Aiano/DigitalPowerSupply/README.md

# 便携数控开关电源 Digital Power Supply

## 特点

- 支持PD诱骗
- 支持输出升降压
- 触屏GUI界面

## 文件结构

### 显示部分测试

- `/Hardware/Display`：PCB工程
- `/Firmware/Display`：STM32代码
