Aiano/DigitalPowerSupply/Firmware/DigitalBuckBoost/README.md

# DigitalBuckBoost代码文档

## 文件结构

- MDK-ARM：Keil项目文件
- Drivers：HAL库和CMSIS驱动
- Core：STM32CubeMX生成的底层代码
- Application：业务逻辑代码
- BSP：板级支持包
