Aiano/DigitalPowerSupply/Document/便携数控可调开关电源-开发记录.md

# 便携数控可调开关电源-开发记录

## 电源

> [低压非隔离DCDC开关稳压器设计 - Part 1 原理图设计 - Emoe-Studio](https://www.emoe.xyz/non-isolated-dc-dc-power-regulator-schematic-design/)

### 参数指标

| 项目 | 指标 |
| --- | --- |
| 输入参数 | 12~24V(DC), 5A, 100W(Max) |
| 输出参数 | 12~24V(DC), 5A, 100W(Max) |
| 负载调整率 | ≤0.05% |
| 电源调整率 | ≤0.05% |
| 纹波和噪声 | ≤2mVrms, 10mVpp |
| 满载效率 | ≥97% |
| 开关频率 | 200kHz~1MHz |
| 工作温度 | 0~100℃ |
| 输入接口 | USB Type-C |
| 支持协议 | PD3.0 |
| 输入保护 | 反接保护、欠压保护 |
| 输出保护 | 过压保护、过流保护、过功率保护、过温保护、倒灌保护 |

### 开关电源拓扑选择

> [电源拓扑选择 | TI.com.cn](https://www.ti.com.cn/zh-cn/video/series/power-topology-selection.html)

基本分类：

- 非隔离/隔离 (Non Isolated/Isolated)：输入和输出是否共地
- 正激/反激 (Forward/Flyback)：能量传输到输出时开关状态

其中，非隔离SMPS有：

- 降压：Buck
- 升压：Boost
- 升降压：
    - BuckBoost
    - 4SW BuckBoost
    - SEPIC (Single-Ended Primary-Inductor Converter)
    - Zeta
- 负压：
    - Inverting BuckBoost
    - Cuk

考虑到DC/DC无需使用隔离拓扑，需要升降压，输出功率较大，故选择四开关BuckBoost拓扑，考虑到四开关BuckBoost可以做双向，故选之。

### 系统框图

系统框图

### 器件选型

#### MCU

STM32G474RET6

- 大量模拟外设
- 高主频
- HRTIM

#### N-MOSFET

对于Buck Boost拓扑，分别计算其工作于**Buck模式**和**Boost模式**所需的参数，然后取最大值。

> 对于所有拓扑，当输出电压和负载电流（即输出功率）不变时，如果输入电压减小，平均输入电流必然增加，所以，**所有拓扑的开关管有效值电流，在$V_{INMIN}$（即$D_{MAX}$）处最大**
>
> 下式对于**所有拓扑**成立
> $$
> I_{RMS\_SW}=I_{L\_DMAX}\times\sqrt{D_{MAX}\times(1+\frac{{r_{DMAX}}^2}{12})}
> $$

##### Buck模式

这里限制占空比最大为0.95（为了给上管栅驱的自举电容充电）
$$
D_{MAX}=\frac{V_O}{V_{IN}}=0.95\\
t_{ON\_DMAX}=\frac{D_{MAX}}{f}=\frac{0.95}{200\times 10^3}=4.75\mu s
$$
取输入电压达到最大值24V，即最恶劣输入电压
$$
\begin{align}
V_{ON\_DMAX}&=V_{IN}-V_{O}\\
&=(1-D_{MAX})\times V_{IN\_MAX}\\
&=0.05\times 24=1.2V
\end{align}
$$
电流纹波率需要重新计算
$$
r_{DMAX}=\frac{Et_{DMAX}}{L\times I_O}=\frac{4.75\times 1.2}{22\times 5}=0.052\\
I_{RMS\_SW}=I_{L\_DMAX}\times\sqrt{D_{MAX}\times(1+\frac{{r_{DMAX}}^2}{12})}=5\times\sqrt{0.95\times(1+\frac{{0.052}^2}{12})}=4.87A
$$
最高开关电压
$$
V_{SWMAX}=V_{INMAX}=24V
$$

##### Boost模式

$$
\frac{V_O}{V_{IN}}=\frac{1}{1-D}
$$

当$V_O=24V$、$V_{IN}=12V$时，占空比最大
$$
DMAX=\frac{V_O-V_{IN}}{V_O}=\frac{24-12}{24}=0.5\\
I_{L\_DMAX}=\frac{I_O}{1-D_{MAX}}=\frac{5}{1-0.5}=10A
$$
电流纹波率为设定值
$$
r_{DMAX}=0.4\\
I_{RMS\_SW}=I_{L\_DMAX}\times\sqrt{D_{MAX}\times(1+\frac{{r_{DMAX}}^2}{12})}=10\times\sqrt{0.5\times(1+\frac{{0.4}^2}{12})}=7.12A
$$
最高开关电压
$$
V_{SWMAX}=V_O=24V
$$

##### 最终参数

故开关管最大有效值电流$I_{RMS\_SW}=7.12A$，额定电流应大于两倍有效值电流，$I>14.24A$

最高开关电压$V_{SWMAX}=24V$，需要降额20%，则额定电压$V>24\times(1+0.2)=28.8V$

##### 备选型号

- ==CJAC110SN10A==
- ==CJAC130SN04L==
- NCEP3065QU

#### 功率电感

对于Buck Boost拓扑，分别计算其工作于**Buck模式**和**Boost模式**所需的参数，然后取最大值。

> **最恶劣工况**定义为峰值电流达到最大值时所对应的工况

##### Buck模式

Buck模式的最恶劣工况是输入电压最大，输出电压最小，此时占空比最小。

$$
\frac{V_{O}}{V_{IN}}=D=\frac{12}{24}=0.5\\
I_{DC}=I_O=5\text{A}
$$

设置电流纹波率 $r=0.4$
$$
I_{PK}=I_{DC}(1+\frac{r}{2})=5\times(1+\frac{0.4}{2})=6\text{A}\\
L=\frac{V_{ON}\times D}{r\times I_L\times f}=\frac{(24-12)\times 0.5}{0.4\times 5\times 200\times 10^3}=15\mu\text{H}
$$

##### Boost模式

Boost模式的最恶劣工况是输入电压最小，输出电压最大，此时占空比最大。
$$
\frac{V_{O}}{V_{IN}}=\frac{1}{1-D}\\
D=\frac{V_{O}-V_{IN}}{V_{O}}=\frac{24-12}{24}=0.5\\
I_{DC}=\frac{I_O}{1-D}=\frac{5}{1-0.5}=10\text{A}
$$
设置电流纹波率 $r=0.4$

$$
I_{PK}=I_{DC}(1+\frac{r}{2})=10\times(1+\frac{0.4}{2})=12\text{A}\\
L=\frac{V_{ON}\times D}{r\times I_L\times f}=\frac{12\times 0.5}{0.4\times 10\times 200\times 10^3}=7.5\mu\text{H}
$$

##### 最终参数

峰值电流最大值$I_{PK}=12\text{A}$，饱和电流$I_{SAT}\ge12\text{A}$

电感值最大值$L=15\mu\text{H}$，需要考虑$\pm10\%$容限，最终电感值$L\ge15\times(1+0.1)=16.5\mu\text{H}$

> [SER2918H-223 | High current flat wire | Coilcraft](https://www.coilcraft.com/zh-cn/products/power/shielded-inductors/high-current-flat-wire/ser/ser29xx/ser2918h-223/)

SER2918H-223

- Inductance: 22uH
- DCR: 2.60 mOhm
- SRF: 15MHz
- Isat(10% drop): 12A
- Irms(20℃ rise): 20A

#### 输入输出电容

##### Buck模式

取占空比最小的情况，$V_{IN}=24V$，$V_{O}=12V$
$$
C_{MIN}=\frac{V_O\times(1-D)}{8\times L\times\Delta V_O\times f^2}=\frac{12\times(1-0.5)}{8\times 22\mu\times 10m\times (200k)^2}=85\mu F
$$

##### Boost模式

取占空比最大的情况，$V_{IN}=12V$，$V_{O}=24V$
$$
C_{MIN}=\frac{I_O\times(1-\frac{V_{IN}}{V_O})}{\Delta V_O\times f}=\frac{5\times(1-\frac{12}{24})}{10m\times 200k}=1250\mu F
$$

##### 最终参数

电容大于1250uF

额定电压$V>V_O\times(1+50\%)=36V$

选取一颗50V，2200uF高频电解电容电容，搭配10uF和100nF MLCC电容

#### 精密电流采样电阻

1mΩ 3W 2512

#### 电压电流放大器

##### 电流检测放大器

INA190A4	200V/V

##### 电压差分放大器

> [运放的差分放大电路_运放差分放大电路-CSDN博客](https://blog.csdn.net/IT18150131975/article/details/86534431)



若满足$R_1=R_3$、$R_2=R_4$，则
$$
V_O=\frac{R_2}{R_1}(V_+-V_-)
$$
采用通用运放和高精度电阻搭建电压差分放大器

- ==TLV9001==
- LM321
- TLV9301
- OPA171

##### 直流偏置

高精度电阻分压加电压跟随器

- TLV9001

#### 栅极驱动器

低压半桥栅极驱动器主要关注

- 工作电压：限制了最大输入输出电压
- 拉&灌电流：这个值越大，栅极电阻$R_g$就可以减小，MOSFET开关速度提高，$\frac{1}{2}V_{DS}I_D$损耗下降，故越大越好

##### 备选型号

- ==UCC27211A==
- SLM27211
- IRS21867
- SLM21867

### 外围阻容&连线

### 热管理

### 环路稳定性

### 额外滤波器

### 问题

#### V1.0

1. 电流采样电阻的GND端没有隔开网络，导致差分线回到INA190A4时，过孔取了就近的GND电压，差分变单端，电流采样不准。

2. 电解电容容值可能太大，需要后续做仿真测试，验证环路稳定性问题。

3. 每一个测试环都需要在近处放一个配对的GND测试环，减小耦合噪声的影响。

4. 负载电流增大到8~10A时，输入输出电压差分采样运放输出引脚，会在采样时刻产生较大纹波，需要在单端后加RC滤波，奇怪的是，啥时候采样啥时候产生这个纹波，负载电流越大，这个纹波越大

   Vin_sense0

   后续关闭ADC电流采样通道，这个波形消失，只剩下一个小尖峰，并且不会随着负载电流变化，可以通过串联RC滤波消除。推测之前的问题是由于ADC不同通道间的串扰导致的，可以在通道间插入直通到GND的通道解决。

   Vin_sense1

5. 10uF MLCC要尽量靠近半桥，防止电压尖峰烧毁MOS

## 显示

### 屏幕

> 淘宝：
>
> [FFC/FPC连接器1.0/0.5MM抽屉翻盖式上下接插座4/6/8/10/12/30~40P-tmall.com天猫](https://detail.tmall.com/item.htm?id=626563665786&spm=a1z0d.6639537/tb2.1997196601.4.b3a574846tapTS)
>
> [2.8寸TFT LCD 240X320高清液晶显示屏彩色lcd ili934触摸ST7789-淘宝网 (taobao.com)](https://item.taobao.com/item.htm?id=610189235154&spm=a1z0d.6639537/tb2.1997196601.239.b3a574846tapTS)

#### FPC排线

FPC（Flexible Printed Circuit Board）柔性印刷电路板，用于连接LCD显示屏与PCB。

FPC通常有两种：

- 焊接式：直接焊接到PCB母板
- 插接式：PCB母板上有对应的座子

为了组装方便和节约成本（重复使用一块屏幕），我选择插接式FPC。

#### FPC插座

FPC插座的选择包括几个部分：

1. 间距选择：FPC座子有多种间距，常见的有0.5mm、1.0mm的座子，间距指引脚中间与相邻引脚中间的距离。

    间距确定后就可以计算FPC线宽，线宽计算公式为：
    $$
    线宽=(\text{P}数+1)\times间距
    $$
    比如10Pin，0.5mm间距的线宽是(10+1)*0.5=5.5mm

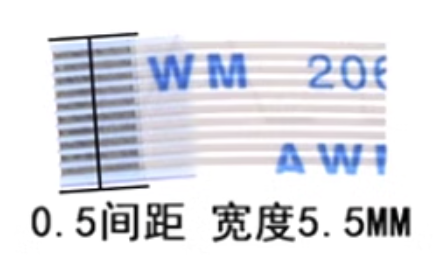
[picture p1: Document/便携数控可调开关电源-开发记录/image-20240505154628156.png]
    

2. 样式选择：常见的样式有：

    - 翻盖下接：引脚触点向下
    - 抽拉上接：引脚触点向上
    - 抽拉下接：引脚触点向下
    - 前插后翻盖：引脚触点上下都可以接触

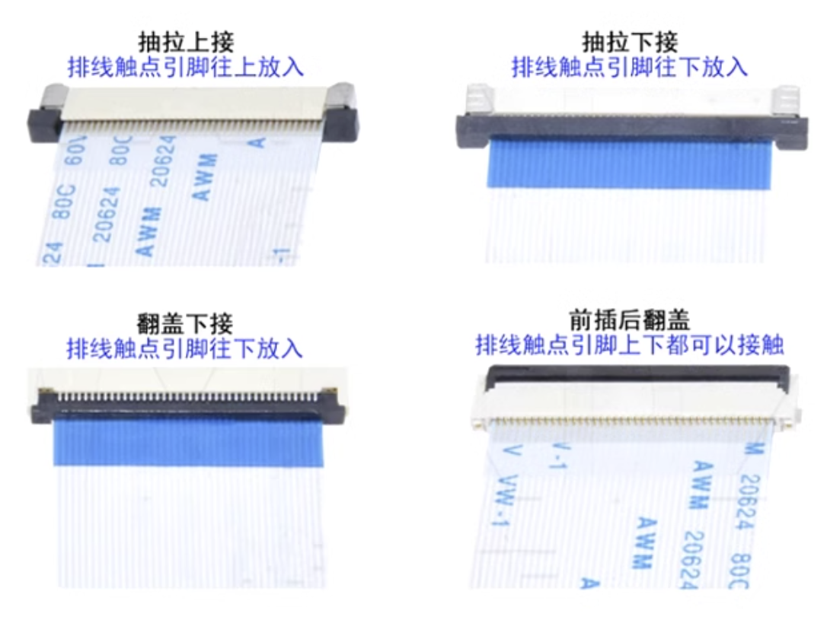
[picture p2: Document/便携数控可调开关电源-开发记录/image-20240505154914849.png]
    

0.5mm间距的FPC插座封装图如下：

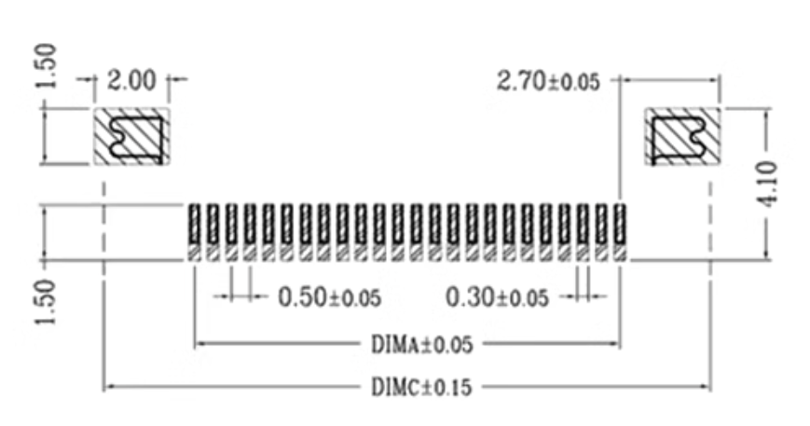
[picture p3: Document/便携数控可调开关电源-开发记录/image-20240505155202674.png]


#### 串口or并口

串口LCD采用4线SPI接口

并口LCD采用MCU-LCD接口（Intel-8080接口），可以用STM32的FSMC外设驱动

因为STM32G474RET6引脚不够多，没有FSMC，故只能用串口屏

### 晶振

外部高速晶振：在能配出最高主频的情况下，外部晶振频率越高越好，原因是频率越高相位噪声越小。

故使用24MHz 3225无源晶振。

#### 负载电容

> [晶体（crystal、无源晶振）两端电容取值计算_晶体电容计算-CSDN博客](https://blog.csdn.net/Naisu_kun/article/details/86644845)

负载电容是指电路中跨接晶振两端的总的外界有效电容，晶振的数据手册一般给出负载电容

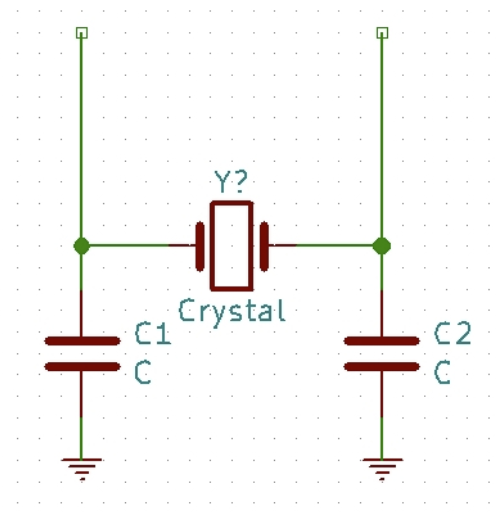
[picture p4: Document/便携数控可调开关电源-开发记录/image-20240513203107083.png]


负载电容的计算公式：
$$
C_L=\frac{C_1C_2}{C_1+C_2}+C_S
$$
其中，$C_1$、$C_2$是晶振的匹配电容（如图），一般$C_1=C_2$；$C_S$是PCB的寄生电容，一般取3~5pF。

公式可以简化为：
$$
C_L=\frac{C_1}{2}+C_S
$$
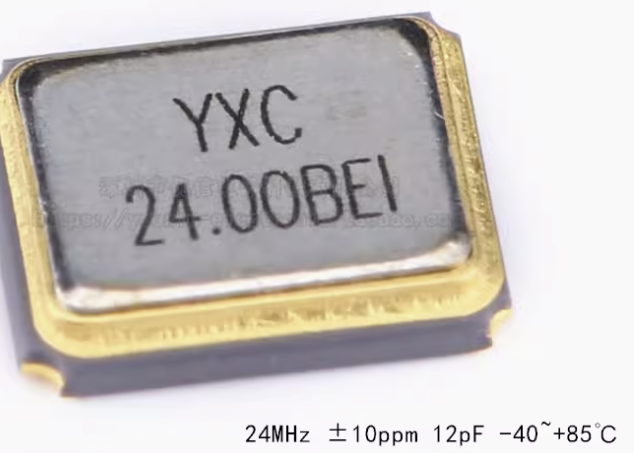
[picture p5: Document/便携数控可调开关电源-开发记录/image-20240513204848822.png]


商品标的是12pF的负载电容，代入公式，取$C_S=3\sim5\text{pF}$，可得$C_1=14\sim18\text{pF}$，考虑贴片电容的误差，这里取15pF。

### BOOT

> [【经验分享】STM32G0系列的启动配置与程序下载 - STM32团队 ST意法半导体中文论坛 (stmicroelectronics.cn)](https://shequ.stmicroelectronics.cn/thread-631484-1-1.html)
>
> [【经验分享】STM32G0和STM32G4 如何把BOOT0当作通用GPIO使用 - STM32团队 ST意法半导体中文论坛 (stmicroelectronics.cn)](https://shequ.stmicroelectronics.cn/thread-631814-1-1.html)

STM32G4系列单片机为了节约引脚，取消了BOOT1引脚，只保留了BOOT0引脚，同时可以通过操作nBOOT0、nBOOT1、nSWBOOT0寄存器软件设置启动模式，节约BOOT0引脚。

**有三种启动模式：**

- Main Flash memory：主闪存，运行用户程序从这里启动；
- System memory：系统存储区，DFU（Device Firmware Upgrade）模式从这里启动；
- Embedded SRAM1：嵌入式内存，一般不用这个模式，用于调试。

**模式配置：**

- 当BOOT_LOCK=1时，从Main Flash memory启动
- 根据nSWBOOT0选择BOOT0从引脚还是寄存器取值，如果为1，从BOOT0引脚，如果为0从nBOOT0寄存器；BOOT1只从nBOOT1寄存器取值

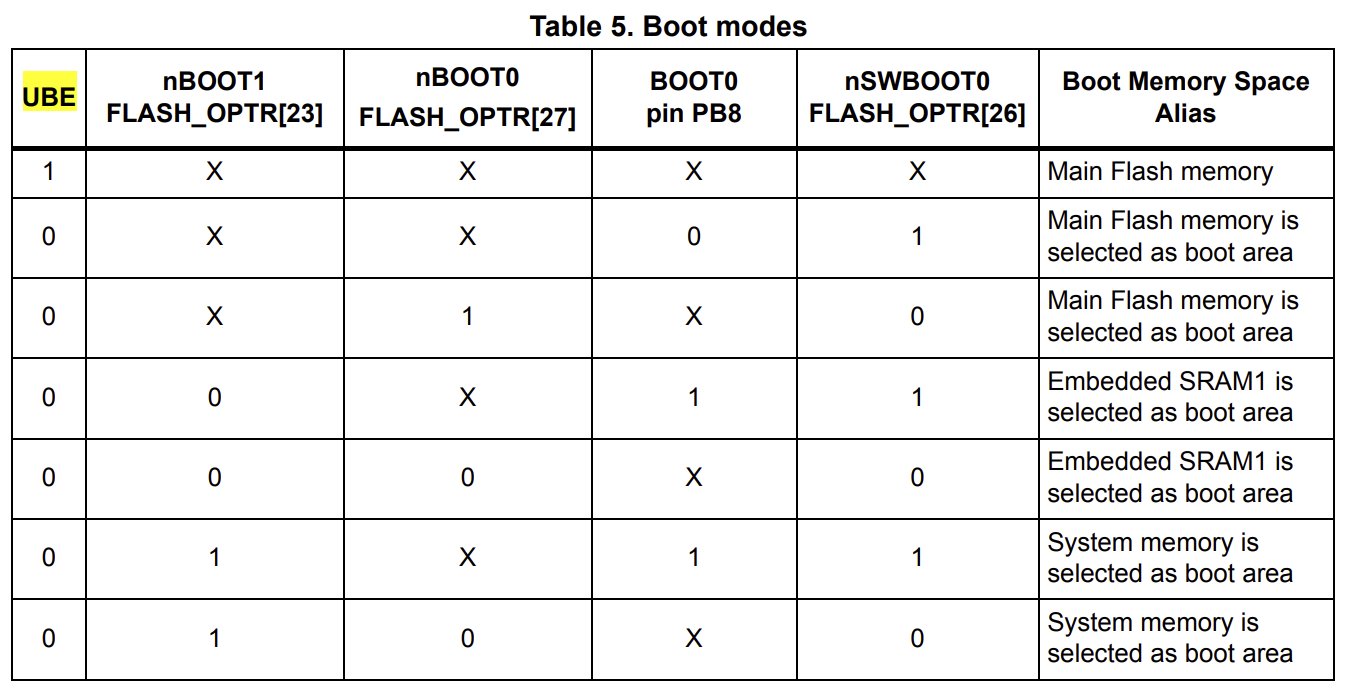
[picture p6: Document/便携数控可调开关电源-开发记录/image-20240513234230536.png]


**默认的寄存器值：**

| 寄存器名  | 默认值 |
| --- | --- |
| BOOT_LOCK | 0 |
| nSWBOOT0  | 0 |
| nBOOT0 | 1 |
| nBOOT1 | 1 |

也就是说，默认会从Main Flash memory启动。

芯片出厂时会从System memory启动，烧录程序后从Main Flash memory启动，直到修改寄存器值。

**Option Bit的修改方式：**

- 通过HAL库软件修改

- 通过STM32CubeProgrammer修改，只能使用ST-Link

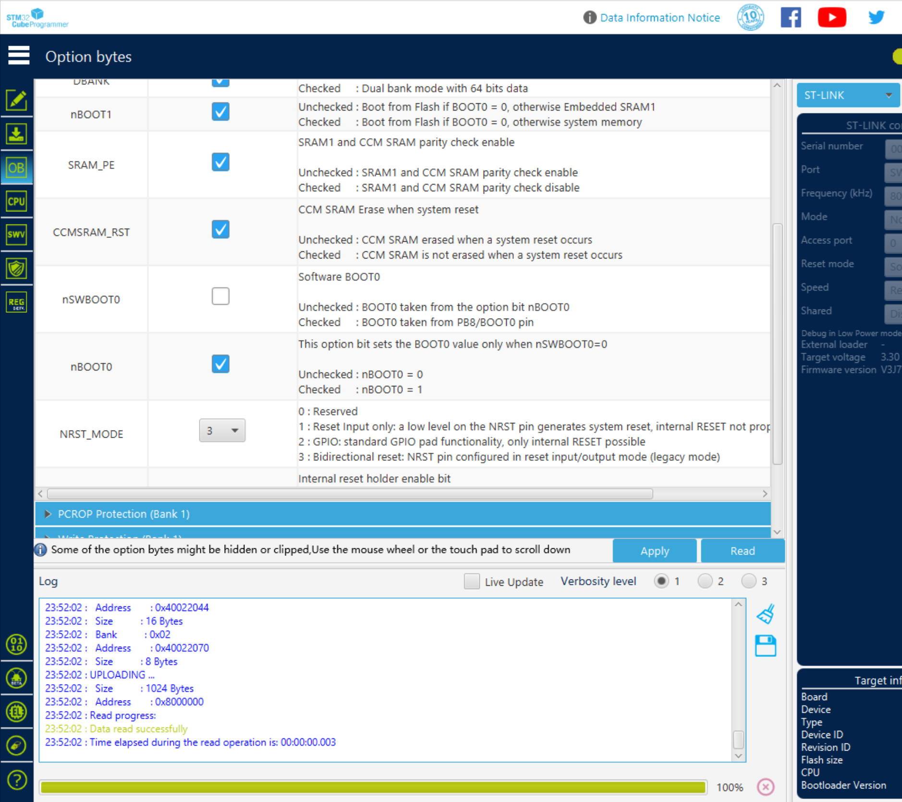
[picture p7: Document/便携数控可调开关电源-开发记录/image-20240513235526597.png]
    

- 通过STLink Utility修改

#### 如果SWD接口被关闭了怎么办？

> **根据AN5093：**
>
> After reset (SYSRESETn or PORESETn), the pins used for the SWD are assigned as  dedicated pins which are immediately usable by the debugger host.
>
> RESET后，SWD接口会立即可用，直到SWD被软件关掉。
>
> [【经验分享】STM32G0系列的启动配置与程序下载 - STM32团队 ST意法半导体中文论坛 (stmicroelectronics.cn)](https://shequ.stmicroelectronics.cn/thread-631484-1-1.html)
>
> 如果更严重点，程序中把ST-LINK连接需要的 SWDIO 和 SWCLK 引脚用作它用了，ST-LINK也连接不上怎么办？解决方法也有，断开这两个引脚上别的电路连接，然后将芯片的 NRST 引脚保持下拉，这时候 STM32CubeProgrammer 上选择ST-LINK点击Connect，然后断开 NRST 的下拉，芯片会在启动的一瞬间被ST-LINK连接上。

### 板载ST-Link V2-1

> [自制ST-LINK V2-1（开源版本） - 嘉立创EDA开源硬件平台 (oshwhub.com)](https://oshwhub.com/CYIIOT/ST_LINK-V2_1)
>
> [Rebuild My own STLink V3.0 – 了起的博 (dalaotech.com)](https://dalaotech.com/2021/08/26/1107/)
>
> [[开源\]自制STLink V2.1 – 了起的博 (dalaotech.com)](https://dalaotech.com/2020/03/31/784/)

### UCPD

> [STM32StepByStep:Getting started with USB-Power Delivery Sink - stm32mcu (stmicroelectronics.cn)](https://wiki.stmicroelectronics.cn/stm32mcu/wiki/STM32StepByStep:Getting_started_with_USB-Power_Delivery_Sink)

两种方案：

1. VBUS供电Sink

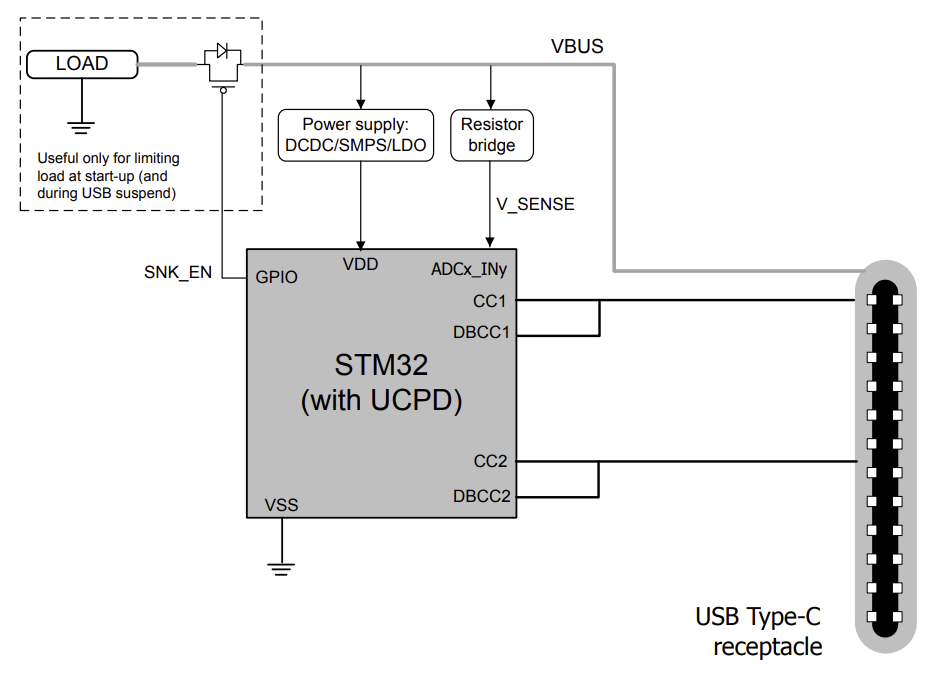
[picture p8: Document/便携数控可调开关电源-开发记录/image-20240514154835638.png]
VBUS供电Sink
    

2. 分别供电Sink

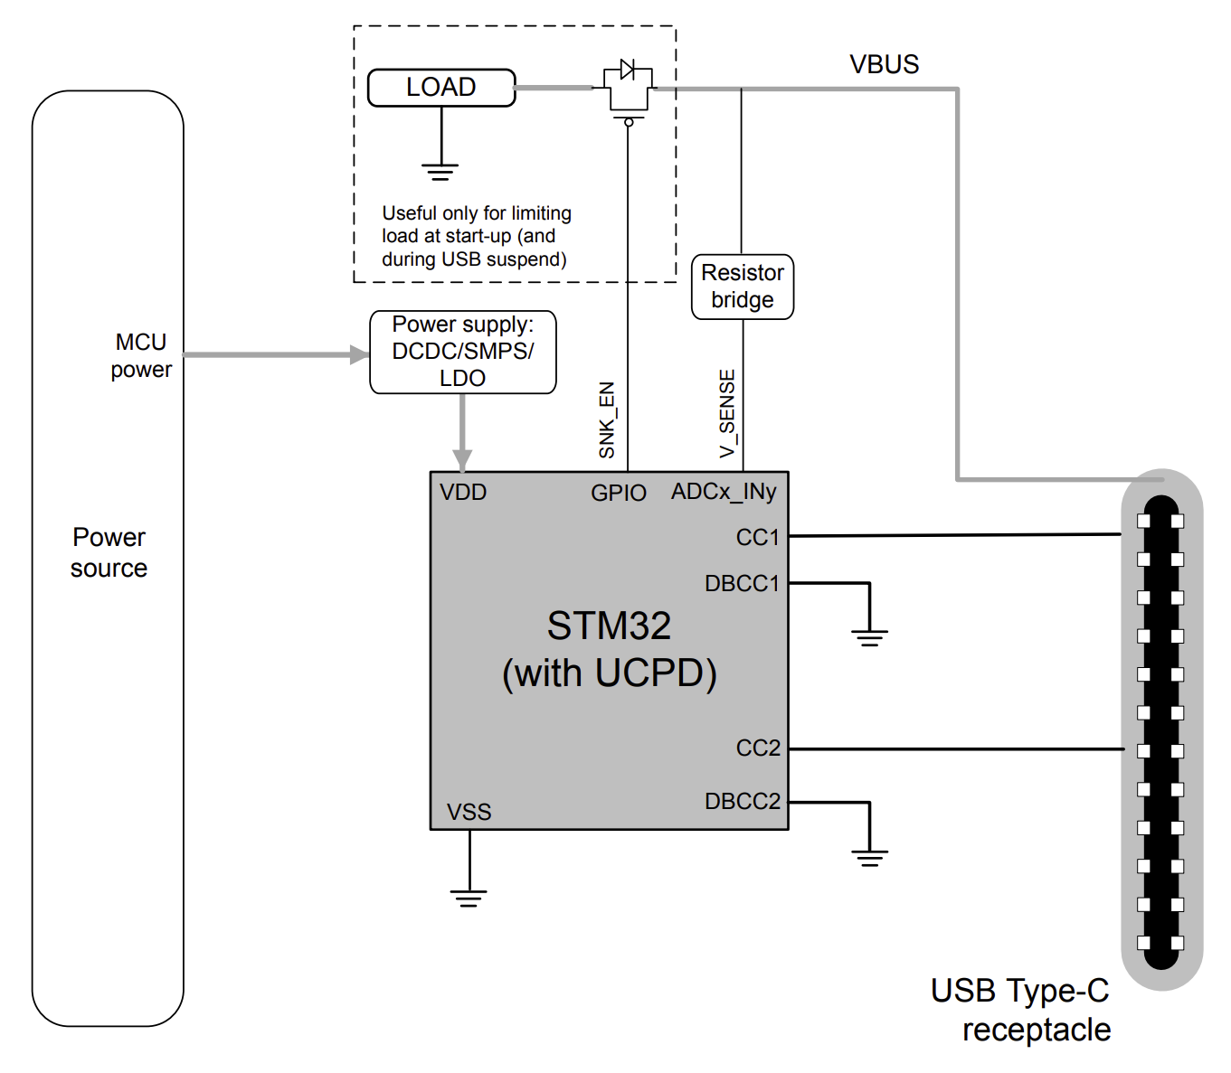
[picture p9: Document/便携数控可调开关电源-开发记录/image-20240514155012469.png]
    

#### Dead Battery Support

### USB差分线

> [如何进行差分对走线（以KiCad中对USB布线为例）-电子工程专辑 (eet-china.com)](https://www.eet-china.com/mp/a69268.html)
>
> [PCB layout之USB差分走线布线经验教训 - 百度文库 (baidu.com)](https://wenku.baidu.com/view/c25a656a182e453610661ed9ad51f01dc2815794.html?_wkts_=1715932724428)

USB差分线参数：

- 差分阻抗90Ω±15%
- 每条线单端阻抗45Ω±15%
- 数据线总长度差不大于0.150英寸（3.81mm）
- 差分线尽可能在完整地平面上布线
- 避免90°直角
- 避免出现天线

USB差分线阻抗是90Ω，使用嘉立创阻抗计算：

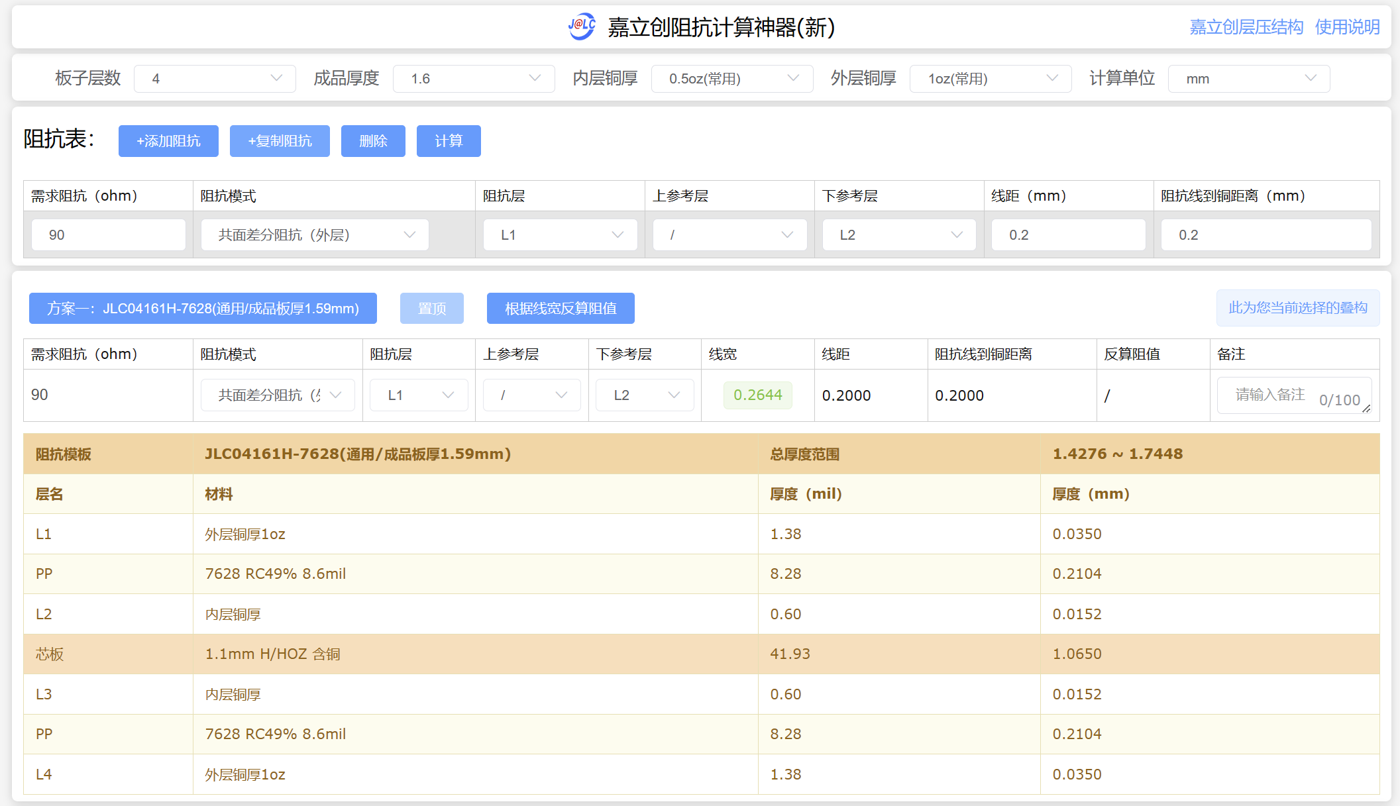
[picture p10: Document/便携数控可调开关电源-开发记录/image-20240517155613842.png]


计算结果：

- 线距0.2mm
- 线到铜距0.2mm
- 线宽0.2644mm

差分线布线要点：

- 差分线优先布线，尽量缩短差分线走线距离

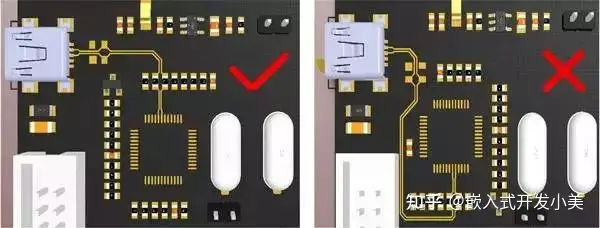
[picture p11: Document/便携数控可调开关电源-开发记录/v2-0b62eb7ec0fa411283dcbfdb77022814_1440w.webp]
    

- 优先绘制差分线，尽量不要超过两对过孔，且需要对称放置

    

- 对称平行走线，避免90°走线，采用45°或弧形走线

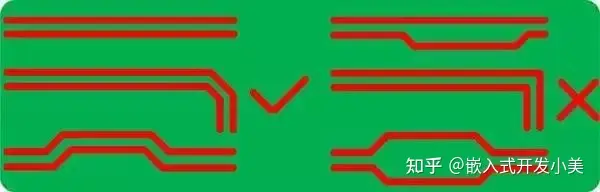
[picture p12: Document/便携数控可调开关电源-开发记录/v2-5d4cd0325ce7df02c9a77bc39ebb7023_1440w.webp]
    

- 差分串接电容、测试点、上下拉电阻的摆放方式

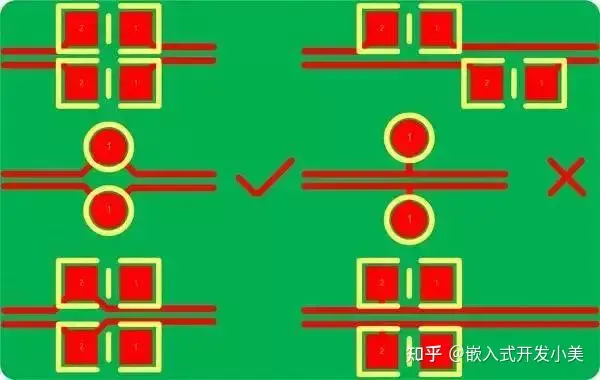
[picture p13: Document/便携数控可调开关电源-开发记录/v2-a1253f28d47503fef0e9312af78caeec_1440w.webp]
    

- 差分线等长

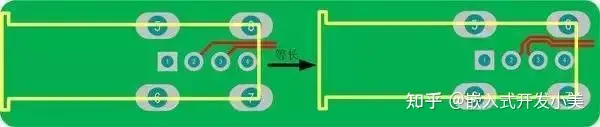
[picture p14: Document/便携数控可调开关电源-开发记录/v2-d60fac06500e576c45bcea9e4e67f9fd_1440w.webp]
    

- 其他信号线距离至少20mil或遵循3W原则

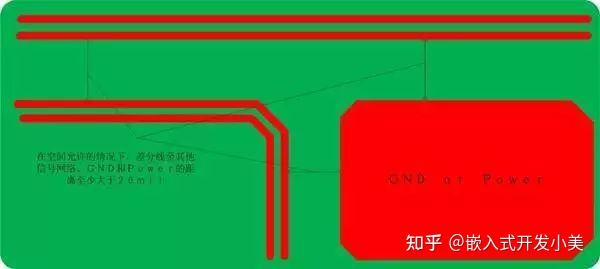
[picture p15: Document/便携数控可调开关电源-开发记录/v2-d6cab8a07928652ee08655c7945b9c99_r.jpg]
    

### GUI

> LVGL移植：
>
> [【快速入门 LVGL】-- 1、STM32 工程移植 LVGL_stm32 移值lvgl-CSDN博客](https://blog.csdn.net/qq_49053936/article/details/136696700)
>
> LVGL中文手册：
>
> [欢迎阅读LVGL(v9.0)中文开发手册！ — LVGL 文档 (100ask.net)](https://lvgl.100ask.net/master/index.html)
>
> LVGL手册：
>
> [Introduction — LVGL documentation](https://docs.lvgl.io/master/intro/index.html)
>
> LVGL V8.3 Examples:
>
> [Examples — LVGL documentation](https://docs.lvgl.io/8.3/examples.html)

#### 堆&栈

> [STM32 堆栈详解-CSDN博客](https://blog.csdn.net/eillwill/article/details/109185845)
>
> [STM32 内存分配解析及变量的存储位置 - wenzid - 博客园 (cnblogs.com)](https://www.cnblogs.com/wenziw5/p/12801667.html)

MDK-ARM编译后提示信息中，Size部分提示的含义：

- Code：代码，存在Flash
- RO-data(Read Only)：只读数据，例如常量，存在Flash
- RW-data(Read Write)：可读可写数据，例如已初始化的变量，存在Flash，运行时在RAM
- ZI-data(Zero Initialize)：没有初始化的变量，编译器初始化为0，运行时存在RAM

Total ROM Size = Code + RO-data + RW-data

Total RAM Size = RW-data + ZI-data

MCU上电时会先将RW-data从ROM中搬到RAM中，然后将ZI-data的RAM区域全部清零

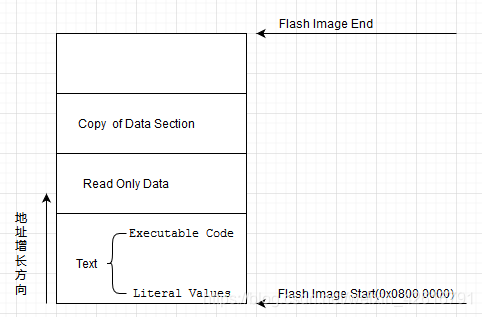
[picture p16: Document/便携数控可调开关电源-开发记录/watermark,type_ZmFuZ3poZW5naGVpdGk,shadow_10,text_aHR0cHM6Ly9ibG9nLmNzZG4ubmV0L3dlaXhpbl80MjYxNjc5MQ==,size_16,color_FFFFFF,t_70.png]


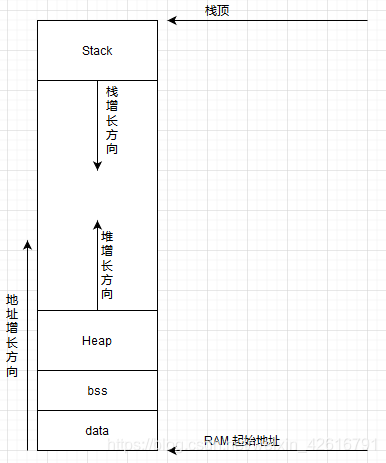
[picture p17: Document/便携数控可调开关电源-开发记录/watermark,type_ZmFuZ3poZW5naGVpdGk,shadow_10,text_aHR0cHM6Ly9ibG9nLmNzZG4ubmV0L3dlaXhpbl80MjYxNjc5MQ==,size_16,color_FFFFFF,t_70-1717657253065-3.png]


堆和栈都是存在RAM里的

- 栈（Stack）：由系统自动分配释放，存放局部变量和函数参数、返回地址
- 堆（Heap）：由程序员手动管理（malloc和free）
- bss段（Block Started by Symbol）：用来存放未初始化的全局变量和静态变量
- data段：存放已初始化全局变量和静态变量
- text段：存放可执行代码和只读常量（如字符串常量）

#### Debug单步调试前后乱跳

> [CubeIDE及Keil单步执行时来回乱跳的解决办法_keil的debug往回跳-CSDN博客](https://blog.csdn.net/wangpeng421/article/details/105970946)

原因：编译器优化，导致与C语句对应不上

解决方案：将优化调为Level 0 (-O 0)

#### LVGL不刷新，只显示颜色块

原因：`disp_flush()`编写错误，驱动提供的`ST7789_Fill()`只能填单色

解决方案：改用可以填多色的`ST7789_DrawImage`，但是会导致颜色不对，需要开启`LV_COLOR_16_SWAP`

### ST7789

#### 时钟极性和时钟相位

> [SPI中的CPHA,CPOL详解_spi cpha-CSDN博客](https://blog.csdn.net/win2000_li/article/details/100053217)

- CPOL(Clock Polarity, 时钟极性)
- CPHA(Clock Phase, 时钟相位)

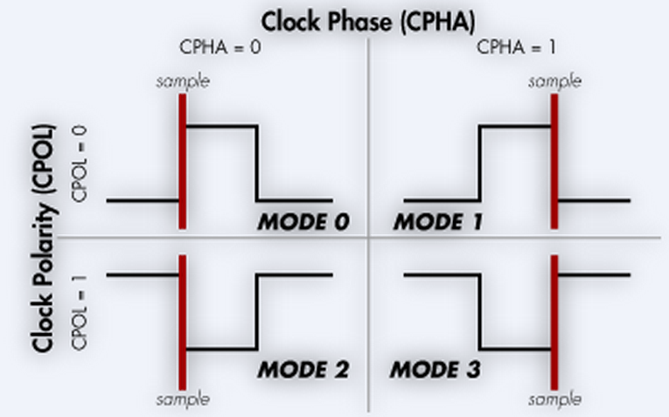
[picture p18: Document/便携数控可调开关电源-开发记录/aHR0cHM6Ly9pbWFnZXMwLmNuYmxvZ3MuY29tL2Jsb2cyMDE1LzI2ODE4Mi8yMDE1MDgvMjMxNDE2MDk5ODg2MTIzLmdpZg.gif]


### GT911

> [STM32系列-CubeIDE、CubeMX配置GT系列GT911触摸芯片教程（图文快速上手）_stm32cube+gt911-CSDN博客](https://blog.csdn.net/m0_62287330/article/details/136950346)

中景园的显示屏已经配置好，无需写入配置表，只需要在启动前做好复位即可。
