Aiano/DigitalPowerSupply/Hardware/Display/PowerAnalyzerByKeysight_Output/HTMLReport/Display [PDNA]_2024-07-20_12.52/Report.html

Power Analyzer Results Report for
Display

Power Analyzer Version: 1.0.14.200
Report Time / Date: 2024/7/20 12:51:30
Project Name: Display
Used Simulation Engine: Keysight

Power Analizer Global Settings

Parameter | Value
Metal conductivity | 1493.52 S/mil
Metal base conductivity | 1493.52 S/mil
Metal base temperature | 77°F
Metal work temperature | 77°F
Metal temperature coefficient | 0.4 %/F
Conductor Max Current Density for Surfase Layers | 0.064516 A/mil^2
Conductor Max Current Density for Internal Layers | 0.064516 A/mil^2
Via wall thickness | 0.7mil
Max Via Current Density | 0 A/mil^2
Skip ground | True

Design Stackup

# | Name | Material | Type | Thickness

| Top Overlay | | Overlay
| Top Solder | Solder Resist | Solder Mask | 0.4mil
1 | Top Layer | | Signal | 1.378mil
| Dielectric 2 | PP-023 | Prepreg | 8.284mil
2 | GND | CF-004 | Plane | 0.598mil
| Dielectric 1 | FR-4 | Isolation | 41.929mil
3 | POWER | CF-004 | Plane | 0.598mil
| Dielectric 3 | PP-023 | Prepreg | 8.284mil
4 | Bottom Layer | | Signal | 1.378mil
| Bottom Solder | Solder Resist | Solder Mask | 0.4mil
| Bottom Overlay | | Overlay

Heatmap For Current Density

Layer: Bottom Layer
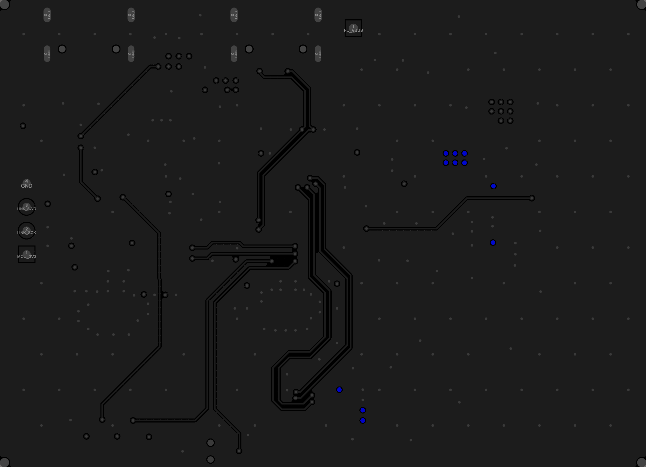
[picture p19: Hardware/Display/PowerAnalyzerByKeysight_Output/HTMLReport/Display [PDNA]_2024-07-20_12.52/Images/28baa386-0bed-4964-b619-e2a5e8a3118e.png]


Layer: POWER
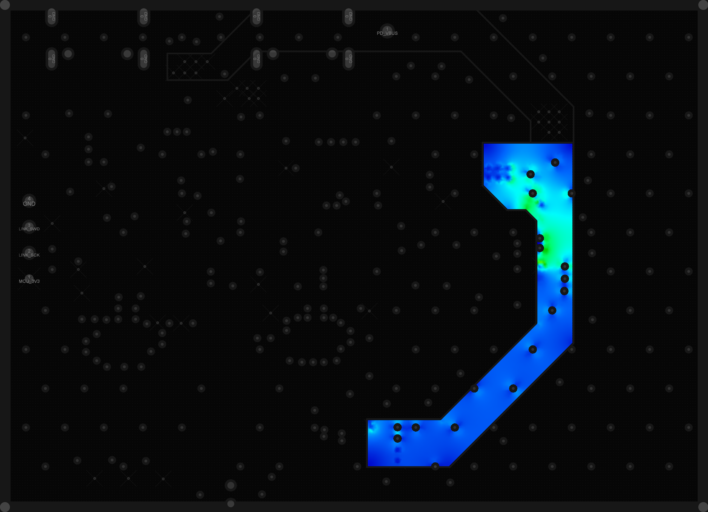
[picture p20: Hardware/Display/PowerAnalyzerByKeysight_Output/HTMLReport/Display [PDNA]_2024-07-20_12.52/Images/69576c85-04f0-4e50-8076-4920a4d79f14.png]


Layer: Top Layer
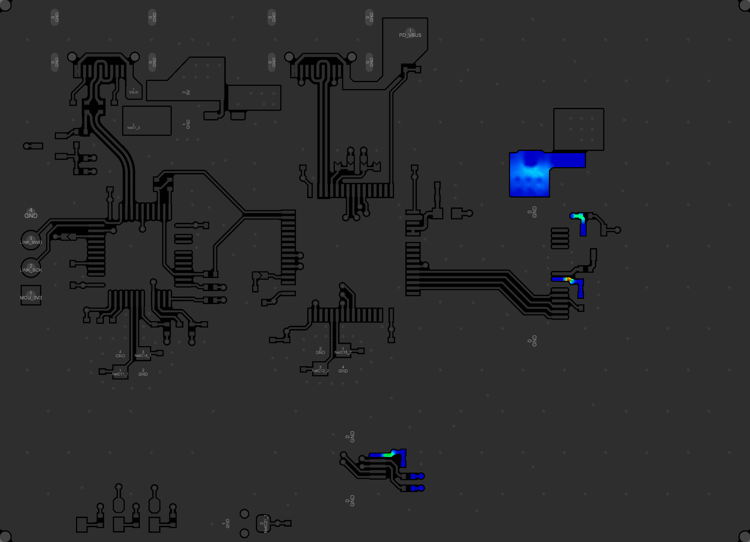
[picture p21: Hardware/Display/PowerAnalyzerByKeysight_Output/HTMLReport/Display [PDNA]_2024-07-20_12.52/Images/9c762727-8204-4b62-9185-a2396344016b.png]


Heatmap For Voltage Drop

Layer: Bottom Layer
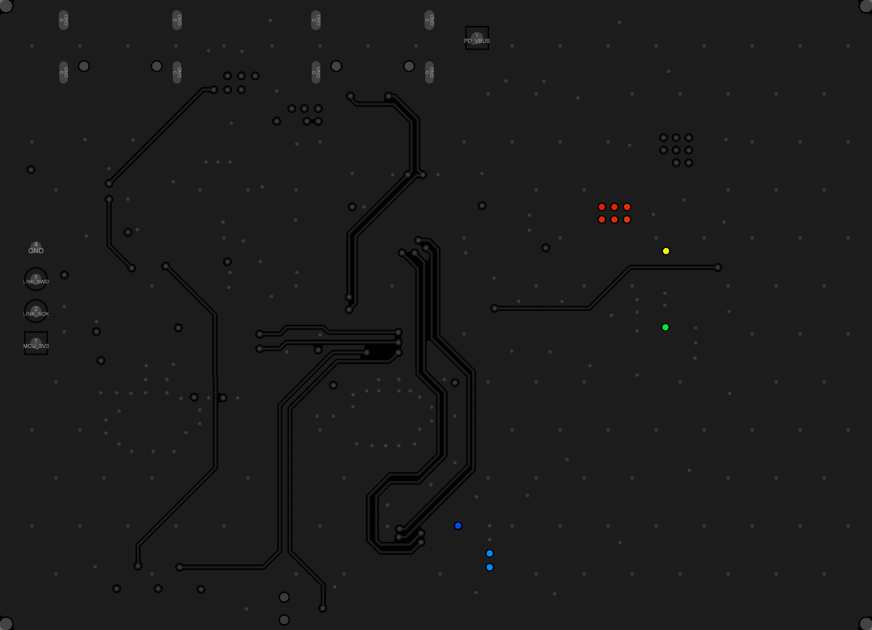
[picture p22: Hardware/Display/PowerAnalyzerByKeysight_Output/HTMLReport/Display [PDNA]_2024-07-20_12.52/Images/8413cedf-760a-408b-9524-4e1e8f3a611a.png]


Layer: POWER
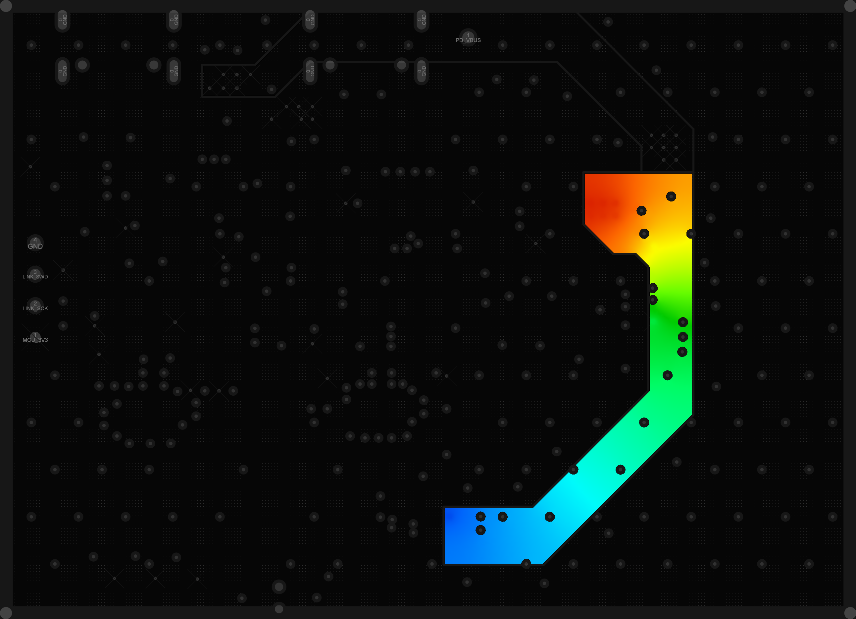
[picture p23: Hardware/Display/PowerAnalyzerByKeysight_Output/HTMLReport/Display [PDNA]_2024-07-20_12.52/Images/ba6369ec-481f-4b94-b167-3d788dbf233c.png]


Layer: Top Layer
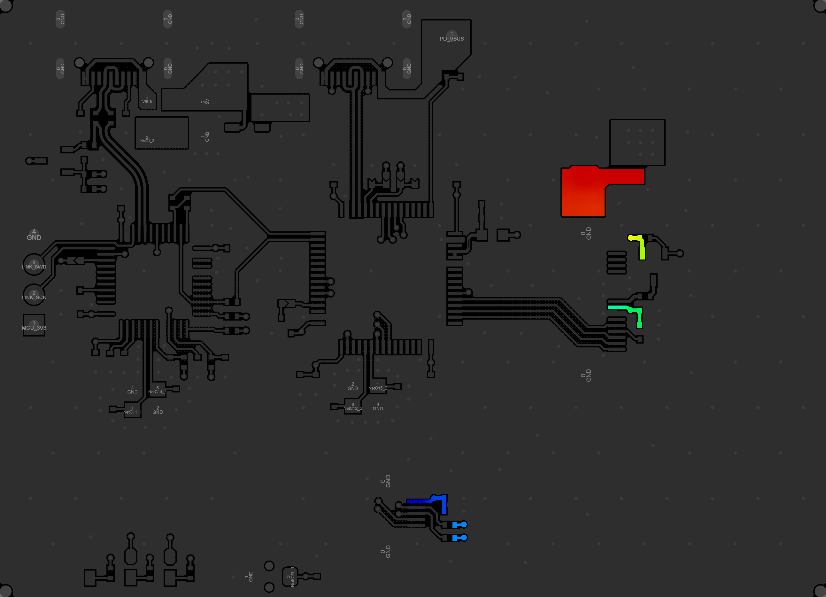
[picture p24: Hardware/Display/PowerAnalyzerByKeysight_Output/HTMLReport/Display [PDNA]_2024-07-20_12.52/Images/fd5f286f-8564-4b60-9dd0-9752aa1360ea.png]


System-Level Power Network Results

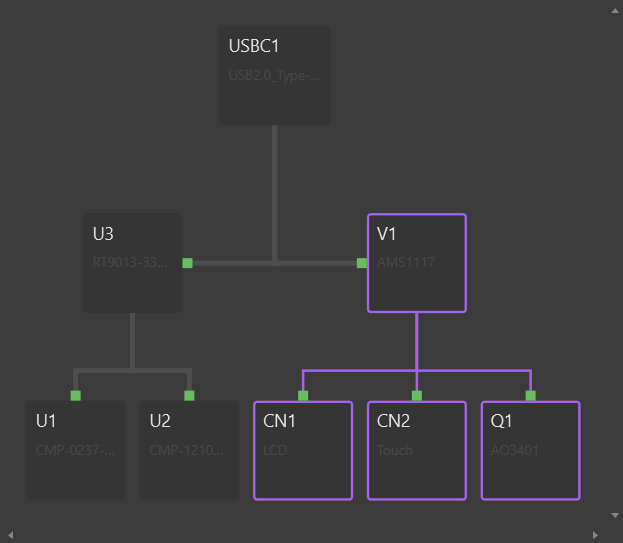
[picture p25: Hardware/Display/PowerAnalyzerByKeysight_Output/HTMLReport/Display [PDNA]_2024-07-20_12.52/Images/a410f97b-5472-4ed1-84a4-69b752aeeafc.png]


Network LCD_3V3 Details

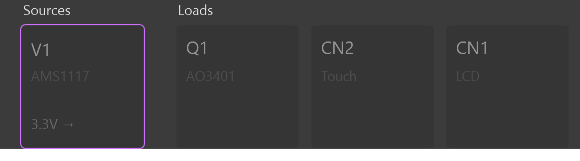
[picture p26: Hardware/Display/PowerAnalyzerByKeysight_Output/HTMLReport/Display [PDNA]_2024-07-20_12.52/Images/f0ac39f2-e378-4d45-a0ac-0f587c821c08.png]


Power Analysis Pass/Fail: Pass

Power Consumption for This Network: 0 Watts

Least Margins:

Margin Type | Absolute | Pass/Fail
Non-Via Current Density (A/mil^2) | 57.921m | Pass
Via Current (A) | 900m | Pass

Margin Type (%) | Percent | Pass/Fail
Non-Via Current Density | 89.78% | Pass
Via Current | 90.00% | Pass

Failed Via Summary:

Net | Location | Drill Diameter | Max Current (A) | Actual Current (A) | Margin (%) | Max Current Density | Actual Current Density | Margin (%)
LCD_3V3 | 1669.291mil : 311.024mil | 11.811mil | 1 | 4.4471m | 99.56% | 0 (A/mil^2) | 497.88u (A/mil^2) | ∞
LCD_3V3 | 1669.291mil : 354.331mil | 11.811mil | 1 | 5.7535m | 99.42% | 0 (A/mil^2) | 647.56u (A/mil^2) | ∞
LCD_3V3 | 1570.866mil : 440.945mil | 11.811mil | 1 | 50.003m | 95.00% | 0 (A/mil^2) | 17.341m (A/mil^2) | ∞
LCD_3V3 | 2218.504mil : 1061.024mil | 11.811mil | 1 | 100m | 90.00% | 0 (A/mil^2) | 34.956m (A/mil^2) | ∞
LCD_3V3 | 2220.472mil : 1299.213mil | 11.811mil | 1 | 50.003m | 95.00% | 0 (A/mil^2) | 18.33m (A/mil^2) | ∞
LCD_3V3 | 2098.425mil : 1437.008mil | 11.811mil | 1 | 53.418m | 94.66% | 0 (A/mil^2) | 18.846m (A/mil^2) | ∞
LCD_3V3 | 2098.425mil : 1397.638mil | 11.811mil | 1 | 48.947m | 95.11% | 0 (A/mil^2) | 17.715m (A/mil^2) | ∞
LCD_3V3 | 2059.055mil : 1437.008mil | 11.811mil | 1 | 31.376m | 96.86% | 0 (A/mil^2) | 10.861m (A/mil^2) | ∞
LCD_3V3 | 2059.055mil : 1397.638mil | 11.811mil | 1 | 24.951m | 97.50% | 0 (A/mil^2) | 9.2208m (A/mil^2) | ∞
LCD_3V3 | 2019.685mil : 1397.638mil | 11.811mil | 1 | 17.393m | 98.26% | 0 (A/mil^2) | 6.3533m (A/mil^2) | ∞
LCD_3V3 | 2019.685mil : 1437.008mil | 11.811mil | 1 | 23.925m | 97.61% | 0 (A/mil^2) | 8.1163m (A/mil^2) | ∞
