Aiano/DigitalPowerSupply/Document/便携数控可调开关电源-开发记录/Vin_sense1.jpg

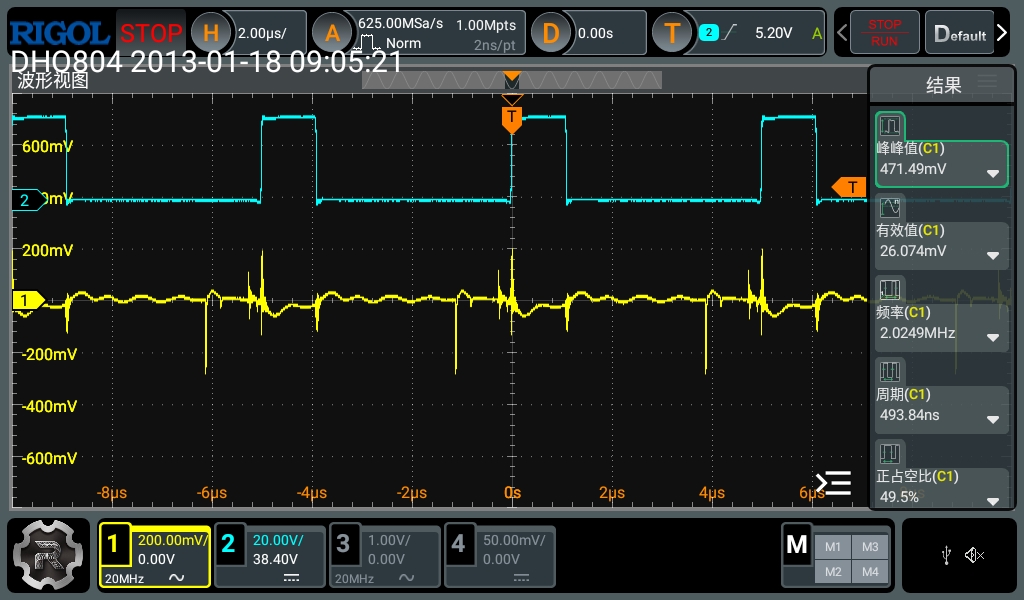
Document/便携数控可调开关电源-开发记录/Vin_sense1.jpg
