Aiano/DigitalPowerSupply/Document/系统框图.jpg

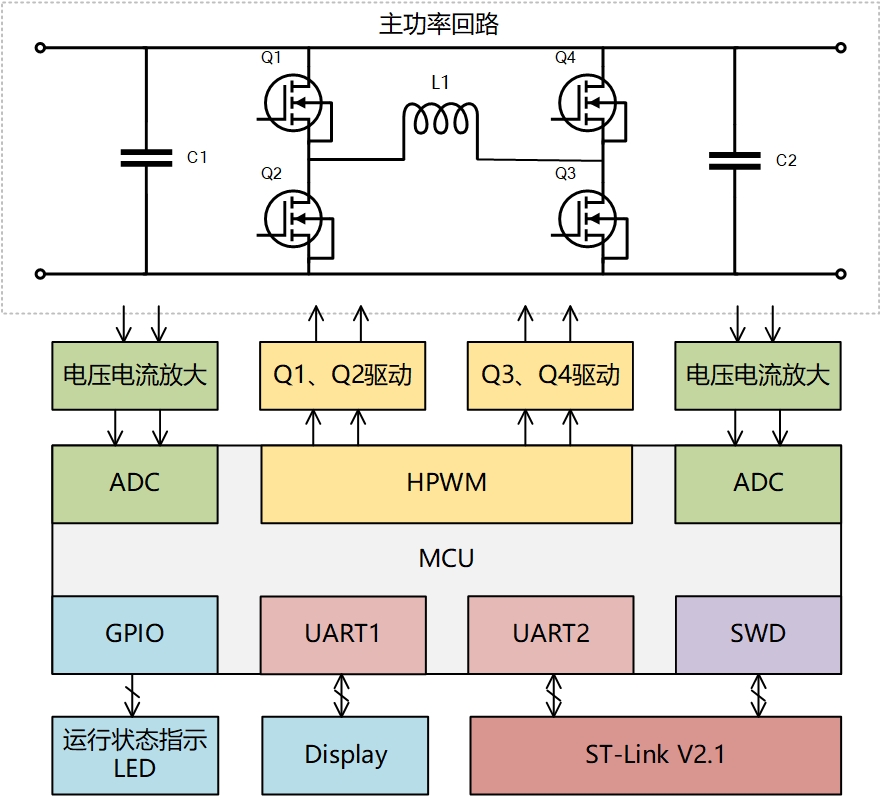
Document/系统框图.jpg
