Aiano/DigitalPowerSupply/Hardware/DigitalBuckBoost/BOM_V1.0.xlsx

Comment | Description | Designator | Footprint | LibRef | Quantity | Sourced | Placed
100nF/100V | 贴片电容 | C1, C4, C5, C6, C13, C34, C35, C36, C37, C38, C39 | C0402_L | C | 11 | y | y
10uF/100V | 贴片电容 | C2, C3, C14, C15 | C1206_L | C | 4 | y
10uF/25V | 贴片电容 | C7, C8 | C0603_L | C | 2 | y | y
1nF/100V | 贴片电容 | C9, C10, C11, C12 | C0402_L | C | 4 | y
TAJA105K016RNJ | CAP TANT 1UF 10% 16V 1206 | C16 | FP-TAJA-MFG | CMP-04424-000051-2 | 1 | y | y
22uF/25V | 贴片电容 | C17, C18 | C0805_L | C | 2 | y | y
2.7nF | 贴片电容 | C19 | C0402_L | C | 1 | y | y
10nF | 贴片电容 | C20 | C0402_L | C | 1 | y | y
1uF/10V/X7R | 贴片电容 | C21, C22 | C0402_L | C | 2 | y
10uF | 无极性贴片电容 | C23, C43 | C 0402_L | C | 2 | y | y
100nF | 无极性贴片电容 | C24, C25, C26, C27, C29, C33, C41, C44, C45, C46, C47 | C 0402_L | C | 11 | y
1uF | 无极性贴片电容 | C28, C30 | C 0402_L | C | 2 | y
15pF | 无极性贴片电容 | C31, C32 | C 0402_L | C | 2 | y | y
10pF | 无极性贴片电容 | C40, C42 | C 0402_L | C | 2 | y | y
2200uF/50V | 直插电解电容 | CE1, CE2 | CE-7.5*16*31.5 - GD | CE | 2 | y
4mm香蕉头母座 |  | CN1, CN2, CN3, CN4 | 4MM香蕉头母座 | 4mm香蕉头母座 | 4 | y
SS54 | 肖特基二极管 | D1, D2, D3, D4 | SMA | SS14 | 4 | y
B5819W | Schottky Barrier Rectifier, 1 A, 40 Vrm, -65 to 125 degC, 2-Pin SOD123, RoHS, Tape and Reel | D5 | MCC-SOD123_V | CMP-2100-03587-1 | 1 | y | y
SMFJ6.0CA | 贴片TVS瞬变抑制二极管 | D6 | SMFJ6.0CA | SMFJ6.0CA | 1 | y
HDR-1X4 | 4P接插件 | JP1 | HDR2.54-LI-4P | Header 4 | 1 | y | y
HDR-1X4 | 4P接插件 | JP2 | XH2.54-WI-4P | Header 4 | 1 | y
SER2918H-223 | 大电流扁平线电感 | L1 | SER2918H-223 | L | 1 | y
XAL5050-103MEC | Shielded Power Inductors 10uH 20% 4.9A 45mOhm | L2 | FP-XAL5050-MFG | CMP-11268-000215-1 | 1 | y | y
600R@100MHz | 小功率贴片电感 | L3 | L 0603 | L | 1 | y
绿色 | 贴片LED | LED1 | LED 0603G | LED-SMD | 1 | y | y
黄色 | 贴片LED | LED2 | LED 0603Y | LED-SMD | 1 | y | y
红色 | 贴片LED | LED3 | LED 0603R | LED-SMD | 1 | y | y
蓝色 | 贴片LED | LED4 | LED 0603B | LED-SMD | 1 | y | y
CJAC130SN04L | 130A 40V 2.0mΩ@10V N-Channel Power MOSFET | Q1, Q2, Q3, Q4 | PDFNWB5×6-8L | CJAC130SN04L | 4 | y | y
S9013 | 低频放大-NPN型 | Q5 | SOT23-3L | 9013-SMD | 1 | y | y
10k | 贴片电阻 | R1, R2, R3, R4, R5, R6, R13, R14, R15, R16, R24, R27, R32, R41, R46, R48 | R 0402_L | R | 16 | y | y
1m | 贴片电阻 | R7, R8 | R2512_L | R | 2 | y | y
DNI | 贴片电阻 | R9, R10, R11, R12 | R 0402_L | R | 4
137k | 贴片电阻 | R17 | R0402_L | R | 1 | y | y
47k | 贴片电阻 | R18 | R0402_L | R | 1 | y | y
43k | 贴片电阻 | R19 | R0402_L | R | 1 | y
4k | 贴片电阻 | R20 | R0402_L | R | 1 | y
470R | 贴片电阻 | R21, R22, R23, R40 | R 0402_L | R | 4 | y | y
3k | 贴片电阻 | R25, R26, R33, R34 | R 0402_L | R | 4 | y | y
30k | 贴片电阻 | R28, R29, R30, R31 | R 0402_L | R | 4 | y | y
4.7K | 贴片电阻 | R35, R37 | R 0402_L | R | 2 | y
22R | 贴片电阻 | R36, R38, R50, R51, R52, R53 | R 0402_L | R | 6 | y | y
1.5K | 贴片电阻 | R39 | R 0402_L | R | 1 | y | y
100R | 贴片电阻 | R42, R45 | R 0402_L | R | 2 | y | y
36K | 贴片电阻 | R44 | R 0402_L | R | 1 | y | y
100K | 贴片电阻 | R47, R49 | R 0402_L | R | 2 | y | y
5.1K | 贴片电阻 | R54, R55 | R 0402_L | R | 2 | y | y
1.1A/6V | PPTC自恢复保险丝 | RF1 | MF-NSMF110-2 | PPTC | 1 | y | y
SelectBit | 跨接桥，用于选择不同的模式，可以用锡连上，或者焊上0R电阻 | SB1, SB2 | SelectBit 0402 | SelectBit | 2
SW4_3x4x2.5 | SW4_3x4x2.5 | SW1 | SW4_3x4x2.5 | SW4_3x4x2.5 | 1 | y
TEST VIN | 测试环 | TP1 | TEST TP1.4_W | TEST TP | 1
TEST VOUT | 测试环 | TP2 | TEST TP1.4_W | TEST TP | 1
TEST GH1 | 测试环 | TP3 | TEST TP1.4_W | TEST TP | 1
TEST GH2 | 测试环 | TP4 | TEST TP1.4_W | TEST TP | 1
TEST SW1 | 测试环 | TP5 | TEST TP1.4_W | TEST TP | 1
TEST SW2 | 测试环 | TP6 | TEST TP1.4_W | TEST TP | 1
TEST GL1 | 测试环 | TP7 | TEST TP1.4_W | TEST TP | 1
TEST GL2 | 测试环 | TP8 | TEST TP1.4_W | TEST TP | 1
TEST GND | 测试环 | TP9 | TEST TP1.4_W | TEST TP | 1
TEST 5V | 测试环 | TP10 | TEST TP1.4_W | TEST TP | 1
TEST 10V | 测试环 | TP11 | TEST TP1.4_W | TEST TP | 1
TEST 3V3 | 测试环 | TP12 | TEST TP1.4_W | TEST TP | 1
TEST 1V65 | 测试环 | TP13 | TEST TP1.4_W | TEST TP | 1
UCC27211ADRMT | IC GATE DRVR HALF-BRIDGE 8VSON | U1, U2 | FP-DRM0008A-MFG | CMP-2000-07521-2 | 2 | y | y
RT7272B |  | U3 | RT7272B | RT7272B | 1 | y | y
SPX3819M5-L-5-0 |  | U4 | SPX3819M5-L-5-0 | SPX3819M5-L-5-0 | 1 | y | y
RT9013-33GB |  | U5 | RT9013-33GB | RT9013-33GB | 1 | y | y
STM32G474RET6 | MAINSTREAM ARM CORTEX-M4 CORE WI | U6 | FP-LQFP64-5W-MFG | CMP-12105-000051-1 | 1 | y
INA190A4IDCKR | IC CURR SENSE 1 CIRCUIT SC70-6 | U7, U8 | FP-DCK0006A-IPC_C | CMP-04895-000472-1 | 2 | y | y
TLV9001IDBVR | IC CMOS 1 CIRCUIT SOT23-5 | U9, U10, U11 | FP-DBV0005A-IPC_B | CMP-04895-000230-1 | 3 | y | y
STM32F103CBT6 | ARM Cortex-M3 32-bit MCU, 64 KB Flash, 20 KB Internal RAM, 37 I/Os, 48-pin LQFP, -40 to 85 degC, Tray | U12 | STM-LQFP48_L | CMP-0237-00215-3 | 1 | y | y
TYPE-C 2.0 -16P | USB2.0_Type-C_16Pin母座 | USBC1 | USB-C-SMD_16P | USB2.0_Type-C_16Pin | 1 | y
24MHz | 4脚无源晶振(谐振器） | X1 | XTAL-3225-4P | XTAL-4P | 1 | y | y
8MHz | 4脚无源晶振(谐振器） | X2 | XTAL-3225-4P | XTAL-4P | 1 | y | y
