Aiano/DigitalPowerSupply/Hardware/Display/BOM.xlsx

Comment | Description | Designator | Footprint | LibRef | Quantity | Sourced
10uF | 无极性贴片电容 | C1, C6, C16, C22, C26, C27 | C 0402_L | C | 6 | y
100nF | 无极性贴片电容 | C2, C3, C4, C5, C7, C9, C13, C17, C18, C19, C20, C21, C23 | C 0402_L | C | 13 | y
1uF | 无极性贴片电容 | C8, C10, C24, C25 | C 0402_L | C | 4 | y
10pF | 无极性贴片电容 | C11, C14 | C 0402_L | C | 2 | y
15pF | 无极性贴片电容 | C12, C15 | C 0402_L | C | 2 | y
LCD FPC Connector | 2.8英寸TFT-LCD电容触摸屏接插式FPC座子 | CN1 | FPC_CONNECTOR_0.5MM_18P | LCD | 1 | y
LCD Touch Connector | 2.8英寸TFT-LCD电容触摸屏触摸检测芯片接插式FPC座子 | CN2 | FPC_CONNECTOR_0.5MM_6P | Touch | 1 | y
B5819W | Schottky Barrier Rectifier, 1 A, 40 Vrm, -65 to 125 degC, 2-Pin SOD123, RoHS, Tape and Reel | D1 | MCC-SOD123_V | CMP-2100-03587-1 | 1 | y
SMFJ6.0CA | 贴片TVS瞬变抑制二极管 | D2 | SMFJ6.0CA | SMFJ6.0CA | 1 | y
HDR-1X4 | 4P接插件 | JP1 | HDR2.54-LI-4P | Header 4 | 1 | y
600R@100MHz | 小功率贴片电感 | L1 | L 0603 | L | 1 | y
绿色 | 贴片LED | LED1 | LED 0603G | LED-SMD | 1 | y
蓝色 | 贴片LED | LED2 | LED 0603B | LED-SMD | 1 | y
红色 | 贴片LED | LED3 | LED 0603R | LED-SMD | 1 | y
AO3401 | P沟道 30V/4.2A | Q1 | SOT23-3L | AO3401 | 1 | y
S9013 | 低频放大-NPN型 | Q2 | SOT23-3L | 9013-SMD | 1 | y
470R | 贴片电阻 | R1, R23, R26 | R 0402_L | R | 3 | y
4.7K | 贴片电阻 | R2, R3 | R 0402_L | R | 2 | y
10K | 贴片电阻 | R4, R7, R8, R10, R12, R13, R16, R22 | R 0402_L | R | 8 | y
100R | 贴片电阻 | R5, R24 | R 0402_L | R | 2 | y
10R | 贴片电阻 | R6 | R 0402_L | R | 1 | y
100K | 贴片电阻 | R9, R11 | R 0402_L | R | 2 | y
22R | 贴片电阻 | R14, R15, R17, R18, R19, R20 | R 0402_L | R | 6 | y
1.5K | 贴片电阻 | R21 | R 0402_L | R | 1 | y
36K | 贴片电阻 | R25 | R 0402_L | R | 1 | y
5.1K | 贴片电阻 | R27, R29 | R 0402_L | R | 2 | y
17K4 | 贴片电阻 | R28 | R 0402_L | R | 1 | y
3K | 贴片电阻 | R30 | R 0402_L | R | 1 | y
1.1A/6V | PPTC自恢复保险丝 | RF1 | MF-NSMF110-2 | PPTC | 1 | y
SelectBit | 跨接桥，用于选择不同的模式，可以用锡连上，或者焊上0R电阻 | SB1, SB2, SB3, SB4, SB5, SB6 | SELECTBIT 0402 | SelectBit | 6 | n
KEY | 轻触开关 | SW1 | 小乌龟2脚轻触开关3.9*2.9 | KEY | 1 | y
TEST TP | 测试环 | TP1 | TEST TP1.4_R | TEST TP | 1 | y
STM32F103C8T6 | ARM Cortex-M3 32-bit MCU, 64 KB Flash, 20 KB Internal RAM, 37 I/Os, 48-pin LQFP, -40 to 85 degC, Tray | U1 | STM-LQFP48_L | CMP-0237-00215-3 | 1 | y
STM32G474RET6 | MAINSTREAM ARM CORTEX-M4 CORE WI | U2 | FP-LQFP64-5W-MFG | CMP-12105-000051-1 | 1 | y
RT9013-33GB | Linear Voltage Regulator IC 1 Output 500mA SOT-23-5 | U3 | SOT94P279X129-5N | RT9013-33GB | 1 | y
TYPE-C 2.0 -16P | USB2.0_Type-C_16Pin母座 | USBC1, USBC2 | USB-C-SMD_16P | USB2.0_Type-C_16Pin | 2 | y
AMS1117-3V3 | 三端稳压芯片 | V1 | SOT89_L | AMS1117 | 1 | y
8MHz | 4脚无源晶振(谐振器） | X1 | XTAL-3225-4P | XTAL-4P | 1 | y
24MHz | 4脚无源晶振(谐振器） | X2 | XTAL-3225-4P | XTAL-4P | 1 | y
