Aiano/DigitalPowerSupply/Hardware/DigitalBuckBoost/Models/Coilcraft-SER2918H.step

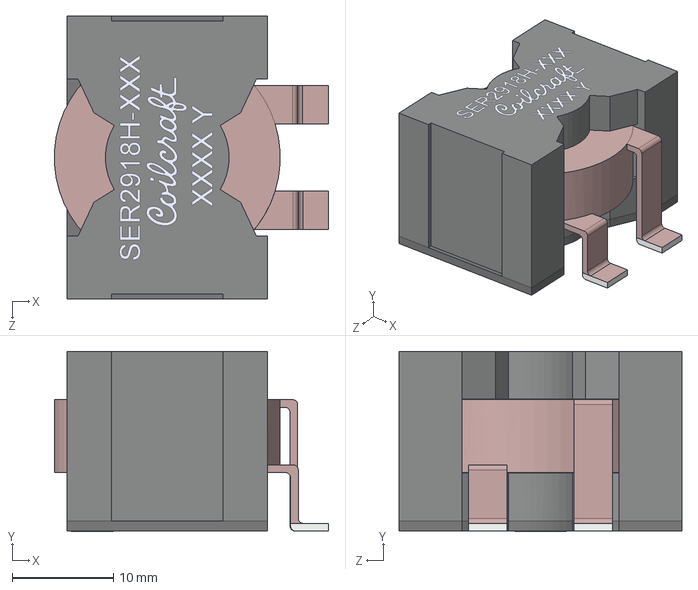
[picture p44: CAD file, 2024-09-10]
Hardware/DigitalBuckBoost/Models/Coilcraft-SER2918H.step
27.0 x 17.8 x 27.9 mm
