Aiano/DigitalPowerSupply/Hardware/Display/Model/FPC_Connector_0.5mm_6P_Bottom.stp

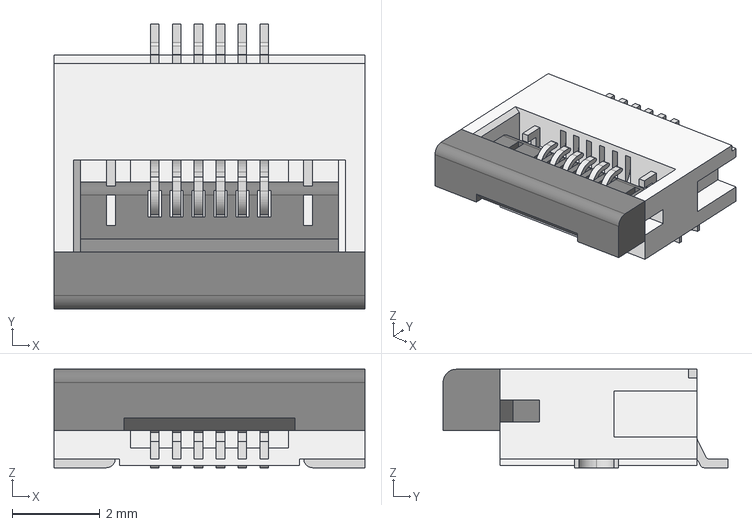
[picture p45: CAD file, 2024-06-15]
Hardware/Display/Model/FPC_Connector_0.5mm_6P_Bottom.stp
7.10 x 6.50 x 2.25 mm
