Aiano/DigitalPowerSupply/Hardware/Display/Model/RT9013-33GB.STEP

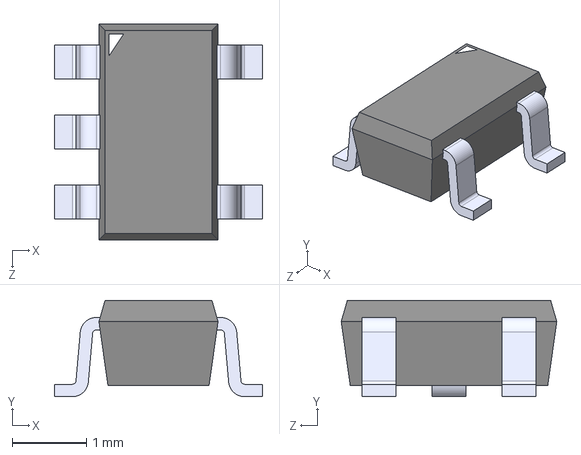
[picture p46: CAD file, 2024-06-15]
Hardware/Display/Model/RT9013-33GB.STEP
2.79 x 1.30 x 2.90 mm
