Aiano/DigitalPowerSupply/Hardware/Display/Model/switches_thb01sl-_251_-f1_2_b.stp

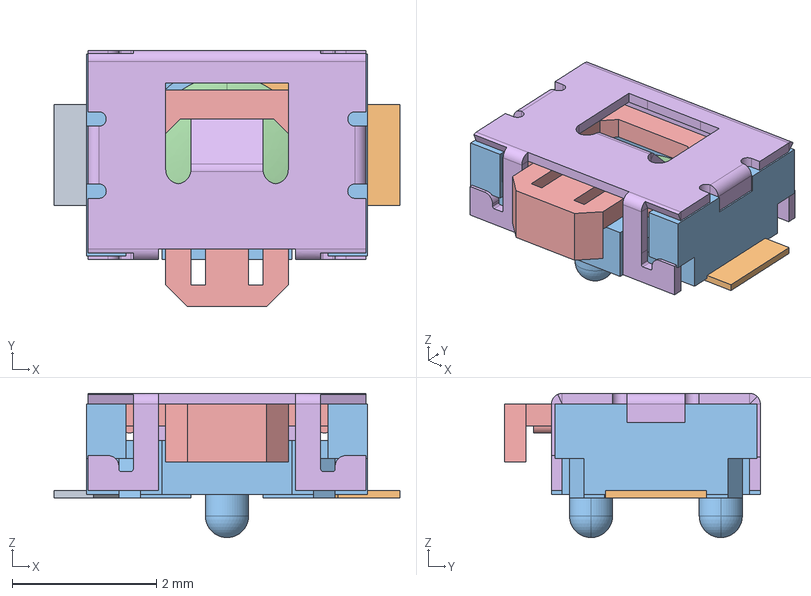
[picture p47: CAD file, 2024-06-15]
Hardware/Display/Model/switches_thb01sl-_251_-f1_2_b.stp
4.80 x 3.55 x 2.00 mm
