Aiano/DigitalPowerSupply/Hardware/Display/Model/FPC_Connector_0.5mm_18P_Bottom.stp

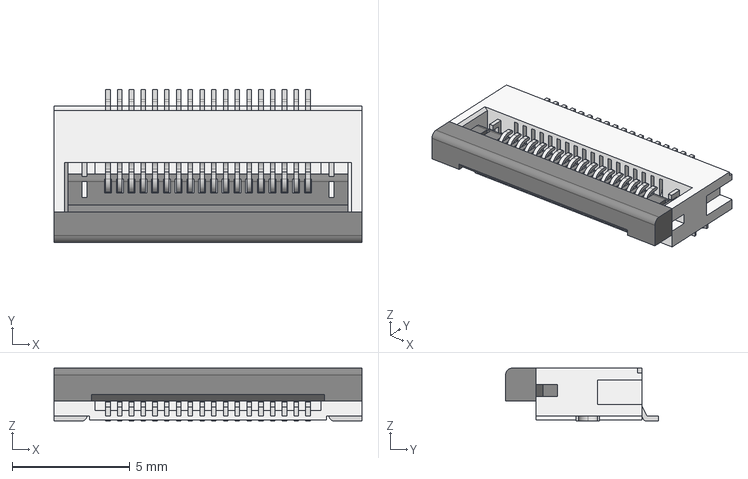
[picture p48: CAD file, 2024-06-15]
Hardware/Display/Model/FPC_Connector_0.5mm_18P_Bottom.stp
13.1 x 6.50 x 2.25 mm
