Aiano/DigitalPowerSupply/Hardware/Display/Model/PPTC1206.stp

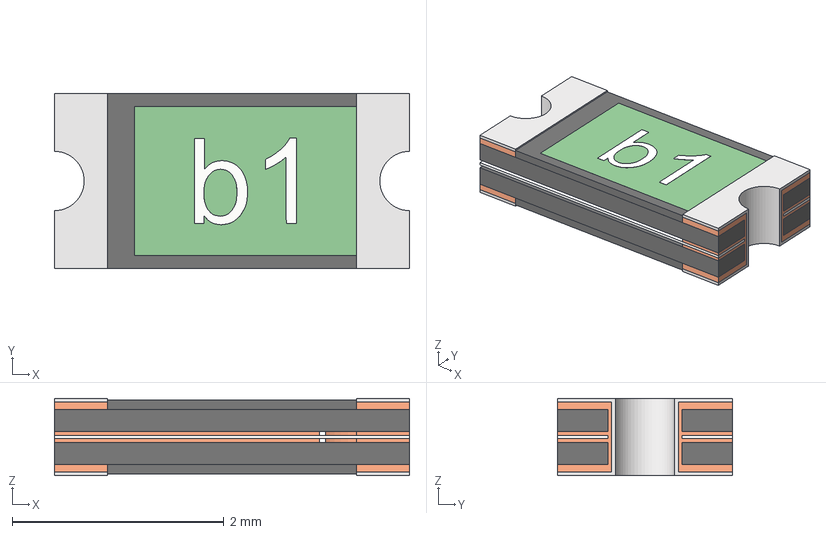
[picture p49: CAD file, 2024-06-15]
Hardware/Display/Model/PPTC1206.stp
3.35 x 1.65 x 0.73 mm
0ZCJ0100FF2E_PART1
0ZCJ0100FF2E_PART2
0ZCJ0100FF2E_PART3
0ZCJ0100FF2E_PART4
0ZCJ0100FF2E_PART5
0ZCJ0100FF2E_PART6
0ZCJ0100FF2E_PART7
0ZCJ0100FF2E_PART8
0ZCJ0100FF2E_PART9
0ZCJ0100FF2E_PART10
0ZCJ0100FF2E_PART11
0ZCJ0100FF2E_PART12
0ZCJ0100FF2E_PART13
0ZCJ0100FF2E_PART14
0ZCJ0100FF2E_PART15
