Aiano/DigitalPowerSupply/(list of files, cad)

Other CAD files:
Hardware/Display/Model/switches_thb01sl-_251_-f1_2_b_colored.STEP
Hardware/Display/Model/switches_thb01sl-_251_-f1_2_b_colored.SLDPRT
