Aiano/DigitalPowerSupply/Firmware/Display_Test/MDK-ARM/Display/Display.htm

# Static Call Graph for image Display\Display.axf

#<CALLGRAPH># ARM Linker, 6140002: Last Updated: Wed May 29 13:25:24 2024

### Maximum Stack Usage = 256 bytes + Unknown(Functions without stacksize, Cycles, Untraceable Function Pointers)

### Call chain for Maximum Stack Depth:

ST7789_WriteString ⇒ ST7789_WriteChar ⇒ ST7789_SetAddressWindow ⇒ ST7789_WriteData ⇒ HAL_SPI_Transmit ⇒ SPI_EndRxTxTransaction ⇒ SPI_WaitFifoStateUntilTimeout

### Functions with no stack information

- __user_initial_stackheap

### Mutually Recursive functions

- ADC1_2_IRQHandler ⇒ ADC1_2_IRQHandler
- BusFault_Handler ⇒ BusFault_Handler
- HardFault_Handler ⇒ HardFault_Handler
- MemManage_Handler ⇒ MemManage_Handler
- NMI_Handler ⇒ NMI_Handler
- UsageFault_Handler ⇒ UsageFault_Handler

### Function Pointers

- ADC1_2_IRQHandler from startup_stm32g474xx.o(.text) referenced from startup_stm32g474xx.o(RESET)
- ADC3_IRQHandler from startup_stm32g474xx.o(.text) referenced from startup_stm32g474xx.o(RESET)
- ADC4_IRQHandler from startup_stm32g474xx.o(.text) referenced from startup_stm32g474xx.o(RESET)
- ADC5_IRQHandler from startup_stm32g474xx.o(.text) referenced from startup_stm32g474xx.o(RESET)
- BusFault_Handler from stm32g4xx_it.o(.text.BusFault_Handler) referenced from startup_stm32g474xx.o(RESET)
- CDC_Control_FS from usbd_cdc_if.o(.text.CDC_Control_FS) referenced 2 times from usbd_cdc_if.o(.data.USBD_Interface_fops_FS)
- CDC_DeInit_FS from usbd_cdc_if.o(.text.CDC_DeInit_FS) referenced 2 times from usbd_cdc_if.o(.data.USBD_Interface_fops_FS)
- CDC_Init_FS from usbd_cdc_if.o(.text.CDC_Init_FS) referenced 2 times from usbd_cdc_if.o(.data.USBD_Interface_fops_FS)
- CDC_Receive_FS from usbd_cdc_if.o(.text.CDC_Receive_FS) referenced 2 times from usbd_cdc_if.o(.data.USBD_Interface_fops_FS)
- CDC_TransmitCplt_FS from usbd_cdc_if.o(.text.CDC_TransmitCplt_FS) referenced 2 times from usbd_cdc_if.o(.data.USBD_Interface_fops_FS)
- COMP1_2_3_IRQHandler from startup_stm32g474xx.o(.text) referenced from startup_stm32g474xx.o(RESET)
- COMP4_5_6_IRQHandler from startup_stm32g474xx.o(.text) referenced from startup_stm32g474xx.o(RESET)
- COMP7_IRQHandler from startup_stm32g474xx.o(.text) referenced from startup_stm32g474xx.o(RESET)
- CORDIC_IRQHandler from startup_stm32g474xx.o(.text) referenced from startup_stm32g474xx.o(RESET)
- CRS_IRQHandler from startup_stm32g474xx.o(.text) referenced from startup_stm32g474xx.o(RESET)
- DMA1_Channel1_IRQHandler from stm32g4xx_it.o(.text.DMA1_Channel1_IRQHandler) referenced from startup_stm32g474xx.o(RESET)
- DMA1_Channel2_IRQHandler from stm32g4xx_it.o(.text.DMA1_Channel2_IRQHandler) referenced from startup_stm32g474xx.o(RESET)
- DMA1_Channel3_IRQHandler from startup_stm32g474xx.o(.text) referenced from startup_stm32g474xx.o(RESET)
- DMA1_Channel4_IRQHandler from startup_stm32g474xx.o(.text) referenced from startup_stm32g474xx.o(RESET)
- DMA1_Channel5_IRQHandler from startup_stm32g474xx.o(.text) referenced from startup_stm32g474xx.o(RESET)
- DMA1_Channel6_IRQHandler from startup_stm32g474xx.o(.text) referenced from startup_stm32g474xx.o(RESET)
- DMA1_Channel7_IRQHandler from startup_stm32g474xx.o(.text) referenced from startup_stm32g474xx.o(RESET)
- DMA1_Channel8_IRQHandler from startup_stm32g474xx.o(.text) referenced from startup_stm32g474xx.o(RESET)
- DMA2_Channel1_IRQHandler from startup_stm32g474xx.o(.text) referenced from startup_stm32g474xx.o(RESET)
- DMA2_Channel2_IRQHandler from startup_stm32g474xx.o(.text) referenced from startup_stm32g474xx.o(RESET)
- DMA2_Channel3_IRQHandler from startup_stm32g474xx.o(.text) referenced from startup_stm32g474xx.o(RESET)
- DMA2_Channel4_IRQHandler from startup_stm32g474xx.o(.text) referenced from startup_stm32g474xx.o(RESET)
- DMA2_Channel5_IRQHandler from startup_stm32g474xx.o(.text) referenced from startup_stm32g474xx.o(RESET)
- DMA2_Channel6_IRQHandler from startup_stm32g474xx.o(.text) referenced from startup_stm32g474xx.o(RESET)
- DMA2_Channel7_IRQHandler from startup_stm32g474xx.o(.text) referenced from startup_stm32g474xx.o(RESET)
- DMA2_Channel8_IRQHandler from startup_stm32g474xx.o(.text) referenced from startup_stm32g474xx.o(RESET)
- DMAMUX_OVR_IRQHandler from startup_stm32g474xx.o(.text) referenced from startup_stm32g474xx.o(RESET)
- DebugMon_Handler from stm32g4xx_it.o(.text.DebugMon_Handler) referenced from startup_stm32g474xx.o(RESET)
- EXTI0_IRQHandler from startup_stm32g474xx.o(.text) referenced from startup_stm32g474xx.o(RESET)
- EXTI15_10_IRQHandler from startup_stm32g474xx.o(.text) referenced from startup_stm32g474xx.o(RESET)
- EXTI1_IRQHandler from startup_stm32g474xx.o(.text) referenced from startup_stm32g474xx.o(RESET)
- EXTI2_IRQHandler from startup_stm32g474xx.o(.text) referenced from startup_stm32g474xx.o(RESET)
- EXTI3_IRQHandler from startup_stm32g474xx.o(.text) referenced from startup_stm32g474xx.o(RESET)
- EXTI4_IRQHandler from startup_stm32g474xx.o(.text) referenced from startup_stm32g474xx.o(RESET)
- EXTI9_5_IRQHandler from startup_stm32g474xx.o(.text) referenced from startup_stm32g474xx.o(RESET)
- FDCAN1_IT0_IRQHandler from startup_stm32g474xx.o(.text) referenced from startup_stm32g474xx.o(RESET)
- FDCAN1_IT1_IRQHandler from startup_stm32g474xx.o(.text) referenced from startup_stm32g474xx.o(RESET)
- FDCAN2_IT0_IRQHandler from startup_stm32g474xx.o(.text) referenced from startup_stm32g474xx.o(RESET)
- FDCAN2_IT1_IRQHandler from startup_stm32g474xx.o(.text) referenced from startup_stm32g474xx.o(RESET)
- FDCAN3_IT0_IRQHandler from startup_stm32g474xx.o(.text) referenced from startup_stm32g474xx.o(RESET)
- FDCAN3_IT1_IRQHandler from startup_stm32g474xx.o(.text) referenced from startup_stm32g474xx.o(RESET)
- FLASH_IRQHandler from startup_stm32g474xx.o(.text) referenced from startup_stm32g474xx.o(RESET)
- FMAC_IRQHandler from startup_stm32g474xx.o(.text) referenced from startup_stm32g474xx.o(RESET)
- FMC_IRQHandler from startup_stm32g474xx.o(.text) referenced from startup_stm32g474xx.o(RESET)
- FPU_IRQHandler from startup_stm32g474xx.o(.text) referenced from startup_stm32g474xx.o(RESET)
- GTXXXX_ReadReg from gt911.o(.text.GTXXXX_ReadReg) referenced from gt911.o(.text.GTXXXX_Scanf)
- HAL_Delay from stm32g4xx_hal.o(.text.HAL_Delay) referenced from gt911.o(.text.GTP_Init)
- HAL_Delay from stm32g4xx_hal.o(.text.HAL_Delay) referenced from st7789.o(.text.ST7789_Init)
- HAL_GPIO_Init from stm32g4xx_hal_gpio.o(.text.HAL_GPIO_Init) referenced from gpio.o(.text.MX_GPIO_Init)
- HAL_GPIO_WritePin from stm32g4xx_hal_gpio.o(.text.HAL_GPIO_WritePin) referenced from gt911.o(.text.GTP_Init)
- HAL_GPIO_WritePin from stm32g4xx_hal_gpio.o(.text.HAL_GPIO_WritePin) referenced from gpio.o(.text.MX_GPIO_Init)
- HAL_PCDEx_PMAConfig from stm32g4xx_hal_pcd_ex.o(.text.HAL_PCDEx_PMAConfig) referenced from usbd_conf.o(.text.USBD_LL_Init)
- HRTIM1_FLT_IRQHandler from startup_stm32g474xx.o(.text) referenced from startup_stm32g474xx.o(RESET)
- HRTIM1_Master_IRQHandler from startup_stm32g474xx.o(.text) referenced from startup_stm32g474xx.o(RESET)
- HRTIM1_TIMA_IRQHandler from startup_stm32g474xx.o(.text) referenced from startup_stm32g474xx.o(RESET)
- HRTIM1_TIMB_IRQHandler from startup_stm32g474xx.o(.text) referenced from startup_stm32g474xx.o(RESET)
- HRTIM1_TIMC_IRQHandler from startup_stm32g474xx.o(.text) referenced from startup_stm32g474xx.o(RESET)
- HRTIM1_TIMD_IRQHandler from startup_stm32g474xx.o(.text) referenced from startup_stm32g474xx.o(RESET)
- HRTIM1_TIME_IRQHandler from startup_stm32g474xx.o(.text) referenced from startup_stm32g474xx.o(RESET)
- HRTIM1_TIMF_IRQHandler from startup_stm32g474xx.o(.text) referenced from startup_stm32g474xx.o(RESET)
- HardFault_Handler from stm32g4xx_it.o(.text.HardFault_Handler) referenced from startup_stm32g474xx.o(RESET)
- I2C1_ER_IRQHandler from startup_stm32g474xx.o(.text) referenced from startup_stm32g474xx.o(RESET)
- I2C1_EV_IRQHandler from startup_stm32g474xx.o(.text) referenced from startup_stm32g474xx.o(RESET)
- I2C2_ER_IRQHandler from startup_stm32g474xx.o(.text) referenced from startup_stm32g474xx.o(RESET)
- I2C2_EV_IRQHandler from startup_stm32g474xx.o(.text) referenced from startup_stm32g474xx.o(RESET)
- I2C3_ER_IRQHandler from startup_stm32g474xx.o(.text) referenced from startup_stm32g474xx.o(RESET)
- I2C3_EV_IRQHandler from startup_stm32g474xx.o(.text) referenced from startup_stm32g474xx.o(RESET)
- I2C4_ER_IRQHandler from startup_stm32g474xx.o(.text) referenced from startup_stm32g474xx.o(RESET)
- I2C4_EV_IRQHandler from startup_stm32g474xx.o(.text) referenced from startup_stm32g474xx.o(RESET)
- LPTIM1_IRQHandler from startup_stm32g474xx.o(.text) referenced from startup_stm32g474xx.o(RESET)
- LPUART1_IRQHandler from startup_stm32g474xx.o(.text) referenced from startup_stm32g474xx.o(RESET)
- MemManage_Handler from stm32g4xx_it.o(.text.MemManage_Handler) referenced from startup_stm32g474xx.o(RESET)
- NMI_Handler from stm32g4xx_it.o(.text.NMI_Handler) referenced from startup_stm32g474xx.o(RESET)
- PVD_PVM_IRQHandler from startup_stm32g474xx.o(.text) referenced from startup_stm32g474xx.o(RESET)
- PendSV_Handler from stm32g4xx_it.o(.text.PendSV_Handler) referenced from startup_stm32g474xx.o(RESET)
- QUADSPI_IRQHandler from startup_stm32g474xx.o(.text) referenced from startup_stm32g474xx.o(RESET)
- RCC_IRQHandler from startup_stm32g474xx.o(.text) referenced from startup_stm32g474xx.o(RESET)
- RNG_IRQHandler from startup_stm32g474xx.o(.text) referenced from startup_stm32g474xx.o(RESET)
- RTC_Alarm_IRQHandler from startup_stm32g474xx.o(.text) referenced from startup_stm32g474xx.o(RESET)
- RTC_TAMP_LSECSS_IRQHandler from startup_stm32g474xx.o(.text) referenced from startup_stm32g474xx.o(RESET)
- RTC_WKUP_IRQHandler from startup_stm32g474xx.o(.text) referenced from startup_stm32g474xx.o(RESET)
- Reset_Handler from startup_stm32g474xx.o(.text) referenced from startup_stm32g474xx.o(RESET)
- SAI1_IRQHandler from startup_stm32g474xx.o(.text) referenced from startup_stm32g474xx.o(RESET)
- SPI1_IRQHandler from stm32g4xx_it.o(.text.SPI1_IRQHandler) referenced from startup_stm32g474xx.o(RESET)
- SPI2_IRQHandler from startup_stm32g474xx.o(.text) referenced from startup_stm32g474xx.o(RESET)
- SPI3_IRQHandler from startup_stm32g474xx.o(.text) referenced from startup_stm32g474xx.o(RESET)
- SPI4_IRQHandler from startup_stm32g474xx.o(.text) referenced from startup_stm32g474xx.o(RESET)
- SPI_DMAAbortOnError from stm32g4xx_hal_spi.o(.text.SPI_DMAAbortOnError) referenced from stm32g4xx_hal_spi.o(.text.HAL_SPI_IRQHandler)
- SPI_DMAError from stm32g4xx_hal_spi.o(.text.SPI_DMAError) referenced from stm32g4xx_hal_spi.o(.text.HAL_SPI_Transmit_DMA)
- SPI_DMAHalfTransmitCplt from stm32g4xx_hal_spi.o(.text.SPI_DMAHalfTransmitCplt) referenced from stm32g4xx_hal_spi.o(.text.HAL_SPI_Transmit_DMA)
- SPI_DMATransmitCplt from stm32g4xx_hal_spi.o(.text.SPI_DMATransmitCplt) referenced from stm32g4xx_hal_spi.o(.text.HAL_SPI_Transmit_DMA)
- ST7789_WriteCommand from st7789.o(.text.ST7789_WriteCommand) referenced from st7789.o(.text.ST7789_Init)
- ST7789_WriteCommand from st7789.o(.text.ST7789_WriteCommand) referenced from st7789.o(.text.ST7789_SetAddressWindow)
- ST7789_WriteData from st7789.o(.text.ST7789_WriteData) referenced from st7789.o(.text.ST7789_Init)
- ST7789_WriteSmallData from st7789.o(.text.ST7789_WriteSmallData) referenced from st7789.o(.text.ST7789_Init)
- ST7789_WriteString from st7789.o(.text.ST7789_WriteString) referenced from main.o(.text.disp_clear)
- SVC_Handler from stm32g4xx_it.o(.text.SVC_Handler) referenced from startup_stm32g474xx.o(RESET)
- SysTick_Handler from stm32g4xx_it.o(.text.SysTick_Handler) referenced from startup_stm32g474xx.o(RESET)
- SystemInit from system_stm32g4xx.o(.text.SystemInit) referenced from startup_stm32g474xx.o(.text)
- TIM1_BRK_TIM15_IRQHandler from startup_stm32g474xx.o(.text) referenced from startup_stm32g474xx.o(RESET)
- TIM1_CC_IRQHandler from startup_stm32g474xx.o(.text) referenced from startup_stm32g474xx.o(RESET)
- TIM1_TRG_COM_TIM17_IRQHandler from startup_stm32g474xx.o(.text) referenced from startup_stm32g474xx.o(RESET)
- TIM1_UP_TIM16_IRQHandler from startup_stm32g474xx.o(.text) referenced from startup_stm32g474xx.o(RESET)
- TIM20_BRK_IRQHandler from startup_stm32g474xx.o(.text) referenced from startup_stm32g474xx.o(RESET)
- TIM20_CC_IRQHandler from startup_stm32g474xx.o(.text) referenced from startup_stm32g474xx.o(RESET)
- TIM20_TRG_COM_IRQHandler from startup_stm32g474xx.o(.text) referenced from startup_stm32g474xx.o(RESET)
- TIM20_UP_IRQHandler from startup_stm32g474xx.o(.text) referenced from startup_stm32g474xx.o(RESET)
- TIM2_IRQHandler from startup_stm32g474xx.o(.text) referenced from startup_stm32g474xx.o(RESET)
- TIM3_IRQHandler from startup_stm32g474xx.o(.text) referenced from startup_stm32g474xx.o(RESET)
- TIM4_IRQHandler from startup_stm32g474xx.o(.text) referenced from startup_stm32g474xx.o(RESET)
- TIM5_IRQHandler from startup_stm32g474xx.o(.text) referenced from startup_stm32g474xx.o(RESET)
- TIM6_DAC_IRQHandler from startup_stm32g474xx.o(.text) referenced from startup_stm32g474xx.o(RESET)
- TIM7_DAC_IRQHandler from startup_stm32g474xx.o(.text) referenced from startup_stm32g474xx.o(RESET)
- TIM8_BRK_IRQHandler from startup_stm32g474xx.o(.text) referenced from startup_stm32g474xx.o(RESET)
- TIM8_CC_IRQHandler from startup_stm32g474xx.o(.text) referenced from startup_stm32g474xx.o(RESET)
- TIM8_TRG_COM_IRQHandler from startup_stm32g474xx.o(.text) referenced from startup_stm32g474xx.o(RESET)
- TIM8_UP_IRQHandler from startup_stm32g474xx.o(.text) referenced from startup_stm32g474xx.o(RESET)
- UART4_IRQHandler from startup_stm32g474xx.o(.text) referenced from startup_stm32g474xx.o(RESET)
- UART5_IRQHandler from startup_stm32g474xx.o(.text) referenced from startup_stm32g474xx.o(RESET)
- UCPD1_IRQHandler from startup_stm32g474xx.o(.text) referenced from startup_stm32g474xx.o(RESET)
- USART1_IRQHandler from startup_stm32g474xx.o(.text) referenced from startup_stm32g474xx.o(RESET)
- USART2_IRQHandler from startup_stm32g474xx.o(.text) referenced from startup_stm32g474xx.o(RESET)
- USART3_IRQHandler from startup_stm32g474xx.o(.text) referenced from startup_stm32g474xx.o(RESET)
- USBD_CDC_ConfigStrDescriptor from usbd_desc.o(.text.USBD_CDC_ConfigStrDescriptor) referenced 2 times from usbd_desc.o(.data.CDC_Desc)
- USBD_CDC_DataIn from usbd_cdc.o(.text.USBD_CDC_DataIn) referenced 2 times from usbd_cdc.o(.data.USBD_CDC)
- USBD_CDC_DataOut from usbd_cdc.o(.text.USBD_CDC_DataOut) referenced 2 times from usbd_cdc.o(.data.USBD_CDC)
- USBD_CDC_DeInit from usbd_cdc.o(.text.USBD_CDC_DeInit) referenced 2 times from usbd_cdc.o(.data.USBD_CDC)
- USBD_CDC_DeviceDescriptor from usbd_desc.o(.text.USBD_CDC_DeviceDescriptor) referenced 2 times from usbd_desc.o(.data.CDC_Desc)
- USBD_CDC_EP0_RxReady from usbd_cdc.o(.text.USBD_CDC_EP0_RxReady) referenced 2 times from usbd_cdc.o(.data.USBD_CDC)
- USBD_CDC_GetDeviceQualifierDescriptor from usbd_cdc.o(.text.USBD_CDC_GetDeviceQualifierDescriptor) referenced 2 times from usbd_cdc.o(.data.USBD_CDC)
- USBD_CDC_GetFSCfgDesc from usbd_cdc.o(.text.USBD_CDC_GetFSCfgDesc) referenced 2 times from usbd_cdc.o(.data.USBD_CDC)
- USBD_CDC_GetHSCfgDesc from usbd_cdc.o(.text.USBD_CDC_GetHSCfgDesc) referenced 2 times from usbd_cdc.o(.data.USBD_CDC)
- USBD_CDC_GetOtherSpeedCfgDesc from usbd_cdc.o(.text.USBD_CDC_GetOtherSpeedCfgDesc) referenced 2 times from usbd_cdc.o(.data.USBD_CDC)
- USBD_CDC_Init from usbd_cdc.o(.text.USBD_CDC_Init) referenced 2 times from usbd_cdc.o(.data.USBD_CDC)
- USBD_CDC_InterfaceStrDescriptor from usbd_desc.o(.text.USBD_CDC_InterfaceStrDescriptor) referenced 2 times from usbd_desc.o(.data.CDC_Desc)
- USBD_CDC_LangIDStrDescriptor from usbd_desc.o(.text.USBD_CDC_LangIDStrDescriptor) referenced 2 times from usbd_desc.o(.data.CDC_Desc)
- USBD_CDC_ManufacturerStrDescriptor from usbd_desc.o(.text.USBD_CDC_ManufacturerStrDescriptor) referenced 2 times from usbd_desc.o(.data.CDC_Desc)
- USBD_CDC_ProductStrDescriptor from usbd_desc.o(.text.USBD_CDC_ProductStrDescriptor) referenced 2 times from usbd_desc.o(.data.CDC_Desc)
- USBD_CDC_SerialStrDescriptor from usbd_desc.o(.text.USBD_CDC_SerialStrDescriptor) referenced 2 times from usbd_desc.o(.data.CDC_Desc)
- USBD_CDC_Setup from usbd_cdc.o(.text.USBD_CDC_Setup) referenced 2 times from usbd_cdc.o(.data.USBD_CDC)
- USBD_LL_CloseEP from usbd_conf.o(.text.USBD_LL_CloseEP) referenced from usbd_cdc.o(.text.USBD_CDC_DeInit)
- USBD_LL_OpenEP from usbd_conf.o(.text.USBD_LL_OpenEP) referenced from usbd_cdc.o(.text.USBD_CDC_Init)
- USBWakeUp_IRQHandler from startup_stm32g474xx.o(.text) referenced from startup_stm32g474xx.o(RESET)
- USB_HP_IRQHandler from startup_stm32g474xx.o(.text) referenced from startup_stm32g474xx.o(RESET)
- USB_LP_IRQHandler from stm32g4xx_it.o(.text.USB_LP_IRQHandler) referenced from startup_stm32g474xx.o(RESET)
- UsageFault_Handler from stm32g4xx_it.o(.text.UsageFault_Handler) referenced from startup_stm32g474xx.o(RESET)
- WWDG_IRQHandler from startup_stm32g474xx.o(.text) referenced from startup_stm32g474xx.o(RESET)
- __main from __main.o(!!!main) referenced from startup_stm32g474xx.o(.text)
- _printf_input_char from _printf_char_common.o(.text) referenced from _printf_char_common.o(.text)
- _sputc from _sputc.o(.text) referenced from noretval__2sprintf.o(.text)

### Global Symbols

__main (Thumb, 8 bytes, Stack size 0 bytes, __main.o(!!!main))

[Calls]

- >> __scatterload
- >> __rt_entry

[Address Reference Count : 1]

- startup_stm32g474xx.o(.text)

__scatterload (Thumb, 0 bytes, Stack size unknown bytes, __scatter.o(!!!scatter))

[Called By]

- >> __main

__scatterload_rt2 (Thumb, 44 bytes, Stack size unknown bytes, __scatter.o(!!!scatter), UNUSED)

[Calls]

- >> __rt_entry

__scatterload_rt2_thumb_only (Thumb, 0 bytes, Stack size unknown bytes, __scatter.o(!!!scatter), UNUSED)

__scatterload_null (Thumb, 0 bytes, Stack size unknown bytes, __scatter.o(!!!scatter), UNUSED)

__decompress (Thumb, 90 bytes, Stack size unknown bytes, __dczerorl2.o(!!dczerorl2), UNUSED)

__decompress1 (Thumb, 0 bytes, Stack size unknown bytes, __dczerorl2.o(!!dczerorl2), UNUSED)

__scatterload_zeroinit (Thumb, 28 bytes, Stack size unknown bytes, __scatter_zi.o(!!handler_zi), UNUSED)

_printf_d (Thumb, 0 bytes, Stack size unknown bytes, _printf_d.o(.ARM.Collect$$_printf_percent$$00000009))

[Stack]

- Max Depth = 56 + Unknown Stack Size
- Call Chain = _printf_d ⇒ _printf_int_dec ⇒ _printf_int_common

[Calls]

- >> _printf_int_dec

_printf_percent (Thumb, 0 bytes, Stack size unknown bytes, _printf_percent.o(.ARM.Collect$$_printf_percent$$00000000))

[Called By]

- >> __printf

_printf_x (Thumb, 0 bytes, Stack size unknown bytes, _printf_x.o(.ARM.Collect$$_printf_percent$$0000000C))

[Stack]

- Max Depth = 48 + Unknown Stack Size
- Call Chain = _printf_x ⇒ _printf_int_hex ⇒ _printf_int_common

[Calls]

- >> _printf_int_hex

_printf_s (Thumb, 0 bytes, Stack size unknown bytes, _printf_s.o(.ARM.Collect$$_printf_percent$$00000014))

[Stack]

- Max Depth = 24 + Unknown Stack Size
- Call Chain = _printf_s ⇒ _printf_string ⇒ _printf_cs_common ⇒ _printf_str

[Calls]

- >> _printf_string

_printf_percent_end (Thumb, 0 bytes, Stack size unknown bytes, _printf_percent_end.o(.ARM.Collect$$_printf_percent$$00000017))

__rt_lib_init (Thumb, 0 bytes, Stack size unknown bytes, libinit.o(.ARM.Collect$$libinit$$00000000))

[Called By]

- >> __rt_entry_li

__rt_lib_init_fp_1 (Thumb, 0 bytes, Stack size unknown bytes, libinit2.o(.ARM.Collect$$libinit$$00000001))

[Calls]

- >> _fp_init

__rt_lib_init_alloca_1 (Thumb, 0 bytes, Stack size unknown bytes, libinit2.o(.ARM.Collect$$libinit$$0000002E))

__rt_lib_init_argv_1 (Thumb, 0 bytes, Stack size unknown bytes, libinit2.o(.ARM.Collect$$libinit$$0000002C))

__rt_lib_init_atexit_1 (Thumb, 0 bytes, Stack size unknown bytes, libinit2.o(.ARM.Collect$$libinit$$0000001B))

__rt_lib_init_clock_1 (Thumb, 0 bytes, Stack size unknown bytes, libinit2.o(.ARM.Collect$$libinit$$00000021))

__rt_lib_init_cpp_1 (Thumb, 0 bytes, Stack size unknown bytes, libinit2.o(.ARM.Collect$$libinit$$00000032))

__rt_lib_init_exceptions_1 (Thumb, 0 bytes, Stack size unknown bytes, libinit2.o(.ARM.Collect$$libinit$$00000030))

__rt_lib_init_fp_trap_1 (Thumb, 0 bytes, Stack size unknown bytes, libinit2.o(.ARM.Collect$$libinit$$0000001F))

__rt_lib_init_getenv_1 (Thumb, 0 bytes, Stack size unknown bytes, libinit2.o(.ARM.Collect$$libinit$$00000023))

__rt_lib_init_heap_1 (Thumb, 0 bytes, Stack size unknown bytes, libinit2.o(.ARM.Collect$$libinit$$0000000A))

__rt_lib_init_lc_collate_1 (Thumb, 0 bytes, Stack size unknown bytes, libinit2.o(.ARM.Collect$$libinit$$00000011))

__rt_lib_init_lc_ctype_1 (Thumb, 0 bytes, Stack size unknown bytes, libinit2.o(.ARM.Collect$$libinit$$00000013))

__rt_lib_init_lc_monetary_1 (Thumb, 0 bytes, Stack size unknown bytes, libinit2.o(.ARM.Collect$$libinit$$00000015))

__rt_lib_init_lc_numeric_1 (Thumb, 0 bytes, Stack size unknown bytes, libinit2.o(.ARM.Collect$$libinit$$00000017))

__rt_lib_init_lc_time_1 (Thumb, 0 bytes, Stack size unknown bytes, libinit2.o(.ARM.Collect$$libinit$$00000019))

__rt_lib_init_preinit_1 (Thumb, 0 bytes, Stack size unknown bytes, libinit2.o(.ARM.Collect$$libinit$$00000004))

__rt_lib_init_rand_1 (Thumb, 0 bytes, Stack size unknown bytes, libinit2.o(.ARM.Collect$$libinit$$0000000E))

__rt_lib_init_return (Thumb, 0 bytes, Stack size unknown bytes, libinit2.o(.ARM.Collect$$libinit$$00000033))

__rt_lib_init_signal_1 (Thumb, 0 bytes, Stack size unknown bytes, libinit2.o(.ARM.Collect$$libinit$$0000001D))

__rt_lib_init_stdio_1 (Thumb, 0 bytes, Stack size unknown bytes, libinit2.o(.ARM.Collect$$libinit$$00000025))

__rt_lib_init_user_alloc_1 (Thumb, 0 bytes, Stack size unknown bytes, libinit2.o(.ARM.Collect$$libinit$$0000000C))

__rt_lib_shutdown (Thumb, 0 bytes, Stack size unknown bytes, libshutdown.o(.ARM.Collect$$libshutdown$$00000000))

[Called By]

- >> __rt_exit_ls

__rt_lib_shutdown_cpp_1 (Thumb, 0 bytes, Stack size unknown bytes, libshutdown2.o(.ARM.Collect$$libshutdown$$00000002))

__rt_lib_shutdown_fp_trap_1 (Thumb, 0 bytes, Stack size unknown bytes, libshutdown2.o(.ARM.Collect$$libshutdown$$00000007))

__rt_lib_shutdown_heap_1 (Thumb, 0 bytes, Stack size unknown bytes, libshutdown2.o(.ARM.Collect$$libshutdown$$0000000F))

__rt_lib_shutdown_return (Thumb, 0 bytes, Stack size unknown bytes, libshutdown2.o(.ARM.Collect$$libshutdown$$00000010))

__rt_lib_shutdown_signal_1 (Thumb, 0 bytes, Stack size unknown bytes, libshutdown2.o(.ARM.Collect$$libshutdown$$0000000A))

__rt_lib_shutdown_stdio_1 (Thumb, 0 bytes, Stack size unknown bytes, libshutdown2.o(.ARM.Collect$$libshutdown$$00000004))

__rt_lib_shutdown_user_alloc_1 (Thumb, 0 bytes, Stack size unknown bytes, libshutdown2.o(.ARM.Collect$$libshutdown$$0000000C))

__rt_entry (Thumb, 0 bytes, Stack size unknown bytes, __rtentry.o(.ARM.Collect$$rtentry$$00000000))

[Called By]

- >> __scatterload_rt2
- >> __main

__rt_entry_presh_1 (Thumb, 0 bytes, Stack size unknown bytes, __rtentry2.o(.ARM.Collect$$rtentry$$00000002))

__rt_entry_sh (Thumb, 0 bytes, Stack size unknown bytes, __rtentry4.o(.ARM.Collect$$rtentry$$00000004))

[Stack]

- Max Depth = 8 + Unknown Stack Size
- Call Chain = __rt_entry_sh ⇒ __user_setup_stackheap

[Calls]

- >> __user_setup_stackheap

__rt_entry_li (Thumb, 0 bytes, Stack size unknown bytes, __rtentry2.o(.ARM.Collect$$rtentry$$0000000A))

[Calls]

- >> __rt_lib_init

__rt_entry_postsh_1 (Thumb, 0 bytes, Stack size unknown bytes, __rtentry2.o(.ARM.Collect$$rtentry$$00000009))

__rt_entry_main (Thumb, 0 bytes, Stack size unknown bytes, __rtentry2.o(.ARM.Collect$$rtentry$$0000000D))

[Stack]

- Max Depth = 244 + Unknown Stack Size
- Call Chain = __rt_entry_main ⇒ main ⇒ MX_ADC1_Init ⇒ HAL_ADC_Init ⇒ HAL_ADC_MspInit ⇒ HAL_GPIO_Init

[Calls]

- >> main
- >> exit

__rt_entry_postli_1 (Thumb, 0 bytes, Stack size unknown bytes, __rtentry2.o(.ARM.Collect$$rtentry$$0000000C))

__rt_exit (Thumb, 0 bytes, Stack size unknown bytes, rtexit.o(.ARM.Collect$$rtexit$$00000000))

[Called By]

- >> exit

__rt_exit_ls (Thumb, 0 bytes, Stack size unknown bytes, rtexit2.o(.ARM.Collect$$rtexit$$00000003))

[Calls]

- >> __rt_lib_shutdown

__rt_exit_prels_1 (Thumb, 0 bytes, Stack size unknown bytes, rtexit2.o(.ARM.Collect$$rtexit$$00000002))

__rt_exit_exit (Thumb, 0 bytes, Stack size unknown bytes, rtexit2.o(.ARM.Collect$$rtexit$$00000004))

[Calls]

- >> _sys_exit

Reset_Handler (Thumb, 8 bytes, Stack size 0 bytes, startup_stm32g474xx.o(.text))
[Address Reference Count : 1]

- startup_stm32g474xx.o(RESET)

ADC1_2_IRQHandler (Thumb, 0 bytes, Stack size 0 bytes, startup_stm32g474xx.o(.text))

[Calls]

- >> ADC1_2_IRQHandler

[Called By]

- >> ADC1_2_IRQHandler

[Address Reference Count : 1]

- startup_stm32g474xx.o(RESET)

ADC3_IRQHandler (Thumb, 0 bytes, Stack size 0 bytes, startup_stm32g474xx.o(.text))
[Address Reference Count : 1]

- startup_stm32g474xx.o(RESET)

ADC4_IRQHandler (Thumb, 0 bytes, Stack size 0 bytes, startup_stm32g474xx.o(.text))
[Address Reference Count : 1]

- startup_stm32g474xx.o(RESET)

ADC5_IRQHandler (Thumb, 0 bytes, Stack size 0 bytes, startup_stm32g474xx.o(.text))
[Address Reference Count : 1]

- startup_stm32g474xx.o(RESET)

COMP1_2_3_IRQHandler (Thumb, 0 bytes, Stack size 0 bytes, startup_stm32g474xx.o(.text))
[Address Reference Count : 1]

- startup_stm32g474xx.o(RESET)

COMP4_5_6_IRQHandler (Thumb, 0 bytes, Stack size 0 bytes, startup_stm32g474xx.o(.text))
[Address Reference Count : 1]

- startup_stm32g474xx.o(RESET)

COMP7_IRQHandler (Thumb, 0 bytes, Stack size 0 bytes, startup_stm32g474xx.o(.text))
[Address Reference Count : 1]

- startup_stm32g474xx.o(RESET)

CORDIC_IRQHandler (Thumb, 0 bytes, Stack size 0 bytes, startup_stm32g474xx.o(.text))
[Address Reference Count : 1]

- startup_stm32g474xx.o(RESET)

CRS_IRQHandler (Thumb, 0 bytes, Stack size 0 bytes, startup_stm32g474xx.o(.text))
[Address Reference Count : 1]

- startup_stm32g474xx.o(RESET)

DMA1_Channel3_IRQHandler (Thumb, 0 bytes, Stack size 0 bytes, startup_stm32g474xx.o(.text))
[Address Reference Count : 1]

- startup_stm32g474xx.o(RESET)

DMA1_Channel4_IRQHandler (Thumb, 0 bytes, Stack size 0 bytes, startup_stm32g474xx.o(.text))
[Address Reference Count : 1]

- startup_stm32g474xx.o(RESET)

DMA1_Channel5_IRQHandler (Thumb, 0 bytes, Stack size 0 bytes, startup_stm32g474xx.o(.text))
[Address Reference Count : 1]

- startup_stm32g474xx.o(RESET)

DMA1_Channel6_IRQHandler (Thumb, 0 bytes, Stack size 0 bytes, startup_stm32g474xx.o(.text))
[Address Reference Count : 1]

- startup_stm32g474xx.o(RESET)

DMA1_Channel7_IRQHandler (Thumb, 0 bytes, Stack size 0 bytes, startup_stm32g474xx.o(.text))
[Address Reference Count : 1]

- startup_stm32g474xx.o(RESET)

DMA1_Channel8_IRQHandler (Thumb, 0 bytes, Stack size 0 bytes, startup_stm32g474xx.o(.text))
[Address Reference Count : 1]

- startup_stm32g474xx.o(RESET)

DMA2_Channel1_IRQHandler (Thumb, 0 bytes, Stack size 0 bytes, startup_stm32g474xx.o(.text))
[Address Reference Count : 1]

- startup_stm32g474xx.o(RESET)

DMA2_Channel2_IRQHandler (Thumb, 0 bytes, Stack size 0 bytes, startup_stm32g474xx.o(.text))
[Address Reference Count : 1]

- startup_stm32g474xx.o(RESET)

DMA2_Channel3_IRQHandler (Thumb, 0 bytes, Stack size 0 bytes, startup_stm32g474xx.o(.text))
[Address Reference Count : 1]

- startup_stm32g474xx.o(RESET)

DMA2_Channel4_IRQHandler (Thumb, 0 bytes, Stack size 0 bytes, startup_stm32g474xx.o(.text))
[Address Reference Count : 1]

- startup_stm32g474xx.o(RESET)

DMA2_Channel5_IRQHandler (Thumb, 0 bytes, Stack size 0 bytes, startup_stm32g474xx.o(.text))
[Address Reference Count : 1]

- startup_stm32g474xx.o(RESET)

DMA2_Channel6_IRQHandler (Thumb, 0 bytes, Stack size 0 bytes, startup_stm32g474xx.o(.text))
[Address Reference Count : 1]

- startup_stm32g474xx.o(RESET)

DMA2_Channel7_IRQHandler (Thumb, 0 bytes, Stack size 0 bytes, startup_stm32g474xx.o(.text))
[Address Reference Count : 1]

- startup_stm32g474xx.o(RESET)

DMA2_Channel8_IRQHandler (Thumb, 0 bytes, Stack size 0 bytes, startup_stm32g474xx.o(.text))
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

- startup_stm32g474xx.o(RESET)

UCPD1_IRQHandler (Thumb, 0 bytes, Stack size 0 bytes, startup_stm32g474xx.o(.text))
[Address Reference Count : 1]

- startup_stm32g474xx.o(RESET)

USART1_IRQHandler (Thumb, 0 bytes, Stack size 0 bytes, startup_stm32g474xx.o(.text))
[Address Reference Count : 1]

- startup_stm32g474xx.o(RESET)

USART2_IRQHandler (Thumb, 0 bytes, Stack size 0 bytes, startup_stm32g474xx.o(.text))
[Address Reference Count : 1]

- startup_stm32g474xx.o(RESET)

USART3_IRQHandler (Thumb, 0 bytes, Stack size 0 bytes, startup_stm32g474xx.o(.text))
[Address Reference Count : 1]

- startup_stm32g474xx.o(RESET)

USBWakeUp_IRQHandler (Thumb, 0 bytes, Stack size 0 bytes, startup_stm32g474xx.o(.text))
[Address Reference Count : 1]

- startup_stm32g474xx.o(RESET)

USB_HP_IRQHandler (Thumb, 0 bytes, Stack size 0 bytes, startup_stm32g474xx.o(.text))
[Address Reference Count : 1]

- startup_stm32g474xx.o(RESET)

WWDG_IRQHandler (Thumb, 0 bytes, Stack size 0 bytes, startup_stm32g474xx.o(.text))
[Address Reference Count : 1]

- startup_stm32g474xx.o(RESET)

__user_initial_stackheap (Thumb, 0 bytes, Stack size unknown bytes, startup_stm32g474xx.o(.text))

[Called By]

- >> __user_setup_stackheap

__aeabi_uldivmod (Thumb, 0 bytes, Stack size 48 bytes, lludivv7m.o(.text))

[Stack]

- Max Depth = 48
- Call Chain = __aeabi_uldivmod

[Called By]

- >> UART_SetConfig

_ll_udiv (Thumb, 240 bytes, Stack size 48 bytes, lludivv7m.o(.text), UNUSED)

__2sprintf (Thumb, 34 bytes, Stack size 32 bytes, noretval__2sprintf.o(.text))

[Stack]

- Max Depth = 120 + Unknown Stack Size
- Call Chain = __2sprintf ⇒ _printf_char_common ⇒ __printf

[Calls]

- >> _sputc
- >> _printf_char_common

[Called By]

- >> GTP_Init
- >> GTP911_Test

__printf (Thumb, 104 bytes, Stack size 24 bytes, __printf.o(.text))

[Stack]

- Max Depth = 24 + Unknown Stack Size
- Call Chain = __printf

[Calls]

- >> _printf_percent

[Called By]

- >> _printf_char_common

_printf_str (Thumb, 82 bytes, Stack size 16 bytes, _printf_str.o(.text))

[Stack]

- Max Depth = 16
- Call Chain = _printf_str

[Called By]

- >> _printf_cs_common

_printf_int_dec (Thumb, 104 bytes, Stack size 24 bytes, _printf_dec.o(.text))

[Stack]

- Max Depth = 56
- Call Chain = _printf_int_dec ⇒ _printf_int_common

[Calls]

- >> _printf_int_common

[Called By]

- >> _printf_d

_printf_int_hex (Thumb, 84 bytes, Stack size 16 bytes, _printf_hex_int.o(.text))

[Stack]

- Max Depth = 48
- Call Chain = _printf_int_hex ⇒ _printf_int_common

[Calls]

- >> _printf_int_common

[Called By]

- >> _printf_x

_printf_longlong_hex (Thumb, 0 bytes, Stack size 16 bytes, _printf_hex_int.o(.text), UNUSED)

strlen (Thumb, 62 bytes, Stack size 8 bytes, strlen.o(.text))

[Stack]

- Max Depth = 8
- Call Chain = strlen

[Called By]

- >> main
- >> GTP_Init
- >> GTP911_Test

__aeabi_memcpy (Thumb, 0 bytes, Stack size 0 bytes, rt_memcpy_v6.o(.text))

[Called By]

- >> main

__rt_memcpy (Thumb, 138 bytes, Stack size 0 bytes, rt_memcpy_v6.o(.text), UNUSED)

[Calls]

- >> __aeabi_memcpy4

_memcpy_lastbytes (Thumb, 0 bytes, Stack size unknown bytes, rt_memcpy_v6.o(.text), UNUSED)

__aeabi_memset4 (Thumb, 16 bytes, Stack size 0 bytes, aeabi_memset4.o(.text))

[Calls]

- >> _memset_w

[Called By]

- >> ST7789_Fill_Color

__aeabi_memset8 (Thumb, 0 bytes, Stack size 0 bytes, aeabi_memset4.o(.text), UNUSED)

__aeabi_memclr4 (Thumb, 0 bytes, Stack size 4 bytes, rt_memclr_w.o(.text))

[Stack]

- Max Depth = 4
- Call Chain = __aeabi_memclr4

[Called By]

- >> HAL_I2C_MspInit
- >> HAL_ADC_MspInit
- >> SystemClock_Config
- >> ST7789_Init
- >> MX_I2C3_Init
- >> MX_ADC1_Init
- >> HAL_SPI_MspInit
- >> HAL_UART_MspInit
- >> HAL_PCD_MspInit

__aeabi_memclr8 (Thumb, 0 bytes, Stack size 4 bytes, rt_memclr_w.o(.text), UNUSED)

__rt_memclr_w (Thumb, 78 bytes, Stack size 4 bytes, rt_memclr_w.o(.text), UNUSED)

_memset_w (Thumb, 0 bytes, Stack size unknown bytes, rt_memclr_w.o(.text))

[Called By]

- >> __aeabi_memset4

__use_two_region_memory (Thumb, 2 bytes, Stack size 0 bytes, heapauxi.o(.text), UNUSED)

__rt_heap_escrow$2region (Thumb, 2 bytes, Stack size 0 bytes, heapauxi.o(.text), UNUSED)

__rt_heap_expand$2region (Thumb, 2 bytes, Stack size 0 bytes, heapauxi.o(.text), UNUSED)

_printf_int_common (Thumb, 178 bytes, Stack size 32 bytes, _printf_intcommon.o(.text))

[Stack]

- Max Depth = 32
- Call Chain = _printf_int_common

[Called By]

- >> _printf_int_hex
- >> _printf_int_dec

_printf_char_common (Thumb, 32 bytes, Stack size 64 bytes, _printf_char_common.o(.text))

[Stack]

- Max Depth = 88 + Unknown Stack Size
- Call Chain = _printf_char_common ⇒ __printf

[Calls]

- >> __printf

[Called By]

- >> __2sprintf

_sputc (Thumb, 10 bytes, Stack size 0 bytes, _sputc.o(.text))

[Called By]

- >> __2sprintf

[Address Reference Count : 1]

- noretval__2sprintf.o(.text)

_printf_cs_common (Thumb, 20 bytes, Stack size 8 bytes, _printf_char.o(.text))

[Stack]

- Max Depth = 24
- Call Chain = _printf_cs_common ⇒ _printf_str

[Calls]

- >> _printf_str

[Called By]

- >> _printf_string
- >> _printf_char

_printf_char (Thumb, 16 bytes, Stack size 0 bytes, _printf_char.o(.text), UNUSED)

[Calls]

- >> _printf_cs_common

_printf_string (Thumb, 8 bytes, Stack size 0 bytes, _printf_char.o(.text))

[Stack]

- Max Depth = 24
- Call Chain = _printf_string ⇒ _printf_cs_common ⇒ _printf_str

[Calls]

- >> _printf_cs_common

[Called By]

- >> _printf_s

__aeabi_memcpy4 (Thumb, 0 bytes, Stack size 8 bytes, rt_memcpy_w.o(.text), UNUSED)

[Called By]

- >> __rt_memcpy

__aeabi_memcpy8 (Thumb, 0 bytes, Stack size 8 bytes, rt_memcpy_w.o(.text), UNUSED)

__rt_memcpy_w (Thumb, 100 bytes, Stack size 8 bytes, rt_memcpy_w.o(.text), UNUSED)

_memcpy_lastbytes_aligned (Thumb, 0 bytes, Stack size unknown bytes, rt_memcpy_w.o(.text), UNUSED)

__user_setup_stackheap (Thumb, 74 bytes, Stack size 8 bytes, sys_stackheap_outer.o(.text))

[Stack]

- Max Depth = 8 + Unknown Stack Size
- Call Chain = __user_setup_stackheap

[Calls]

- >> __user_initial_stackheap
- >> __user_perproc_libspace

[Called By]

- >> __rt_entry_sh

exit (Thumb, 18 bytes, Stack size 8 bytes, exit.o(.text))

[Stack]

- Max Depth = 8 + Unknown Stack Size
- Call Chain = exit

[Calls]

- >> __rt_exit

[Called By]

- >> __rt_entry_main

__user_libspace (Thumb, 8 bytes, Stack size 0 bytes, libspace.o(.text), UNUSED)

__user_perproc_libspace (Thumb, 0 bytes, Stack size 0 bytes, libspace.o(.text))

[Called By]

- >> __user_setup_stackheap

__user_perthread_libspace (Thumb, 0 bytes, Stack size 0 bytes, libspace.o(.text), UNUSED)

_sys_exit (Thumb, 8 bytes, Stack size 0 bytes, sys_exit.o(.text))

[Called By]

- >> __rt_exit_exit

__I$use$semihosting (Thumb, 0 bytes, Stack size 0 bytes, use_no_semi.o(.text), UNUSED)

__use_no_semihosting_swi (Thumb, 2 bytes, Stack size 0 bytes, use_no_semi.o(.text), UNUSED)

BusFault_Handler (Thumb, 2 bytes, Stack size 0 bytes, stm32g4xx_it.o(.text.BusFault_Handler))

[Calls]

- >> BusFault_Handler

[Called By]

- >> BusFault_Handler

[Address Reference Count : 1]

- startup_stm32g474xx.o(RESET)

__semihosting_library_function (Thumb, 0 bytes, Stack size 0 bytes, indicate_semi.o(.text), UNUSED)

CDC_Transmit_FS (Thumb, 44 bytes, Stack size 8 bytes, usbd_cdc_if.o(.text.CDC_Transmit_FS))

[Stack]

- Max Depth = 64
- Call Chain = CDC_Transmit_FS ⇒ USBD_CDC_TransmitPacket ⇒ USBD_LL_Transmit ⇒ HAL_PCD_EP_Transmit ⇒ USB_EPStartXfer

[Calls]

- >> USBD_CDC_TransmitPacket
- >> USBD_CDC_SetTxBuffer

[Called By]

- >> main
- >> GTP_Init
- >> GTP911_Test

DMA1_Channel1_IRQHandler (Thumb, 12 bytes, Stack size 0 bytes, stm32g4xx_it.o(.text.DMA1_Channel1_IRQHandler))

[Stack]

- Max Depth = 20
- Call Chain = DMA1_Channel1_IRQHandler ⇒ HAL_DMA_IRQHandler

[Calls]

- >> HAL_DMA_IRQHandler

[Address Reference Count : 1]

- startup_stm32g474xx.o(RESET)

DMA1_Channel2_IRQHandler (Thumb, 12 bytes, Stack size 0 bytes, stm32g4xx_it.o(.text.DMA1_Channel2_IRQHandler))

[Stack]

- Max Depth = 20
- Call Chain = DMA1_Channel2_IRQHandler ⇒ HAL_DMA_IRQHandler

[Calls]

- >> HAL_DMA_IRQHandler

[Address Reference Count : 1]

- startup_stm32g474xx.o(RESET)

DebugMon_Handler (Thumb, 2 bytes, Stack size 0 bytes, stm32g4xx_it.o(.text.DebugMon_Handler))
[Address Reference Count : 1]

- startup_stm32g474xx.o(RESET)

Error_Handler (Thumb, 8 bytes, Stack size 0 bytes, main.o(.text.Error_Handler))

[Called By]

- >> HAL_I2C_MspInit
- >> HAL_ADC_MspInit
- >> MX_USB_Device_Init
- >> MX_SPI1_Init
- >> MX_LPUART1_UART_Init
- >> MX_I2C3_Init
- >> MX_ADC1_Init
- >> HAL_SPI_MspInit
- >> HAL_UART_MspInit
- >> USBD_LL_Init
- >> HAL_PCD_ResetCallback
- >> HAL_PCD_MspInit

GTP911_Test (Thumb, 172 bytes, Stack size 40 bytes, gt911.o(.text.GTP911_Test))

[Stack]

- Max Depth = 200 + Unknown Stack Size
- Call Chain = GTP911_Test ⇒ GTXXXX_Scanf ⇒ GTXXXX_WriteReg ⇒ HAL_I2C_Mem_Write ⇒ I2C_WaitOnFlagUntilTimeout ⇒ I2C_IsErrorOccurred

[Calls]

- >> CDC_Transmit_FS
- >> GTXXXX_Scanf
- >> strlen
- >> __2sprintf

[Called By]

- >> main

GTP_Init (Thumb, 264 bytes, Stack size 56 bytes, gt911.o(.text.GTP_Init))

[Stack]

- Max Depth = 176 + Unknown Stack Size
- Call Chain = GTP_Init ⇒ GTXXXX_WriteReg ⇒ HAL_I2C_Mem_Write ⇒ I2C_WaitOnFlagUntilTimeout ⇒ I2C_IsErrorOccurred

[Calls]

- >> HAL_GPIO_Init
- >> CDC_Transmit_FS
- >> GTXXXX_WriteReg
- >> GTXXXX_ReadReg
- >> strlen
- >> __2sprintf

[Called By]

- >> main

GTXXXX_ReadReg (Thumb, 28 bytes, Stack size 24 bytes, gt911.o(.text.GTXXXX_ReadReg))

[Stack]

- Max Depth = 120
- Call Chain = GTXXXX_ReadReg ⇒ HAL_I2C_Mem_Read ⇒ I2C_WaitOnFlagUntilTimeout ⇒ I2C_IsErrorOccurred

[Calls]

- >> HAL_I2C_Mem_Read

[Called By]

- >> GTP_Init
- >> GTXXXX_Scanf

[Address Reference Count : 1]

- gt911.o(.text.GTXXXX_Scanf)

GTXXXX_Scanf (Thumb, 288 bytes, Stack size 40 bytes, gt911.o(.text.GTXXXX_Scanf))

[Stack]

- Max Depth = 160
- Call Chain = GTXXXX_Scanf ⇒ GTXXXX_WriteReg ⇒ HAL_I2C_Mem_Write ⇒ I2C_WaitOnFlagUntilTimeout ⇒ I2C_IsErrorOccurred

[Calls]

- >> GTXXXX_WriteReg
- >> GTXXXX_ReadReg

[Called By]

- >> GTP911_Test

GTXXXX_WriteReg (Thumb, 32 bytes, Stack size 24 bytes, gt911.o(.text.GTXXXX_WriteReg))

[Stack]

- Max Depth = 120
- Call Chain = GTXXXX_WriteReg ⇒ HAL_I2C_Mem_Write ⇒ I2C_WaitOnFlagUntilTimeout ⇒ I2C_IsErrorOccurred

[Calls]

- >> HAL_I2C_Mem_Write

[Called By]

- >> GTP_Init
- >> GTXXXX_Scanf

HAL_ADCEx_MultiModeConfigChannel (Thumb, 248 bytes, Stack size 28 bytes, stm32g4xx_hal_adc_ex.o(.text.HAL_ADCEx_MultiModeConfigChannel))

[Stack]

- Max Depth = 28
- Call Chain = HAL_ADCEx_MultiModeConfigChannel

[Called By]

- >> MX_ADC1_Init

HAL_ADC_ConfigChannel (Thumb, 892 bytes, Stack size 24 bytes, stm32g4xx_hal_adc.o(.text.HAL_ADC_ConfigChannel))

[Stack]

- Max Depth = 32
- Call Chain = HAL_ADC_ConfigChannel ⇒ LL_ADC_SetChannelSamplingTime

[Calls]

- >> LL_ADC_SetChannelSamplingTime

[Called By]

- >> MX_ADC1_Init

HAL_ADC_Init (Thumb, 496 bytes, Stack size 24 bytes, stm32g4xx_hal_adc.o(.text.HAL_ADC_Init))

[Stack]

- Max Depth = 188
- Call Chain = HAL_ADC_Init ⇒ HAL_ADC_MspInit ⇒ HAL_GPIO_Init

[Calls]

- >> HAL_ADC_MspInit

[Called By]

- >> MX_ADC1_Init

HAL_ADC_MspInit (Thumb, 128 bytes, Stack size 120 bytes, adc.o(.text.HAL_ADC_MspInit))

[Stack]

- Max Depth = 164
- Call Chain = HAL_ADC_MspInit ⇒ HAL_GPIO_Init

[Calls]

- >> HAL_RCCEx_PeriphCLKConfig
- >> HAL_GPIO_Init
- >> Error_Handler
- >> __aeabi_memclr4

[Called By]

- >> HAL_ADC_Init

HAL_DMA_Abort_IT (Thumb, 118 bytes, Stack size 16 bytes, stm32g4xx_hal_dma.o(.text.HAL_DMA_Abort_IT))

[Stack]

- Max Depth = 16
- Call Chain = HAL_DMA_Abort_IT

[Called By]

- >> HAL_SPI_IRQHandler

HAL_DMA_IRQHandler (Thumb, 148 bytes, Stack size 20 bytes, stm32g4xx_hal_dma.o(.text.HAL_DMA_IRQHandler))

[Stack]

- Max Depth = 20
- Call Chain = HAL_DMA_IRQHandler

[Called By]

- >> DMA1_Channel2_IRQHandler
- >> DMA1_Channel1_IRQHandler

HAL_DMA_Init (Thumb, 184 bytes, Stack size 24 bytes, stm32g4xx_hal_dma.o(.text.HAL_DMA_Init))

[Stack]

- Max Depth = 32
- Call Chain = HAL_DMA_Init ⇒ DMA_CalcDMAMUXRequestGenBaseAndMask

[Calls]

- >> DMA_CalcDMAMUXRequestGenBaseAndMask
- >> DMA_CalcDMAMUXChannelBaseAndMask

[Called By]

- >> HAL_SPI_MspInit
- >> HAL_UART_MspInit

HAL_DMA_Start_IT (Thumb, 130 bytes, Stack size 16 bytes, stm32g4xx_hal_dma.o(.text.HAL_DMA_Start_IT))

[Stack]

- Max Depth = 36
- Call Chain = HAL_DMA_Start_IT ⇒ DMA_SetConfig

[Calls]

- >> DMA_SetConfig

[Called By]

- >> HAL_SPI_Transmit_DMA

HAL_Delay (Thumb, 36 bytes, Stack size 16 bytes, stm32g4xx_hal.o(.text.HAL_Delay))

[Stack]

- Max Depth = 16
- Call Chain = HAL_Delay

[Calls]

- >> HAL_GetTick

[Address Reference Count : 2]

- st7789.o(.text.ST7789_Init)
- gt911.o(.text.GTP_Init)

HAL_GPIO_Init (Thumb, 412 bytes, Stack size 44 bytes, stm32g4xx_hal_gpio.o(.text.HAL_GPIO_Init))

[Stack]

- Max Depth = 44
- Call Chain = HAL_GPIO_Init

[Called By]

- >> HAL_I2C_MspInit
- >> HAL_ADC_MspInit
- >> GTP_Init
- >> HAL_SPI_MspInit
- >> HAL_UART_MspInit

[Address Reference Count : 1]

- gpio.o(.text.MX_GPIO_Init)

HAL_GPIO_TogglePin (Thumb, 16 bytes, Stack size 0 bytes, stm32g4xx_hal_gpio.o(.text.HAL_GPIO_TogglePin))

[Called By]

- >> main

HAL_GPIO_WritePin (Thumb, 12 bytes, Stack size 0 bytes, stm32g4xx_hal_gpio.o(.text.HAL_GPIO_WritePin))

[Called By]

- >> ST7789_Init
- >> ST7789_WriteSmallData
- >> ST7789_WriteData
- >> ST7789_WriteCommand

[Address Reference Count : 2]

- gpio.o(.text.MX_GPIO_Init)
- gt911.o(.text.GTP_Init)

HAL_GetTick (Thumb, 12 bytes, Stack size 0 bytes, stm32g4xx_hal.o(.text.HAL_GetTick))

[Called By]

- >> HAL_RCCEx_PeriphCLKConfig
- >> HAL_RCC_OscConfig
- >> HAL_RCC_ClockConfig
- >> HAL_Delay
- >> UART_WaitOnFlagUntilTimeout
- >> UART_CheckIdleState
- >> HAL_I2C_Mem_Write
- >> HAL_I2C_Mem_Read
- >> I2C_WaitOnTXISFlagUntilTimeout
- >> I2C_WaitOnSTOPFlagUntilTimeout
- >> I2C_WaitOnFlagUntilTimeout
- >> I2C_IsErrorOccurred
- >> HAL_SPI_Transmit
- >> SPI_WaitFlagStateUntilTimeout
- >> SPI_WaitFifoStateUntilTimeout
- >> SPI_DMATransmitCplt

HAL_I2CEx_ConfigAnalogFilter (Thumb, 74 bytes, Stack size 0 bytes, stm32g4xx_hal_i2c_ex.o(.text.HAL_I2CEx_ConfigAnalogFilter))

[Called By]

- >> MX_I2C3_Init

HAL_I2CEx_ConfigDigitalFilter (Thumb, 72 bytes, Stack size 0 bytes, stm32g4xx_hal_i2c_ex.o(.text.HAL_I2CEx_ConfigDigitalFilter))

[Called By]

- >> MX_I2C3_Init

HAL_I2C_Init (Thumb, 176 bytes, Stack size 16 bytes, stm32g4xx_hal_i2c.o(.text.HAL_I2C_Init))

[Stack]

- Max Depth = 188
- Call Chain = HAL_I2C_Init ⇒ HAL_I2C_MspInit ⇒ HAL_GPIO_Init

[Calls]

- >> HAL_I2C_MspInit

[Called By]

- >> MX_I2C3_Init

HAL_I2C_Mem_Read (Thumb, 448 bytes, Stack size 40 bytes, stm32g4xx_hal_i2c.o(.text.HAL_I2C_Mem_Read))

[Stack]

- Max Depth = 96
- Call Chain = HAL_I2C_Mem_Read ⇒ I2C_WaitOnFlagUntilTimeout ⇒ I2C_IsErrorOccurred

[Calls]

- >> HAL_GetTick
- >> I2C_WaitOnTXISFlagUntilTimeout
- >> I2C_WaitOnSTOPFlagUntilTimeout
- >> I2C_WaitOnFlagUntilTimeout
- >> I2C_TransferConfig

[Called By]

- >> GTXXXX_ReadReg

HAL_I2C_Mem_Write (Thumb, 436 bytes, Stack size 40 bytes, stm32g4xx_hal_i2c.o(.text.HAL_I2C_Mem_Write))

[Stack]

- Max Depth = 96
- Call Chain = HAL_I2C_Mem_Write ⇒ I2C_WaitOnFlagUntilTimeout ⇒ I2C_IsErrorOccurred

[Calls]

- >> HAL_GetTick
- >> I2C_WaitOnTXISFlagUntilTimeout
- >> I2C_WaitOnSTOPFlagUntilTimeout
- >> I2C_WaitOnFlagUntilTimeout
- >> I2C_TransferConfig

[Called By]

- >> GTXXXX_WriteReg

HAL_I2C_MspInit (Thumb, 136 bytes, Stack size 128 bytes, i2c.o(.text.HAL_I2C_MspInit))

[Stack]

- Max Depth = 172
- Call Chain = HAL_I2C_MspInit ⇒ HAL_GPIO_Init

[Calls]

- >> HAL_RCCEx_PeriphCLKConfig
- >> HAL_GPIO_Init
- >> Error_Handler
- >> __aeabi_memclr4

[Called By]

- >> HAL_I2C_Init

HAL_IncTick (Thumb, 20 bytes, Stack size 0 bytes, stm32g4xx_hal.o(.text.HAL_IncTick))

[Called By]

- >> SysTick_Handler

HAL_Init (Thumb, 28 bytes, Stack size 8 bytes, stm32g4xx_hal.o(.text.HAL_Init))

[Stack]

- Max Depth = 48
- Call Chain = HAL_Init ⇒ HAL_InitTick ⇒ HAL_NVIC_SetPriority ⇒ __NVIC_SetPriority

[Calls]

- >> HAL_MspInit
- >> HAL_NVIC_SetPriorityGrouping
- >> HAL_InitTick

[Called By]

- >> main

HAL_InitTick (Thumb, 72 bytes, Stack size 16 bytes, stm32g4xx_hal.o(.text.HAL_InitTick))

[Stack]

- Max Depth = 40
- Call Chain = HAL_InitTick ⇒ HAL_NVIC_SetPriority ⇒ __NVIC_SetPriority

[Calls]

- >> HAL_NVIC_SetPriority
- >> HAL_SYSTICK_Config

[Called By]

- >> HAL_RCC_OscConfig
- >> HAL_RCC_ClockConfig
- >> HAL_Init

HAL_MspInit (Thumb, 52 bytes, Stack size 8 bytes, stm32g4xx_hal_msp.o(.text.HAL_MspInit))

[Stack]

- Max Depth = 8
- Call Chain = HAL_MspInit

[Calls]

- >> HAL_PWREx_DisableUCPDDeadBattery

[Called By]

- >> HAL_Init

HAL_NVIC_EnableIRQ (Thumb, 28 bytes, Stack size 0 bytes, stm32g4xx_hal_cortex.o(.text.HAL_NVIC_EnableIRQ))

[Called By]

- >> MX_DMA_Init
- >> HAL_SPI_MspInit
- >> HAL_PCD_MspInit

HAL_NVIC_SetPriority (Thumb, 56 bytes, Stack size 16 bytes, stm32g4xx_hal_cortex.o(.text.HAL_NVIC_SetPriority))

[Stack]

- Max Depth = 24
- Call Chain = HAL_NVIC_SetPriority ⇒ __NVIC_SetPriority

[Calls]

- >> __NVIC_SetPriority

[Called By]

- >> MX_DMA_Init
- >> HAL_SPI_MspInit
- >> HAL_InitTick
- >> HAL_PCD_MspInit

HAL_NVIC_SetPriorityGrouping (Thumb, 32 bytes, Stack size 0 bytes, stm32g4xx_hal_cortex.o(.text.HAL_NVIC_SetPriorityGrouping))

[Called By]

- >> HAL_Init

HAL_PCDEx_ActivateLPM (Thumb, 42 bytes, Stack size 0 bytes, stm32g4xx_hal_pcd_ex.o(.text.HAL_PCDEx_ActivateLPM))

[Called By]

- >> HAL_PCD_Init

HAL_PCDEx_LPM_Callback (Thumb, 68 bytes, Stack size 8 bytes, usbd_conf.o(.text.HAL_PCDEx_LPM_Callback))

[Stack]

- Max Depth = 176
- Call Chain = HAL_PCDEx_LPM_Callback ⇒ SystemClock_Config ⇒ HAL_RCC_OscConfig ⇒ HAL_InitTick ⇒ HAL_NVIC_SetPriority ⇒ __NVIC_SetPriority

[Calls]

- >> SystemClock_Config
- >> USBD_LL_Suspend
- >> USBD_LL_Resume

[Called By]

- >> HAL_PCD_IRQHandler

HAL_PCDEx_PMAConfig (Thumb, 58 bytes, Stack size 16 bytes, stm32g4xx_hal_pcd_ex.o(.text.HAL_PCDEx_PMAConfig))

[Stack]

- Max Depth = 16
- Call Chain = HAL_PCDEx_PMAConfig

[Address Reference Count : 1]

- usbd_conf.o(.text.USBD_LL_Init)

HAL_PCD_DataInStageCallback (Thumb, 18 bytes, Stack size 0 bytes, usbd_conf.o(.text.HAL_PCD_DataInStageCallback))

[Stack]

- Max Depth = 72
- Call Chain = HAL_PCD_DataInStageCallback ⇒ USBD_LL_DataInStage ⇒ USBD_CtlReceiveStatus ⇒ USBD_LL_PrepareReceive ⇒ HAL_PCD_EP_Receive ⇒ USB_EPStartXfer

[Calls]

- >> USBD_LL_DataInStage

[Called By]

- >> HAL_PCD_IRQHandler

HAL_PCD_DataOutStageCallback (Thumb, 20 bytes, Stack size 0 bytes, usbd_conf.o(.text.HAL_PCD_DataOutStageCallback))

[Stack]

- Max Depth = 64
- Call Chain = HAL_PCD_DataOutStageCallback ⇒ USBD_LL_DataOutStage ⇒ USBD_CtlSendStatus ⇒ USBD_LL_Transmit ⇒ HAL_PCD_EP_Transmit ⇒ USB_EPStartXfer

[Calls]

- >> USBD_LL_DataOutStage

[Called By]

- >> HAL_PCD_IRQHandler

HAL_PCD_EP_Close (Thumb, 72 bytes, Stack size 8 bytes, stm32g4xx_hal_pcd.o(.text.HAL_PCD_EP_Close))

[Stack]

- Max Depth = 24
- Call Chain = HAL_PCD_EP_Close ⇒ USB_DeactivateEndpoint

[Calls]

- >> USB_DeactivateEndpoint

[Called By]

- >> USBD_LL_CloseEP

HAL_PCD_EP_ClrStall (Thumb, 92 bytes, Stack size 16 bytes, stm32g4xx_hal_pcd.o(.text.HAL_PCD_EP_ClrStall))

[Stack]

- Max Depth = 32
- Call Chain = HAL_PCD_EP_ClrStall ⇒ USB_EPClearStall

[Calls]

- >> USB_EPClearStall

[Called By]

- >> USBD_LL_ClearStallEP

HAL_PCD_EP_GetRxCount (Thumb, 18 bytes, Stack size 0 bytes, stm32g4xx_hal_pcd.o(.text.HAL_PCD_EP_GetRxCount))

[Called By]

- >> USBD_LL_GetRxDataSize

HAL_PCD_EP_Open (Thumb, 84 bytes, Stack size 16 bytes, stm32g4xx_hal_pcd.o(.text.HAL_PCD_EP_Open))

[Stack]

- Max Depth = 48
- Call Chain = HAL_PCD_EP_Open ⇒ USB_ActivateEndpoint

[Calls]

- >> USB_ActivateEndpoint

[Called By]

- >> USBD_LL_OpenEP

HAL_PCD_EP_Receive (Thumb, 44 bytes, Stack size 16 bytes, stm32g4xx_hal_pcd.o(.text.HAL_PCD_EP_Receive))

[Stack]

- Max Depth = 40
- Call Chain = HAL_PCD_EP_Receive ⇒ USB_EPStartXfer

[Calls]

- >> USB_EPStartXfer

[Called By]

- >> USBD_LL_PrepareReceive

HAL_PCD_EP_SetStall (Thumb, 92 bytes, Stack size 8 bytes, stm32g4xx_hal_pcd.o(.text.HAL_PCD_EP_SetStall))

[Stack]

- Max Depth = 16
- Call Chain = HAL_PCD_EP_SetStall ⇒ USB_EPSetStall

[Calls]

- >> USB_EPSetStall

[Called By]

- >> USBD_LL_StallEP

HAL_PCD_EP_Transmit (Thumb, 46 bytes, Stack size 16 bytes, stm32g4xx_hal_pcd.o(.text.HAL_PCD_EP_Transmit))

[Stack]

- Max Depth = 40
- Call Chain = HAL_PCD_EP_Transmit ⇒ USB_EPStartXfer

[Calls]

- >> USB_EPStartXfer

[Called By]

- >> USBD_LL_Transmit

HAL_PCD_IRQHandler (Thumb, 2232 bytes, Stack size 40 bytes, stm32g4xx_hal_pcd.o(.text.HAL_PCD_IRQHandler))

[Stack]

- Max Depth = 216
- Call Chain = HAL_PCD_IRQHandler ⇒ HAL_PCD_ResumeCallback ⇒ SystemClock_Config ⇒ HAL_RCC_OscConfig ⇒ HAL_InitTick ⇒ HAL_NVIC_SetPriority ⇒ __NVIC_SetPriority

[Calls]

- >> USB_WritePMA
- >> USB_ReadPMA
- >> USB_ReadInterrupts
- >> USB_EPStartXfer
- >> HAL_PCD_SetAddress
- >> HAL_PCD_SuspendCallback
- >> HAL_PCD_SetupStageCallback
- >> HAL_PCD_SOFCallback
- >> HAL_PCD_ResumeCallback
- >> HAL_PCD_ResetCallback
- >> HAL_PCD_DataOutStageCallback
- >> HAL_PCD_DataInStageCallback
- >> HAL_PCDEx_LPM_Callback

[Called By]

- >> USB_LP_IRQHandler

HAL_PCD_Init (Thumb, 146 bytes, Stack size 24 bytes, stm32g4xx_hal_pcd.o(.text.HAL_PCD_Init))

[Stack]

- Max Depth = 152
- Call Chain = HAL_PCD_Init ⇒ HAL_PCD_MspInit ⇒ HAL_RCCEx_PeriphCLKConfig

[Calls]

- >> USB_DisableGlobalInt
- >> USB_DevInit
- >> HAL_PCDEx_ActivateLPM
- >> HAL_PCD_MspInit

[Called By]

- >> USBD_LL_Init

HAL_PCD_MspInit (Thumb, 92 bytes, Stack size 96 bytes, usbd_conf.o(.text.HAL_PCD_MspInit))

[Stack]

- Max Depth = 128
- Call Chain = HAL_PCD_MspInit ⇒ HAL_RCCEx_PeriphCLKConfig

[Calls]

- >> HAL_NVIC_SetPriority
- >> HAL_NVIC_EnableIRQ
- >> HAL_RCCEx_PeriphCLKConfig
- >> Error_Handler
- >> __aeabi_memclr4

[Called By]

- >> HAL_PCD_Init

HAL_PCD_ResetCallback (Thumb, 36 bytes, Stack size 8 bytes, usbd_conf.o(.text.HAL_PCD_ResetCallback))

[Stack]

- Max Depth = 88
- Call Chain = HAL_PCD_ResetCallback ⇒ USBD_LL_Reset ⇒ USBD_LL_OpenEP ⇒ HAL_PCD_EP_Open ⇒ USB_ActivateEndpoint

[Calls]

- >> Error_Handler
- >> USBD_LL_SetSpeed
- >> USBD_LL_Reset

[Called By]

- >> HAL_PCD_IRQHandler

HAL_PCD_ResumeCallback (Thumb, 36 bytes, Stack size 8 bytes, usbd_conf.o(.text.HAL_PCD_ResumeCallback))

[Stack]

- Max Depth = 176
- Call Chain = HAL_PCD_ResumeCallback ⇒ SystemClock_Config ⇒ HAL_RCC_OscConfig ⇒ HAL_InitTick ⇒ HAL_NVIC_SetPriority ⇒ __NVIC_SetPriority

[Calls]

- >> SystemClock_Config
- >> USBD_LL_Resume

[Called By]

- >> HAL_PCD_IRQHandler

HAL_PCD_SOFCallback (Thumb, 8 bytes, Stack size 0 bytes, usbd_conf.o(.text.HAL_PCD_SOFCallback))

[Stack]

- Max Depth = 8
- Call Chain = HAL_PCD_SOFCallback ⇒ USBD_LL_SOF

[Calls]

- >> USBD_LL_SOF

[Called By]

- >> HAL_PCD_IRQHandler

HAL_PCD_SetAddress (Thumb, 38 bytes, Stack size 8 bytes, stm32g4xx_hal_pcd.o(.text.HAL_PCD_SetAddress))

[Stack]

- Max Depth = 8
- Call Chain = HAL_PCD_SetAddress

[Calls]

- >> USB_SetDevAddress

[Called By]

- >> HAL_PCD_IRQHandler
- >> USBD_LL_SetUSBAddress

HAL_PCD_SetupStageCallback (Thumb, 14 bytes, Stack size 0 bytes, usbd_conf.o(.text.HAL_PCD_SetupStageCallback))

[Stack]

- Max Depth = 96
- Call Chain = HAL_PCD_SetupStageCallback ⇒ USBD_LL_SetupStage ⇒ USBD_StdDevReq ⇒ USBD_CtlSendData ⇒ USBD_LL_Transmit ⇒ HAL_PCD_EP_Transmit ⇒ USB_EPStartXfer

[Calls]

- >> USBD_LL_SetupStage

[Called By]

- >> HAL_PCD_IRQHandler

HAL_PCD_Start (Thumb, 42 bytes, Stack size 8 bytes, stm32g4xx_hal_pcd.o(.text.HAL_PCD_Start))

[Stack]

- Max Depth = 8
- Call Chain = HAL_PCD_Start

[Calls]

- >> USB_EnableGlobalInt
- >> USB_DevConnect

[Called By]

- >> USBD_LL_Start

HAL_PCD_SuspendCallback (Thumb, 32 bytes, Stack size 8 bytes, usbd_conf.o(.text.HAL_PCD_SuspendCallback))

[Stack]

- Max Depth = 8
- Call Chain = HAL_PCD_SuspendCallback

[Calls]

- >> USBD_LL_Suspend

[Called By]

- >> HAL_PCD_IRQHandler

HAL_PWREx_ControlVoltageScaling (Thumb, 180 bytes, Stack size 0 bytes, stm32g4xx_hal_pwr_ex.o(.text.HAL_PWREx_ControlVoltageScaling))

[Called By]

- >> SystemClock_Config

HAL_PWREx_DisableUCPDDeadBattery (Thumb, 16 bytes, Stack size 0 bytes, stm32g4xx_hal_pwr_ex.o(.text.HAL_PWREx_DisableUCPDDeadBattery))

[Called By]

- >> HAL_MspInit

HAL_RCCEx_PeriphCLKConfig (Thumb, 664 bytes, Stack size 32 bytes, stm32g4xx_hal_rcc_ex.o(.text.HAL_RCCEx_PeriphCLKConfig))

[Stack]

- Max Depth = 32
- Call Chain = HAL_RCCEx_PeriphCLKConfig

[Calls]

- >> HAL_GetTick

[Called By]

- >> HAL_I2C_MspInit
- >> HAL_ADC_MspInit
- >> HAL_UART_MspInit
- >> HAL_PCD_MspInit

HAL_RCC_ClockConfig (Thumb, 484 bytes, Stack size 32 bytes, stm32g4xx_hal_rcc.o(.text.HAL_RCC_ClockConfig))

[Stack]

- Max Depth = 72
- Call Chain = HAL_RCC_ClockConfig ⇒ HAL_InitTick ⇒ HAL_NVIC_SetPriority ⇒ __NVIC_SetPriority

[Calls]

- >> HAL_RCC_GetSysClockFreq
- >> HAL_InitTick
- >> HAL_GetTick

[Called By]

- >> SystemClock_Config

HAL_RCC_GetPCLK1Freq (Thumb, 24 bytes, Stack size 0 bytes, stm32g4xx_hal_rcc.o(.text.HAL_RCC_GetPCLK1Freq))

[Called By]

- >> UART_SetConfig

HAL_RCC_GetPCLK2Freq (Thumb, 32 bytes, Stack size 0 bytes, stm32g4xx_hal_rcc.o(.text.HAL_RCC_GetPCLK2Freq))

[Called By]

- >> UART_SetConfig

HAL_RCC_GetSysClockFreq (Thumb, 104 bytes, Stack size 0 bytes, stm32g4xx_hal_rcc.o(.text.HAL_RCC_GetSysClockFreq))

[Called By]

- >> HAL_RCC_ClockConfig
- >> UART_SetConfig

HAL_RCC_OscConfig (Thumb, 1116 bytes, Stack size 32 bytes, stm32g4xx_hal_rcc.o(.text.HAL_RCC_OscConfig))

[Stack]

- Max Depth = 72
- Call Chain = HAL_RCC_OscConfig ⇒ HAL_InitTick ⇒ HAL_NVIC_SetPriority ⇒ __NVIC_SetPriority

[Calls]

- >> HAL_InitTick
- >> HAL_GetTick

[Called By]

- >> SystemClock_Config

HAL_SPI_ErrorCallback (Thumb, 2 bytes, Stack size 0 bytes, stm32g4xx_hal_spi.o(.text.HAL_SPI_ErrorCallback))

[Called By]

- >> HAL_SPI_IRQHandler
- >> SPI_DMATransmitCplt
- >> SPI_DMAError
- >> SPI_DMAAbortOnError

HAL_SPI_IRQHandler (Thumb, 264 bytes, Stack size 16 bytes, stm32g4xx_hal_spi.o(.text.HAL_SPI_IRQHandler))

[Stack]

- Max Depth = 32
- Call Chain = HAL_SPI_IRQHandler ⇒ HAL_DMA_Abort_IT

[Calls]

- >> HAL_DMA_Abort_IT
- >> HAL_SPI_ErrorCallback

[Called By]

- >> SPI1_IRQHandler

HAL_SPI_Init (Thumb, 218 bytes, Stack size 24 bytes, stm32g4xx_hal_spi.o(.text.HAL_SPI_Init))

[Stack]

- Max Depth = 108
- Call Chain = HAL_SPI_Init ⇒ HAL_SPI_MspInit ⇒ HAL_GPIO_Init

[Calls]

- >> HAL_SPI_MspInit

[Called By]

- >> MX_SPI1_Init

HAL_SPI_MspInit (Thumb, 176 bytes, Stack size 40 bytes, spi.o(.text.HAL_SPI_MspInit))

[Stack]

- Max Depth = 84
- Call Chain = HAL_SPI_MspInit ⇒ HAL_GPIO_Init

[Calls]

- >> HAL_NVIC_SetPriority
- >> HAL_NVIC_EnableIRQ
- >> HAL_GPIO_Init
- >> Error_Handler
- >> HAL_DMA_Init
- >> __aeabi_memclr4

[Called By]

- >> HAL_SPI_Init

HAL_SPI_Transmit (Thumb, 414 bytes, Stack size 32 bytes, stm32g4xx_hal_spi.o(.text.HAL_SPI_Transmit))

[Stack]

- Max Depth = 88
- Call Chain = HAL_SPI_Transmit ⇒ SPI_EndRxTxTransaction ⇒ SPI_WaitFifoStateUntilTimeout

[Calls]

- >> HAL_GetTick
- >> SPI_EndRxTxTransaction

[Called By]

- >> ST7789_WriteSmallData
- >> ST7789_WriteData
- >> ST7789_WriteCommand

HAL_SPI_Transmit_DMA (Thumb, 256 bytes, Stack size 24 bytes, stm32g4xx_hal_spi.o(.text.HAL_SPI_Transmit_DMA))

[Stack]

- Max Depth = 60
- Call Chain = HAL_SPI_Transmit_DMA ⇒ HAL_DMA_Start_IT ⇒ DMA_SetConfig

[Calls]

- >> HAL_DMA_Start_IT

[Called By]

- >> ST7789_WriteData

HAL_SPI_TxCpltCallback (Thumb, 2 bytes, Stack size 0 bytes, stm32g4xx_hal_spi.o(.text.HAL_SPI_TxCpltCallback))

[Called By]

- >> SPI_DMATransmitCplt

HAL_SPI_TxHalfCpltCallback (Thumb, 2 bytes, Stack size 0 bytes, stm32g4xx_hal_spi.o(.text.HAL_SPI_TxHalfCpltCallback))

[Called By]

- >> SPI_DMAHalfTransmitCplt

HAL_SYSTICK_Config (Thumb, 40 bytes, Stack size 0 bytes, stm32g4xx_hal_cortex.o(.text.HAL_SYSTICK_Config))

[Called By]

- >> HAL_InitTick

HAL_UARTEx_DisableFifoMode (Thumb, 54 bytes, Stack size 0 bytes, stm32g4xx_hal_uart_ex.o(.text.HAL_UARTEx_DisableFifoMode))

[Called By]

- >> MX_LPUART1_UART_Init

HAL_UARTEx_SetRxFifoThreshold (Thumb, 74 bytes, Stack size 16 bytes, stm32g4xx_hal_uart_ex.o(.text.HAL_UARTEx_SetRxFifoThreshold))

[Stack]

- Max Depth = 32
- Call Chain = HAL_UARTEx_SetRxFifoThreshold ⇒ UARTEx_SetNbDataToProcess

[Calls]

- >> UARTEx_SetNbDataToProcess

[Called By]

- >> MX_LPUART1_UART_Init

HAL_UARTEx_SetTxFifoThreshold (Thumb, 74 bytes, Stack size 16 bytes, stm32g4xx_hal_uart_ex.o(.text.HAL_UARTEx_SetTxFifoThreshold))

[Stack]

- Max Depth = 32
- Call Chain = HAL_UARTEx_SetTxFifoThreshold ⇒ UARTEx_SetNbDataToProcess

[Calls]

- >> UARTEx_SetNbDataToProcess

[Called By]

- >> MX_LPUART1_UART_Init

HAL_UART_Init (Thumb, 100 bytes, Stack size 8 bytes, stm32g4xx_hal_uart.o(.text.HAL_UART_Init))

[Stack]

- Max Depth = 180
- Call Chain = HAL_UART_Init ⇒ HAL_UART_MspInit ⇒ HAL_GPIO_Init

[Calls]

- >> HAL_UART_MspInit
- >> UART_SetConfig
- >> UART_CheckIdleState
- >> UART_AdvFeatureConfig

[Called By]

- >> MX_LPUART1_UART_Init

HAL_UART_MspInit (Thumb, 184 bytes, Stack size 128 bytes, usart.o(.text.HAL_UART_MspInit))

[Stack]

- Max Depth = 172
- Call Chain = HAL_UART_MspInit ⇒ HAL_GPIO_Init

[Calls]

- >> HAL_RCCEx_PeriphCLKConfig
- >> HAL_GPIO_Init
- >> Error_Handler
- >> HAL_DMA_Init
- >> __aeabi_memclr4

[Called By]

- >> HAL_UART_Init

HardFault_Handler (Thumb, 2 bytes, Stack size 0 bytes, stm32g4xx_it.o(.text.HardFault_Handler))

[Calls]

- >> HardFault_Handler

[Called By]

- >> HardFault_Handler

[Address Reference Count : 1]

- startup_stm32g474xx.o(RESET)

MX_ADC1_Init (Thumb, 144 bytes, Stack size 56 bytes, adc.o(.text.MX_ADC1_Init))

[Stack]

- Max Depth = 244
- Call Chain = MX_ADC1_Init ⇒ HAL_ADC_Init ⇒ HAL_ADC_MspInit ⇒ HAL_GPIO_Init

[Calls]

- >> HAL_ADC_Init
- >> HAL_ADC_ConfigChannel
- >> HAL_ADCEx_MultiModeConfigChannel
- >> Error_Handler
- >> __aeabi_memclr4

[Called By]

- >> main

MX_DMA_Init (Thumb, 80 bytes, Stack size 16 bytes, dma.o(.text.MX_DMA_Init))

[Stack]

- Max Depth = 40
- Call Chain = MX_DMA_Init ⇒ HAL_NVIC_SetPriority ⇒ __NVIC_SetPriority

[Calls]

- >> HAL_NVIC_SetPriority
- >> HAL_NVIC_EnableIRQ

[Called By]

- >> main

MX_GPIO_Init (Thumb, 244 bytes, Stack size 64 bytes, gpio.o(.text.MX_GPIO_Init))

[Stack]

- Max Depth = 64
- Call Chain = MX_GPIO_Init

[Called By]

- >> main

MX_I2C3_Init (Thumb, 88 bytes, Stack size 8 bytes, i2c.o(.text.MX_I2C3_Init))

[Stack]

- Max Depth = 196
- Call Chain = MX_I2C3_Init ⇒ HAL_I2C_Init ⇒ HAL_I2C_MspInit ⇒ HAL_GPIO_Init

[Calls]

- >> HAL_I2C_Init
- >> HAL_I2CEx_ConfigDigitalFilter
- >> HAL_I2CEx_ConfigAnalogFilter
- >> Error_Handler
- >> __aeabi_memclr4

[Called By]

- >> main

MX_LPUART1_UART_Init (Thumb, 100 bytes, Stack size 8 bytes, usart.o(.text.MX_LPUART1_UART_Init))

[Stack]

- Max Depth = 188
- Call Chain = MX_LPUART1_UART_Init ⇒ HAL_UART_Init ⇒ HAL_UART_MspInit ⇒ HAL_GPIO_Init

[Calls]

- >> Error_Handler
- >> HAL_UART_Init
- >> HAL_UARTEx_SetTxFifoThreshold
- >> HAL_UARTEx_SetRxFifoThreshold
- >> HAL_UARTEx_DisableFifoMode

[Called By]

- >> main

MX_SPI1_Init (Thumb, 76 bytes, Stack size 24 bytes, spi.o(.text.MX_SPI1_Init))

[Stack]

- Max Depth = 132
- Call Chain = MX_SPI1_Init ⇒ HAL_SPI_Init ⇒ HAL_SPI_MspInit ⇒ HAL_GPIO_Init

[Calls]

- >> Error_Handler
- >> HAL_SPI_Init

[Called By]

- >> main

MX_USB_Device_Init (Thumb, 80 bytes, Stack size 8 bytes, usb_device.o(.text.MX_USB_Device_Init))

[Stack]

- Max Depth = 176
- Call Chain = MX_USB_Device_Init ⇒ USBD_Init ⇒ USBD_LL_Init ⇒ HAL_PCD_Init ⇒ HAL_PCD_MspInit ⇒ HAL_RCCEx_PeriphCLKConfig

[Calls]

- >> Error_Handler
- >> USBD_Start
- >> USBD_RegisterClass
- >> USBD_Init
- >> USBD_CDC_RegisterInterface

[Called By]

- >> main

MemManage_Handler (Thumb, 2 bytes, Stack size 0 bytes, stm32g4xx_it.o(.text.MemManage_Handler))

[Calls]

- >> MemManage_Handler

[Called By]

- >> MemManage_Handler

[Address Reference Count : 1]

- startup_stm32g474xx.o(RESET)

NMI_Handler (Thumb, 2 bytes, Stack size 0 bytes, stm32g4xx_it.o(.text.NMI_Handler))

[Calls]

- >> NMI_Handler

[Called By]

- >> NMI_Handler

[Address Reference Count : 1]

- startup_stm32g474xx.o(RESET)

PendSV_Handler (Thumb, 2 bytes, Stack size 0 bytes, stm32g4xx_it.o(.text.PendSV_Handler))
[Address Reference Count : 1]

- startup_stm32g474xx.o(RESET)

SPI1_IRQHandler (Thumb, 12 bytes, Stack size 0 bytes, stm32g4xx_it.o(.text.SPI1_IRQHandler))

[Stack]

- Max Depth = 32
- Call Chain = SPI1_IRQHandler ⇒ HAL_SPI_IRQHandler ⇒ HAL_DMA_Abort_IT

[Calls]

- >> HAL_SPI_IRQHandler

[Address Reference Count : 1]

- startup_stm32g474xx.o(RESET)

ST7789_DrawPixel_4px (Thumb, 40 bytes, Stack size 16 bytes, st7789.o(.text.ST7789_DrawPixel_4px))

[Stack]

- Max Depth = 208
- Call Chain = ST7789_DrawPixel_4px ⇒ ST7789_Fill ⇒ ST7789_SetAddressWindow ⇒ ST7789_WriteData ⇒ HAL_SPI_Transmit ⇒ SPI_EndRxTxTransaction ⇒ SPI_WaitFifoStateUntilTimeout

[Calls]

- >> ST7789_Fill

[Called By]

- >> main

ST7789_Fill (Thumb, 88 bytes, Stack size 40 bytes, st7789.o(.text.ST7789_Fill))

[Stack]

- Max Depth = 192
- Call Chain = ST7789_Fill ⇒ ST7789_SetAddressWindow ⇒ ST7789_WriteData ⇒ HAL_SPI_Transmit ⇒ SPI_EndRxTxTransaction ⇒ SPI_WaitFifoStateUntilTimeout

[Calls]

- >> ST7789_WriteData
- >> ST7789_SetAddressWindow

[Called By]

- >> ST7789_DrawPixel_4px

ST7789_Fill_Color (Thumb, 56 bytes, Stack size 16 bytes, st7789.o(.text.ST7789_Fill_Color))

[Stack]

- Max Depth = 168 + Unknown Stack Size
- Call Chain = ST7789_Fill_Color ⇒ ST7789_SetAddressWindow ⇒ ST7789_WriteData ⇒ HAL_SPI_Transmit ⇒ SPI_EndRxTxTransaction ⇒ SPI_WaitFifoStateUntilTimeout

[Calls]

- >> ST7789_WriteData
- >> ST7789_SetAddressWindow
- >> __aeabi_memset4

[Called By]

- >> disp_clear
- >> ST7789_Init

ST7789_Init (Thumb, 308 bytes, Stack size 40 bytes, st7789.o(.text.ST7789_Init))

[Stack]

- Max Depth = 208 + Unknown Stack Size
- Call Chain = ST7789_Init ⇒ ST7789_Fill_Color ⇒ ST7789_SetAddressWindow ⇒ ST7789_WriteData ⇒ HAL_SPI_Transmit ⇒ SPI_EndRxTxTransaction ⇒ SPI_WaitFifoStateUntilTimeout

[Calls]

- >> HAL_GPIO_WritePin
- >> ST7789_Fill_Color
- >> ST7789_SetRotation
- >> __aeabi_memclr4

[Called By]

- >> main

ST7789_SetRotation (Thumb, 40 bytes, Stack size 8 bytes, st7789.o(.text.ST7789_SetRotation))

[Stack]

- Max Depth = 112
- Call Chain = ST7789_SetRotation ⇒ ST7789_WriteSmallData ⇒ HAL_SPI_Transmit ⇒ SPI_EndRxTxTransaction ⇒ SPI_WaitFifoStateUntilTimeout

[Calls]

- >> ST7789_WriteSmallData
- >> ST7789_WriteCommand

[Called By]

- >> ST7789_Init

ST7789_WriteChar (Thumb, 148 bytes, Stack size 56 bytes, st7789.o(.text.ST7789_WriteChar))

[Stack]

- Max Depth = 208
- Call Chain = ST7789_WriteChar ⇒ ST7789_SetAddressWindow ⇒ ST7789_WriteData ⇒ HAL_SPI_Transmit ⇒ SPI_EndRxTxTransaction ⇒ SPI_WaitFifoStateUntilTimeout

[Calls]

- >> ST7789_WriteData
- >> ST7789_SetAddressWindow

[Called By]

- >> ST7789_WriteString

ST7789_WriteString (Thumb, 78 bytes, Stack size 48 bytes, st7789.o(.text.ST7789_WriteString))

[Stack]

- Max Depth = 256
- Call Chain = ST7789_WriteString ⇒ ST7789_WriteChar ⇒ ST7789_SetAddressWindow ⇒ ST7789_WriteData ⇒ HAL_SPI_Transmit ⇒ SPI_EndRxTxTransaction ⇒ SPI_WaitFifoStateUntilTimeout

[Calls]

- >> ST7789_WriteChar

[Address Reference Count : 1]

- main.o(.text.disp_clear)

SVC_Handler (Thumb, 2 bytes, Stack size 0 bytes, stm32g4xx_it.o(.text.SVC_Handler))
[Address Reference Count : 1]

- startup_stm32g474xx.o(RESET)

SysTick_Handler (Thumb, 4 bytes, Stack size 0 bytes, stm32g4xx_it.o(.text.SysTick_Handler))

[Calls]

- >> HAL_IncTick

[Address Reference Count : 1]

- startup_stm32g474xx.o(RESET)

SystemClock_Config (Thumb, 114 bytes, Stack size 96 bytes, main.o(.text.SystemClock_Config))

[Stack]

- Max Depth = 168
- Call Chain = SystemClock_Config ⇒ HAL_RCC_OscConfig ⇒ HAL_InitTick ⇒ HAL_NVIC_SetPriority ⇒ __NVIC_SetPriority

[Calls]

- >> HAL_RCC_OscConfig
- >> HAL_RCC_ClockConfig
- >> HAL_PWREx_ControlVoltageScaling
- >> __aeabi_memclr4

[Called By]

- >> main
- >> HAL_PCD_ResumeCallback
- >> HAL_PCDEx_LPM_Callback

SystemInit (Thumb, 16 bytes, Stack size 0 bytes, system_stm32g4xx.o(.text.SystemInit))
[Address Reference Count : 1]

- startup_stm32g474xx.o(.text)

UART_AdvFeatureConfig (Thumb, 170 bytes, Stack size 8 bytes, stm32g4xx_hal_uart.o(.text.UART_AdvFeatureConfig))

[Stack]

- Max Depth = 8
- Call Chain = UART_AdvFeatureConfig

[Called By]

- >> HAL_UART_Init

UART_CheckIdleState (Thumb, 178 bytes, Stack size 24 bytes, stm32g4xx_hal_uart.o(.text.UART_CheckIdleState))

[Stack]

- Max Depth = 64
- Call Chain = UART_CheckIdleState ⇒ UART_WaitOnFlagUntilTimeout ⇒ UART_EndRxTransfer

[Calls]

- >> HAL_GetTick
- >> UART_WaitOnFlagUntilTimeout

[Called By]

- >> HAL_UART_Init

UART_SetConfig (Thumb, 552 bytes, Stack size 16 bytes, stm32g4xx_hal_uart.o(.text.UART_SetConfig))

[Stack]

- Max Depth = 64
- Call Chain = UART_SetConfig ⇒ __aeabi_uldivmod

[Calls]

- >> HAL_RCC_GetSysClockFreq
- >> HAL_RCC_GetPCLK2Freq
- >> HAL_RCC_GetPCLK1Freq
- >> __aeabi_uldivmod

[Called By]

- >> HAL_UART_Init

UART_WaitOnFlagUntilTimeout (Thumb, 154 bytes, Stack size 32 bytes, stm32g4xx_hal_uart.o(.text.UART_WaitOnFlagUntilTimeout))

[Stack]

- Max Depth = 40
- Call Chain = UART_WaitOnFlagUntilTimeout ⇒ UART_EndRxTransfer

[Calls]

- >> HAL_GetTick
- >> UART_EndRxTransfer

[Called By]

- >> UART_CheckIdleState

USBD_CDC_ConfigStrDescriptor (Thumb, 32 bytes, Stack size 8 bytes, usbd_desc.o(.text.USBD_CDC_ConfigStrDescriptor))

[Stack]

- Max Depth = 24
- Call Chain = USBD_CDC_ConfigStrDescriptor ⇒ USBD_GetString

[Calls]

- >> USBD_GetString

[Address Reference Count : 1]

- usbd_desc.o(.data.CDC_Desc)

USBD_CDC_DeviceDescriptor (Thumb, 12 bytes, Stack size 0 bytes, usbd_desc.o(.text.USBD_CDC_DeviceDescriptor))
[Address Reference Count : 1]

- usbd_desc.o(.data.CDC_Desc)

USBD_CDC_GetDeviceQualifierDescriptor (Thumb, 12 bytes, Stack size 0 bytes, usbd_cdc.o(.text.USBD_CDC_GetDeviceQualifierDescriptor))
[Address Reference Count : 1]

- usbd_cdc.o(.data.USBD_CDC)

USBD_CDC_InterfaceStrDescriptor (Thumb, 36 bytes, Stack size 8 bytes, usbd_desc.o(.text.USBD_CDC_InterfaceStrDescriptor))

[Stack]

- Max Depth = 24
- Call Chain = USBD_CDC_InterfaceStrDescriptor ⇒ USBD_GetString

[Calls]

- >> USBD_GetString

[Address Reference Count : 1]

- usbd_desc.o(.data.CDC_Desc)

USBD_CDC_LangIDStrDescriptor (Thumb, 12 bytes, Stack size 0 bytes, usbd_desc.o(.text.USBD_CDC_LangIDStrDescriptor))
[Address Reference Count : 1]

- usbd_desc.o(.data.CDC_Desc)

USBD_CDC_ManufacturerStrDescriptor (Thumb, 32 bytes, Stack size 8 bytes, usbd_desc.o(.text.USBD_CDC_ManufacturerStrDescriptor))

[Stack]

- Max Depth = 24
- Call Chain = USBD_CDC_ManufacturerStrDescriptor ⇒ USBD_GetString

[Calls]

- >> USBD_GetString

[Address Reference Count : 1]

- usbd_desc.o(.data.CDC_Desc)

USBD_CDC_ProductStrDescriptor (Thumb, 48 bytes, Stack size 8 bytes, usbd_desc.o(.text.USBD_CDC_ProductStrDescriptor))

[Stack]

- Max Depth = 24
- Call Chain = USBD_CDC_ProductStrDescriptor ⇒ USBD_GetString

[Calls]

- >> USBD_GetString

[Address Reference Count : 1]

- usbd_desc.o(.data.CDC_Desc)

USBD_CDC_ReceivePacket (Thumb, 38 bytes, Stack size 8 bytes, usbd_cdc.o(.text.USBD_CDC_ReceivePacket))

[Stack]

- Max Depth = 56
- Call Chain = USBD_CDC_ReceivePacket ⇒ USBD_LL_PrepareReceive ⇒ HAL_PCD_EP_Receive ⇒ USB_EPStartXfer

[Calls]

- >> USBD_LL_PrepareReceive

[Called By]

- >> CDC_Receive_FS

USBD_CDC_RegisterInterface (Thumb, 14 bytes, Stack size 0 bytes, usbd_cdc.o(.text.USBD_CDC_RegisterInterface))

[Called By]

- >> MX_USB_Device_Init

USBD_CDC_SerialStrDescriptor (Thumb, 52 bytes, Stack size 16 bytes, usbd_desc.o(.text.USBD_CDC_SerialStrDescriptor))

[Stack]

- Max Depth = 36
- Call Chain = USBD_CDC_SerialStrDescriptor ⇒ IntToUnicode

[Calls]

- >> IntToUnicode

[Address Reference Count : 1]

- usbd_desc.o(.data.CDC_Desc)

USBD_CDC_SetRxBuffer (Thumb, 18 bytes, Stack size 0 bytes, usbd_cdc.o(.text.USBD_CDC_SetRxBuffer))

[Called By]

- >> CDC_Receive_FS
- >> CDC_Init_FS

USBD_CDC_SetTxBuffer (Thumb, 22 bytes, Stack size 0 bytes, usbd_cdc.o(.text.USBD_CDC_SetTxBuffer))

[Called By]

- >> CDC_Transmit_FS
- >> CDC_Init_FS

USBD_CDC_TransmitPacket (Thumb, 46 bytes, Stack size 8 bytes, usbd_cdc.o(.text.USBD_CDC_TransmitPacket))

[Stack]

- Max Depth = 56
- Call Chain = USBD_CDC_TransmitPacket ⇒ USBD_LL_Transmit ⇒ HAL_PCD_EP_Transmit ⇒ USB_EPStartXfer

[Calls]

- >> USBD_LL_Transmit

[Called By]

- >> CDC_Transmit_FS

USBD_ClrClassConfig (Thumb, 16 bytes, Stack size 8 bytes, usbd_core.o(.text.USBD_ClrClassConfig))

[Stack]

- Max Depth = 8
- Call Chain = USBD_ClrClassConfig

[Called By]

- >> USBD_StdDevReq

USBD_CtlContinueRx (Thumb, 16 bytes, Stack size 8 bytes, usbd_ioreq.o(.text.USBD_CtlContinueRx))

[Stack]

- Max Depth = 56
- Call Chain = USBD_CtlContinueRx ⇒ USBD_LL_PrepareReceive ⇒ HAL_PCD_EP_Receive ⇒ USB_EPStartXfer

[Calls]

- >> USBD_LL_PrepareReceive

[Called By]

- >> USBD_LL_DataOutStage

USBD_CtlContinueSendData (Thumb, 16 bytes, Stack size 8 bytes, usbd_ioreq.o(.text.USBD_CtlContinueSendData))

[Stack]

- Max Depth = 56
- Call Chain = USBD_CtlContinueSendData ⇒ USBD_LL_Transmit ⇒ HAL_PCD_EP_Transmit ⇒ USB_EPStartXfer

[Calls]

- >> USBD_LL_Transmit

[Called By]

- >> USBD_LL_DataInStage

USBD_CtlError (Thumb, 22 bytes, Stack size 8 bytes, usbd_ctlreq.o(.text.USBD_CtlError))

[Stack]

- Max Depth = 32
- Call Chain = USBD_CtlError ⇒ USBD_LL_StallEP ⇒ HAL_PCD_EP_SetStall ⇒ USB_EPSetStall

[Calls]

- >> USBD_LL_StallEP

[Called By]

- >> USBD_StdItfReq
- >> USBD_StdEPReq
- >> USBD_StdDevReq
- >> USBD_CDC_Setup

USBD_CtlPrepareRx (Thumb, 26 bytes, Stack size 8 bytes, usbd_ioreq.o(.text.USBD_CtlPrepareRx))

[Stack]

- Max Depth = 56
- Call Chain = USBD_CtlPrepareRx ⇒ USBD_LL_PrepareReceive ⇒ HAL_PCD_EP_Receive ⇒ USB_EPStartXfer

[Calls]

- >> USBD_LL_PrepareReceive

[Called By]

- >> USBD_CDC_Setup

USBD_CtlReceiveStatus (Thumb, 22 bytes, Stack size 8 bytes, usbd_ioreq.o(.text.USBD_CtlReceiveStatus))

[Stack]

- Max Depth = 56
- Call Chain = USBD_CtlReceiveStatus ⇒ USBD_LL_PrepareReceive ⇒ HAL_PCD_EP_Receive ⇒ USB_EPStartXfer

[Calls]

- >> USBD_LL_PrepareReceive

[Called By]

- >> USBD_LL_DataInStage

USBD_CtlSendData (Thumb, 26 bytes, Stack size 8 bytes, usbd_ioreq.o(.text.USBD_CtlSendData))

[Stack]

- Max Depth = 56
- Call Chain = USBD_CtlSendData ⇒ USBD_LL_Transmit ⇒ HAL_PCD_EP_Transmit ⇒ USB_EPStartXfer

[Calls]

- >> USBD_LL_Transmit

[Called By]

- >> USBD_StdEPReq
- >> USBD_StdDevReq
- >> USBD_CDC_Setup

USBD_CtlSendStatus (Thumb, 22 bytes, Stack size 8 bytes, usbd_ioreq.o(.text.USBD_CtlSendStatus))

[Stack]

- Max Depth = 56
- Call Chain = USBD_CtlSendStatus ⇒ USBD_LL_Transmit ⇒ HAL_PCD_EP_Transmit ⇒ USB_EPStartXfer

[Calls]

- >> USBD_LL_Transmit

[Called By]

- >> USBD_StdItfReq
- >> USBD_StdEPReq
- >> USBD_StdDevReq
- >> USBD_LL_DataOutStage

USBD_GetString (Thumb, 58 bytes, Stack size 16 bytes, usbd_ctlreq.o(.text.USBD_GetString))

[Stack]

- Max Depth = 16
- Call Chain = USBD_GetString

[Called By]

- >> USBD_CDC_ProductStrDescriptor
- >> USBD_CDC_ManufacturerStrDescriptor
- >> USBD_CDC_InterfaceStrDescriptor
- >> USBD_CDC_ConfigStrDescriptor

USBD_Init (Thumb, 38 bytes, Stack size 0 bytes, usbd_core.o(.text.USBD_Init))

[Stack]

- Max Depth = 168
- Call Chain = USBD_Init ⇒ USBD_LL_Init ⇒ HAL_PCD_Init ⇒ HAL_PCD_MspInit ⇒ HAL_RCCEx_PeriphCLKConfig

[Calls]

- >> USBD_LL_Init

[Called By]

- >> MX_USB_Device_Init

USBD_LL_ClearStallEP (Thumb, 18 bytes, Stack size 8 bytes, usbd_conf.o(.text.USBD_LL_ClearStallEP))

[Stack]

- Max Depth = 40
- Call Chain = USBD_LL_ClearStallEP ⇒ HAL_PCD_EP_ClrStall ⇒ USB_EPClearStall

[Calls]

- >> HAL_PCD_EP_ClrStall
- >> USBD_Get_USB_Status

[Called By]

- >> USBD_StdEPReq

USBD_LL_CloseEP (Thumb, 18 bytes, Stack size 8 bytes, usbd_conf.o(.text.USBD_LL_CloseEP))

[Stack]

- Max Depth = 32
- Call Chain = USBD_LL_CloseEP ⇒ HAL_PCD_EP_Close ⇒ USB_DeactivateEndpoint

[Calls]

- >> HAL_PCD_EP_Close
- >> USBD_Get_USB_Status

[Address Reference Count : 1]

- usbd_cdc.o(.text.USBD_CDC_DeInit)

USBD_LL_DataInStage (Thumb, 164 bytes, Stack size 16 bytes, usbd_core.o(.text.USBD_LL_DataInStage))

[Stack]

- Max Depth = 72
- Call Chain = USBD_LL_DataInStage ⇒ USBD_CtlReceiveStatus ⇒ USBD_LL_PrepareReceive ⇒ HAL_PCD_EP_Receive ⇒ USB_EPStartXfer

[Calls]

- >> USBD_CtlReceiveStatus
- >> USBD_CtlContinueSendData
- >> USBD_LL_StallEP
- >> USBD_LL_PrepareReceive

[Called By]

- >> HAL_PCD_DataInStageCallback

USBD_LL_DataOutStage (Thumb, 100 bytes, Stack size 8 bytes, usbd_core.o(.text.USBD_LL_DataOutStage))

[Stack]

- Max Depth = 64
- Call Chain = USBD_LL_DataOutStage ⇒ USBD_CtlSendStatus ⇒ USBD_LL_Transmit ⇒ HAL_PCD_EP_Transmit ⇒ USB_EPStartXfer

[Calls]

- >> USBD_CtlSendStatus
- >> USBD_CtlContinueRx

[Called By]

- >> HAL_PCD_DataOutStageCallback

USBD_LL_GetRxDataSize (Thumb, 8 bytes, Stack size 0 bytes, usbd_conf.o(.text.USBD_LL_GetRxDataSize))

[Calls]

- >> HAL_PCD_EP_GetRxCount

[Called By]

- >> USBD_CDC_DataOut

USBD_LL_Init (Thumb, 124 bytes, Stack size 16 bytes, usbd_conf.o(.text.USBD_LL_Init))

[Stack]

- Max Depth = 168
- Call Chain = USBD_LL_Init ⇒ HAL_PCD_Init ⇒ HAL_PCD_MspInit ⇒ HAL_RCCEx_PeriphCLKConfig

[Calls]

- >> Error_Handler
- >> HAL_PCD_Init

[Called By]

- >> USBD_Init

USBD_LL_IsStallEP (Thumb, 32 bytes, Stack size 0 bytes, usbd_conf.o(.text.USBD_LL_IsStallEP))

[Called By]

- >> USBD_StdEPReq

USBD_LL_OpenEP (Thumb, 24 bytes, Stack size 8 bytes, usbd_conf.o(.text.USBD_LL_OpenEP))

[Stack]

- Max Depth = 56
- Call Chain = USBD_LL_OpenEP ⇒ HAL_PCD_EP_Open ⇒ USB_ActivateEndpoint

[Calls]

- >> HAL_PCD_EP_Open
- >> USBD_Get_USB_Status

[Called By]

- >> USBD_LL_Reset

[Address Reference Count : 1]

- usbd_cdc.o(.text.USBD_CDC_Init)

USBD_LL_PrepareReceive (Thumb, 18 bytes, Stack size 8 bytes, usbd_conf.o(.text.USBD_LL_PrepareReceive))

[Stack]

- Max Depth = 48
- Call Chain = USBD_LL_PrepareReceive ⇒ HAL_PCD_EP_Receive ⇒ USB_EPStartXfer

[Calls]

- >> HAL_PCD_EP_Receive
- >> USBD_Get_USB_Status

[Called By]

- >> USBD_CtlPrepareRx
- >> USBD_CtlReceiveStatus
- >> USBD_CtlContinueRx
- >> USBD_CDC_ReceivePacket
- >> USBD_LL_DataInStage
- >> USBD_CDC_Init

USBD_LL_Reset (Thumb, 94 bytes, Stack size 24 bytes, usbd_core.o(.text.USBD_LL_Reset))

[Stack]

- Max Depth = 80
- Call Chain = USBD_LL_Reset ⇒ USBD_LL_OpenEP ⇒ HAL_PCD_EP_Open ⇒ USB_ActivateEndpoint

[Calls]

- >> USBD_LL_OpenEP

[Called By]

- >> HAL_PCD_ResetCallback

USBD_LL_Resume (Thumb, 20 bytes, Stack size 0 bytes, usbd_core.o(.text.USBD_LL_Resume))

[Called By]

- >> HAL_PCD_ResumeCallback
- >> HAL_PCDEx_LPM_Callback

USBD_LL_SOF (Thumb, 30 bytes, Stack size 8 bytes, usbd_core.o(.text.USBD_LL_SOF))

[Stack]

- Max Depth = 8
- Call Chain = USBD_LL_SOF

[Called By]

- >> HAL_PCD_SOFCallback

USBD_LL_SetSpeed (Thumb, 6 bytes, Stack size 0 bytes, usbd_core.o(.text.USBD_LL_SetSpeed))

[Called By]

- >> HAL_PCD_ResetCallback

USBD_LL_SetUSBAddress (Thumb, 18 bytes, Stack size 8 bytes, usbd_conf.o(.text.USBD_LL_SetUSBAddress))

[Stack]

- Max Depth = 16
- Call Chain = USBD_LL_SetUSBAddress ⇒ HAL_PCD_SetAddress

[Calls]

- >> HAL_PCD_SetAddress
- >> USBD_Get_USB_Status

[Called By]

- >> USBD_StdDevReq

USBD_LL_SetupStage (Thumb, 96 bytes, Stack size 16 bytes, usbd_core.o(.text.USBD_LL_SetupStage))

[Stack]

- Max Depth = 96
- Call Chain = USBD_LL_SetupStage ⇒ USBD_StdDevReq ⇒ USBD_CtlSendData ⇒ USBD_LL_Transmit ⇒ HAL_PCD_EP_Transmit ⇒ USB_EPStartXfer

[Calls]

- >> USBD_StdItfReq
- >> USBD_StdEPReq
- >> USBD_StdDevReq
- >> USBD_ParseSetupRequest

[Called By]

- >> HAL_PCD_SetupStageCallback

USBD_LL_StallEP (Thumb, 18 bytes, Stack size 8 bytes, usbd_conf.o(.text.USBD_LL_StallEP))

[Stack]

- Max Depth = 24
- Call Chain = USBD_LL_StallEP ⇒ HAL_PCD_EP_SetStall ⇒ USB_EPSetStall

[Calls]

- >> HAL_PCD_EP_SetStall
- >> USBD_Get_USB_Status

[Called By]

- >> USBD_CtlError
- >> USBD_StdEPReq
- >> USBD_LL_DataInStage

USBD_LL_Start (Thumb, 18 bytes, Stack size 8 bytes, usbd_conf.o(.text.USBD_LL_Start))

[Stack]

- Max Depth = 16
- Call Chain = USBD_LL_Start ⇒ HAL_PCD_Start

[Calls]

- >> HAL_PCD_Start
- >> USBD_Get_USB_Status

[Called By]

- >> USBD_Start

USBD_LL_Suspend (Thumb, 18 bytes, Stack size 0 bytes, usbd_core.o(.text.USBD_LL_Suspend))

[Called By]

- >> HAL_PCD_SuspendCallback
- >> HAL_PCDEx_LPM_Callback

USBD_LL_Transmit (Thumb, 18 bytes, Stack size 8 bytes, usbd_conf.o(.text.USBD_LL_Transmit))

[Stack]

- Max Depth = 48
- Call Chain = USBD_LL_Transmit ⇒ HAL_PCD_EP_Transmit ⇒ USB_EPStartXfer

[Calls]

- >> HAL_PCD_EP_Transmit
- >> USBD_Get_USB_Status

[Called By]

- >> USBD_CtlSendData
- >> USBD_CtlSendStatus
- >> USBD_CtlContinueSendData
- >> USBD_CDC_TransmitPacket
- >> USBD_CDC_DataIn

USBD_ParseSetupRequest (Thumb, 22 bytes, Stack size 0 bytes, usbd_ctlreq.o(.text.USBD_ParseSetupRequest))

[Called By]

- >> USBD_LL_SetupStage

USBD_RegisterClass (Thumb, 38 bytes, Stack size 16 bytes, usbd_core.o(.text.USBD_RegisterClass))

[Stack]

- Max Depth = 16
- Call Chain = USBD_RegisterClass

[Called By]

- >> MX_USB_Device_Init

USBD_SetClassConfig (Thumb, 14 bytes, Stack size 0 bytes, usbd_core.o(.text.USBD_SetClassConfig))

[Called By]

- >> USBD_StdDevReq

USBD_Start (Thumb, 4 bytes, Stack size 0 bytes, usbd_core.o(.text.USBD_Start))

[Stack]

- Max Depth = 16
- Call Chain = USBD_Start ⇒ USBD_LL_Start ⇒ HAL_PCD_Start

[Calls]

- >> USBD_LL_Start

[Called By]

- >> MX_USB_Device_Init

USBD_StdDevReq (Thumb, 716 bytes, Stack size 24 bytes, usbd_ctlreq.o(.text.USBD_StdDevReq))

[Stack]

- Max Depth = 80
- Call Chain = USBD_StdDevReq ⇒ USBD_CtlSendData ⇒ USBD_LL_Transmit ⇒ HAL_PCD_EP_Transmit ⇒ USB_EPStartXfer

[Calls]

- >> USBD_CtlSendData
- >> USBD_CtlError
- >> USBD_SetClassConfig
- >> USBD_CtlSendStatus
- >> USBD_ClrClassConfig
- >> USBD_LL_SetUSBAddress

[Called By]

- >> USBD_LL_SetupStage

USBD_StdEPReq (Thumb, 302 bytes, Stack size 16 bytes, usbd_ctlreq.o(.text.USBD_StdEPReq))

[Stack]

- Max Depth = 72
- Call Chain = USBD_StdEPReq ⇒ USBD_CtlSendData ⇒ USBD_LL_Transmit ⇒ HAL_PCD_EP_Transmit ⇒ USB_EPStartXfer

[Calls]

- >> USBD_CtlSendData
- >> USBD_CtlError
- >> USBD_CtlSendStatus
- >> USBD_LL_StallEP
- >> USBD_LL_IsStallEP
- >> USBD_LL_ClearStallEP

[Called By]

- >> USBD_LL_SetupStage

USBD_StdItfReq (Thumb, 76 bytes, Stack size 16 bytes, usbd_ctlreq.o(.text.USBD_StdItfReq))

[Stack]

- Max Depth = 72
- Call Chain = USBD_StdItfReq ⇒ USBD_CtlSendStatus ⇒ USBD_LL_Transmit ⇒ HAL_PCD_EP_Transmit ⇒ USB_EPStartXfer

[Calls]

- >> USBD_CtlError
- >> USBD_CtlSendStatus

[Called By]

- >> USBD_LL_SetupStage

USBD_static_free (Thumb, 2 bytes, Stack size 0 bytes, usbd_conf.o(.text.USBD_static_free))

[Called By]

- >> USBD_CDC_DeInit

USBD_static_malloc (Thumb, 8 bytes, Stack size 0 bytes, usbd_conf.o(.text.USBD_static_malloc))

[Called By]

- >> USBD_CDC_Init

USB_ActivateEndpoint (Thumb, 552 bytes, Stack size 32 bytes, stm32g4xx_ll_usb.o(.text.USB_ActivateEndpoint))

[Stack]

- Max Depth = 32
- Call Chain = USB_ActivateEndpoint

[Called By]

- >> HAL_PCD_EP_Open

USB_DeactivateEndpoint (Thumb, 228 bytes, Stack size 16 bytes, stm32g4xx_ll_usb.o(.text.USB_DeactivateEndpoint))

[Stack]

- Max Depth = 16
- Call Chain = USB_DeactivateEndpoint

[Called By]

- >> HAL_PCD_EP_Close

USB_DevConnect (Thumb, 16 bytes, Stack size 0 bytes, stm32g4xx_ll_usb.o(.text.USB_DevConnect))

[Called By]

- >> HAL_PCD_Start

USB_DevInit (Thumb, 24 bytes, Stack size 0 bytes, stm32g4xx_ll_usb.o(.text.USB_DevInit))

[Called By]

- >> HAL_PCD_Init

USB_DisableGlobalInt (Thumb, 18 bytes, Stack size 0 bytes, stm32g4xx_ll_usb.o(.text.USB_DisableGlobalInt))

[Called By]

- >> HAL_PCD_Init

USB_EPClearStall (Thumb, 114 bytes, Stack size 16 bytes, stm32g4xx_ll_usb.o(.text.USB_EPClearStall))

[Stack]

- Max Depth = 16
- Call Chain = USB_EPClearStall

[Called By]

- >> HAL_PCD_EP_ClrStall

USB_EPSetStall (Thumb, 48 bytes, Stack size 8 bytes, stm32g4xx_ll_usb.o(.text.USB_EPSetStall))

[Stack]

- Max Depth = 8
- Call Chain = USB_EPSetStall

[Called By]

- >> HAL_PCD_EP_SetStall

USB_EPStartXfer (Thumb, 1116 bytes, Stack size 24 bytes, stm32g4xx_ll_usb.o(.text.USB_EPStartXfer))

[Stack]

- Max Depth = 24
- Call Chain = USB_EPStartXfer

[Calls]

- >> USB_WritePMA

[Called By]

- >> HAL_PCD_EP_Transmit
- >> HAL_PCD_EP_Receive
- >> HAL_PCD_IRQHandler

USB_EnableGlobalInt (Thumb, 18 bytes, Stack size 0 bytes, stm32g4xx_ll_usb.o(.text.USB_EnableGlobalInt))

[Called By]

- >> HAL_PCD_Start

USB_LP_IRQHandler (Thumb, 12 bytes, Stack size 0 bytes, stm32g4xx_it.o(.text.USB_LP_IRQHandler))

[Stack]

- Max Depth = 216
- Call Chain = USB_LP_IRQHandler ⇒ HAL_PCD_IRQHandler ⇒ HAL_PCD_ResumeCallback ⇒ SystemClock_Config ⇒ HAL_RCC_OscConfig ⇒ HAL_InitTick ⇒ HAL_NVIC_SetPriority ⇒ __NVIC_SetPriority

[Calls]

- >> HAL_PCD_IRQHandler

[Address Reference Count : 1]

- startup_stm32g474xx.o(RESET)

USB_ReadInterrupts (Thumb, 6 bytes, Stack size 0 bytes, stm32g4xx_ll_usb.o(.text.USB_ReadInterrupts))

[Called By]

- >> HAL_PCD_IRQHandler

USB_ReadPMA (Thumb, 40 bytes, Stack size 8 bytes, stm32g4xx_ll_usb.o(.text.USB_ReadPMA))

[Stack]

- Max Depth = 8
- Call Chain = USB_ReadPMA

[Called By]

- >> HAL_PCD_IRQHandler

USB_SetDevAddress (Thumb, 12 bytes, Stack size 0 bytes, stm32g4xx_ll_usb.o(.text.USB_SetDevAddress))

[Called By]

- >> HAL_PCD_SetAddress

USB_WritePMA (Thumb, 26 bytes, Stack size 0 bytes, stm32g4xx_ll_usb.o(.text.USB_WritePMA))

[Called By]

- >> USB_EPStartXfer
- >> HAL_PCD_IRQHandler

UsageFault_Handler (Thumb, 2 bytes, Stack size 0 bytes, stm32g4xx_it.o(.text.UsageFault_Handler))

[Calls]

- >> UsageFault_Handler

[Called By]

- >> UsageFault_Handler

[Address Reference Count : 1]

- startup_stm32g474xx.o(RESET)

disp_clear (Thumb, 128 bytes, Stack size 32 bytes, main.o(.text.disp_clear))

[Stack]

- Max Depth = 200 + Unknown Stack Size
- Call Chain = disp_clear ⇒ ST7789_Fill_Color ⇒ ST7789_SetAddressWindow ⇒ ST7789_WriteData ⇒ HAL_SPI_Transmit ⇒ SPI_EndRxTxTransaction ⇒ SPI_WaitFifoStateUntilTimeout

[Calls]

- >> ST7789_Fill_Color

[Called By]

- >> main

main (Thumb, 204 bytes, Stack size 0 bytes, main.o(.text.main))

[Stack]

- Max Depth = 244 + Unknown Stack Size
- Call Chain = main ⇒ MX_ADC1_Init ⇒ HAL_ADC_Init ⇒ HAL_ADC_MspInit ⇒ HAL_GPIO_Init

[Calls]

- >> disp_clear
- >> SystemClock_Config
- >> ST7789_Init
- >> ST7789_DrawPixel_4px
- >> MX_USB_Device_Init
- >> MX_SPI1_Init
- >> MX_LPUART1_UART_Init
- >> MX_I2C3_Init
- >> MX_GPIO_Init
- >> MX_DMA_Init
- >> MX_ADC1_Init
- >> HAL_Init
- >> HAL_GPIO_TogglePin
- >> GTP_Init
- >> GTP911_Test
- >> CDC_Transmit_FS
- >> __aeabi_memcpy
- >> strlen

[Called By]

- >> __rt_entry_main

_fp_init (Thumb, 26 bytes, Stack size 0 bytes, fpinit.o(x$fpl$fpinit))

[Called By]

- >> __rt_lib_init_fp_1

__fplib_config_fpu_vfp (Thumb, 0 bytes, Stack size unknown bytes, fpinit.o(x$fpl$fpinit), UNUSED)

__fplib_config_pureend_doubles (Thumb, 0 bytes, Stack size unknown bytes, fpinit.o(x$fpl$fpinit), UNUSED)

### Local Symbols

DMA_CalcDMAMUXChannelBaseAndMask (Thumb, 72 bytes, Stack size 8 bytes, stm32g4xx_hal_dma.o(.text.DMA_CalcDMAMUXChannelBaseAndMask))

[Stack]

- Max Depth = 8
- Call Chain = DMA_CalcDMAMUXChannelBaseAndMask

[Called By]

- >> HAL_DMA_Init

DMA_CalcDMAMUXRequestGenBaseAndMask (Thumb, 36 bytes, Stack size 8 bytes, stm32g4xx_hal_dma.o(.text.DMA_CalcDMAMUXRequestGenBaseAndMask))

[Stack]

- Max Depth = 8
- Call Chain = DMA_CalcDMAMUXRequestGenBaseAndMask

[Called By]

- >> HAL_DMA_Init

DMA_SetConfig (Thumb, 58 bytes, Stack size 20 bytes, stm32g4xx_hal_dma.o(.text.DMA_SetConfig))

[Stack]

- Max Depth = 20
- Call Chain = DMA_SetConfig

[Called By]

- >> HAL_DMA_Start_IT

__NVIC_SetPriority (Thumb, 36 bytes, Stack size 8 bytes, stm32g4xx_hal_cortex.o(.text.__NVIC_SetPriority))

[Stack]

- Max Depth = 8
- Call Chain = __NVIC_SetPriority

[Called By]

- >> HAL_NVIC_SetPriority

LL_ADC_SetChannelSamplingTime (Thumb, 30 bytes, Stack size 8 bytes, stm32g4xx_hal_adc.o(.text.LL_ADC_SetChannelSamplingTime))

[Stack]

- Max Depth = 8
- Call Chain = LL_ADC_SetChannelSamplingTime

[Called By]

- >> HAL_ADC_ConfigChannel

I2C_Flush_TXDR (Thumb, 28 bytes, Stack size 0 bytes, stm32g4xx_hal_i2c.o(.text.I2C_Flush_TXDR))

[Called By]

- >> I2C_IsErrorOccurred

I2C_IsErrorOccurred (Thumb, 248 bytes, Stack size 24 bytes, stm32g4xx_hal_i2c.o(.text.I2C_IsErrorOccurred))

[Stack]

- Max Depth = 24
- Call Chain = I2C_IsErrorOccurred

[Calls]

- >> HAL_GetTick
- >> I2C_Flush_TXDR

[Called By]

- >> I2C_WaitOnTXISFlagUntilTimeout
- >> I2C_WaitOnSTOPFlagUntilTimeout
- >> I2C_WaitOnFlagUntilTimeout

I2C_TransferConfig (Thumb, 44 bytes, Stack size 16 bytes, stm32g4xx_hal_i2c.o(.text.I2C_TransferConfig))

[Stack]

- Max Depth = 16
- Call Chain = I2C_TransferConfig

[Called By]

- >> HAL_I2C_Mem_Write
- >> HAL_I2C_Mem_Read

I2C_WaitOnFlagUntilTimeout (Thumb, 124 bytes, Stack size 32 bytes, stm32g4xx_hal_i2c.o(.text.I2C_WaitOnFlagUntilTimeout))

[Stack]

- Max Depth = 56
- Call Chain = I2C_WaitOnFlagUntilTimeout ⇒ I2C_IsErrorOccurred

[Calls]

- >> HAL_GetTick
- >> I2C_IsErrorOccurred

[Called By]

- >> HAL_I2C_Mem_Write
- >> HAL_I2C_Mem_Read

I2C_WaitOnSTOPFlagUntilTimeout (Thumb, 80 bytes, Stack size 16 bytes, stm32g4xx_hal_i2c.o(.text.I2C_WaitOnSTOPFlagUntilTimeout))

[Stack]

- Max Depth = 40
- Call Chain = I2C_WaitOnSTOPFlagUntilTimeout ⇒ I2C_IsErrorOccurred

[Calls]

- >> HAL_GetTick
- >> I2C_IsErrorOccurred

[Called By]

- >> HAL_I2C_Mem_Write
- >> HAL_I2C_Mem_Read

I2C_WaitOnTXISFlagUntilTimeout (Thumb, 86 bytes, Stack size 24 bytes, stm32g4xx_hal_i2c.o(.text.I2C_WaitOnTXISFlagUntilTimeout))

[Stack]

- Max Depth = 48
- Call Chain = I2C_WaitOnTXISFlagUntilTimeout ⇒ I2C_IsErrorOccurred

[Calls]

- >> HAL_GetTick
- >> I2C_IsErrorOccurred

[Called By]

- >> HAL_I2C_Mem_Write
- >> HAL_I2C_Mem_Read

UART_EndRxTransfer (Thumb, 88 bytes, Stack size 8 bytes, stm32g4xx_hal_uart.o(.text.UART_EndRxTransfer))

[Stack]

- Max Depth = 8
- Call Chain = UART_EndRxTransfer

[Called By]

- >> UART_WaitOnFlagUntilTimeout

UARTEx_SetNbDataToProcess (Thumb, 68 bytes, Stack size 16 bytes, stm32g4xx_hal_uart_ex.o(.text.UARTEx_SetNbDataToProcess))

[Stack]

- Max Depth = 16
- Call Chain = UARTEx_SetNbDataToProcess

[Called By]

- >> HAL_UARTEx_SetTxFifoThreshold
- >> HAL_UARTEx_SetRxFifoThreshold

SPI_DMAAbortOnError (Thumb, 14 bytes, Stack size 0 bytes, stm32g4xx_hal_spi.o(.text.SPI_DMAAbortOnError))

[Calls]

- >> HAL_SPI_ErrorCallback

[Address Reference Count : 1]

- stm32g4xx_hal_spi.o(.text.HAL_SPI_IRQHandler)

SPI_DMAError (Thumb, 30 bytes, Stack size 0 bytes, stm32g4xx_hal_spi.o(.text.SPI_DMAError))

[Calls]

- >> HAL_SPI_ErrorCallback

[Address Reference Count : 1]

- stm32g4xx_hal_spi.o(.text.HAL_SPI_Transmit_DMA)

SPI_DMAHalfTransmitCplt (Thumb, 6 bytes, Stack size 0 bytes, stm32g4xx_hal_spi.o(.text.SPI_DMAHalfTransmitCplt))

[Calls]

- >> HAL_SPI_TxHalfCpltCallback

[Address Reference Count : 1]

- stm32g4xx_hal_spi.o(.text.HAL_SPI_Transmit_DMA)

SPI_DMATransmitCplt (Thumb, 110 bytes, Stack size 24 bytes, stm32g4xx_hal_spi.o(.text.SPI_DMATransmitCplt))

[Stack]

- Max Depth = 80
- Call Chain = SPI_DMATransmitCplt ⇒ SPI_EndRxTxTransaction ⇒ SPI_WaitFifoStateUntilTimeout

[Calls]

- >> HAL_GetTick
- >> HAL_SPI_TxCpltCallback
- >> HAL_SPI_ErrorCallback
- >> SPI_EndRxTxTransaction

[Address Reference Count : 1]

- stm32g4xx_hal_spi.o(.text.HAL_SPI_Transmit_DMA)

SPI_EndRxTxTransaction (Thumb, 66 bytes, Stack size 16 bytes, stm32g4xx_hal_spi.o(.text.SPI_EndRxTxTransaction))

[Stack]

- Max Depth = 56
- Call Chain = SPI_EndRxTxTransaction ⇒ SPI_WaitFifoStateUntilTimeout

[Calls]

- >> SPI_WaitFlagStateUntilTimeout
- >> SPI_WaitFifoStateUntilTimeout

[Called By]

- >> HAL_SPI_Transmit
- >> SPI_DMATransmitCplt

SPI_WaitFifoStateUntilTimeout (Thumb, 204 bytes, Stack size 40 bytes, stm32g4xx_hal_spi.o(.text.SPI_WaitFifoStateUntilTimeout))

[Stack]

- Max Depth = 40
- Call Chain = SPI_WaitFifoStateUntilTimeout

[Calls]

- >> HAL_GetTick

[Called By]

- >> SPI_EndRxTxTransaction

SPI_WaitFlagStateUntilTimeout (Thumb, 164 bytes, Stack size 24 bytes, stm32g4xx_hal_spi.o(.text.SPI_WaitFlagStateUntilTimeout))

[Stack]

- Max Depth = 24
- Call Chain = SPI_WaitFlagStateUntilTimeout

[Calls]

- >> HAL_GetTick

[Called By]

- >> SPI_EndRxTxTransaction

ST7789_SetAddressWindow (Thumb, 92 bytes, Stack size 32 bytes, st7789.o(.text.ST7789_SetAddressWindow))

[Stack]

- Max Depth = 152
- Call Chain = ST7789_SetAddressWindow ⇒ ST7789_WriteData ⇒ HAL_SPI_Transmit ⇒ SPI_EndRxTxTransaction ⇒ SPI_WaitFifoStateUntilTimeout

[Calls]

- >> ST7789_WriteData

[Called By]

- >> ST7789_Fill_Color
- >> ST7789_WriteChar
- >> ST7789_Fill

ST7789_WriteCommand (Thumb, 36 bytes, Stack size 16 bytes, st7789.o(.text.ST7789_WriteCommand))

[Stack]

- Max Depth = 104
- Call Chain = ST7789_WriteCommand ⇒ HAL_SPI_Transmit ⇒ SPI_EndRxTxTransaction ⇒ SPI_WaitFifoStateUntilTimeout

[Calls]

- >> HAL_GPIO_WritePin
- >> HAL_SPI_Transmit

[Called By]

- >> ST7789_SetRotation

[Address Reference Count : 2]

- st7789.o(.text.ST7789_Init)
- st7789.o(.text.ST7789_SetAddressWindow)

ST7789_WriteData (Thumb, 100 bytes, Stack size 32 bytes, st7789.o(.text.ST7789_WriteData))

[Stack]

- Max Depth = 120
- Call Chain = ST7789_WriteData ⇒ HAL_SPI_Transmit ⇒ SPI_EndRxTxTransaction ⇒ SPI_WaitFifoStateUntilTimeout

[Calls]

- >> HAL_GPIO_WritePin
- >> HAL_SPI_Transmit_DMA
- >> HAL_SPI_Transmit

[Called By]

- >> ST7789_Fill_Color
- >> ST7789_WriteChar
- >> ST7789_Fill
- >> ST7789_SetAddressWindow

[Address Reference Count : 1]

- st7789.o(.text.ST7789_Init)

ST7789_WriteSmallData (Thumb, 40 bytes, Stack size 16 bytes, st7789.o(.text.ST7789_WriteSmallData))

[Stack]

- Max Depth = 104
- Call Chain = ST7789_WriteSmallData ⇒ HAL_SPI_Transmit ⇒ SPI_EndRxTxTransaction ⇒ SPI_WaitFifoStateUntilTimeout

[Calls]

- >> HAL_GPIO_WritePin
- >> HAL_SPI_Transmit

[Called By]

- >> ST7789_SetRotation

[Address Reference Count : 1]

- st7789.o(.text.ST7789_Init)

USBD_Get_USB_Status (Thumb, 24 bytes, Stack size 0 bytes, usbd_conf.o(.text.USBD_Get_USB_Status))

[Called By]

- >> USBD_LL_Transmit
- >> USBD_LL_Start
- >> USBD_LL_StallEP
- >> USBD_LL_SetUSBAddress
- >> USBD_LL_PrepareReceive
- >> USBD_LL_OpenEP
- >> USBD_LL_CloseEP
- >> USBD_LL_ClearStallEP

IntToUnicode (Thumb, 48 bytes, Stack size 20 bytes, usbd_desc.o(.text.IntToUnicode))

[Stack]

- Max Depth = 20
- Call Chain = IntToUnicode

[Called By]

- >> USBD_CDC_SerialStrDescriptor

CDC_Control_FS (Thumb, 4 bytes, Stack size 0 bytes, usbd_cdc_if.o(.text.CDC_Control_FS))
[Address Reference Count : 1]

- usbd_cdc_if.o(.data.USBD_Interface_fops_FS)

CDC_DeInit_FS (Thumb, 4 bytes, Stack size 0 bytes, usbd_cdc_if.o(.text.CDC_DeInit_FS))
[Address Reference Count : 1]

- usbd_cdc_if.o(.data.USBD_Interface_fops_FS)

CDC_Init_FS (Thumb, 36 bytes, Stack size 8 bytes, usbd_cdc_if.o(.text.CDC_Init_FS))

[Stack]

- Max Depth = 8
- Call Chain = CDC_Init_FS

[Calls]

- >> USBD_CDC_SetTxBuffer
- >> USBD_CDC_SetRxBuffer

[Address Reference Count : 1]

- usbd_cdc_if.o(.data.USBD_Interface_fops_FS)

CDC_Receive_FS (Thumb, 24 bytes, Stack size 8 bytes, usbd_cdc_if.o(.text.CDC_Receive_FS))

[Stack]

- Max Depth = 64
- Call Chain = CDC_Receive_FS ⇒ USBD_CDC_ReceivePacket ⇒ USBD_LL_PrepareReceive ⇒ HAL_PCD_EP_Receive ⇒ USB_EPStartXfer

[Calls]

- >> USBD_CDC_SetRxBuffer
- >> USBD_CDC_ReceivePacket

[Address Reference Count : 1]

- usbd_cdc_if.o(.data.USBD_Interface_fops_FS)

CDC_TransmitCplt_FS (Thumb, 4 bytes, Stack size 0 bytes, usbd_cdc_if.o(.text.CDC_TransmitCplt_FS))
[Address Reference Count : 1]

- usbd_cdc_if.o(.data.USBD_Interface_fops_FS)

USBD_CDC_DataIn (Thumb, 98 bytes, Stack size 16 bytes, usbd_cdc.o(.text.USBD_CDC_DataIn))

[Stack]

- Max Depth = 64
- Call Chain = USBD_CDC_DataIn ⇒ USBD_LL_Transmit ⇒ HAL_PCD_EP_Transmit ⇒ USB_EPStartXfer

[Calls]

- >> USBD_LL_Transmit

[Address Reference Count : 1]

- usbd_cdc.o(.data.USBD_CDC)

USBD_CDC_DataOut (Thumb, 42 bytes, Stack size 16 bytes, usbd_cdc.o(.text.USBD_CDC_DataOut))

[Stack]

- Max Depth = 16
- Call Chain = USBD_CDC_DataOut

[Calls]

- >> USBD_LL_GetRxDataSize

[Address Reference Count : 1]

- usbd_cdc.o(.data.USBD_CDC)

USBD_CDC_DeInit (Thumb, 68 bytes, Stack size 16 bytes, usbd_cdc.o(.text.USBD_CDC_DeInit))

[Stack]

- Max Depth = 16
- Call Chain = USBD_CDC_DeInit

[Calls]

- >> USBD_static_free

[Address Reference Count : 1]

- usbd_cdc.o(.data.USBD_CDC)

USBD_CDC_EP0_RxReady (Thumb, 46 bytes, Stack size 8 bytes, usbd_cdc.o(.text.USBD_CDC_EP0_RxReady))

[Stack]

- Max Depth = 8
- Call Chain = USBD_CDC_EP0_RxReady

[Address Reference Count : 1]

- usbd_cdc.o(.data.USBD_CDC)

USBD_CDC_GetFSCfgDesc (Thumb, 12 bytes, Stack size 0 bytes, usbd_cdc.o(.text.USBD_CDC_GetFSCfgDesc))
[Address Reference Count : 1]

- usbd_cdc.o(.data.USBD_CDC)

USBD_CDC_GetHSCfgDesc (Thumb, 12 bytes, Stack size 0 bytes, usbd_cdc.o(.text.USBD_CDC_GetHSCfgDesc))
[Address Reference Count : 1]

- usbd_cdc.o(.data.USBD_CDC)

USBD_CDC_GetOtherSpeedCfgDesc (Thumb, 12 bytes, Stack size 0 bytes, usbd_cdc.o(.text.USBD_CDC_GetOtherSpeedCfgDesc))
[Address Reference Count : 1]

- usbd_cdc.o(.data.USBD_CDC)

USBD_CDC_Init (Thumb, 152 bytes, Stack size 24 bytes, usbd_cdc.o(.text.USBD_CDC_Init))

[Stack]

- Max Depth = 72
- Call Chain = USBD_CDC_Init ⇒ USBD_LL_PrepareReceive ⇒ HAL_PCD_EP_Receive ⇒ USB_EPStartXfer

[Calls]

- >> USBD_static_malloc
- >> USBD_LL_PrepareReceive

[Address Reference Count : 1]

- usbd_cdc.o(.data.USBD_CDC)

USBD_CDC_Setup (Thumb, 186 bytes, Stack size 24 bytes, usbd_cdc.o(.text.USBD_CDC_Setup))

[Stack]

- Max Depth = 80
- Call Chain = USBD_CDC_Setup ⇒ USBD_CtlPrepareRx ⇒ USBD_LL_PrepareReceive ⇒ HAL_PCD_EP_Receive ⇒ USB_EPStartXfer

[Calls]

- >> USBD_CtlPrepareRx
- >> USBD_CtlSendData
- >> USBD_CtlError

[Address Reference Count : 1]

- usbd_cdc.o(.data.USBD_CDC)

_printf_input_char (Thumb, 10 bytes, Stack size 0 bytes, _printf_char_common.o(.text))
[Address Reference Count : 1]

- _printf_char_common.o(.text)

### Undefined Global Symbols
