Aiano/DigitalPowerSupply/Firmware/testWidgets/MDK-ARM/testWidgets/testWidgets.htm

# Static Call Graph for image .\testWidgets\testWidgets.axf

#<CALLGRAPH># ARM Linker, 6140002: Last Updated: Sun May 5 21:12:24 2024

### Maximum Stack Usage = 1072 bytes + Unknown(Functions without stacksize, Cycles, Untraceable Function Pointers)

### Call chain for Maximum Stack Depth:

lv_chart_event ⇒ draw_y_ticks ⇒ lv_draw_label ⇒ lv_txt_get_size ⇒ _lv_txt_get_next_line ⇒ lv_font_get_glyph_width ⇒ lv_font_get_glyph_dsc

### Functions with no stack information

- __user_initial_stackheap

### Mutually Recursive functions

- ADC1_IRQHandler ⇒ ADC1_IRQHandler
- BusFault_Handler ⇒ BusFault_Handler
- HardFault_Handler ⇒ HardFault_Handler
- MemManage_Handler ⇒ MemManage_Handler
- NMI_Handler ⇒ NMI_Handler
- UsageFault_Handler ⇒ UsageFault_Handler
- _lv_area_is_point_on ⇒ _lv_area_is_point_on
- event_send_core ⇒ event_send_core
- refresh_children_style ⇒ refresh_children_style
- lv_obj_move_children_by ⇒ lv_obj_move_children_by
- lv_obj_scroll_by_bounded ⇒ lv_obj_update_layout
- layout_update_core ⇒ layout_update_core
- _vsnprintf ⇒ _vsnprintf
- apply_theme ⇒ apply_theme
- lv_obj_is_group_def ⇒ lv_obj_is_group_def
- lv_obj_construct ⇒ lv_obj_construct
- lv_obj_redraw ⇒ refr_obj
- lv_refr_get_top_obj ⇒ lv_refr_get_top_obj
- lv_obj_is_editable ⇒ lv_obj_is_editable
- lv_obj_transform_point ⇒ lv_obj_transform_point
- lv_indev_search_obj ⇒ lv_indev_search_obj
- lv_memcpy_small ⇒ lv_memcpy_small
- lv_textarea_add_char ⇒ insert_handler
- lv_textarea_add_text ⇒ insert_handler
- obj_del_core ⇒ obj_del_core
- report_style_change_core ⇒ report_style_change_core

### Function Pointers

- ADC1_IRQHandler from startup_stm32l431xx.o(.text) referenced from startup_stm32l431xx.o(RESET)
- BusFault_Handler from stm32l4xx_it.o(.text.BusFault_Handler) referenced from startup_stm32l431xx.o(RESET)
- CAN1_RX0_IRQHandler from startup_stm32l431xx.o(.text) referenced from startup_stm32l431xx.o(RESET)
- CAN1_RX1_IRQHandler from startup_stm32l431xx.o(.text) referenced from startup_stm32l431xx.o(RESET)
- CAN1_SCE_IRQHandler from startup_stm32l431xx.o(.text) referenced from startup_stm32l431xx.o(RESET)
- CAN1_TX_IRQHandler from startup_stm32l431xx.o(.text) referenced from startup_stm32l431xx.o(RESET)
- COMP_IRQHandler from startup_stm32l431xx.o(.text) referenced from startup_stm32l431xx.o(RESET)
- CRS_IRQHandler from startup_stm32l431xx.o(.text) referenced from startup_stm32l431xx.o(RESET)
- DMA1_Channel1_IRQHandler from startup_stm32l431xx.o(.text) referenced from startup_stm32l431xx.o(RESET)
- DMA1_Channel2_IRQHandler from startup_stm32l431xx.o(.text) referenced from startup_stm32l431xx.o(RESET)
- DMA1_Channel3_IRQHandler from stm32l4xx_it.o(.text.DMA1_Channel3_IRQHandler) referenced from startup_stm32l431xx.o(RESET)
- DMA1_Channel4_IRQHandler from startup_stm32l431xx.o(.text) referenced from startup_stm32l431xx.o(RESET)
- DMA1_Channel5_IRQHandler from startup_stm32l431xx.o(.text) referenced from startup_stm32l431xx.o(RESET)
- DMA1_Channel6_IRQHandler from startup_stm32l431xx.o(.text) referenced from startup_stm32l431xx.o(RESET)
- DMA1_Channel7_IRQHandler from startup_stm32l431xx.o(.text) referenced from startup_stm32l431xx.o(RESET)
- DMA2_Channel1_IRQHandler from startup_stm32l431xx.o(.text) referenced from startup_stm32l431xx.o(RESET)
- DMA2_Channel2_IRQHandler from startup_stm32l431xx.o(.text) referenced from startup_stm32l431xx.o(RESET)
- DMA2_Channel3_IRQHandler from startup_stm32l431xx.o(.text) referenced from startup_stm32l431xx.o(RESET)
- DMA2_Channel4_IRQHandler from startup_stm32l431xx.o(.text) referenced from startup_stm32l431xx.o(RESET)
- DMA2_Channel5_IRQHandler from startup_stm32l431xx.o(.text) referenced from startup_stm32l431xx.o(RESET)
- DMA2_Channel6_IRQHandler from startup_stm32l431xx.o(.text) referenced from startup_stm32l431xx.o(RESET)
- DMA2_Channel7_IRQHandler from startup_stm32l431xx.o(.text) referenced from startup_stm32l431xx.o(RESET)
- DebugMon_Handler from stm32l4xx_it.o(.text.DebugMon_Handler) referenced from startup_stm32l431xx.o(RESET)
- EXTI0_IRQHandler from startup_stm32l431xx.o(.text) referenced from startup_stm32l431xx.o(RESET)
- EXTI15_10_IRQHandler from startup_stm32l431xx.o(.text) referenced from startup_stm32l431xx.o(RESET)
- EXTI1_IRQHandler from startup_stm32l431xx.o(.text) referenced from startup_stm32l431xx.o(RESET)
- EXTI2_IRQHandler from startup_stm32l431xx.o(.text) referenced from startup_stm32l431xx.o(RESET)
- EXTI3_IRQHandler from startup_stm32l431xx.o(.text) referenced from startup_stm32l431xx.o(RESET)
- EXTI4_IRQHandler from startup_stm32l431xx.o(.text) referenced from startup_stm32l431xx.o(RESET)
- EXTI9_5_IRQHandler from startup_stm32l431xx.o(.text) referenced from startup_stm32l431xx.o(RESET)
- FLASH_IRQHandler from startup_stm32l431xx.o(.text) referenced from startup_stm32l431xx.o(RESET)
- FPU_IRQHandler from startup_stm32l431xx.o(.text) referenced from startup_stm32l431xx.o(RESET)
- HAL_Delay from stm32l4xx_hal.o(.text.HAL_Delay) referenced from st7789.o(.text.ST7789_Init)
- HAL_GPIO_Init from stm32l4xx_hal_gpio.o(.text.HAL_GPIO_Init) referenced from gpio.o(.text.MX_GPIO_Init)
- HardFault_Handler from stm32l4xx_it.o(.text.HardFault_Handler) referenced from startup_stm32l431xx.o(RESET)
- I2C1_ER_IRQHandler from startup_stm32l431xx.o(.text) referenced from startup_stm32l431xx.o(RESET)
- I2C1_EV_IRQHandler from startup_stm32l431xx.o(.text) referenced from startup_stm32l431xx.o(RESET)
- I2C2_ER_IRQHandler from startup_stm32l431xx.o(.text) referenced from startup_stm32l431xx.o(RESET)
- I2C2_EV_IRQHandler from startup_stm32l431xx.o(.text) referenced from startup_stm32l431xx.o(RESET)
- I2C3_ER_IRQHandler from startup_stm32l431xx.o(.text) referenced from startup_stm32l431xx.o(RESET)
- I2C3_EV_IRQHandler from startup_stm32l431xx.o(.text) referenced from startup_stm32l431xx.o(RESET)
- LPTIM1_IRQHandler from startup_stm32l431xx.o(.text) referenced from startup_stm32l431xx.o(RESET)
- LPTIM2_IRQHandler from startup_stm32l431xx.o(.text) referenced from startup_stm32l431xx.o(RESET)
- LPUART1_IRQHandler from startup_stm32l431xx.o(.text) referenced from startup_stm32l431xx.o(RESET)
- MemManage_Handler from stm32l4xx_it.o(.text.MemManage_Handler) referenced from startup_stm32l431xx.o(RESET)
- NMI_Handler from stm32l4xx_it.o(.text.NMI_Handler) referenced from startup_stm32l431xx.o(RESET)
- PVD_PVM_IRQHandler from startup_stm32l431xx.o(.text) referenced from startup_stm32l431xx.o(RESET)
- PendSV_Handler from stm32l4xx_it.o(.text.PendSV_Handler) referenced from startup_stm32l431xx.o(RESET)
- QUADSPI_IRQHandler from startup_stm32l431xx.o(.text) referenced from startup_stm32l431xx.o(RESET)
- RCC_IRQHandler from startup_stm32l431xx.o(.text) referenced from startup_stm32l431xx.o(RESET)
- RNG_IRQHandler from startup_stm32l431xx.o(.text) referenced from startup_stm32l431xx.o(RESET)
- RTC_Alarm_IRQHandler from startup_stm32l431xx.o(.text) referenced from startup_stm32l431xx.o(RESET)
- RTC_WKUP_IRQHandler from startup_stm32l431xx.o(.text) referenced from startup_stm32l431xx.o(RESET)
- Reset_Handler from startup_stm32l431xx.o(.text) referenced from startup_stm32l431xx.o(RESET)
- SAI1_IRQHandler from startup_stm32l431xx.o(.text) referenced from startup_stm32l431xx.o(RESET)
- SDMMC1_IRQHandler from startup_stm32l431xx.o(.text) referenced from startup_stm32l431xx.o(RESET)
- SPI1_IRQHandler from stm32l4xx_it.o(.text.SPI1_IRQHandler) referenced from startup_stm32l431xx.o(RESET)
- SPI2_IRQHandler from startup_stm32l431xx.o(.text) referenced from startup_stm32l431xx.o(RESET)
- SPI3_IRQHandler from startup_stm32l431xx.o(.text) referenced from startup_stm32l431xx.o(RESET)
- SPI_DMAAbortOnError from stm32l4xx_hal_spi.o(.text.SPI_DMAAbortOnError) referenced from stm32l4xx_hal_spi.o(.text.HAL_SPI_IRQHandler)
- SPI_DMAError from stm32l4xx_hal_spi.o(.text.SPI_DMAError) referenced from stm32l4xx_hal_spi.o(.text.HAL_SPI_Transmit_DMA)
- SPI_DMAHalfTransmitCplt from stm32l4xx_hal_spi.o(.text.SPI_DMAHalfTransmitCplt) referenced from stm32l4xx_hal_spi.o(.text.HAL_SPI_Transmit_DMA)
- SPI_DMATransmitCplt from stm32l4xx_hal_spi.o(.text.SPI_DMATransmitCplt) referenced from stm32l4xx_hal_spi.o(.text.HAL_SPI_Transmit_DMA)
- ST7789_WriteCommand from st7789.o(.text.ST7789_WriteCommand) referenced from st7789.o(.text.ST7789_Init)
- ST7789_WriteData from st7789.o(.text.ST7789_WriteData) referenced from st7789.o(.text.ST7789_Init)
- ST7789_WriteSmallData from st7789.o(.text.ST7789_WriteSmallData) referenced from st7789.o(.text.ST7789_Init)
- SVC_Handler from stm32l4xx_it.o(.text.SVC_Handler) referenced from startup_stm32l431xx.o(RESET)
- SWPMI1_IRQHandler from startup_stm32l431xx.o(.text) referenced from startup_stm32l431xx.o(RESET)
- SysTick_Handler from stm32l4xx_it.o(.text.SysTick_Handler) referenced from startup_stm32l431xx.o(RESET)
- SystemInit from system_stm32l4xx.o(.text.SystemInit) referenced from startup_stm32l431xx.o(.text)
- TAMP_STAMP_IRQHandler from startup_stm32l431xx.o(.text) referenced from startup_stm32l431xx.o(RESET)
- TIM1_BRK_TIM15_IRQHandler from startup_stm32l431xx.o(.text) referenced from startup_stm32l431xx.o(RESET)
- TIM1_CC_IRQHandler from startup_stm32l431xx.o(.text) referenced from startup_stm32l431xx.o(RESET)
- TIM1_TRG_COM_IRQHandler from startup_stm32l431xx.o(.text) referenced from startup_stm32l431xx.o(RESET)
- TIM1_UP_TIM16_IRQHandler from startup_stm32l431xx.o(.text) referenced from startup_stm32l431xx.o(RESET)
- TIM2_IRQHandler from startup_stm32l431xx.o(.text) referenced from startup_stm32l431xx.o(RESET)
- TIM6_DAC_IRQHandler from stm32l4xx_it.o(.text.TIM6_DAC_IRQHandler) referenced from startup_stm32l431xx.o(RESET)
- TIM7_IRQHandler from startup_stm32l431xx.o(.text) referenced from startup_stm32l431xx.o(RESET)
- TSC_IRQHandler from startup_stm32l431xx.o(.text) referenced from startup_stm32l431xx.o(RESET)
- USART1_IRQHandler from startup_stm32l431xx.o(.text) referenced from startup_stm32l431xx.o(RESET)
- USART2_IRQHandler from startup_stm32l431xx.o(.text) referenced from startup_stm32l431xx.o(RESET)
- USART3_IRQHandler from startup_stm32l431xx.o(.text) referenced from startup_stm32l431xx.o(RESET)
- UsageFault_Handler from stm32l4xx_it.o(.text.UsageFault_Handler) referenced from startup_stm32l431xx.o(RESET)
- WWDG_IRQHandler from startup_stm32l431xx.o(.text) referenced from startup_stm32l431xx.o(RESET)
- __main from __main.o(!!!main) referenced from startup_stm32l431xx.o(.text)
- _lv_disp_refr_timer from lv_refr.o(.text._lv_disp_refr_timer) referenced from lv_hal_disp.o(.text.lv_disp_drv_register)
- _lv_ll_get_head from lv_ll.o(.text._lv_ll_get_head) referenced from lv_group.o(.text.lv_group_focus_next)
- _lv_ll_get_next from lv_ll.o(.text._lv_ll_get_next) referenced from lv_group.o(.text.lv_group_focus_next)
- _lv_ll_get_prev from lv_ll.o(.text._lv_ll_get_prev) referenced from lv_group.o(.text.lv_group_focus_prev)
- _lv_ll_get_tail from lv_ll.o(.text._lv_ll_get_tail) referenced from lv_group.o(.text.lv_group_focus_prev)
- _out_buffer from lv_printf.o(.text._out_buffer) referenced from lv_printf.o(.text.lv_snprintf)
- _out_buffer from lv_printf.o(.text._out_buffer) referenced from lv_printf.o(.text.lv_vsnprintf)
- _out_null from lv_printf.o(.text._out_null) referenced from lv_printf.o(.text._vsnprintf)
- anim_timer from lv_anim.o(.text.anim_timer) referenced from lv_anim.o(.text._lv_anim_core_init)
- arc_anim_end_angle from lv_spinner.o(.text.arc_anim_end_angle) referenced from lv_spinner.o(.text.lv_spinner_constructor)
- arc_anim_start_angle from lv_spinner.o(.text.arc_anim_start_angle) referenced from lv_spinner.o(.text.lv_spinner_constructor)
- btns_value_changed_event_cb from lv_tabview.o(.text.btns_value_changed_event_cb) referenced from lv_tabview.o(.text.lv_tabview_constructor)
- color_blend_true_color_additive from lv_draw_sw_blend.o(.text.color_blend_true_color_additive) referenced from lv_draw_sw_blend.o(.rodata..Lswitch.table.lv_draw_sw_blend_basic.1)
- color_blend_true_color_multiply from lv_draw_sw_blend.o(.text.color_blend_true_color_multiply) referenced from lv_draw_sw_blend.o(.rodata..Lswitch.table.lv_draw_sw_blend_basic.1)
- color_blend_true_color_subtractive from lv_draw_sw_blend.o(.text.color_blend_true_color_subtractive) referenced from lv_draw_sw_blend.o(.rodata..Lswitch.table.lv_draw_sw_blend_basic.1)
- cont_scroll_end_event_cb from lv_tabview.o(.text.cont_scroll_end_event_cb) referenced from lv_tabview.o(.text.lv_tabview_constructor)
- cursor_blink_anim_cb from lv_textarea.o(.text.cursor_blink_anim_cb) referenced from lv_textarea.o(.text.start_cursor_blink)
- dark_color_filter_cb from lv_theme_default.o(.text.dark_color_filter_cb) referenced from lv_theme_default.o(.text.style_init)
- default_walker from lv_tlsf.o(.text.default_walker) referenced from lv_tlsf.o(.text.lv_tlsf_walk_pool)
- disp_flush from lv_port_disp.o(.text.disp_flush) referenced from lv_port_disp.o(.text.lv_port_disp_init)
- draw_part_begin_event_cb from lv_calendar.o(.text.draw_part_begin_event_cb) referenced from lv_calendar.o(.text.lv_calendar_constructor)
- find_item from lv_draw_sw_gradient.o(.text.find_item) referenced from lv_draw_sw_gradient.o(.text.lv_gradient_get)
- find_oldest_item_life from lv_draw_sw_gradient.o(.text.find_oldest_item_life) referenced from lv_draw_sw_gradient.o(.text.lv_gradient_get)
- flex_update from lv_flex.o(.text.flex_update) referenced from lv_flex.o(.text.lv_flex_init)
- grey_filter_cb from lv_theme_default.o(.text.grey_filter_cb) referenced from lv_theme_default.o(.text.style_init)
- grid_update from lv_grid.o(.text.grid_update) referenced from lv_grid.o(.text.lv_grid_init)
- hex_char_to_num from lv_draw_label.o(.text.hex_char_to_num) referenced from lv_draw_label.o(.text.lv_draw_label)
- kern_pair_16_compare from lv_font_fmt_txt.o(.text.kern_pair_16_compare) referenced from lv_font_fmt_txt.o(.text.lv_font_get_glyph_dsc_fmt_txt)
- kern_pair_8_compare from lv_font_fmt_txt.o(.text.kern_pair_8_compare) referenced from lv_font_fmt_txt.o(.text.lv_font_get_glyph_dsc_fmt_txt)
- kill_oldest_item from lv_draw_sw_gradient.o(.text.kill_oldest_item) referenced from lv_draw_sw_gradient.o(.text.lv_gradient_get)
- label_event_cb from lv_textarea.o(.text.label_event_cb) referenced from lv_textarea.o(.text.lv_textarea_constructor)
- lv_anim_path_ease_in_out from lv_anim.o(.text.lv_anim_path_ease_in_out) referenced from lv_spinner.o(.text.lv_spinner_constructor)
- lv_anim_path_ease_out from lv_anim.o(.text.lv_anim_path_ease_out) referenced from lv_obj_scroll.o(.text.lv_obj_scroll_by)
- lv_anim_path_ease_out from lv_anim.o(.text.lv_anim_path_ease_out) referenced from lv_roller.o(.text.refr_position)
- lv_anim_path_linear from lv_anim.o(.text.lv_anim_path_linear) referenced from lv_anim.o(.text.lv_anim_init)
- lv_anim_path_linear from lv_anim.o(.text.lv_anim_path_linear) referenced from lv_style.o(.text.lv_style_transition_dsc_init)
- lv_anim_path_linear from lv_anim.o(.text.lv_anim_path_linear) referenced from lv_theme_default.o(.text.style_init)
- lv_anim_path_step from lv_anim.o(.text.lv_anim_path_step) referenced from lv_textarea.o(.text.auto_hide_characters)
- lv_anim_path_step from lv_anim.o(.text.lv_anim_path_step) referenced from lv_textarea.o(.text.start_cursor_blink)
- lv_arc_constructor from lv_arc.o(.text.lv_arc_constructor) referenced from lv_arc.o(.rodata.lv_arc_class)
- lv_arc_event from lv_arc.o(.text.lv_arc_event) referenced from lv_arc.o(.rodata.lv_arc_class)
- lv_area_get_height from lv_flex.o(.text.lv_area_get_height) referenced from lv_flex.o(.text.children_repos)
- lv_area_get_height from lv_bar.o(.text.lv_area_get_height) referenced from lv_bar.o(.text.lv_bar_event)
- lv_area_get_size from lv_area.o(.text.lv_area_get_size) referenced from lv_refr.o(.text._lv_disp_refr_timer)
- lv_area_get_width from lv_flex.o(.text.lv_area_get_width) referenced from lv_flex.o(.text.children_repos)
- lv_area_get_width from lv_bar.o(.text.lv_area_get_width) referenced from lv_bar.o(.text.lv_bar_event)
- lv_area_set_height from lv_area.o(.text.lv_area_set_height) referenced from lv_flex.o(.text.children_repos)
- lv_area_set_width from lv_area.o(.text.lv_area_set_width) referenced from lv_flex.o(.text.children_repos)
- lv_bar_anim from lv_bar.o(.text.lv_bar_anim) referenced from lv_bar.o(.text.lv_bar_set_value_with_anim)
- lv_bar_anim_ready from lv_bar.o(.text.lv_bar_anim_ready) referenced from lv_bar.o(.text.lv_bar_set_value_with_anim)
- lv_bar_constructor from lv_bar.o(.text.lv_bar_constructor) referenced from lv_bar.o(.rodata.lv_bar_class)
- lv_bar_destructor from lv_bar.o(.text.lv_bar_destructor) referenced from lv_bar.o(.rodata.lv_bar_class)
- lv_bar_event from lv_bar.o(.text.lv_bar_event) referenced from lv_bar.o(.rodata.lv_bar_class)
- lv_btn_constructor from lv_btn.o(.text.lv_btn_constructor) referenced from lv_btn.o(.rodata.lv_btn_class)
- lv_btnmatrix_constructor from lv_btnmatrix.o(.text.lv_btnmatrix_constructor) referenced from lv_btnmatrix.o(.rodata.lv_btnmatrix_class)
- lv_btnmatrix_destructor from lv_btnmatrix.o(.text.lv_btnmatrix_destructor) referenced from lv_btnmatrix.o(.rodata.lv_btnmatrix_class)
- lv_btnmatrix_event from lv_btnmatrix.o(.text.lv_btnmatrix_event) referenced from lv_btnmatrix.o(.rodata.lv_btnmatrix_class)
- lv_calendar_constructor from lv_calendar.o(.text.lv_calendar_constructor) referenced from lv_calendar.o(.rodata.lv_calendar_class)
- lv_chart_constructor from lv_chart.o(.text.lv_chart_constructor) referenced from lv_chart.o(.rodata.lv_chart_class)
- lv_chart_destructor from lv_chart.o(.text.lv_chart_destructor) referenced from lv_chart.o(.rodata.lv_chart_class)
- lv_chart_event from lv_chart.o(.text.lv_chart_event) referenced from lv_chart.o(.rodata.lv_chart_class)
- lv_checkbox_constructor from lv_checkbox.o(.text.lv_checkbox_constructor) referenced from lv_checkbox.o(.rodata.lv_checkbox_class)
- lv_checkbox_destructor from lv_checkbox.o(.text.lv_checkbox_destructor) referenced from lv_checkbox.o(.rodata.lv_checkbox_class)
- lv_checkbox_event from lv_checkbox.o(.text.lv_checkbox_event) referenced from lv_checkbox.o(.rodata.lv_checkbox_class)
- lv_color_brightness from lv_led.o(.text.lv_color_brightness) referenced from lv_led.o(.text.lv_led_event)
- lv_color_mix from lv_draw_sw_transform.o(.text.lv_color_mix) referenced from lv_draw_sw_transform.o(.text.lv_draw_sw_transform)
- lv_color_mix from lv_led.o(.text.lv_color_mix) referenced from lv_led.o(.text.lv_led_event)
- lv_colorwheel_constructor from lv_colorwheel.o(.text.lv_colorwheel_constructor) referenced from lv_colorwheel.o(.rodata.lv_colorwheel_class)
- lv_colorwheel_event from lv_colorwheel.o(.text.lv_colorwheel_event) referenced from lv_colorwheel.o(.rodata.lv_colorwheel_class)
- lv_disp_dpx from lv_theme_default.o(.text.lv_disp_dpx) referenced from lv_theme_default.o(.text.style_init)
- lv_draw_mask_angle from lv_draw_mask.o(.text.lv_draw_mask_angle) referenced from lv_draw_mask.o(.text.lv_draw_mask_angle_init)
- lv_draw_mask_fade from lv_draw_mask.o(.text.lv_draw_mask_fade) referenced from lv_draw_mask.o(.text.lv_draw_mask_fade_init)
- lv_draw_mask_free_param from lv_draw_mask.o(.text.lv_draw_mask_free_param) referenced from lv_meter.o(.text.lv_meter_event)
- lv_draw_mask_line from lv_draw_mask.o(.text.lv_draw_mask_line) referenced from lv_draw_mask.o(.text.lv_draw_mask_line_points_init)
- lv_draw_mask_radius from lv_draw_mask.o(.text.lv_draw_mask_radius) referenced from lv_draw_mask.o(.text.lv_draw_mask_radius_init)
- lv_draw_mask_radius_init from lv_draw_mask.o(.text.lv_draw_mask_radius_init) referenced from lv_meter.o(.text.lv_meter_event)
- lv_draw_mask_remove_id from lv_draw_mask.o(.text.lv_draw_mask_remove_id) referenced from lv_draw_sw_line.o(.text.lv_draw_sw_line)
- lv_draw_sw_arc from lv_draw_sw_arc.o(.text.lv_draw_sw_arc) referenced from lv_draw_sw.o(.text.lv_draw_sw_init_ctx)
- lv_draw_sw_bg from lv_draw_sw_rect.o(.text.lv_draw_sw_bg) referenced from lv_draw_sw.o(.text.lv_draw_sw_init_ctx)
- lv_draw_sw_blend_basic from lv_draw_sw_blend.o(.text.lv_draw_sw_blend_basic) referenced from lv_draw_sw.o(.text.lv_draw_sw_init_ctx)
- lv_draw_sw_buffer_copy from lv_draw_sw.o(.text.lv_draw_sw_buffer_copy) referenced from lv_draw_sw.o(.text.lv_draw_sw_init_ctx)
- lv_draw_sw_img_decoded from lv_draw_sw_img.o(.text.lv_draw_sw_img_decoded) referenced from lv_draw_sw.o(.text.lv_draw_sw_init_ctx)
- lv_draw_sw_init_ctx from lv_draw_sw.o(.text.lv_draw_sw_init_ctx) referenced from lv_hal_disp.o(.text.lv_disp_drv_init)
- lv_draw_sw_layer_adjust from lv_draw_sw_layer.o(.text.lv_draw_sw_layer_adjust) referenced from lv_draw_sw.o(.text.lv_draw_sw_init_ctx)
- lv_draw_sw_layer_blend from lv_draw_sw_layer.o(.text.lv_draw_sw_layer_blend) referenced from lv_draw_sw.o(.text.lv_draw_sw_init_ctx)
- lv_draw_sw_layer_create from lv_draw_sw_layer.o(.text.lv_draw_sw_layer_create) referenced from lv_draw_sw.o(.text.lv_draw_sw_init_ctx)
- lv_draw_sw_layer_destroy from lv_draw_sw_layer.o(.text.lv_draw_sw_layer_destroy) referenced from lv_draw_sw.o(.text.lv_draw_sw_init_ctx)
- lv_draw_sw_letter from lv_draw_sw_letter.o(.text.lv_draw_sw_letter) referenced from lv_draw_sw.o(.text.lv_draw_sw_init_ctx)
- lv_draw_sw_line from lv_draw_sw_line.o(.text.lv_draw_sw_line) referenced from lv_draw_sw.o(.text.lv_draw_sw_init_ctx)
- lv_draw_sw_polygon from lv_draw_sw_polygon.o(.text.lv_draw_sw_polygon) referenced from lv_draw_sw.o(.text.lv_draw_sw_init_ctx)
- lv_draw_sw_rect from lv_draw_sw_rect.o(.text.lv_draw_sw_rect) referenced from lv_draw_sw.o(.text.lv_draw_sw_init_ctx)
- lv_draw_sw_transform from lv_draw_sw_transform.o(.text.lv_draw_sw_transform) referenced from lv_draw_sw.o(.text.lv_draw_sw_init_ctx)
- lv_draw_sw_wait_for_finish from lv_draw_sw.o(.text.lv_draw_sw_wait_for_finish) referenced from lv_draw_sw.o(.text.lv_draw_sw_init_ctx)
- lv_dropdown_constructor from lv_dropdown.o(.text.lv_dropdown_constructor) referenced from lv_dropdown.o(.rodata.lv_dropdown_class)
- lv_dropdown_destructor from lv_dropdown.o(.text.lv_dropdown_destructor) referenced from lv_dropdown.o(.rodata.lv_dropdown_class)
- lv_dropdown_event from lv_dropdown.o(.text.lv_dropdown_event) referenced from lv_dropdown.o(.rodata.lv_dropdown_class)
- lv_dropdown_list_event from lv_dropdown.o(.text.lv_dropdown_list_event) referenced from lv_dropdown.o(.rodata.lv_dropdownlist_class)
- lv_dropdownlist_constructor from lv_dropdown.o(.text.lv_dropdownlist_constructor) referenced from lv_dropdown.o(.rodata.lv_dropdownlist_class)
- lv_dropdownlist_destructor from lv_dropdown.o(.text.lv_dropdownlist_destructor) referenced from lv_dropdown.o(.rodata.lv_dropdownlist_class)
- lv_event_send from lv_event.o(.text.lv_event_send) referenced from lv_refr.o(.text.lv_obj_redraw)
- lv_event_send from lv_event.o(.text.lv_event_send) referenced from lv_obj_tree.o(.text.lv_obj_set_parent)
- lv_event_send from lv_event.o(.text.lv_event_send) referenced from lv_refr.o(.text.refr_obj_and_children)
- lv_font_get_bitmap_fmt_txt from lv_font_fmt_txt.o(.text.lv_font_get_bitmap_fmt_txt) referenced from lv_font_montserrat_14.o(.rodata.lv_font_montserrat_14)
- lv_font_get_glyph_dsc_fmt_txt from lv_font_fmt_txt.o(.text.lv_font_get_glyph_dsc_fmt_txt) referenced from lv_font_montserrat_14.o(.rodata.lv_font_montserrat_14)
- lv_img_constructor from lv_img.o(.text.lv_img_constructor) referenced from lv_img.o(.rodata.lv_img_class)
- lv_img_decoder_built_in_close from lv_img_decoder.o(.text.lv_img_decoder_built_in_close) referenced from lv_img_decoder.o(.text._lv_img_decoder_init)
- lv_img_decoder_built_in_info from lv_img_decoder.o(.text.lv_img_decoder_built_in_info) referenced from lv_img_decoder.o(.text._lv_img_decoder_init)
- lv_img_decoder_built_in_open from lv_img_decoder.o(.text.lv_img_decoder_built_in_open) referenced from lv_img_decoder.o(.text._lv_img_decoder_init)
- lv_img_decoder_built_in_read_line from lv_img_decoder.o(.text.lv_img_decoder_built_in_read_line) referenced from lv_img_decoder.o(.text._lv_img_decoder_init)
- lv_img_destructor from lv_img.o(.text.lv_img_destructor) referenced from lv_img.o(.rodata.lv_img_class)
- lv_img_event from lv_img.o(.text.lv_img_event) referenced from lv_img.o(.rodata.lv_img_class)
- lv_indev_read_timer_cb from lv_indev.o(.text.lv_indev_read_timer_cb) referenced from lv_hal_indev.o(.text.lv_indev_drv_register)
- lv_keyboard_constructor from lv_keyboard.o(.text.lv_keyboard_constructor) referenced from lv_keyboard.o(.rodata.lv_keyboard_class)
- lv_keyboard_def_event_cb from lv_keyboard.o(.text.lv_keyboard_def_event_cb) referenced from lv_keyboard.o(.text.lv_keyboard_constructor)
- lv_label_constructor from lv_label.o(.text.lv_label_constructor) referenced from lv_label.o(.rodata.lv_label_class)
- lv_label_destructor from lv_label.o(.text.lv_label_destructor) referenced from lv_label.o(.rodata.lv_label_class)
- lv_label_event from lv_label.o(.text.lv_label_event) referenced from lv_label.o(.rodata.lv_label_class)
- lv_led_constructor from lv_led.o(.text.lv_led_constructor) referenced from lv_led.o(.rodata.lv_led_class)
- lv_led_event from lv_led.o(.text.lv_led_event) referenced from lv_led.o(.rodata.lv_led_class)
- lv_line_constructor from lv_line.o(.text.lv_line_constructor) referenced from lv_line.o(.rodata.lv_line_class)
- lv_line_event from lv_line.o(.text.lv_line_event) referenced from lv_line.o(.rodata.lv_line_class)
- lv_mem_buf_release from lv_mem.o(.text.lv_mem_buf_release) referenced from lv_grid.o(.text.grid_update)
- lv_mem_walker from lv_mem.o(.text.lv_mem_walker) referenced from lv_mem.o(.text.lv_mem_monitor)
- lv_menu_back_event_cb from lv_menu.o(.text.lv_menu_back_event_cb) referenced from lv_menu.o(.text.lv_menu_constructor)
- lv_menu_constructor from lv_menu.o(.text.lv_menu_constructor) referenced from lv_menu.o(.rodata.lv_menu_class)
- lv_menu_cont_constructor from lv_menu.o(.text.lv_menu_cont_constructor) referenced from lv_menu.o(.rodata.lv_menu_cont_class)
- lv_menu_destructor from lv_menu.o(.text.lv_menu_destructor) referenced from lv_menu.o(.rodata.lv_menu_class)
- lv_menu_page_constructor from lv_menu.o(.text.lv_menu_page_constructor) referenced from lv_menu.o(.rodata.lv_menu_page_class)
- lv_menu_page_destructor from lv_menu.o(.text.lv_menu_page_destructor) referenced from lv_menu.o(.rodata.lv_menu_page_class)
- lv_menu_section_constructor from lv_menu.o(.text.lv_menu_section_constructor) referenced from lv_menu.o(.rodata.lv_menu_section_class)
- lv_menu_value_changed_event_cb from lv_menu.o(.text.lv_menu_value_changed_event_cb) referenced from lv_menu.o(.text.lv_menu_constructor)
- lv_meter_constructor from lv_meter.o(.text.lv_meter_constructor) referenced from lv_meter.o(.rodata.lv_meter_class)
- lv_meter_destructor from lv_meter.o(.text.lv_meter_destructor) referenced from lv_meter.o(.rodata.lv_meter_class)
- lv_meter_event from lv_meter.o(.text.lv_meter_event) referenced from lv_meter.o(.rodata.lv_meter_class)
- lv_obj_add_event_cb from lv_event.o(.text.lv_obj_add_event_cb) referenced 2 times from lv_calendar_header_arrow.o(.text.my_constructor)
- lv_obj_add_flag from lv_obj.o(.text.lv_obj_add_flag) referenced from lv_checkbox.o(.text.lv_checkbox_constructor)
- lv_obj_add_flag from lv_obj.o(.text.lv_obj_add_flag) referenced from lv_menu.o(.text.lv_menu_constructor)
- lv_obj_add_style from lv_obj_style.o(.text.lv_obj_add_style) referenced from lv_theme_default.o(.text.theme_apply)
- lv_obj_constructor from lv_obj.o(.text.lv_obj_constructor) referenced from lv_obj.o(.rodata.lv_obj_class)
- lv_obj_create from lv_obj.o(.text.lv_obj_create) referenced from lv_hal_disp.o(.text.lv_disp_drv_register)
- lv_obj_destructor from lv_obj.o(.text.lv_obj_destructor) referenced from lv_obj.o(.rodata.lv_obj_class)
- lv_obj_event from lv_obj.o(.text.lv_obj_event) referenced from lv_obj.o(.rodata.lv_obj_class)
- lv_obj_get_height from lv_obj_pos.o(.text.lv_obj_get_height) referenced from lv_flex.o(.text.find_track_end)
- lv_obj_get_style_prop from lv_obj_style.o(.text.lv_obj_get_style_prop) referenced from lv_flex.o(.text.flex_update)
- lv_obj_get_style_prop from lv_obj_style.o(.text.lv_obj_get_style_prop) referenced from lv_grid.o(.text.grid_update)
- lv_obj_get_style_prop from lv_obj_style.o(.text.lv_obj_get_style_prop) referenced from lv_arc.o(.text.knob_get_extra_size)
- lv_obj_get_style_prop from lv_obj_style.o(.text.lv_obj_get_style_prop) referenced from lv_checkbox.o(.text.lv_checkbox_event)
- lv_obj_get_style_prop from lv_obj_style.o(.text.lv_obj_get_style_prop) referenced from lv_img.o(.text.lv_img_event)
- lv_obj_get_style_prop from lv_obj_style.o(.text.lv_obj_get_style_prop) referenced from lv_img.o(.text.lv_img_set_src)
- lv_obj_get_style_prop from lv_obj_style.o(.text.lv_obj_get_style_prop) referenced from lv_obj_draw.o(.text.lv_obj_init_draw_label_dsc)
- lv_obj_get_style_prop from lv_obj_style.o(.text.lv_obj_get_style_prop) referenced from lv_obj_draw.o(.text.lv_obj_init_draw_rect_dsc)
- lv_obj_get_width from lv_obj_pos.o(.text.lv_obj_get_width) referenced from lv_flex.o(.text.find_track_end)
- lv_obj_set_flex_flow from lv_flex.o(.text.lv_obj_set_flex_flow) referenced from lv_menu.o(.text.lv_menu_constructor)
- lv_obj_transform_point from lv_obj_pos.o(.text.lv_obj_transform_point) referenced from lv_obj_pos.o(.text.lv_obj_get_transformed_area)
- lv_point_transform from lv_area.o(.text.lv_point_transform) referenced from lv_img_buf.o(.text._lv_img_buf_get_transformed_area)
- lv_roller_constructor from lv_roller.o(.text.lv_roller_constructor) referenced from lv_roller.o(.rodata.lv_roller_class)
- lv_roller_event from lv_roller.o(.text.lv_roller_event) referenced from lv_roller.o(.rodata.lv_roller_class)
- lv_roller_label_event from lv_roller.o(.text.lv_roller_label_event) referenced from lv_roller.o(.rodata.lv_roller_label_class)
- lv_slider_constructor from lv_slider.o(.text.lv_slider_constructor) referenced from lv_slider.o(.rodata.lv_slider_class)
- lv_slider_event from lv_slider.o(.text.lv_slider_event) referenced from lv_slider.o(.rodata.lv_slider_class)
- lv_spinbox_constructor from lv_spinbox.o(.text.lv_spinbox_constructor) referenced from lv_spinbox.o(.rodata.lv_spinbox_class)
- lv_spinbox_event from lv_spinbox.o(.text.lv_spinbox_event) referenced from lv_spinbox.o(.rodata.lv_spinbox_class)
- lv_spinner_constructor from lv_spinner.o(.text.lv_spinner_constructor) referenced from lv_spinner.o(.rodata.lv_spinner_class)
- lv_style_prop_has_flag from lv_obj_style.o(.text.lv_style_prop_has_flag) referenced from lv_obj_style.o(.text.lv_obj_refresh_style)
- lv_style_register_prop from lv_style.o(.text.lv_style_register_prop) referenced from lv_flex.o(.text.lv_flex_init)
- lv_style_register_prop from lv_style.o(.text.lv_style_register_prop) referenced from lv_grid.o(.text.lv_grid_init)
- lv_style_set_bg_color from lv_style_gen.o(.text.lv_style_set_bg_color) referenced from lv_theme_default.o(.text.style_init)
- lv_style_set_bg_opa from lv_style_gen.o(.text.lv_style_set_bg_opa) referenced 2 times from lv_theme_default.o(.text.style_init)
- lv_style_set_line_color from lv_style_gen.o(.text.lv_style_set_line_color) referenced from lv_theme_default.o(.text.style_init)
- lv_style_set_line_width from lv_style_gen.o(.text.lv_style_set_line_width) referenced from lv_theme_default.o(.text.style_init)
- lv_style_set_pad_all from lv_theme_default.o(.text.lv_style_set_pad_all) referenced from lv_theme_default.o(.text.style_init)
- lv_style_set_pad_column from lv_style_gen.o(.text.lv_style_set_pad_column) referenced from lv_theme_default.o(.text.style_init)
- lv_style_set_pad_gap from lv_theme_default.o(.text.lv_style_set_pad_gap) referenced from lv_theme_default.o(.text.style_init)
- lv_style_set_prop_helper from lv_style.o(.text.lv_style_set_prop_helper) referenced from lv_style.o(.text.lv_style_set_prop)
- lv_style_set_radius from lv_style_gen.o(.text.lv_style_set_radius) referenced from lv_theme_default.o(.text.style_init)
- lv_style_set_text_color from lv_style_gen.o(.text.lv_style_set_text_color) referenced from lv_theme_default.o(.text.style_init)
- lv_switch_anim_exec_cb from lv_switch.o(.text.lv_switch_anim_exec_cb) referenced from lv_switch.o(.text.lv_switch_event)
- lv_switch_anim_ready from lv_switch.o(.text.lv_switch_anim_ready) referenced from lv_switch.o(.text.lv_switch_event)
- lv_switch_constructor from lv_switch.o(.text.lv_switch_constructor) referenced from lv_switch.o(.rodata.lv_switch_class)
- lv_switch_destructor from lv_switch.o(.text.lv_switch_destructor) referenced from lv_switch.o(.rodata.lv_switch_class)
- lv_switch_event from lv_switch.o(.text.lv_switch_event) referenced from lv_switch.o(.rodata.lv_switch_class)
- lv_table_constructor from lv_table.o(.text.lv_table_constructor) referenced from lv_table.o(.rodata.lv_table_class)
- lv_table_destructor from lv_table.o(.text.lv_table_destructor) referenced from lv_table.o(.rodata.lv_table_class)
- lv_table_event from lv_table.o(.text.lv_table_event) referenced from lv_table.o(.rodata.lv_table_class)
- lv_tabview_constructor from lv_tabview.o(.text.lv_tabview_constructor) referenced from lv_tabview.o(.rodata.lv_tabview_class)
- lv_tabview_destructor from lv_tabview.o(.text.lv_tabview_destructor) referenced from lv_tabview.o(.rodata.lv_tabview_class)
- lv_tabview_event from lv_tabview.o(.text.lv_tabview_event) referenced from lv_tabview.o(.rodata.lv_tabview_class)
- lv_textarea_constructor from lv_textarea.o(.text.lv_textarea_constructor) referenced from lv_textarea.o(.rodata.lv_textarea_class)
- lv_textarea_destructor from lv_textarea.o(.text.lv_textarea_destructor) referenced from lv_textarea.o(.rodata.lv_textarea_class)
- lv_textarea_event from lv_textarea.o(.text.lv_textarea_event) referenced from lv_textarea.o(.rodata.lv_textarea_class)
- lv_tileview_constructor from lv_tileview.o(.text.lv_tileview_constructor) referenced from lv_tileview.o(.rodata.lv_tileview_class)
- lv_tileview_tile_constructor from lv_tileview.o(.text.lv_tileview_tile_constructor) referenced from lv_tileview.o(.rodata.lv_tileview_tile_class)
- lv_trigo_sin from lv_math.o(.text.lv_trigo_sin) referenced from lv_draw_arc.o(.text.lv_draw_arc_get_area)
- lv_trigo_sin from lv_math.o(.text.lv_trigo_sin) referenced from lv_draw_sw_arc.o(.text.lv_draw_sw_arc)
- lv_trigo_sin from lv_math.o(.text.lv_trigo_sin) referenced from lv_draw_sw_transform.o(.text.lv_draw_sw_transform)
- lv_trigo_sin from lv_math.o(.text.lv_trigo_sin) referenced from lv_area.o(.text.lv_point_transform)
- lv_txt_unicode_to_utf8 from lv_txt.o(.text.lv_txt_unicode_to_utf8) referenced from lv_txt.o(.data._lv_txt_unicode_to_encoded)
- lv_txt_utf8_get_byte_id from lv_txt.o(.text.lv_txt_utf8_get_byte_id) referenced from lv_txt.o(.data._lv_txt_encoded_get_byte_id)
- lv_txt_utf8_get_char_id from lv_txt.o(.text.lv_txt_utf8_get_char_id) referenced from lv_txt.o(.data._lv_txt_encoded_get_char_id)
- lv_txt_utf8_get_length from lv_txt.o(.text.lv_txt_utf8_get_length) referenced from lv_txt.o(.data._lv_txt_get_encoded_length)
- lv_txt_utf8_next from lv_txt.o(.text.lv_txt_utf8_next) referenced from lv_txt.o(.data..L_MergedGlobals)
- lv_txt_utf8_prev from lv_txt.o(.text.lv_txt_utf8_prev) referenced from lv_txt.o(.data._lv_txt_encoded_prev)
- lv_txt_utf8_size from lv_txt.o(.text.lv_txt_utf8_size) referenced from lv_txt.o(.data..L_MergedGlobals)
- lv_win_constructor from lv_win.o(.text.lv_win_constructor) referenced from lv_win.o(.rodata.lv_win_class)
- mask_event_cb from gui.o(.text.mask_event_cb) referenced from gui.o(.text.lv_example_roller_3)
- month_event_cb from lv_calendar_header_arrow.o(.text.month_event_cb) referenced 2 times from lv_calendar_header_arrow.o(.text.my_constructor)
- my_constructor from lv_calendar_header_arrow.o(.text.my_constructor) referenced from lv_calendar_header_arrow.o(.rodata.lv_calendar_header_arrow_class)
- my_constructor from lv_calendar_header_dropdown.o(.text.my_constructor) referenced from lv_calendar_header_dropdown.o(.rodata.lv_calendar_header_dropdown_class)
- pwd_char_hider_anim from lv_textarea.o(.text.pwd_char_hider_anim) referenced from lv_textarea.o(.text.auto_hide_characters)
- pwd_char_hider_anim_ready from lv_textarea.o(.text.pwd_char_hider_anim_ready) referenced from lv_textarea.o(.text.auto_hide_characters)
- scroll_anim_ready_cb from lv_obj_scroll.o(.text.scroll_anim_ready_cb) referenced from lv_obj_scroll.o(.text.lv_obj_scroll_by)
- scroll_anim_ready_cb from lv_roller.o(.text.scroll_anim_ready_cb) referenced from lv_roller.o(.text.refr_position)
- scroll_x_anim from lv_obj_scroll.o(.text.scroll_x_anim) referenced from lv_obj_scroll.o(.text.lv_obj_get_scroll_end)
- scroll_x_anim from lv_obj_scroll.o(.text.scroll_x_anim) referenced from lv_obj_scroll.o(.text.lv_obj_scroll_to_x)
- scroll_x_anim from lv_obj_scroll.o(.text.scroll_x_anim) referenced from lv_obj_scroll.o(.text.scroll_area_into_view)
- scroll_y_anim from lv_obj_scroll.o(.text.scroll_y_anim) referenced from lv_obj_scroll.o(.text.lv_obj_get_scroll_end)
- scroll_y_anim from lv_obj_scroll.o(.text.scroll_y_anim) referenced from lv_obj_scroll.o(.text.lv_obj_scroll_to_y)
- scroll_y_anim from lv_obj_scroll.o(.text.scroll_y_anim) referenced from lv_obj_scroll.o(.text.scroll_area_into_view)
- set_ofs_x_anim from lv_label.o(.text.set_ofs_x_anim) referenced from lv_label.o(.text.lv_label_refr_text)
- set_ofs_x_anim from lv_label.o(.text.set_ofs_x_anim) referenced from lv_label.o(.text.lv_label_set_long_mode)
- set_ofs_y_anim from lv_label.o(.text.set_ofs_y_anim) referenced from lv_label.o(.text.lv_label_refr_text)
- set_ofs_y_anim from lv_label.o(.text.set_ofs_y_anim) referenced from lv_label.o(.text.lv_label_set_long_mode)
- set_y_anim from lv_roller.o(.text.set_y_anim) referenced from lv_roller.o(.text.lv_roller_event)
- set_y_anim from lv_roller.o(.text.set_y_anim) referenced from lv_roller.o(.text.refr_position)
- style_init_reset from lv_theme_default.o(.text.style_init_reset) referenced from lv_theme_default.o(.text.style_init)
- theme_apply from lv_theme_default.o(.text.theme_apply) referenced from lv_theme_default.o(.text.lv_theme_default_init)
- tileview_event_cb from lv_tileview.o(.text.tileview_event_cb) referenced from lv_tileview.o(.text.lv_tileview_constructor)
- touchpad_read from lv_port_indev.o(.text.touchpad_read) referenced from lv_port_indev.o(.text.lv_port_indev_init)
- trans_anim_cb from lv_obj_style.o(.text.trans_anim_cb) referenced from lv_obj_style.o(.text._lv_obj_style_create_transition)
- trans_anim_ready_cb from lv_obj_style.o(.text.trans_anim_ready_cb) referenced from lv_obj_style.o(.text._lv_obj_style_create_transition)
- trans_anim_start_cb from lv_obj_style.o(.text.trans_anim_start_cb) referenced from lv_obj_style.o(.text._lv_obj_style_create_transition)
- unicode_list_compare from lv_font_fmt_txt.o(.text.unicode_list_compare) referenced from lv_font_fmt_txt.o(.text.get_glyph_dsc_id)
- value_changed_event_cb from lv_calendar_header_arrow.o(.text.value_changed_event_cb) referenced 2 times from lv_calendar_header_arrow.o(.text.my_constructor)
- year_event_cb from lv_calendar_header_dropdown.o(.text.year_event_cb) referenced from lv_calendar_header_dropdown.o(.text.my_constructor)

### Global Symbols

__main (Thumb, 8 bytes, Stack size 0 bytes, __main.o(!!!main))

[Calls]

- >> __scatterload
- >> __rt_entry

[Address Reference Count : 1]

- startup_stm32l431xx.o(.text)

__scatterload (Thumb, 0 bytes, Stack size unknown bytes, __scatter.o(!!!scatter))

[Called By]

- >> __main

__scatterload_rt2 (Thumb, 44 bytes, Stack size unknown bytes, __scatter.o(!!!scatter), UNUSED)

[Calls]

- >> __rt_entry

__scatterload_rt2_thumb_only (Thumb, 0 bytes, Stack size unknown bytes, __scatter.o(!!!scatter), UNUSED)

__scatterload_null (Thumb, 0 bytes, Stack size unknown bytes, __scatter.o(!!!scatter), UNUSED)

__scatterload_copy (Thumb, 26 bytes, Stack size unknown bytes, __scatter_copy.o(!!handler_copy), UNUSED)

[Calls]

- >> __scatterload_copy

[Called By]

- >> __scatterload_copy

__scatterload_zeroinit (Thumb, 28 bytes, Stack size unknown bytes, __scatter_zi.o(!!handler_zi), UNUSED)

__rt_lib_init (Thumb, 0 bytes, Stack size unknown bytes, libinit.o(.ARM.Collect$$libinit$$00000000))

[Called By]

- >> __rt_entry_li

__rt_lib_init_fp_1 (Thumb, 0 bytes, Stack size unknown bytes, libinit2.o(.ARM.Collect$$libinit$$00000001))

[Calls]

- >> _fp_init

__rt_lib_init_alloca_1 (Thumb, 0 bytes, Stack size unknown bytes, libinit2.o(.ARM.Collect$$libinit$$0000002E))

__rt_lib_init_argv_1 (Thumb, 0 bytes, Stack size unknown bytes, libinit2.o(.ARM.Collect$$libinit$$0000002C))

__rt_lib_init_atexit_1 (Thumb, 0 bytes, Stack size unknown bytes, libinit2.o(.ARM.Collect$$libinit$$0000001B))

__rt_lib_init_clock_1 (Thumb, 0 bytes, Stack size unknown bytes, libinit2.o(.ARM.Collect$$libinit$$00000021))

__rt_lib_init_cpp_1 (Thumb, 0 bytes, Stack size unknown bytes, libinit2.o(.ARM.Collect$$libinit$$00000032))

__rt_lib_init_exceptions_1 (Thumb, 0 bytes, Stack size unknown bytes, libinit2.o(.ARM.Collect$$libinit$$00000030))

__rt_lib_init_fp_trap_1 (Thumb, 0 bytes, Stack size unknown bytes, libinit2.o(.ARM.Collect$$libinit$$0000001F))

__rt_lib_init_getenv_1 (Thumb, 0 bytes, Stack size unknown bytes, libinit2.o(.ARM.Collect$$libinit$$00000023))

__rt_lib_init_heap_1 (Thumb, 0 bytes, Stack size unknown bytes, libinit2.o(.ARM.Collect$$libinit$$0000000A))

__rt_lib_init_lc_collate_1 (Thumb, 0 bytes, Stack size unknown bytes, libinit2.o(.ARM.Collect$$libinit$$00000011))

__rt_lib_init_lc_ctype_1 (Thumb, 0 bytes, Stack size unknown bytes, libinit2.o(.ARM.Collect$$libinit$$00000013))

__rt_lib_init_lc_monetary_1 (Thumb, 0 bytes, Stack size unknown bytes, libinit2.o(.ARM.Collect$$libinit$$00000015))

__rt_lib_init_lc_numeric_1 (Thumb, 0 bytes, Stack size unknown bytes, libinit2.o(.ARM.Collect$$libinit$$00000017))

__rt_lib_init_lc_time_1 (Thumb, 0 bytes, Stack size unknown bytes, libinit2.o(.ARM.Collect$$libinit$$00000019))

__rt_lib_init_preinit_1 (Thumb, 0 bytes, Stack size unknown bytes, libinit2.o(.ARM.Collect$$libinit$$00000004))

__rt_lib_init_rand_1 (Thumb, 0 bytes, Stack size unknown bytes, libinit2.o(.ARM.Collect$$libinit$$0000000E))

__rt_lib_init_return (Thumb, 0 bytes, Stack size unknown bytes, libinit2.o(.ARM.Collect$$libinit$$00000033))

__rt_lib_init_signal_1 (Thumb, 0 bytes, Stack size unknown bytes, libinit2.o(.ARM.Collect$$libinit$$0000001D))

__rt_lib_init_stdio_1 (Thumb, 0 bytes, Stack size unknown bytes, libinit2.o(.ARM.Collect$$libinit$$00000025))

__rt_lib_init_user_alloc_1 (Thumb, 0 bytes, Stack size unknown bytes, libinit2.o(.ARM.Collect$$libinit$$0000000C))

__rt_lib_shutdown (Thumb, 0 bytes, Stack size unknown bytes, libshutdown.o(.ARM.Collect$$libshutdown$$00000000))

[Called By]

- >> __rt_exit_ls

__rt_lib_shutdown_cpp_1 (Thumb, 0 bytes, Stack size unknown bytes, libshutdown2.o(.ARM.Collect$$libshutdown$$00000002))

__rt_lib_shutdown_fp_trap_1 (Thumb, 0 bytes, Stack size unknown bytes, libshutdown2.o(.ARM.Collect$$libshutdown$$00000007))

__rt_lib_shutdown_heap_1 (Thumb, 0 bytes, Stack size unknown bytes, libshutdown2.o(.ARM.Collect$$libshutdown$$0000000F))

__rt_lib_shutdown_return (Thumb, 0 bytes, Stack size unknown bytes, libshutdown2.o(.ARM.Collect$$libshutdown$$00000010))

__rt_lib_shutdown_signal_1 (Thumb, 0 bytes, Stack size unknown bytes, libshutdown2.o(.ARM.Collect$$libshutdown$$0000000A))

__rt_lib_shutdown_stdio_1 (Thumb, 0 bytes, Stack size unknown bytes, libshutdown2.o(.ARM.Collect$$libshutdown$$00000004))

__rt_lib_shutdown_user_alloc_1 (Thumb, 0 bytes, Stack size unknown bytes, libshutdown2.o(.ARM.Collect$$libshutdown$$0000000C))

__rt_entry (Thumb, 0 bytes, Stack size unknown bytes, __rtentry.o(.ARM.Collect$$rtentry$$00000000))

[Called By]

- >> __scatterload_rt2
- >> __main

__rt_entry_presh_1 (Thumb, 0 bytes, Stack size unknown bytes, __rtentry2.o(.ARM.Collect$$rtentry$$00000002))

__rt_entry_sh (Thumb, 0 bytes, Stack size unknown bytes, __rtentry4.o(.ARM.Collect$$rtentry$$00000004))

[Stack]

- Max Depth = 8 + Unknown Stack Size
- Call Chain = __rt_entry_sh ⇒ __user_setup_stackheap

[Calls]

- >> __user_setup_stackheap

__rt_entry_li (Thumb, 0 bytes, Stack size unknown bytes, __rtentry2.o(.ARM.Collect$$rtentry$$0000000A))

[Calls]

- >> __rt_lib_init

__rt_entry_postsh_1 (Thumb, 0 bytes, Stack size unknown bytes, __rtentry2.o(.ARM.Collect$$rtentry$$00000009))

__rt_entry_main (Thumb, 0 bytes, Stack size unknown bytes, __rtentry2.o(.ARM.Collect$$rtentry$$0000000D))

[Stack]

- Max Depth = 472 + Unknown Stack Size
- Call Chain = __rt_entry_main ⇒ main ⇒ GUI_Application ⇒ lv_example_roller_3 ⇒ lv_roller_set_options ⇒ lv_label_set_text ⇒ lv_label_refr_text ⇒ lv_label_get_letter_on ⇒ _lv_txt_get_next_line ⇒ lv_font_get_glyph_width ⇒ lv_font_get_glyph_dsc

[Calls]

- >> main
- >> exit

__rt_entry_postli_1 (Thumb, 0 bytes, Stack size unknown bytes, __rtentry2.o(.ARM.Collect$$rtentry$$0000000C))

__rt_exit (Thumb, 0 bytes, Stack size unknown bytes, rtexit.o(.ARM.Collect$$rtexit$$00000000))

[Called By]

- >> exit

__rt_exit_ls (Thumb, 0 bytes, Stack size unknown bytes, rtexit2.o(.ARM.Collect$$rtexit$$00000003))

[Calls]

- >> __rt_lib_shutdown

__rt_exit_prels_1 (Thumb, 0 bytes, Stack size unknown bytes, rtexit2.o(.ARM.Collect$$rtexit$$00000002))

__rt_exit_exit (Thumb, 0 bytes, Stack size unknown bytes, rtexit2.o(.ARM.Collect$$rtexit$$00000004))

[Calls]

- >> _sys_exit

Reset_Handler (Thumb, 8 bytes, Stack size 0 bytes, startup_stm32l431xx.o(.text))
[Address Reference Count : 1]

- startup_stm32l431xx.o(RESET)

ADC1_IRQHandler (Thumb, 0 bytes, Stack size 0 bytes, startup_stm32l431xx.o(.text))

[Calls]

- >> ADC1_IRQHandler

[Called By]

- >> ADC1_IRQHandler

[Address Reference Count : 1]

- startup_stm32l431xx.o(RESET)

CAN1_RX0_IRQHandler (Thumb, 0 bytes, Stack size 0 bytes, startup_stm32l431xx.o(.text))
[Address Reference Count : 1]

- startup_stm32l431xx.o(RESET)

CAN1_RX1_IRQHandler (Thumb, 0 bytes, Stack size 0 bytes, startup_stm32l431xx.o(.text))
[Address Reference Count : 1]

- startup_stm32l431xx.o(RESET)

CAN1_SCE_IRQHandler (Thumb, 0 bytes, Stack size 0 bytes, startup_stm32l431xx.o(.text))
[Address Reference Count : 1]

- startup_stm32l431xx.o(RESET)

CAN1_TX_IRQHandler (Thumb, 0 bytes, Stack size 0 bytes, startup_stm32l431xx.o(.text))
[Address Reference Count : 1]

- startup_stm32l431xx.o(RESET)

COMP_IRQHandler (Thumb, 0 bytes, Stack size 0 bytes, startup_stm32l431xx.o(.text))
[Address Reference Count : 1]

- startup_stm32l431xx.o(RESET)

CRS_IRQHandler (Thumb, 0 bytes, Stack size 0 bytes, startup_stm32l431xx.o(.text))
[Address Reference Count : 1]

- startup_stm32l431xx.o(RESET)

DMA1_Channel1_IRQHandler (Thumb, 0 bytes, Stack size 0 bytes, startup_stm32l431xx.o(.text))
[Address Reference Count : 1]

- startup_stm32l431xx.o(RESET)

DMA1_Channel2_IRQHandler (Thumb, 0 bytes, Stack size 0 bytes, startup_stm32l431xx.o(.text))
[Address Reference Count : 1]

- startup_stm32l431xx.o(RESET)

DMA1_Channel4_IRQHandler (Thumb, 0 bytes, Stack size 0 bytes, startup_stm32l431xx.o(.text))
[Address Reference Count : 1]

- startup_stm32l431xx.o(RESET)

DMA1_Channel5_IRQHandler (Thumb, 0 bytes, Stack size 0 bytes, startup_stm32l431xx.o(.text))
[Address Reference Count : 1]

- startup_stm32l431xx.o(RESET)

DMA1_Channel6_IRQHandler (Thumb, 0 bytes, Stack size 0 bytes, startup_stm32l431xx.o(.text))
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

QUADSPI_IRQHandler (Thumb, 0 bytes, Stack size 0 bytes, startup_stm32l431xx.o(.text))
[Address Reference Count : 1]

- startup_stm32l431xx.o(RESET)

RCC_IRQHandler (Thumb, 0 bytes, Stack size 0 bytes, startup_stm32l431xx.o(.text))
[Address Reference Count : 1]

- startup_stm32l431xx.o(RESET)

RNG_IRQHandler (Thumb, 0 bytes, Stack size 0 bytes, startup_stm32l431xx.o(.text))
[Address Reference Count : 1]

- startup_stm32l431xx.o(RESET)

RTC_Alarm_IRQHandler (Thumb, 0 bytes, Stack size 0 bytes, startup_stm32l431xx.o(.text))
[Address Reference Count : 1]

- startup_stm32l431xx.o(RESET)

RTC_WKUP_IRQHandler (Thumb, 0 bytes, Stack size 0 bytes, startup_stm32l431xx.o(.text))
[Address Reference Count : 1]

- startup_stm32l431xx.o(RESET)

SAI1_IRQHandler (Thumb, 0 bytes, Stack size 0 bytes, startup_stm32l431xx.o(.text))
[Address Reference Count : 1]

- startup_stm32l431xx.o(RESET)

SDMMC1_IRQHandler (Thumb, 0 bytes, Stack size 0 bytes, startup_stm32l431xx.o(.text))
[Address Reference Count : 1]

- startup_stm32l431xx.o(RESET)

SPI2_IRQHandler (Thumb, 0 bytes, Stack size 0 bytes, startup_stm32l431xx.o(.text))
[Address Reference Count : 1]

- startup_stm32l431xx.o(RESET)

SPI3_IRQHandler (Thumb, 0 bytes, Stack size 0 bytes, startup_stm32l431xx.o(.text))
[Address Reference Count : 1]

- startup_stm32l431xx.o(RESET)

SWPMI1_IRQHandler (Thumb, 0 bytes, Stack size 0 bytes, startup_stm32l431xx.o(.text))
[Address Reference Count : 1]

- startup_stm32l431xx.o(RESET)

TAMP_STAMP_IRQHandler (Thumb, 0 bytes, Stack size 0 bytes, startup_stm32l431xx.o(.text))
[Address Reference Count : 1]

- startup_stm32l431xx.o(RESET)

TIM1_BRK_TIM15_IRQHandler (Thumb, 0 bytes, Stack size 0 bytes, startup_stm32l431xx.o(.text))
[Address Reference Count : 1]

- startup_stm32l431xx.o(RESET)

TIM1_CC_IRQHandler (Thumb, 0 bytes, Stack size 0 bytes, startup_stm32l431xx.o(.text))
[Address Reference Count : 1]

- startup_stm32l431xx.o(RESET)

TIM1_TRG_COM_IRQHandler (Thumb, 0 bytes, Stack size 0 bytes, startup_stm32l431xx.o(.text))
[Address Reference Count : 1]

- startup_stm32l431xx.o(RESET)

TIM1_UP_TIM16_IRQHandler (Thumb, 0 bytes, Stack size 0 bytes, startup_stm32l431xx.o(.text))
[Address Reference Count : 1]

- startup_stm32l431xx.o(RESET)

TIM2_IRQHandler (Thumb, 0 bytes, Stack size 0 bytes, startup_stm32l431xx.o(.text))
[Address Reference Count : 1]

- startup_stm32l431xx.o(RESET)

TIM7_IRQHandler (Thumb, 0 bytes, Stack size 0 bytes, startup_stm32l431xx.o(.text))
[Address Reference Count : 1]

- startup_stm32l431xx.o(RESET)

TSC_IRQHandler (Thumb, 0 bytes, Stack size 0 bytes, startup_stm32l431xx.o(.text))
[Address Reference Count : 1]

- startup_stm32l431xx.o(RESET)

USART1_IRQHandler (Thumb, 0 bytes, Stack size 0 bytes, startup_stm32l431xx.o(.text))
[Address Reference Count : 1]

- startup_stm32l431xx.o(RESET)

USART2_IRQHandler (Thumb, 0 bytes, Stack size 0 bytes, startup_stm32l431xx.o(.text))
[Address Reference Count : 1]

- startup_stm32l431xx.o(RESET)

USART3_IRQHandler (Thumb, 0 bytes, Stack size 0 bytes, startup_stm32l431xx.o(.text))
[Address Reference Count : 1]

- startup_stm32l431xx.o(RESET)

WWDG_IRQHandler (Thumb, 0 bytes, Stack size 0 bytes, startup_stm32l431xx.o(.text))
[Address Reference Count : 1]

- startup_stm32l431xx.o(RESET)

__user_initial_stackheap (Thumb, 0 bytes, Stack size unknown bytes, startup_stm32l431xx.o(.text))

[Called By]

- >> __user_setup_stackheap

__aeabi_uldivmod (Thumb, 0 bytes, Stack size 48 bytes, lludivv7m.o(.text))

[Stack]

- Max Depth = 48
- Call Chain = __aeabi_uldivmod

[Called By]

- >> _ntoa_long_long

_ll_udiv (Thumb, 240 bytes, Stack size 48 bytes, lludivv7m.o(.text), UNUSED)

strcpy (Thumb, 72 bytes, Stack size 12 bytes, strcpy.o(.text))

[Stack]

- Max Depth = 12
- Call Chain = strcpy

[Called By]

- >> lv_roller_set_options
- >> lv_label_set_text
- >> lv_img_decoder_open
- >> lv_img_set_src
- >> lv_dropdown_set_options
- >> lv_textarea_set_text

strlen (Thumb, 62 bytes, Stack size 8 bytes, strlen.o(.text))

[Stack]

- Max Depth = 8
- Call Chain = strlen

[Called By]

- >> lv_roller_set_options
- >> lv_label_set_text
- >> lv_fs_get_ext
- >> lv_img_decoder_open
- >> lv_img_set_src
- >> lv_dropdown_set_options
- >> lv_textarea_del_char
- >> lv_textarea_add_text
- >> lv_textarea_add_char
- >> lv_textarea_set_text
- >> lv_spinbox_updatevalue
- >> lv_spinbox_event
- >> _lv_txt_ins
- >> _lv_txt_cut
- >> lv_dropdown_get_selected_str
- >> lv_label_ins_text
- >> lv_label_refr_text
- >> pwd_char_hider

__aeabi_memcpy (Thumb, 0 bytes, Stack size 0 bytes, rt_memcpy_v6.o(.text))

[Called By]

- >> lv_draw_label

__rt_memcpy (Thumb, 138 bytes, Stack size 0 bytes, rt_memcpy_v6.o(.text), UNUSED)

[Calls]

- >> __aeabi_memcpy4

_memcpy_lastbytes (Thumb, 0 bytes, Stack size unknown bytes, rt_memcpy_v6.o(.text), UNUSED)

__aeabi_memcpy4 (Thumb, 0 bytes, Stack size 8 bytes, rt_memcpy_w.o(.text), UNUSED)

[Called By]

- >> __rt_memcpy

__aeabi_memcpy8 (Thumb, 0 bytes, Stack size 8 bytes, rt_memcpy_w.o(.text), UNUSED)

__rt_memcpy_w (Thumb, 100 bytes, Stack size 8 bytes, rt_memcpy_w.o(.text), UNUSED)

_memcpy_lastbytes_aligned (Thumb, 0 bytes, Stack size unknown bytes, rt_memcpy_w.o(.text), UNUSED)

__aeabi_memset4 (Thumb, 16 bytes, Stack size 0 bytes, aeabi_memset4.o(.text))

[Calls]

- >> _memset_w

[Called By]

- >> lv_memset_ff

__aeabi_memset8 (Thumb, 0 bytes, Stack size 0 bytes, aeabi_memset4.o(.text), UNUSED)

__aeabi_memclr4 (Thumb, 0 bytes, Stack size 4 bytes, rt_memclr_w.o(.text))

[Stack]

- Max Depth = 4
- Call Chain = __aeabi_memclr4

[Called By]

- >> HAL_SPI_MspInit
- >> HAL_I2C_MspInit
- >> SystemClock_Config
- >> MX_I2C1_Init
- >> lv_memset_00
- >> _lv_refr_init
- >> _lv_disp_refr_timer
- >> draw_bg
- >> lv_menu_constructor

__aeabi_memclr8 (Thumb, 0 bytes, Stack size 4 bytes, rt_memclr_w.o(.text), UNUSED)

__rt_memclr_w (Thumb, 78 bytes, Stack size 4 bytes, rt_memclr_w.o(.text), UNUSED)

_memset_w (Thumb, 0 bytes, Stack size unknown bytes, rt_memclr_w.o(.text))

[Called By]

- >> __aeabi_memset4

strcmp (Thumb, 124 bytes, Stack size 8 bytes, strcmpv7em.o(.text))

[Stack]

- Max Depth = 8
- Call Chain = strcmp

[Called By]

- >> lv_img_decoder_built_in_open
- >> lv_img_decoder_built_in_info
- >> lv_btnmatrix_set_map
- >> lv_btnmatrix_get_btn_text
- >> lv_keyboard_def_event_cb
- >> lv_btnmatrix_event
- >> insert_handler

__use_two_region_memory (Thumb, 2 bytes, Stack size 0 bytes, heapauxi.o(.text), UNUSED)

__rt_heap_escrow$2region (Thumb, 2 bytes, Stack size 0 bytes, heapauxi.o(.text), UNUSED)

__rt_heap_expand$2region (Thumb, 2 bytes, Stack size 0 bytes, heapauxi.o(.text), UNUSED)

__user_setup_stackheap (Thumb, 74 bytes, Stack size 8 bytes, sys_stackheap_outer.o(.text))

[Stack]

- Max Depth = 8 + Unknown Stack Size
- Call Chain = __user_setup_stackheap

[Calls]

- >> __user_initial_stackheap
- >> __user_perproc_libspace

[Called By]

- >> __rt_entry_sh

exit (Thumb, 18 bytes, Stack size 8 bytes, exit.o(.text))

[Stack]

- Max Depth = 8 + Unknown Stack Size
- Call Chain = exit

[Calls]

- >> __rt_exit

[Called By]

- >> __rt_entry_main

__user_libspace (Thumb, 8 bytes, Stack size 0 bytes, libspace.o(.text), UNUSED)

__user_perproc_libspace (Thumb, 0 bytes, Stack size 0 bytes, libspace.o(.text))

[Called By]

- >> __user_setup_stackheap

__user_perthread_libspace (Thumb, 0 bytes, Stack size 0 bytes, libspace.o(.text), UNUSED)

_sys_exit (Thumb, 8 bytes, Stack size 0 bytes, sys_exit.o(.text))

[Called By]

- >> __rt_exit_exit

__I$use$semihosting (Thumb, 0 bytes, Stack size 0 bytes, use_no_semi.o(.text), UNUSED)

__use_no_semihosting_swi (Thumb, 2 bytes, Stack size 0 bytes, use_no_semi.o(.text), UNUSED)

BusFault_Handler (Thumb, 2 bytes, Stack size 0 bytes, stm32l4xx_it.o(.text.BusFault_Handler))

[Calls]

- >> BusFault_Handler

[Called By]

- >> BusFault_Handler

[Address Reference Count : 1]

- startup_stm32l431xx.o(RESET)

__semihosting_library_function (Thumb, 0 bytes, Stack size 0 bytes, indicate_semi.o(.text), UNUSED)

DMA1_Channel3_IRQHandler (Thumb, 12 bytes, Stack size 0 bytes, stm32l4xx_it.o(.text.DMA1_Channel3_IRQHandler))

[Stack]

- Max Depth = 20
- Call Chain = DMA1_Channel3_IRQHandler ⇒ HAL_DMA_IRQHandler

[Calls]

- >> HAL_DMA_IRQHandler

[Address Reference Count : 1]

- startup_stm32l431xx.o(RESET)

DebugMon_Handler (Thumb, 2 bytes, Stack size 0 bytes, stm32l4xx_it.o(.text.DebugMon_Handler))
[Address Reference Count : 1]

- startup_stm32l431xx.o(RESET)

Error_Handler (Thumb, 8 bytes, Stack size 0 bytes, main.o(.text.Error_Handler))

[Called By]

- >> HAL_SPI_MspInit
- >> HAL_I2C_MspInit
- >> MX_TIM6_Init
- >> MX_SPI1_Init
- >> MX_I2C1_Init

GUI_Application (Thumb, 4 bytes, Stack size 0 bytes, gui.o(.text.GUI_Application))

[Stack]

- Max Depth = 472
- Call Chain = GUI_Application ⇒ lv_example_roller_3 ⇒ lv_roller_set_options ⇒ lv_label_set_text ⇒ lv_label_refr_text ⇒ lv_label_get_letter_on ⇒ _lv_txt_get_next_line ⇒ lv_font_get_glyph_width ⇒ lv_font_get_glyph_dsc

[Calls]

- >> lv_example_roller_3

[Called By]

- >> main

HAL_DMA_Abort_IT (Thumb, 78 bytes, Stack size 16 bytes, stm32l4xx_hal_dma.o(.text.HAL_DMA_Abort_IT))

[Stack]

- Max Depth = 16
- Call Chain = HAL_DMA_Abort_IT

[Called By]

- >> HAL_SPI_IRQHandler

HAL_DMA_IRQHandler (Thumb, 148 bytes, Stack size 20 bytes, stm32l4xx_hal_dma.o(.text.HAL_DMA_IRQHandler))

[Stack]

- Max Depth = 20
- Call Chain = HAL_DMA_IRQHandler

[Called By]

- >> DMA1_Channel3_IRQHandler

HAL_DMA_Init (Thumb, 188 bytes, Stack size 20 bytes, stm32l4xx_hal_dma.o(.text.HAL_DMA_Init))

[Stack]

- Max Depth = 20
- Call Chain = HAL_DMA_Init

[Called By]

- >> HAL_SPI_MspInit

HAL_DMA_Start_IT (Thumb, 102 bytes, Stack size 16 bytes, stm32l4xx_hal_dma.o(.text.HAL_DMA_Start_IT))

[Stack]

- Max Depth = 36
- Call Chain = HAL_DMA_Start_IT ⇒ DMA_SetConfig

[Calls]

- >> DMA_SetConfig

[Called By]

- >> HAL_SPI_Transmit_DMA

HAL_Delay (Thumb, 36 bytes, Stack size 16 bytes, stm32l4xx_hal.o(.text.HAL_Delay))

[Stack]

- Max Depth = 16
- Call Chain = HAL_Delay

[Calls]

- >> HAL_GetTick

[Called By]

- >> main

[Address Reference Count : 1]

- st7789.o(.text.ST7789_Init)

HAL_GPIO_Init (Thumb, 412 bytes, Stack size 44 bytes, stm32l4xx_hal_gpio.o(.text.HAL_GPIO_Init))

[Stack]

- Max Depth = 44
- Call Chain = HAL_GPIO_Init

[Called By]

- >> HAL_SPI_MspInit
- >> HAL_I2C_MspInit

[Address Reference Count : 1]

- gpio.o(.text.MX_GPIO_Init)

HAL_GPIO_TogglePin (Thumb, 16 bytes, Stack size 0 bytes, stm32l4xx_hal_gpio.o(.text.HAL_GPIO_TogglePin))

[Called By]

- >> HAL_TIM_PeriodElapsedCallback

HAL_GPIO_WritePin (Thumb, 12 bytes, Stack size 0 bytes, stm32l4xx_hal_gpio.o(.text.HAL_GPIO_WritePin))

[Called By]

- >> ST7789_Init
- >> MX_GPIO_Init
- >> ST7789_DrawImage
- >> ST7789_WriteSmallData
- >> ST7789_WriteData
- >> ST7789_WriteCommand

HAL_GetTick (Thumb, 12 bytes, Stack size 0 bytes, stm32l4xx_hal.o(.text.HAL_GetTick))

[Called By]

- >> HAL_RCCEx_PeriphCLKConfig
- >> HAL_RCC_OscConfig
- >> HAL_RCC_ClockConfig
- >> HAL_Delay
- >> HAL_I2C_Master_Transmit
- >> HAL_I2C_Master_Receive
- >> I2C_WaitOnTXISFlagUntilTimeout
- >> I2C_WaitOnSTOPFlagUntilTimeout
- >> I2C_WaitOnRXNEFlagUntilTimeout
- >> I2C_WaitOnFlagUntilTimeout
- >> I2C_IsErrorOccurred
- >> RCCEx_PLLSAI1_Config
- >> HAL_SPI_Transmit
- >> SPI_WaitFlagStateUntilTimeout
- >> SPI_WaitFifoStateUntilTimeout
- >> SPI_DMATransmitCplt

HAL_I2CEx_ConfigAnalogFilter (Thumb, 74 bytes, Stack size 0 bytes, stm32l4xx_hal_i2c_ex.o(.text.HAL_I2CEx_ConfigAnalogFilter))

[Called By]

- >> MX_I2C1_Init

HAL_I2CEx_ConfigDigitalFilter (Thumb, 72 bytes, Stack size 0 bytes, stm32l4xx_hal_i2c_ex.o(.text.HAL_I2CEx_ConfigDigitalFilter))

[Called By]

- >> MX_I2C1_Init

HAL_I2C_Init (Thumb, 176 bytes, Stack size 16 bytes, stm32l4xx_hal_i2c.o(.text.HAL_I2C_Init))

[Stack]

- Max Depth = 208
- Call Chain = HAL_I2C_Init ⇒ HAL_I2C_MspInit ⇒ HAL_RCCEx_PeriphCLKConfig ⇒ RCCEx_PLLSAI1_Config

[Calls]

- >> HAL_I2C_MspInit

[Called By]

- >> MX_I2C1_Init

HAL_I2C_Master_Receive (Thumb, 312 bytes, Stack size 32 bytes, stm32l4xx_hal_i2c.o(.text.HAL_I2C_Master_Receive))

[Stack]

- Max Depth = 72
- Call Chain = HAL_I2C_Master_Receive ⇒ I2C_WaitOnSTOPFlagUntilTimeout ⇒ I2C_IsErrorOccurred

[Calls]

- >> HAL_GetTick
- >> I2C_WaitOnSTOPFlagUntilTimeout
- >> I2C_WaitOnRXNEFlagUntilTimeout
- >> I2C_WaitOnFlagUntilTimeout
- >> I2C_TransferConfig

[Called By]

- >> ns2009_read

HAL_I2C_Master_Transmit (Thumb, 348 bytes, Stack size 32 bytes, stm32l4xx_hal_i2c.o(.text.HAL_I2C_Master_Transmit))

[Stack]

- Max Depth = 80
- Call Chain = HAL_I2C_Master_Transmit ⇒ I2C_WaitOnTXISFlagUntilTimeout ⇒ I2C_IsErrorOccurred

[Calls]

- >> HAL_GetTick
- >> I2C_WaitOnTXISFlagUntilTimeout
- >> I2C_WaitOnSTOPFlagUntilTimeout
- >> I2C_WaitOnFlagUntilTimeout
- >> I2C_TransferConfig

[Called By]

- >> ns2009_read

HAL_I2C_MspInit (Thumb, 132 bytes, Stack size 136 bytes, i2c.o(.text.HAL_I2C_MspInit))

[Stack]

- Max Depth = 192
- Call Chain = HAL_I2C_MspInit ⇒ HAL_RCCEx_PeriphCLKConfig ⇒ RCCEx_PLLSAI1_Config

[Calls]

- >> HAL_RCCEx_PeriphCLKConfig
- >> HAL_GPIO_Init
- >> Error_Handler
- >> __aeabi_memclr4

[Called By]

- >> HAL_I2C_Init

HAL_IncTick (Thumb, 20 bytes, Stack size 0 bytes, stm32l4xx_hal.o(.text.HAL_IncTick))

[Called By]

- >> SysTick_Handler

HAL_Init (Thumb, 28 bytes, Stack size 8 bytes, stm32l4xx_hal.o(.text.HAL_Init))

[Stack]

- Max Depth = 48
- Call Chain = HAL_Init ⇒ HAL_InitTick ⇒ HAL_NVIC_SetPriority ⇒ __NVIC_SetPriority

[Calls]

- >> HAL_MspInit
- >> HAL_NVIC_SetPriorityGrouping
- >> HAL_InitTick

[Called By]

- >> main

HAL_InitTick (Thumb, 68 bytes, Stack size 16 bytes, stm32l4xx_hal.o(.text.HAL_InitTick))

[Stack]

- Max Depth = 40
- Call Chain = HAL_InitTick ⇒ HAL_NVIC_SetPriority ⇒ __NVIC_SetPriority

[Calls]

- >> HAL_NVIC_SetPriority
- >> HAL_SYSTICK_Config

[Called By]

- >> HAL_RCC_OscConfig
- >> HAL_RCC_ClockConfig
- >> HAL_Init

HAL_MspInit (Thumb, 48 bytes, Stack size 8 bytes, stm32l4xx_hal_msp.o(.text.HAL_MspInit))

[Stack]

- Max Depth = 8
- Call Chain = HAL_MspInit

[Called By]

- >> HAL_Init

HAL_NVIC_EnableIRQ (Thumb, 28 bytes, Stack size 0 bytes, stm32l4xx_hal_cortex.o(.text.HAL_NVIC_EnableIRQ))

[Called By]

- >> HAL_SPI_MspInit
- >> MX_DMA_Init
- >> HAL_TIM_Base_MspInit

HAL_NVIC_SetPriority (Thumb, 56 bytes, Stack size 16 bytes, stm32l4xx_hal_cortex.o(.text.HAL_NVIC_SetPriority))

[Stack]

- Max Depth = 24
- Call Chain = HAL_NVIC_SetPriority ⇒ __NVIC_SetPriority

[Calls]

- >> __NVIC_SetPriority

[Called By]

- >> HAL_SPI_MspInit
- >> MX_DMA_Init
- >> HAL_TIM_Base_MspInit
- >> HAL_InitTick

HAL_NVIC_SetPriorityGrouping (Thumb, 32 bytes, Stack size 0 bytes, stm32l4xx_hal_cortex.o(.text.HAL_NVIC_SetPriorityGrouping))

[Called By]

- >> HAL_Init

HAL_PWREx_ControlVoltageScaling (Thumb, 104 bytes, Stack size 0 bytes, stm32l4xx_hal_pwr_ex.o(.text.HAL_PWREx_ControlVoltageScaling))

[Called By]

- >> SystemClock_Config

HAL_PWREx_GetVoltageRange (Thumb, 12 bytes, Stack size 0 bytes, stm32l4xx_hal_pwr_ex.o(.text.HAL_PWREx_GetVoltageRange))

[Called By]

- >> RCC_SetFlashLatencyFromMSIRange

HAL_RCCEx_PeriphCLKConfig (Thumb, 620 bytes, Stack size 32 bytes, stm32l4xx_hal_rcc_ex.o(.text.HAL_RCCEx_PeriphCLKConfig))

[Stack]

- Max Depth = 56
- Call Chain = HAL_RCCEx_PeriphCLKConfig ⇒ RCCEx_PLLSAI1_Config

[Calls]

- >> HAL_GetTick
- >> RCCEx_PLLSAI1_Config

[Called By]

- >> HAL_I2C_MspInit

HAL_RCC_ClockConfig (Thumb, 352 bytes, Stack size 32 bytes, stm32l4xx_hal_rcc.o(.text.HAL_RCC_ClockConfig))

[Stack]

- Max Depth = 72
- Call Chain = HAL_RCC_ClockConfig ⇒ HAL_InitTick ⇒ HAL_NVIC_SetPriority ⇒ __NVIC_SetPriority

[Calls]

- >> HAL_GetTick
- >> HAL_RCC_GetSysClockFreq
- >> HAL_InitTick

[Called By]

- >> SystemClock_Config

HAL_RCC_GetSysClockFreq (Thumb, 160 bytes, Stack size 8 bytes, stm32l4xx_hal_rcc.o(.text.HAL_RCC_GetSysClockFreq))

[Stack]

- Max Depth = 8
- Call Chain = HAL_RCC_GetSysClockFreq

[Called By]

- >> HAL_RCC_OscConfig
- >> HAL_RCC_ClockConfig

HAL_RCC_OscConfig (Thumb, 1456 bytes, Stack size 32 bytes, stm32l4xx_hal_rcc.o(.text.HAL_RCC_OscConfig))

[Stack]

- Max Depth = 72
- Call Chain = HAL_RCC_OscConfig ⇒ HAL_InitTick ⇒ HAL_NVIC_SetPriority ⇒ __NVIC_SetPriority

[Calls]

- >> HAL_GetTick
- >> HAL_RCC_GetSysClockFreq
- >> RCC_SetFlashLatencyFromMSIRange
- >> HAL_InitTick

[Called By]

- >> SystemClock_Config

HAL_SPI_ErrorCallback (Thumb, 2 bytes, Stack size 0 bytes, stm32l4xx_hal_spi.o(.text.HAL_SPI_ErrorCallback))

[Called By]

- >> HAL_SPI_IRQHandler
- >> SPI_DMATransmitCplt
- >> SPI_DMAError
- >> SPI_DMAAbortOnError

HAL_SPI_IRQHandler (Thumb, 264 bytes, Stack size 16 bytes, stm32l4xx_hal_spi.o(.text.HAL_SPI_IRQHandler))

[Stack]

- Max Depth = 32
- Call Chain = HAL_SPI_IRQHandler ⇒ HAL_DMA_Abort_IT

[Calls]

- >> HAL_DMA_Abort_IT
- >> HAL_SPI_ErrorCallback

[Called By]

- >> SPI1_IRQHandler

HAL_SPI_Init (Thumb, 210 bytes, Stack size 24 bytes, stm32l4xx_hal_spi.o(.text.HAL_SPI_Init))

[Stack]

- Max Depth = 108
- Call Chain = HAL_SPI_Init ⇒ HAL_SPI_MspInit ⇒ HAL_GPIO_Init

[Calls]

- >> HAL_SPI_MspInit

[Called By]

- >> MX_SPI1_Init

HAL_SPI_MspInit (Thumb, 168 bytes, Stack size 40 bytes, spi.o(.text.HAL_SPI_MspInit))

[Stack]

- Max Depth = 84
- Call Chain = HAL_SPI_MspInit ⇒ HAL_GPIO_Init

[Calls]

- >> HAL_DMA_Init
- >> HAL_NVIC_SetPriority
- >> HAL_NVIC_EnableIRQ
- >> HAL_GPIO_Init
- >> Error_Handler
- >> __aeabi_memclr4

[Called By]

- >> HAL_SPI_Init

HAL_SPI_Transmit (Thumb, 414 bytes, Stack size 32 bytes, stm32l4xx_hal_spi.o(.text.HAL_SPI_Transmit))

[Stack]

- Max Depth = 88
- Call Chain = HAL_SPI_Transmit ⇒ SPI_EndRxTxTransaction ⇒ SPI_WaitFifoStateUntilTimeout

[Calls]

- >> HAL_GetTick
- >> SPI_EndRxTxTransaction

[Called By]

- >> ST7789_WriteSmallData
- >> ST7789_WriteData
- >> ST7789_WriteCommand

HAL_SPI_Transmit_DMA (Thumb, 256 bytes, Stack size 24 bytes, stm32l4xx_hal_spi.o(.text.HAL_SPI_Transmit_DMA))

[Stack]

- Max Depth = 60
- Call Chain = HAL_SPI_Transmit_DMA ⇒ HAL_DMA_Start_IT ⇒ DMA_SetConfig

[Calls]

- >> HAL_DMA_Start_IT

[Called By]

- >> ST7789_DrawImage

HAL_SPI_TxCpltCallback (Thumb, 28 bytes, Stack size 0 bytes, st7789.o(.text.HAL_SPI_TxCpltCallback))

[Called By]

- >> SPI_DMATransmitCplt

HAL_SPI_TxHalfCpltCallback (Thumb, 2 bytes, Stack size 0 bytes, stm32l4xx_hal_spi.o(.text.HAL_SPI_TxHalfCpltCallback))

[Called By]

- >> SPI_DMAHalfTransmitCplt

HAL_SYSTICK_Config (Thumb, 40 bytes, Stack size 0 bytes, stm32l4xx_hal_cortex.o(.text.HAL_SYSTICK_Config))

[Called By]

- >> HAL_InitTick

HAL_TIMEx_Break2Callback (Thumb, 2 bytes, Stack size 0 bytes, stm32l4xx_hal_tim_ex.o(.text.HAL_TIMEx_Break2Callback))

[Called By]

- >> HAL_TIM_IRQHandler

HAL_TIMEx_BreakCallback (Thumb, 2 bytes, Stack size 0 bytes, stm32l4xx_hal_tim_ex.o(.text.HAL_TIMEx_BreakCallback))

[Called By]

- >> HAL_TIM_IRQHandler

HAL_TIMEx_CommutCallback (Thumb, 2 bytes, Stack size 0 bytes, stm32l4xx_hal_tim_ex.o(.text.HAL_TIMEx_CommutCallback))

[Called By]

- >> HAL_TIM_IRQHandler

HAL_TIMEx_MasterConfigSynchronization (Thumb, 96 bytes, Stack size 16 bytes, stm32l4xx_hal_tim_ex.o(.text.HAL_TIMEx_MasterConfigSynchronization))

[Stack]

- Max Depth = 16
- Call Chain = HAL_TIMEx_MasterConfigSynchronization

[Called By]

- >> MX_TIM6_Init

HAL_TIM_Base_Init (Thumb, 96 bytes, Stack size 8 bytes, stm32l4xx_hal_tim.o(.text.HAL_TIM_Base_Init))

[Stack]

- Max Depth = 48
- Call Chain = HAL_TIM_Base_Init ⇒ HAL_TIM_Base_MspInit ⇒ HAL_NVIC_SetPriority ⇒ __NVIC_SetPriority

[Calls]

- >> HAL_TIM_Base_MspInit
- >> TIM_Base_SetConfig

[Called By]

- >> MX_TIM6_Init

HAL_TIM_Base_MspInit (Thumb, 56 bytes, Stack size 16 bytes, tim.o(.text.HAL_TIM_Base_MspInit))

[Stack]

- Max Depth = 40
- Call Chain = HAL_TIM_Base_MspInit ⇒ HAL_NVIC_SetPriority ⇒ __NVIC_SetPriority

[Calls]

- >> HAL_NVIC_SetPriority
- >> HAL_NVIC_EnableIRQ

[Called By]

- >> HAL_TIM_Base_Init

HAL_TIM_Base_Start_IT (Thumb, 92 bytes, Stack size 0 bytes, stm32l4xx_hal_tim.o(.text.HAL_TIM_Base_Start_IT))

[Called By]

- >> main

HAL_TIM_IC_CaptureCallback (Thumb, 2 bytes, Stack size 0 bytes, stm32l4xx_hal_tim.o(.text.HAL_TIM_IC_CaptureCallback))

[Called By]

- >> HAL_TIM_IRQHandler

HAL_TIM_IRQHandler (Thumb, 304 bytes, Stack size 24 bytes, stm32l4xx_hal_tim.o(.text.HAL_TIM_IRQHandler))

[Stack]

- Max Depth = 32
- Call Chain = HAL_TIM_IRQHandler ⇒ HAL_TIM_PeriodElapsedCallback

[Calls]

- >> HAL_TIM_PeriodElapsedCallback
- >> HAL_TIM_TriggerCallback
- >> HAL_TIM_PWM_PulseFinishedCallback
- >> HAL_TIM_OC_DelayElapsedCallback
- >> HAL_TIM_IC_CaptureCallback
- >> HAL_TIMEx_CommutCallback
- >> HAL_TIMEx_BreakCallback
- >> HAL_TIMEx_Break2Callback

[Called By]

- >> TIM6_DAC_IRQHandler

HAL_TIM_OC_DelayElapsedCallback (Thumb, 2 bytes, Stack size 0 bytes, stm32l4xx_hal_tim.o(.text.HAL_TIM_OC_DelayElapsedCallback))

[Called By]

- >> HAL_TIM_IRQHandler

HAL_TIM_PWM_PulseFinishedCallback (Thumb, 2 bytes, Stack size 0 bytes, stm32l4xx_hal_tim.o(.text.HAL_TIM_PWM_PulseFinishedCallback))

[Called By]

- >> HAL_TIM_IRQHandler

HAL_TIM_PeriodElapsedCallback (Thumb, 60 bytes, Stack size 8 bytes, main.o(.text.HAL_TIM_PeriodElapsedCallback))

[Stack]

- Max Depth = 8
- Call Chain = HAL_TIM_PeriodElapsedCallback

[Calls]

- >> lv_tick_inc
- >> HAL_GPIO_TogglePin

[Called By]

- >> HAL_TIM_IRQHandler

HAL_TIM_TriggerCallback (Thumb, 2 bytes, Stack size 0 bytes, stm32l4xx_hal_tim.o(.text.HAL_TIM_TriggerCallback))

[Called By]

- >> HAL_TIM_IRQHandler

HardFault_Handler (Thumb, 2 bytes, Stack size 0 bytes, stm32l4xx_it.o(.text.HardFault_Handler))

[Calls]

- >> HardFault_Handler

[Called By]

- >> HardFault_Handler

[Address Reference Count : 1]

- startup_stm32l431xx.o(RESET)

MX_DMA_Init (Thumb, 48 bytes, Stack size 16 bytes, dma.o(.text.MX_DMA_Init))

[Stack]

- Max Depth = 40
- Call Chain = MX_DMA_Init ⇒ HAL_NVIC_SetPriority ⇒ __NVIC_SetPriority

[Calls]

- >> HAL_NVIC_SetPriority
- >> HAL_NVIC_EnableIRQ

[Called By]

- >> main

MX_GPIO_Init (Thumb, 216 bytes, Stack size 56 bytes, gpio.o(.text.MX_GPIO_Init))

[Stack]

- Max Depth = 56
- Call Chain = MX_GPIO_Init

[Calls]

- >> HAL_GPIO_WritePin

[Called By]

- >> main

MX_I2C1_Init (Thumb, 88 bytes, Stack size 8 bytes, i2c.o(.text.MX_I2C1_Init))

[Stack]

- Max Depth = 216
- Call Chain = MX_I2C1_Init ⇒ HAL_I2C_Init ⇒ HAL_I2C_MspInit ⇒ HAL_RCCEx_PeriphCLKConfig ⇒ RCCEx_PLLSAI1_Config

[Calls]

- >> HAL_I2C_Init
- >> HAL_I2CEx_ConfigDigitalFilter
- >> HAL_I2CEx_ConfigAnalogFilter
- >> Error_Handler
- >> __aeabi_memclr4

[Called By]

- >> main

MX_SPI1_Init (Thumb, 76 bytes, Stack size 24 bytes, spi.o(.text.MX_SPI1_Init))

[Stack]

- Max Depth = 132
- Call Chain = MX_SPI1_Init ⇒ HAL_SPI_Init ⇒ HAL_SPI_MspInit ⇒ HAL_GPIO_Init

[Calls]

- >> HAL_SPI_Init
- >> Error_Handler

[Called By]

- >> main

MX_TIM6_Init (Thumb, 72 bytes, Stack size 24 bytes, tim.o(.text.MX_TIM6_Init))

[Stack]

- Max Depth = 72
- Call Chain = MX_TIM6_Init ⇒ HAL_TIM_Base_Init ⇒ HAL_TIM_Base_MspInit ⇒ HAL_NVIC_SetPriority ⇒ __NVIC_SetPriority

[Calls]

- >> Error_Handler
- >> HAL_TIM_Base_Init
- >> HAL_TIMEx_MasterConfigSynchronization

[Called By]

- >> main

MemManage_Handler (Thumb, 2 bytes, Stack size 0 bytes, stm32l4xx_it.o(.text.MemManage_Handler))

[Calls]

- >> MemManage_Handler

[Called By]

- >> MemManage_Handler

[Address Reference Count : 1]

- startup_stm32l431xx.o(RESET)

NMI_Handler (Thumb, 2 bytes, Stack size 0 bytes, stm32l4xx_it.o(.text.NMI_Handler))

[Calls]

- >> NMI_Handler

[Called By]

- >> NMI_Handler

[Address Reference Count : 1]

- startup_stm32l431xx.o(RESET)

PendSV_Handler (Thumb, 2 bytes, Stack size 0 bytes, stm32l4xx_it.o(.text.PendSV_Handler))
[Address Reference Count : 1]

- startup_stm32l431xx.o(RESET)

SPI1_IRQHandler (Thumb, 12 bytes, Stack size 0 bytes, stm32l4xx_it.o(.text.SPI1_IRQHandler))

[Stack]

- Max Depth = 32
- Call Chain = SPI1_IRQHandler ⇒ HAL_SPI_IRQHandler ⇒ HAL_DMA_Abort_IT

[Calls]

- >> HAL_SPI_IRQHandler

[Address Reference Count : 1]

- startup_stm32l431xx.o(RESET)

ST7789_DrawImage (Thumb, 76 bytes, Stack size 16 bytes, st7789.o(.text.ST7789_DrawImage))

[Stack]

- Max Depth = 160
- Call Chain = ST7789_DrawImage ⇒ ST7789_SetAddressWindow ⇒ ST7789_WriteData ⇒ HAL_SPI_Transmit ⇒ SPI_EndRxTxTransaction ⇒ SPI_WaitFifoStateUntilTimeout

[Calls]

- >> HAL_GPIO_WritePin
- >> HAL_SPI_Transmit_DMA
- >> ST7789_SetAddressWindow

[Called By]

- >> disp_flush

ST7789_Init (Thumb, 284 bytes, Stack size 32 bytes, st7789.o(.text.ST7789_Init))

[Stack]

- Max Depth = 144
- Call Chain = ST7789_Init ⇒ ST7789_SetRotation ⇒ ST7789_WriteSmallData ⇒ HAL_SPI_Transmit ⇒ SPI_EndRxTxTransaction ⇒ SPI_WaitFifoStateUntilTimeout

[Calls]

- >> HAL_GPIO_WritePin
- >> ST7789_SetRotation

[Called By]

- >> main

ST7789_SetRotation (Thumb, 40 bytes, Stack size 8 bytes, st7789.o(.text.ST7789_SetRotation))

[Stack]

- Max Depth = 112
- Call Chain = ST7789_SetRotation ⇒ ST7789_WriteSmallData ⇒ HAL_SPI_Transmit ⇒ SPI_EndRxTxTransaction ⇒ SPI_WaitFifoStateUntilTimeout

[Calls]

- >> ST7789_WriteSmallData
- >> ST7789_WriteCommand

[Called By]

- >> ST7789_Init

SVC_Handler (Thumb, 2 bytes, Stack size 0 bytes, stm32l4xx_it.o(.text.SVC_Handler))
[Address Reference Count : 1]

- startup_stm32l431xx.o(RESET)

SysTick_Handler (Thumb, 40 bytes, Stack size 8 bytes, stm32l4xx_it.o(.text.SysTick_Handler))

[Stack]

- Max Depth = 8
- Call Chain = SysTick_Handler

[Calls]

- >> HAL_IncTick

[Address Reference Count : 1]

- startup_stm32l431xx.o(RESET)

SystemClock_Config (Thumb, 122 bytes, Stack size 96 bytes, main.o(.text.SystemClock_Config))

[Stack]

- Max Depth = 168
- Call Chain = SystemClock_Config ⇒ HAL_RCC_OscConfig ⇒ HAL_InitTick ⇒ HAL_NVIC_SetPriority ⇒ __NVIC_SetPriority

[Calls]

- >> HAL_RCC_OscConfig
- >> HAL_RCC_ClockConfig
- >> HAL_PWREx_ControlVoltageScaling
- >> __aeabi_memclr4

[Called By]

- >> main

SystemInit (Thumb, 16 bytes, Stack size 0 bytes, system_stm32l4xx.o(.text.SystemInit))
[Address Reference Count : 1]

- startup_stm32l431xx.o(.text)

TIM6_DAC_IRQHandler (Thumb, 12 bytes, Stack size 0 bytes, stm32l4xx_it.o(.text.TIM6_DAC_IRQHandler))

[Stack]

- Max Depth = 32
- Call Chain = TIM6_DAC_IRQHandler ⇒ HAL_TIM_IRQHandler ⇒ HAL_TIM_PeriodElapsedCallback

[Calls]

- >> HAL_TIM_IRQHandler

[Address Reference Count : 1]

- startup_stm32l431xx.o(RESET)

TIM_Base_SetConfig (Thumb, 112 bytes, Stack size 16 bytes, stm32l4xx_hal_tim.o(.text.TIM_Base_SetConfig))

[Stack]

- Max Depth = 16
- Call Chain = TIM_Base_SetConfig

[Called By]

- >> HAL_TIM_Base_Init

UsageFault_Handler (Thumb, 2 bytes, Stack size 0 bytes, stm32l4xx_it.o(.text.UsageFault_Handler))

[Calls]

- >> UsageFault_Handler

[Called By]

- >> UsageFault_Handler

[Address Reference Count : 1]

- startup_stm32l431xx.o(RESET)

_lv_anim_core_init (Thumb, 48 bytes, Stack size 16 bytes, lv_anim.o(.text._lv_anim_core_init))

[Stack]

- Max Depth = 120
- Call Chain = _lv_anim_core_init ⇒ lv_timer_create ⇒ _lv_ll_ins_head ⇒ lv_mem_alloc ⇒ lv_tlsf_malloc ⇒ block_prepare_used ⇒ block_split ⇒ block_mark_as_free ⇒ block_link_next

[Calls]

- >> _lv_ll_init
- >> anim_mark_list_change
- >> lv_timer_create

[Called By]

- >> lv_init

_lv_area_diff (Thumb, 246 bytes, Stack size 32 bytes, lv_area.o(.text._lv_area_diff))

[Stack]

- Max Depth = 112
- Call Chain = _lv_area_diff ⇒ _lv_area_is_in ⇒ _lv_area_is_point_on ⇒ _lv_area_is_point_on (Cycle)

[Calls]

- >> _lv_area_is_in
- >> _lv_area_is_on

[Called By]

- >> _lv_disp_refr_timer

_lv_area_intersect (Thumb, 88 bytes, Stack size 20 bytes, lv_area.o(.text._lv_area_intersect))

[Stack]

- Max Depth = 20
- Call Chain = _lv_area_intersect

[Called By]

- >> _lv_inv_area
- >> lv_obj_area_is_visible
- >> lv_obj_redraw
- >> lv_draw_img
- >> refr_obj
- >> lv_draw_sw_blend
- >> lv_draw_sw_rect
- >> lv_draw_sw_polygon
- >> lv_draw_sw_line
- >> lv_draw_sw_img_decoded
- >> lv_draw_sw_blend_basic
- >> lv_draw_sw_arc
- >> lv_draw_label
- >> draw_border_generic
- >> draw_bg_img
- >> draw_bg
- >> lv_chart_event
- >> lv_img_event
- >> lv_dropdown_list_event
- >> draw_box_label
- >> lv_label_event
- >> lv_roller_label_event
- >> lv_roller_event
- >> lv_table_event

_lv_area_is_in (Thumb, 152 bytes, Stack size 32 bytes, lv_area.o(.text._lv_area_is_in))

[Stack]

- Max Depth = 80
- Call Chain = _lv_area_is_in ⇒ _lv_area_is_point_on ⇒ _lv_area_is_point_on (Cycle)

[Calls]

- >> _lv_area_is_point_on

[Called By]

- >> _lv_inv_area
- >> lv_obj_event
- >> lv_obj_refr_size
- >> lv_obj_move_to
- >> _lv_area_diff
- >> refr_obj
- >> lv_refr_get_top_obj
- >> lv_draw_sw_rect
- >> lv_draw_mask_is_any
- >> lv_img_event

_lv_area_is_on (Thumb, 56 bytes, Stack size 0 bytes, lv_area.o(.text._lv_area_is_on))

[Called By]

- >> _lv_disp_refr_timer
- >> _lv_area_diff

_lv_area_is_out (Thumb, 156 bytes, Stack size 32 bytes, lv_area.o(.text._lv_area_is_out))

[Stack]

- Max Depth = 80
- Call Chain = _lv_area_is_out ⇒ _lv_area_is_point_on ⇒ _lv_area_is_point_on (Cycle)

[Calls]

- >> _lv_area_is_point_on

[Called By]

- >> lv_draw_sw_rect
- >> lv_draw_mask_is_any

_lv_area_is_point_on (Thumb, 278 bytes, Stack size 40 bytes, lv_area.o(.text._lv_area_is_point_on))

[Stack]

- Max Depth = 48 + In Cycle
- Call Chain = _lv_area_is_point_on ⇒ _lv_area_is_point_on (Cycle)

[Calls]

- >> _lv_area_is_point_on
- >> lv_point_within_circle

[Called By]

- >> lv_obj_hit_test
- >> lv_indev_search_obj
- >> _lv_area_is_point_on
- >> _lv_area_is_in
- >> _lv_area_is_out
- >> lv_colorwheel_event
- >> lv_arc_event
- >> get_button_from_point
- >> lv_img_event
- >> lv_slider_event

_lv_area_join (Thumb, 68 bytes, Stack size 20 bytes, lv_area.o(.text._lv_area_join))

[Stack]

- Max Depth = 20
- Call Chain = _lv_area_join

[Called By]

- >> _lv_disp_refr_timer

_lv_disp_refr_timer (Thumb, 1840 bytes, Stack size 112 bytes, lv_refr.o(.text._lv_disp_refr_timer))

[Stack]

- Max Depth = 976
- Call Chain = _lv_disp_refr_timer ⇒ refr_area_part ⇒ lv_draw_img ⇒ show_error ⇒ lv_draw_label ⇒ lv_txt_get_size ⇒ _lv_txt_get_next_line ⇒ lv_font_get_glyph_width ⇒ lv_font_get_glyph_dsc

[Calls]

- >> lv_obj_set_style_bg_opa
- >> lv_obj_align
- >> lv_disp_get_default
- >> lv_tick_get
- >> lv_tick_elaps
- >> lv_disp_get_ver_res
- >> lv_disp_get_hor_res
- >> lv_area_set
- >> lv_mem_free
- >> _lv_ll_remove
- >> _lv_ll_ins_tail
- >> _lv_ll_get_next
- >> _lv_ll_get_head
- >> _lv_ll_clear
- >> lv_memset_00
- >> lv_area_get_size
- >> lv_obj_update_layout
- >> lv_obj_set_style_text_color
- >> lv_obj_set_style_text_align
- >> lv_obj_set_style_pad_top
- >> lv_obj_set_style_pad_right
- >> lv_obj_set_style_pad_left
- >> lv_obj_set_style_pad_bottom
- >> lv_obj_set_style_bg_color
- >> lv_timer_get_idle
- >> lv_mem_monitor
- >> lv_mem_buf_free_all
- >> lv_label_set_text_fmt
- >> lv_label_set_text
- >> lv_label_create
- >> _lv_ll_is_empty
- >> _lv_ll_ins_prev
- >> _lv_font_clean_up_fmt_txt
- >> _lv_draw_mask_cleanup
- >> _lv_area_join
- >> _lv_area_is_on
- >> _lv_area_diff
- >> refr_area_part
- >> lv_layer_sys
- >> __aeabi_memclr4

[Address Reference Count : 1]

- lv_hal_disp.o(.text.lv_disp_drv_register)

_lv_draw_mask_cleanup (Thumb, 36 bytes, Stack size 16 bytes, lv_draw_mask.o(.text._lv_draw_mask_cleanup))

[Stack]

- Max Depth = 88
- Call Chain = _lv_draw_mask_cleanup ⇒ lv_mem_free ⇒ lv_tlsf_free ⇒ block_merge_next ⇒ block_remove ⇒ remove_free_block

[Calls]

- >> lv_mem_free
- >> lv_memset_00

[Called By]

- >> _lv_disp_refr_timer

_lv_event_mark_deleted (Thumb, 36 bytes, Stack size 0 bytes, lv_event.o(.text._lv_event_mark_deleted))

[Called By]

- >> lv_obj_destructor

_lv_font_clean_up_fmt_txt (Thumb, 2 bytes, Stack size 0 bytes, lv_font_fmt_txt.o(.text._lv_font_clean_up_fmt_txt))

[Called By]

- >> _lv_disp_refr_timer

_lv_fs_init (Thumb, 12 bytes, Stack size 0 bytes, lv_fs.o(.text._lv_fs_init))

[Calls]

- >> _lv_ll_init

[Called By]

- >> lv_init

_lv_group_init (Thumb, 12 bytes, Stack size 0 bytes, lv_group.o(.text._lv_group_init))

[Calls]

- >> _lv_ll_init

[Called By]

- >> lv_init

_lv_img_buf_get_transformed_area (Thumb, 252 bytes, Stack size 48 bytes, lv_img_buf.o(.text._lv_img_buf_get_transformed_area))

[Stack]

- Max Depth = 48
- Call Chain = _lv_img_buf_get_transformed_area

[Called By]

- >> lv_draw_img
- >> lv_img_get_transformed_size
- >> lv_img_event

_lv_img_cache_open (Thumb, 84 bytes, Stack size 24 bytes, lv_img_cache.o(.text._lv_img_cache_open))

[Stack]

- Max Depth = 136
- Call Chain = _lv_img_cache_open ⇒ lv_img_decoder_open ⇒ lv_mem_free ⇒ lv_tlsf_free ⇒ block_merge_next ⇒ block_remove ⇒ remove_free_block

[Calls]

- >> lv_tick_get
- >> lv_tick_elaps
- >> lv_memset_00
- >> lv_img_decoder_open

[Called By]

- >> lv_draw_img

_lv_img_decoder_init (Thumb, 56 bytes, Stack size 8 bytes, lv_img_decoder.o(.text._lv_img_decoder_init))

[Stack]

- Max Depth = 96
- Call Chain = _lv_img_decoder_init ⇒ lv_img_decoder_create ⇒ _lv_ll_ins_head ⇒ lv_mem_alloc ⇒ lv_tlsf_malloc ⇒ block_prepare_used ⇒ block_split ⇒ block_mark_as_free ⇒ block_link_next

[Calls]

- >> _lv_ll_init
- >> lv_img_decoder_create

[Called By]

- >> lv_init

_lv_indev_read (Thumb, 62 bytes, Stack size 16 bytes, lv_hal_indev.o(.text._lv_indev_read))

[Stack]

- Max Depth = 36
- Call Chain = _lv_indev_read ⇒ lv_memset_00 ⇒ __aeabi_memclr4

[Calls]

- >> lv_memset_00

[Called By]

- >> lv_indev_read_timer_cb

_lv_indev_scroll_handler (Thumb, 1388 bytes, Stack size 80 bytes, lv_indev_scroll.o(.text._lv_indev_scroll_handler))

[Stack]

- Max Depth = 256
- Call Chain = _lv_indev_scroll_handler ⇒ _lv_obj_scroll_by_raw ⇒ lv_obj_invalidate ⇒ lv_obj_invalidate_area ⇒ _lv_inv_area ⇒ _lv_area_is_in ⇒ _lv_area_is_point_on ⇒ _lv_area_is_point_on (Cycle)

[Calls]

- >> lv_event_send
- >> lv_area_set
- >> lv_obj_has_flag
- >> lv_indev_get_act
- >> lv_point_transform
- >> lv_obj_get_parent
- >> lv_obj_get_scroll_top
- >> lv_obj_get_scroll_snap_y
- >> lv_obj_get_scroll_snap_x
- >> lv_obj_get_scroll_right
- >> lv_obj_get_scroll_left
- >> lv_obj_get_scroll_dir
- >> lv_obj_get_scroll_bottom
- >> _lv_obj_scroll_by_raw
- >> scroll_limit_diff
- >> lv_obj_get_style_transform_zoom
- >> lv_obj_get_style_transform_angle
- >> find_snap_point_y
- >> find_snap_point_x
- >> elastic_diff

[Called By]

- >> indev_proc_press

_lv_indev_scroll_throw_handler (Thumb, 564 bytes, Stack size 40 bytes, lv_indev_scroll.o(.text._lv_indev_scroll_throw_handler))

[Stack]

- Max Depth = 312
- Call Chain = _lv_indev_scroll_throw_handler ⇒ lv_obj_scroll_by ⇒ _lv_obj_scroll_by_raw ⇒ lv_obj_invalidate ⇒ lv_obj_invalidate_area ⇒ _lv_inv_area ⇒ _lv_area_is_in ⇒ _lv_area_is_point_on ⇒ _lv_area_is_point_on (Cycle)

[Calls]

- >> lv_event_send
- >> lv_obj_has_flag
- >> lv_indev_get_act
- >> lv_obj_scroll_by
- >> lv_obj_get_scroll_top
- >> lv_obj_get_scroll_snap_y
- >> lv_obj_get_scroll_snap_x
- >> lv_obj_get_scroll_right
- >> lv_obj_get_scroll_left
- >> lv_obj_get_scroll_bottom
- >> scroll_limit_diff
- >> find_snap_point_y
- >> find_snap_point_x
- >> elastic_diff

[Called By]

- >> indev_proc_release
- >> indev_proc_press

_lv_inv_area (Thumb, 194 bytes, Stack size 40 bytes, lv_refr.o(.text._lv_inv_area))

[Stack]

- Max Depth = 120
- Call Chain = _lv_inv_area ⇒ _lv_area_is_in ⇒ _lv_area_is_point_on ⇒ _lv_area_is_point_on (Cycle)

[Calls]

- >> lv_disp_get_default
- >> lv_disp_is_invalidation_enabled
- >> lv_disp_get_ver_res
- >> lv_disp_get_hor_res
- >> _lv_area_is_in
- >> lv_timer_resume
- >> _lv_area_intersect

[Called By]

- >> lv_obj_invalidate_area

_lv_ll_clear (Thumb, 42 bytes, Stack size 16 bytes, lv_ll.o(.text._lv_ll_clear))

[Stack]

- Max Depth = 88
- Call Chain = _lv_ll_clear ⇒ lv_mem_free ⇒ lv_tlsf_free ⇒ block_merge_next ⇒ block_remove ⇒ remove_free_block

[Calls]

- >> lv_mem_free
- >> _lv_ll_remove

[Called By]

- >> _lv_disp_refr_timer
- >> lv_chart_destructor
- >> lv_meter_destructor
- >> lv_menu_clear_history
- >> lv_menu_destructor

_lv_ll_get_head (Thumb, 10 bytes, Stack size 0 bytes, lv_ll.o(.text._lv_ll_get_head))

[Called By]

- >> lv_timer_handler
- >> lv_obj_get_disp
- >> lv_disp_get_next
- >> lv_anim_del
- >> lv_indev_get_next
- >> lv_group_remove_obj
- >> lv_group_focus_obj
- >> lv_group_add_obj
- >> lv_anim_get
- >> trans_anim_ready_cb
- >> lv_img_decoder_get_info
- >> _lv_disp_refr_timer
- >> lv_img_decoder_open
- >> lv_chart_destructor
- >> lv_menu_back_event_cb
- >> lv_fs_get_drv
- >> anim_timer
- >> anim_mark_list_change

[Address Reference Count : 1]

- lv_group.o(.text.lv_group_focus_next)

_lv_ll_get_len (Thumb, 26 bytes, Stack size 0 bytes, lv_ll.o(.text._lv_ll_get_len))

[Called By]

- >> lv_group_get_obj_count
- >> lv_chart_get_point_pos_by_id
- >> lv_chart_event

_lv_ll_get_next (Thumb, 8 bytes, Stack size 0 bytes, lv_ll.o(.text._lv_ll_get_next))

[Called By]

- >> lv_timer_handler
- >> lv_obj_get_disp
- >> lv_disp_get_next
- >> lv_anim_del
- >> lv_indev_get_next
- >> lv_group_remove_obj
- >> lv_group_focus_obj
- >> lv_group_add_obj
- >> lv_anim_get
- >> trans_anim_ready_cb
- >> lv_img_decoder_get_info
- >> _lv_disp_refr_timer
- >> lv_img_decoder_open
- >> lv_menu_back_event_cb
- >> lv_fs_get_drv
- >> anim_timer

[Address Reference Count : 1]

- lv_group.o(.text.lv_group_focus_next)

_lv_ll_get_prev (Thumb, 6 bytes, Stack size 0 bytes, lv_ll.o(.text._lv_ll_get_prev))

[Called By]

- >> trans_del
- >> lv_chart_get_point_pos_by_id
- >> lv_chart_event
- >> lv_meter_event

[Address Reference Count : 1]

- lv_group.o(.text.lv_group_focus_prev)

_lv_ll_get_tail (Thumb, 10 bytes, Stack size 0 bytes, lv_ll.o(.text._lv_ll_get_tail))

[Called By]

- >> lv_group_remove_obj
- >> trans_del
- >> lv_chart_get_point_pos_by_id
- >> lv_chart_event
- >> lv_meter_event

[Address Reference Count : 1]

- lv_group.o(.text.lv_group_focus_prev)

_lv_ll_init (Thumb, 16 bytes, Stack size 0 bytes, lv_ll.o(.text._lv_ll_init))

[Called By]

- >> lv_init
- >> lv_disp_drv_register
- >> _lv_group_init
- >> _lv_timer_core_init
- >> _lv_obj_style_init
- >> _lv_img_decoder_init
- >> _lv_fs_init
- >> _lv_anim_core_init
- >> lv_chart_constructor
- >> lv_meter_constructor
- >> lv_menu_constructor

_lv_ll_ins_head (Thumb, 44 bytes, Stack size 8 bytes, lv_ll.o(.text._lv_ll_ins_head))

[Stack]

- Max Depth = 80
- Call Chain = _lv_ll_ins_head ⇒ lv_mem_alloc ⇒ lv_tlsf_malloc ⇒ block_prepare_used ⇒ block_split ⇒ block_mark_as_free ⇒ block_link_next

[Calls]

- >> lv_mem_alloc

[Called By]

- >> lv_disp_drv_register
- >> lv_anim_start
- >> lv_indev_drv_register
- >> _lv_obj_style_create_transition
- >> _lv_ll_ins_prev
- >> lv_img_decoder_create
- >> lv_menu_set_page
- >> lv_timer_create

_lv_ll_ins_prev (Thumb, 60 bytes, Stack size 16 bytes, lv_ll.o(.text._lv_ll_ins_prev))

[Stack]

- Max Depth = 96
- Call Chain = _lv_ll_ins_prev ⇒ _lv_ll_ins_head ⇒ lv_mem_alloc ⇒ lv_tlsf_malloc ⇒ block_prepare_used ⇒ block_split ⇒ block_mark_as_free ⇒ block_link_next

[Calls]

- >> _lv_ll_ins_head
- >> lv_mem_alloc

[Called By]

- >> _lv_disp_refr_timer

_lv_ll_ins_tail (Thumb, 44 bytes, Stack size 8 bytes, lv_ll.o(.text._lv_ll_ins_tail))

[Stack]

- Max Depth = 80
- Call Chain = _lv_ll_ins_tail ⇒ lv_mem_alloc ⇒ lv_tlsf_malloc ⇒ block_prepare_used ⇒ block_split ⇒ block_mark_as_free ⇒ block_link_next

[Calls]

- >> lv_mem_alloc

[Called By]

- >> lv_group_add_obj
- >> _lv_disp_refr_timer

_lv_ll_is_empty (Thumb, 18 bytes, Stack size 0 bytes, lv_ll.o(.text._lv_ll_is_empty))

[Called By]

- >> lv_anim_start
- >> _lv_disp_refr_timer
- >> lv_chart_event

_lv_ll_remove (Thumb, 68 bytes, Stack size 8 bytes, lv_ll.o(.text._lv_ll_remove))

[Stack]

- Max Depth = 8
- Call Chain = _lv_ll_remove

[Called By]

- >> lv_anim_del
- >> lv_group_remove_obj
- >> _lv_ll_clear
- >> trans_del
- >> trans_anim_ready_cb
- >> _lv_disp_refr_timer
- >> lv_chart_destructor
- >> lv_menu_back_event_cb
- >> anim_timer
- >> lv_timer_del

_lv_obj_destruct (Thumb, 26 bytes, Stack size 8 bytes, lv_obj_class.o(.text._lv_obj_destruct))

[Stack]

- Max Depth = 8
- Call Chain = _lv_obj_destruct

[Called By]

- >> obj_del_core

_lv_obj_get_ext_draw_size (Thumb, 14 bytes, Stack size 0 bytes, lv_obj_draw.o(.text._lv_obj_get_ext_draw_size))

[Called By]

- >> lv_obj_invalidate
- >> lv_obj_is_visible
- >> lv_obj_area_is_visible
- >> lv_obj_redraw
- >> refr_obj

_lv_obj_get_layer_type (Thumb, 14 bytes, Stack size 0 bytes, lv_obj_draw.o(.text._lv_obj_get_layer_type))

[Called By]

- >> lv_obj_transform_point
- >> refr_obj
- >> lv_refr_get_top_obj

_lv_obj_scroll_by_raw (Thumb, 70 bytes, Stack size 16 bytes, lv_obj_scroll.o(.text._lv_obj_scroll_by_raw))

[Stack]

- Max Depth = 176
- Call Chain = _lv_obj_scroll_by_raw ⇒ lv_obj_invalidate ⇒ lv_obj_invalidate_area ⇒ _lv_inv_area ⇒ _lv_area_is_in ⇒ _lv_area_is_point_on ⇒ _lv_area_is_point_on (Cycle)

[Calls]

- >> lv_obj_invalidate
- >> lv_event_send
- >> lv_obj_allocate_spec_attr
- >> lv_obj_move_children_by

[Called By]

- >> _lv_indev_scroll_handler
- >> lv_obj_scroll_by
- >> scroll_y_anim
- >> scroll_x_anim

_lv_obj_style_apply_color_filter (Thumb, 72 bytes, Stack size 24 bytes, lv_obj_style.o(.text._lv_obj_style_apply_color_filter))

[Stack]

- Max Depth = 104
- Call Chain = _lv_obj_style_apply_color_filter ⇒ lv_obj_get_style_prop ⇒ lv_style_get_prop

[Calls]

- >> lv_obj_get_style_prop

[Called By]

- >> lv_obj_init_draw_line_dsc
- >> lv_obj_init_draw_img_dsc
- >> lv_obj_init_draw_arc_dsc
- >> lv_obj_get_style_text_color_filtered
- >> lv_obj_get_style_bg_color_filtered
- >> lv_obj_init_draw_rect_dsc
- >> lv_label_event

_lv_obj_style_create_transition (Thumb, 316 bytes, Stack size 104 bytes, lv_obj_style.o(.text._lv_obj_style_create_transition))

[Stack]

- Max Depth = 248
- Call Chain = _lv_obj_style_create_transition ⇒ lv_style_set_prop ⇒ lv_style_set_prop_internal ⇒ lv_mem_realloc ⇒ lv_tlsf_realloc ⇒ lv_tlsf_free ⇒ block_merge_next ⇒ block_remove ⇒ remove_free_block

[Calls]

- >> lv_obj_get_style_prop
- >> lv_obj_get_height
- >> lv_anim_start
- >> lv_anim_init
- >> _lv_ll_ins_head
- >> lv_obj_get_width
- >> lv_style_set_prop
- >> get_trans_style

[Called By]

- >> lv_obj_set_state

_lv_obj_style_init (Thumb, 12 bytes, Stack size 0 bytes, lv_obj_style.o(.text._lv_obj_style_init))

[Calls]

- >> _lv_ll_init

[Called By]

- >> lv_init

_lv_obj_style_state_compare (Thumb, 548 bytes, Stack size 40 bytes, lv_obj_style.o(.text._lv_obj_style_state_compare))

[Stack]

- Max Depth = 64
- Call Chain = _lv_obj_style_state_compare ⇒ lv_style_get_prop

[Calls]

- >> lv_style_get_prop

[Called By]

- >> lv_obj_set_state

_lv_refr_get_disp_refreshing (Thumb, 8 bytes, Stack size 0 bytes, lv_refr.o(.text._lv_refr_get_disp_refreshing))

[Called By]

- >> lv_draw_layer_destroy
- >> lv_draw_layer_create
- >> lv_draw_sw_transform
- >> lv_draw_sw_line
- >> lv_draw_sw_letter
- >> lv_draw_sw_layer_create
- >> lv_draw_sw_layer_blend
- >> lv_draw_sw_layer_adjust
- >> lv_draw_sw_img_decoded
- >> lv_draw_sw_blend_basic

_lv_refr_init (Thumb, 28 bytes, Stack size 8 bytes, lv_refr.o(.text._lv_refr_init))

[Stack]

- Max Depth = 12
- Call Chain = _lv_refr_init ⇒ __aeabi_memclr4

[Calls]

- >> __aeabi_memclr4

[Called By]

- >> lv_init

_lv_style_get_prop_group (Thumb, 12 bytes, Stack size 0 bytes, lv_style.o(.text._lv_style_get_prop_group))

[Called By]

- >> lv_obj_get_style_prop

_lv_style_prop_lookup_flags (Thumb, 64 bytes, Stack size 0 bytes, lv_style.o(.text._lv_style_prop_lookup_flags))

[Called By]

- >> lv_style_prop_has_flag

_lv_timer_core_init (Thumb, 28 bytes, Stack size 8 bytes, lv_timer.o(.text._lv_timer_core_init))

[Stack]

- Max Depth = 8
- Call Chain = _lv_timer_core_init

[Calls]

- >> _lv_ll_init

[Called By]

- >> lv_init

_lv_txt_cut (Thumb, 64 bytes, Stack size 24 bytes, lv_txt.o(.text._lv_txt_cut))

[Stack]

- Max Depth = 32
- Call Chain = _lv_txt_cut ⇒ strlen

[Calls]

- >> strlen

[Called By]

- >> lv_textarea_del_char

_lv_txt_encoded_letter_next_2 (Thumb, 52 bytes, Stack size 24 bytes, lv_txt.o(.text._lv_txt_encoded_letter_next_2))

[Stack]

- Max Depth = 24
- Call Chain = _lv_txt_encoded_letter_next_2

[Called By]

- >> lv_draw_label
- >> lv_txt_get_width
- >> lv_label_is_char_under_pos
- >> lv_label_get_letter_on

_lv_txt_get_next_line (Thumb, 524 bytes, Stack size 104 bytes, lv_txt.o(.text._lv_txt_get_next_line))

[Stack]

- Max Depth = 160
- Call Chain = _lv_txt_get_next_line ⇒ lv_font_get_glyph_width ⇒ lv_font_get_glyph_dsc

[Calls]

- >> lv_font_get_glyph_width
- >> _lv_txt_is_cmd

[Called By]

- >> lv_txt_get_size
- >> lv_draw_label
- >> lv_label_is_char_under_pos
- >> lv_label_get_letter_pos
- >> lv_label_get_letter_on

_lv_txt_ins (Thumb, 84 bytes, Stack size 24 bytes, lv_txt.o(.text._lv_txt_ins))

[Stack]

- Max Depth = 32
- Call Chain = _lv_txt_ins ⇒ strlen

[Calls]

- >> lv_memcpy_small
- >> strlen

[Called By]

- >> lv_textarea_add_text
- >> lv_textarea_add_char
- >> lv_label_ins_text

_lv_txt_is_cmd (Thumb, 50 bytes, Stack size 0 bytes, lv_txt.o(.text._lv_txt_is_cmd))

[Called By]

- >> lv_txt_get_width
- >> _lv_txt_get_next_line
- >> lv_label_is_char_under_pos
- >> lv_label_get_letter_on

_lv_txt_set_text_vfmt (Thumb, 62 bytes, Stack size 32 bytes, lv_txt.o(.text._lv_txt_set_text_vfmt))

[Stack]

- Max Depth = 312
- Call Chain = _lv_txt_set_text_vfmt ⇒ lv_vsnprintf ⇒ _vsnprintf ⇒ _vsnprintf (Cycle)

[Calls]

- >> lv_mem_alloc
- >> lv_vsnprintf

[Called By]

- >> lv_label_set_text_fmt

_lv_utils_bsearch (Thumb, 66 bytes, Stack size 40 bytes, lv_utils.o(.text._lv_utils_bsearch))

[Stack]

- Max Depth = 40
- Call Chain = _lv_utils_bsearch

[Called By]

- >> get_glyph_dsc_id
- >> lv_font_get_glyph_dsc_fmt_txt

bsp_ns2009_getPos (Thumb, 200 bytes, Stack size 24 bytes, ns2009.o(.text.bsp_ns2009_getPos))

[Stack]

- Max Depth = 128
- Call Chain = bsp_ns2009_getPos ⇒ ns2009_read ⇒ HAL_I2C_Master_Transmit ⇒ I2C_WaitOnTXISFlagUntilTimeout ⇒ I2C_IsErrorOccurred

[Calls]

- >> __aeabi_dmul
- >> __aeabi_ui2d
- >> __aeabi_d2uiz
- >> __aeabi_ddiv
- >> __aeabi_dsub
- >> __aeabi_dadd
- >> ns2009_read
- >> bsp_ns2009_getPress

[Called By]

- >> touchpad_read

bsp_ns2009_getPress (Thumb, 6 bytes, Stack size 0 bytes, ns2009.o(.text.bsp_ns2009_getPress))

[Stack]

- Max Depth = 104
- Call Chain = bsp_ns2009_getPress ⇒ ns2009_read ⇒ HAL_I2C_Master_Transmit ⇒ I2C_WaitOnTXISFlagUntilTimeout ⇒ I2C_IsErrorOccurred

[Calls]

- >> ns2009_read

[Called By]

- >> bsp_ns2009_getPos

bsp_ns2009_init (Thumb, 2 bytes, Stack size 0 bytes, ns2009.o(.text.bsp_ns2009_init))

[Called By]

- >> main

draw_border_generic (Thumb, 1496 bytes, Stack size 192 bytes, lv_draw_sw_rect.o(.text.draw_border_generic))

[Stack]

- Max Depth = 408 + Unknown Stack Size
- Call Chain = draw_border_generic ⇒ lv_draw_mask_radius_init ⇒ lv_mem_buf_get ⇒ lv_mem_realloc ⇒ lv_tlsf_realloc ⇒ lv_tlsf_free ⇒ block_merge_next ⇒ block_remove ⇒ remove_free_block

[Calls]

- >> lv_mem_buf_release
- >> lv_mem_buf_get
- >> lv_draw_mask_remove_id
- >> lv_draw_mask_free_param
- >> lv_draw_mask_add
- >> lv_memset_00
- >> lv_draw_mask_radius_init
- >> _lv_area_intersect
- >> lv_draw_sw_blend
- >> lv_memset_ff
- >> lv_draw_mask_is_any
- >> lv_draw_mask_apply

[Called By]

- >> lv_draw_sw_rect

get_tick_gsc (Thumb, 42 bytes, Stack size 0 bytes, lv_chart.o(.text.get_tick_gsc))

[Called By]

- >> draw_y_ticks
- >> draw_x_ticks

lv_anim_del (Thumb, 96 bytes, Stack size 32 bytes, lv_anim.o(.text.lv_anim_del))

[Stack]

- Max Depth = 104
- Call Chain = lv_anim_del ⇒ lv_mem_free ⇒ lv_tlsf_free ⇒ block_merge_next ⇒ block_remove ⇒ remove_free_block

[Calls]

- >> lv_mem_free
- >> _lv_ll_remove
- >> _lv_ll_get_next
- >> _lv_ll_get_head
- >> anim_mark_list_change

[Called By]

- >> lv_anim_start
- >> lv_obj_scroll_by
- >> lv_obj_scroll_to_y
- >> lv_obj_scroll_to_x
- >> lv_obj_destructor
- >> scroll_area_into_view
- >> trans_del
- >> lv_label_set_long_mode
- >> lv_bar_set_value_with_anim
- >> lv_bar_destructor
- >> lv_label_refr_text
- >> refr_position
- >> lv_roller_event
- >> lv_switch_event
- >> lv_switch_destructor
- >> start_cursor_blink

lv_anim_get (Thumb, 48 bytes, Stack size 16 bytes, lv_anim.o(.text.lv_anim_get))

[Stack]

- Max Depth = 16
- Call Chain = lv_anim_get

[Calls]

- >> _lv_ll_get_next
- >> _lv_ll_get_head

[Called By]

- >> lv_obj_get_scroll_end
- >> lv_label_refr_text

lv_anim_init (Thumb, 52 bytes, Stack size 8 bytes, lv_anim.o(.text.lv_anim_init))

[Stack]

- Max Depth = 28
- Call Chain = lv_anim_init ⇒ lv_memset_00 ⇒ __aeabi_memclr4

[Calls]

- >> lv_memset_00

[Called By]

- >> lv_obj_scroll_by
- >> _lv_obj_style_create_transition
- >> lv_spinner_constructor
- >> lv_bar_set_value_with_anim
- >> lv_label_refr_text
- >> refr_position
- >> lv_switch_event
- >> start_cursor_blink
- >> auto_hide_characters

lv_anim_path_ease_in_out (Thumb, 50 bytes, Stack size 24 bytes, lv_anim.o(.text.lv_anim_path_ease_in_out))

[Stack]

- Max Depth = 40
- Call Chain = lv_anim_path_ease_in_out ⇒ lv_bezier3

[Calls]

- >> lv_map
- >> lv_bezier3

[Address Reference Count : 1]

- lv_spinner.o(.text.lv_spinner_constructor)

lv_anim_path_ease_out (Thumb, 52 bytes, Stack size 24 bytes, lv_anim.o(.text.lv_anim_path_ease_out))

[Stack]

- Max Depth = 40
- Call Chain = lv_anim_path_ease_out ⇒ lv_bezier3

[Calls]

- >> lv_map
- >> lv_bezier3

[Address Reference Count : 2]

- lv_obj_scroll.o(.text.lv_obj_scroll_by)
- lv_roller.o(.text.refr_position)

lv_anim_path_linear (Thumb, 36 bytes, Stack size 16 bytes, lv_anim.o(.text.lv_anim_path_linear))

[Stack]

- Max Depth = 24
- Call Chain = lv_anim_path_linear ⇒ lv_map

[Calls]

- >> lv_map

[Address Reference Count : 3]

- lv_theme_default.o(.text.style_init)
- lv_anim.o(.text.lv_anim_init)
- lv_style.o(.text.lv_style_transition_dsc_init)

lv_anim_path_step (Thumb, 16 bytes, Stack size 0 bytes, lv_anim.o(.text.lv_anim_path_step))
[Address Reference Count : 2]

- lv_textarea.o(.text.auto_hide_characters)
- lv_textarea.o(.text.start_cursor_blink)

lv_anim_speed_to_time (Thumb, 26 bytes, Stack size 0 bytes, lv_anim.o(.text.lv_anim_speed_to_time))

[Called By]

- >> lv_obj_scroll_by
- >> lv_label_refr_text

lv_anim_start (Thumb, 132 bytes, Stack size 16 bytes, lv_anim.o(.text.lv_anim_start))

[Stack]

- Max Depth = 120
- Call Chain = lv_anim_start ⇒ lv_anim_del ⇒ lv_mem_free ⇒ lv_tlsf_free ⇒ block_merge_next ⇒ block_remove ⇒ remove_free_block

[Calls]

- >> lv_tick_get
- >> lv_anim_del
- >> _lv_ll_ins_head
- >> lv_memcpy
- >> _lv_ll_is_empty
- >> anim_mark_list_change

[Called By]

- >> lv_obj_scroll_by
- >> _lv_obj_style_create_transition
- >> lv_spinner_constructor
- >> lv_bar_set_value_with_anim
- >> lv_label_refr_text
- >> refr_position
- >> lv_switch_event
- >> start_cursor_blink
- >> auto_hide_characters

lv_arc_set_angles (Thumb, 24 bytes, Stack size 16 bytes, lv_arc.o(.text.lv_arc_set_angles))

[Stack]

- Max Depth = 240
- Call Chain = lv_arc_set_angles ⇒ lv_arc_set_start_angle ⇒ inv_arc_area ⇒ lv_obj_invalidate_area ⇒ _lv_inv_area ⇒ _lv_area_is_in ⇒ _lv_area_is_point_on ⇒ _lv_area_is_point_on (Cycle)

[Calls]

- >> lv_arc_set_start_angle
- >> lv_arc_set_end_angle

[Called By]

- >> value_update

lv_arc_set_bg_angles (Thumb, 24 bytes, Stack size 16 bytes, lv_arc.o(.text.lv_arc_set_bg_angles))

[Stack]

- Max Depth = 304
- Call Chain = lv_arc_set_bg_angles ⇒ lv_arc_set_bg_start_angle ⇒ value_update ⇒ lv_arc_set_angles ⇒ lv_arc_set_start_angle ⇒ inv_arc_area ⇒ lv_obj_invalidate_area ⇒ _lv_inv_area ⇒ _lv_area_is_in ⇒ _lv_area_is_point_on ⇒ _lv_area_is_point_on (Cycle)

[Calls]

- >> lv_arc_set_bg_start_angle
- >> lv_arc_set_bg_end_angle

[Called By]

- >> lv_spinner_constructor

lv_arc_set_bg_end_angle (Thumb, 100 bytes, Stack size 16 bytes, lv_arc.o(.text.lv_arc_set_bg_end_angle))

[Stack]

- Max Depth = 288
- Call Chain = lv_arc_set_bg_end_angle ⇒ value_update ⇒ lv_arc_set_angles ⇒ lv_arc_set_start_angle ⇒ inv_arc_area ⇒ lv_obj_invalidate_area ⇒ _lv_inv_area ⇒ _lv_area_is_in ⇒ _lv_area_is_point_on ⇒ _lv_area_is_point_on (Cycle)

[Calls]

- >> lv_obj_invalidate
- >> value_update
- >> inv_arc_area

[Called By]

- >> lv_arc_set_bg_angles

lv_arc_set_bg_start_angle (Thumb, 100 bytes, Stack size 16 bytes, lv_arc.o(.text.lv_arc_set_bg_start_angle))

[Stack]

- Max Depth = 288
- Call Chain = lv_arc_set_bg_start_angle ⇒ value_update ⇒ lv_arc_set_angles ⇒ lv_arc_set_start_angle ⇒ inv_arc_area ⇒ lv_obj_invalidate_area ⇒ _lv_inv_area ⇒ _lv_area_is_in ⇒ _lv_area_is_point_on ⇒ _lv_area_is_point_on (Cycle)

[Calls]

- >> lv_obj_invalidate
- >> value_update
- >> inv_arc_area

[Called By]

- >> lv_arc_set_bg_angles

lv_arc_set_end_angle (Thumb, 108 bytes, Stack size 16 bytes, lv_arc.o(.text.lv_arc_set_end_angle))

[Stack]

- Max Depth = 224
- Call Chain = lv_arc_set_end_angle ⇒ inv_arc_area ⇒ lv_obj_invalidate_area ⇒ _lv_inv_area ⇒ _lv_area_is_in ⇒ _lv_area_is_point_on ⇒ _lv_area_is_point_on (Cycle)

[Calls]

- >> lv_obj_invalidate
- >> inv_knob_area
- >> inv_arc_area

[Called By]

- >> arc_anim_end_angle
- >> lv_arc_set_angles
- >> value_update

lv_arc_set_rotation (Thumb, 6 bytes, Stack size 0 bytes, lv_arc.o(.text.lv_arc_set_rotation))

[Stack]

- Max Depth = 160
- Call Chain = lv_arc_set_rotation ⇒ lv_obj_invalidate ⇒ lv_obj_invalidate_area ⇒ _lv_inv_area ⇒ _lv_area_is_in ⇒ _lv_area_is_point_on ⇒ _lv_area_is_point_on (Cycle)

[Calls]

- >> lv_obj_invalidate

[Called By]

- >> lv_spinner_constructor

lv_arc_set_start_angle (Thumb, 108 bytes, Stack size 16 bytes, lv_arc.o(.text.lv_arc_set_start_angle))

[Stack]

- Max Depth = 224
- Call Chain = lv_arc_set_start_angle ⇒ inv_arc_area ⇒ lv_obj_invalidate_area ⇒ _lv_inv_area ⇒ _lv_area_is_in ⇒ _lv_area_is_point_on ⇒ _lv_area_is_point_on (Cycle)

[Calls]

- >> lv_obj_invalidate
- >> inv_knob_area
- >> inv_arc_area

[Called By]

- >> arc_anim_start_angle
- >> lv_arc_set_angles
- >> value_update

lv_arc_set_value (Thumb, 50 bytes, Stack size 16 bytes, lv_arc.o(.text.lv_arc_set_value))

[Stack]

- Max Depth = 288
- Call Chain = lv_arc_set_value ⇒ value_update ⇒ lv_arc_set_angles ⇒ lv_arc_set_start_angle ⇒ inv_arc_area ⇒ lv_obj_invalidate_area ⇒ _lv_inv_area ⇒ _lv_area_is_in ⇒ _lv_area_is_point_on ⇒ _lv_area_is_point_on (Cycle)

[Calls]

- >> value_update

[Called By]

- >> lv_arc_event

lv_area_get_size (Thumb, 28 bytes, Stack size 0 bytes, lv_area.o(.text.lv_area_get_size))

[Called By]

- >> lv_obj_event
- >> lv_obj_scrollbar_invalidate
- >> _lv_disp_refr_timer
- >> lv_draw_sw_line
- >> lv_draw_sw_layer_create
- >> lv_draw_sw_img_decoded
- >> lv_draw_sw_blend_basic

[Address Reference Count : 1]

- lv_refr.o(.text._lv_disp_refr_timer)

lv_area_increase (Thumb, 26 bytes, Stack size 0 bytes, lv_area.o(.text.lv_area_increase))

[Called By]

- >> lv_obj_get_transformed_area
- >> lv_obj_get_content_coords
- >> lv_obj_redraw
- >> refr_obj
- >> lv_draw_sw_rect
- >> lv_arc_event
- >> inv_knob_area
- >> lv_slider_event

lv_area_move (Thumb, 26 bytes, Stack size 0 bytes, lv_area.o(.text.lv_area_move))

[Called By]

- >> lv_draw_sw_img_decoded
- >> lv_draw_sw_blend_basic
- >> lv_label_event
- >> lv_textarea_event

lv_area_set (Thumb, 14 bytes, Stack size 8 bytes, lv_area.o(.text.lv_area_set))

[Stack]

- Max Depth = 8
- Call Chain = lv_area_set

[Called By]

- >> _lv_indev_scroll_handler
- >> lv_obj_get_scrollbar_area
- >> _lv_disp_refr_timer
- >> refr_area_part
- >> lv_draw_sw_letter
- >> lv_btnmatrix_set_map
- >> lv_arc_event

lv_area_set_height (Thumb, 10 bytes, Stack size 0 bytes, lv_area.o(.text.lv_area_set_height))

[Called By]

- >> lv_draw_img
- >> grid_update

[Address Reference Count : 1]

- lv_flex.o(.text.children_repos)

lv_area_set_width (Thumb, 10 bytes, Stack size 0 bytes, lv_area.o(.text.lv_area_set_width))

[Called By]

- >> grid_update

[Address Reference Count : 1]

- lv_flex.o(.text.children_repos)

lv_atan2 (Thumb, 180 bytes, Stack size 16 bytes, lv_math.o(.text.lv_atan2))

[Stack]

- Max Depth = 16
- Call Chain = lv_atan2

[Called By]

- >> lv_colorwheel_event
- >> lv_arc_event

lv_bar_get_mode (Thumb, 10 bytes, Stack size 0 bytes, lv_bar.o(.text.lv_bar_get_mode))

[Called By]

- >> lv_slider_get_mode

lv_bar_get_start_value (Thumb, 36 bytes, Stack size 0 bytes, lv_bar.o(.text.lv_bar_get_start_value))

[Called By]

- >> lv_slider_event

lv_bar_get_value (Thumb, 16 bytes, Stack size 0 bytes, lv_bar.o(.text.lv_bar_get_value))

[Called By]

- >> lv_slider_event

lv_bar_set_start_value (Thumb, 66 bytes, Stack size 24 bytes, lv_bar.o(.text.lv_bar_set_start_value))

[Stack]

- Max Depth = 272
- Call Chain = lv_bar_set_start_value ⇒ lv_bar_set_value_with_anim ⇒ lv_obj_invalidate ⇒ lv_obj_invalidate_area ⇒ _lv_inv_area ⇒ _lv_area_is_in ⇒ _lv_area_is_point_on ⇒ _lv_area_is_point_on (Cycle)

[Calls]

- >> lv_bar_set_value_with_anim

[Called By]

- >> lv_slider_set_left_value
- >> lv_slider_event

lv_bar_set_value (Thumb, 56 bytes, Stack size 24 bytes, lv_bar.o(.text.lv_bar_set_value))

[Stack]

- Max Depth = 272
- Call Chain = lv_bar_set_value ⇒ lv_bar_set_value_with_anim ⇒ lv_obj_invalidate ⇒ lv_obj_invalidate_area ⇒ _lv_inv_area ⇒ _lv_area_is_in ⇒ _lv_area_is_point_on ⇒ _lv_area_is_point_on (Cycle)

[Calls]

- >> lv_bar_set_value_with_anim

[Called By]

- >> lv_bar_constructor
- >> lv_slider_set_value
- >> lv_slider_event

lv_bezier3 (Thumb, 66 bytes, Stack size 16 bytes, lv_math.o(.text.lv_bezier3))

[Stack]

- Max Depth = 16
- Call Chain = lv_bezier3

[Called By]

- >> lv_anim_path_ease_out
- >> lv_anim_path_ease_in_out

lv_btn_create (Thumb, 24 bytes, Stack size 8 bytes, lv_btn.o(.text.lv_btn_create))

[Stack]

- Max Depth = 304
- Call Chain = lv_btn_create ⇒ lv_obj_class_init_obj ⇒ lv_theme_apply ⇒ lv_obj_remove_style ⇒ lv_obj_refresh_style ⇒ lv_obj_refresh_ext_draw_size ⇒ lv_obj_invalidate ⇒ lv_obj_invalidate_area ⇒ _lv_inv_area ⇒ _lv_area_is_in ⇒ _lv_area_is_point_on ⇒ _lv_area_is_point_on (Cycle)

[Calls]

- >> lv_obj_class_init_obj
- >> lv_obj_class_create_obj

[Called By]

- >> my_constructor
- >> lv_menu_constructor

lv_btnmatrix_clear_btn_ctrl (Thumb, 72 bytes, Stack size 16 bytes, lv_btnmatrix.o(.text.lv_btnmatrix_clear_btn_ctrl))

[Stack]

- Max Depth = 288
- Call Chain = lv_btnmatrix_clear_btn_ctrl ⇒ lv_obj_clear_flag ⇒ lv_obj_get_scrollbar_area ⇒ lv_obj_get_scroll_left ⇒ lv_obj_get_self_width ⇒ lv_event_send ⇒ event_send_core ⇒ event_send_core (Cycle)

[Calls]

- >> lv_obj_has_flag
- >> lv_obj_clear_flag
- >> lv_obj_refresh_ext_draw_size
- >> invalidate_button_area

[Called By]

- >> lv_btnmatrix_clear_btn_ctrl_all

lv_btnmatrix_clear_btn_ctrl_all (Thumb, 30 bytes, Stack size 16 bytes, lv_btnmatrix.o(.text.lv_btnmatrix_clear_btn_ctrl_all))

[Stack]

- Max Depth = 304
- Call Chain = lv_btnmatrix_clear_btn_ctrl_all ⇒ lv_btnmatrix_clear_btn_ctrl ⇒ lv_obj_clear_flag ⇒ lv_obj_get_scrollbar_area ⇒ lv_obj_get_scroll_left ⇒ lv_obj_get_self_width ⇒ lv_event_send ⇒ event_send_core ⇒ event_send_core (Cycle)

[Calls]

- >> lv_btnmatrix_clear_btn_ctrl

[Called By]

- >> lv_calendar_set_showed_date
- >> lv_btnmatrix_set_btn_ctrl
- >> highlight_update
- >> make_one_button_checked

lv_btnmatrix_create (Thumb, 24 bytes, Stack size 8 bytes, lv_btnmatrix.o(.text.lv_btnmatrix_create))

[Stack]

- Max Depth = 304
- Call Chain = lv_btnmatrix_create ⇒ lv_obj_class_init_obj ⇒ lv_theme_apply ⇒ lv_obj_remove_style ⇒ lv_obj_refresh_style ⇒ lv_obj_refresh_ext_draw_size ⇒ lv_obj_invalidate ⇒ lv_obj_invalidate_area ⇒ _lv_inv_area ⇒ _lv_area_is_in ⇒ _lv_area_is_point_on ⇒ _lv_area_is_point_on (Cycle)

[Calls]

- >> lv_obj_class_init_obj
- >> lv_obj_class_create_obj

[Called By]

- >> lv_calendar_constructor
- >> lv_tabview_constructor

lv_btnmatrix_get_btn_text (Thumb, 92 bytes, Stack size 32 bytes, lv_btnmatrix.o(.text.lv_btnmatrix_get_btn_text))

[Stack]

- Max Depth = 40
- Call Chain = lv_btnmatrix_get_btn_text ⇒ strcmp

[Calls]

- >> strcmp

[Called By]

- >> lv_keyboard_def_event_cb

lv_btnmatrix_get_selected_btn (Thumb, 4 bytes, Stack size 0 bytes, lv_btnmatrix.o(.text.lv_btnmatrix_get_selected_btn))

[Called By]

- >> lv_calendar_set_showed_date
- >> draw_part_begin_event_cb
- >> lv_keyboard_def_event_cb
- >> btns_value_changed_event_cb

lv_btnmatrix_has_btn_ctrl (Thumb, 28 bytes, Stack size 0 bytes, lv_btnmatrix.o(.text.lv_btnmatrix_has_btn_ctrl))

[Called By]

- >> draw_part_begin_event_cb

lv_btnmatrix_set_btn_ctrl (Thumb, 124 bytes, Stack size 16 bytes, lv_btnmatrix.o(.text.lv_btnmatrix_set_btn_ctrl))

[Stack]

- Max Depth = 320
- Call Chain = lv_btnmatrix_set_btn_ctrl ⇒ lv_btnmatrix_clear_btn_ctrl_all ⇒ lv_btnmatrix_clear_btn_ctrl ⇒ lv_obj_clear_flag ⇒ lv_obj_get_scrollbar_area ⇒ lv_obj_get_scroll_left ⇒ lv_obj_get_self_width ⇒ lv_event_send ⇒ event_send_core ⇒ event_send_core (Cycle)

[Calls]

- >> lv_obj_add_flag
- >> lv_obj_refresh_ext_draw_size
- >> lv_btnmatrix_clear_btn_ctrl_all
- >> invalidate_button_area

[Called By]

- >> lv_calendar_set_showed_date
- >> lv_btnmatrix_set_btn_ctrl_all
- >> highlight_update
- >> lv_tabview_set_act
- >> make_one_button_checked

lv_btnmatrix_set_btn_ctrl_all (Thumb, 30 bytes, Stack size 16 bytes, lv_btnmatrix.o(.text.lv_btnmatrix_set_btn_ctrl_all))

[Stack]

- Max Depth = 336
- Call Chain = lv_btnmatrix_set_btn_ctrl_all ⇒ lv_btnmatrix_set_btn_ctrl ⇒ lv_btnmatrix_clear_btn_ctrl_all ⇒ lv_btnmatrix_clear_btn_ctrl ⇒ lv_obj_clear_flag ⇒ lv_obj_get_scrollbar_area ⇒ lv_obj_get_scroll_left ⇒ lv_obj_get_self_width ⇒ lv_event_send ⇒ event_send_core ⇒ event_send_core (Cycle)

[Calls]

- >> lv_btnmatrix_set_btn_ctrl

[Called By]

- >> lv_calendar_constructor

lv_btnmatrix_set_ctrl_map (Thumb, 26 bytes, Stack size 8 bytes, lv_btnmatrix.o(.text.lv_btnmatrix_set_ctrl_map))

[Stack]

- Max Depth = 28
- Call Chain = lv_btnmatrix_set_ctrl_map ⇒ lv_memcpy

[Calls]

- >> lv_memcpy

[Called By]

- >> lv_keyboard_update_ctrl_map

lv_btnmatrix_set_map (Thumb, 580 bytes, Stack size 104 bytes, lv_btnmatrix.o(.text.lv_btnmatrix_set_map))

[Stack]

- Max Depth = 288
- Call Chain = lv_btnmatrix_set_map ⇒ lv_obj_refresh_ext_draw_size ⇒ lv_obj_invalidate ⇒ lv_obj_invalidate_area ⇒ _lv_inv_area ⇒ _lv_area_is_in ⇒ _lv_area_is_point_on ⇒ _lv_area_is_point_on (Cycle)

[Calls]

- >> lv_obj_get_style_prop
- >> lv_obj_invalidate
- >> lv_area_set
- >> lv_mem_free
- >> lv_obj_refresh_ext_draw_size
- >> lv_memset_00
- >> lv_mem_alloc
- >> lv_obj_get_content_width
- >> lv_obj_get_content_height
- >> lv_obj_get_style_pad_top
- >> lv_obj_get_style_pad_row
- >> lv_obj_get_style_pad_left
- >> lv_obj_get_style_pad_column
- >> strcmp

[Called By]

- >> lv_calendar_constructor
- >> lv_keyboard_def_event_cb
- >> lv_keyboard_update_map
- >> lv_tabview_constructor
- >> lv_btnmatrix_event
- >> lv_btnmatrix_constructor

lv_btnmatrix_set_one_checked (Thumb, 20 bytes, Stack size 0 bytes, lv_btnmatrix.o(.text.lv_btnmatrix_set_one_checked))

[Stack]

- Max Depth = 336
- Call Chain = lv_btnmatrix_set_one_checked ⇒ make_one_button_checked ⇒ lv_btnmatrix_set_btn_ctrl ⇒ lv_btnmatrix_clear_btn_ctrl_all ⇒ lv_btnmatrix_clear_btn_ctrl ⇒ lv_obj_clear_flag ⇒ lv_obj_get_scrollbar_area ⇒ lv_obj_get_scroll_left ⇒ lv_obj_get_self_width ⇒ lv_event_send ⇒ event_send_core ⇒ event_send_core (Cycle)

[Calls]

- >> make_one_button_checked

[Called By]

- >> lv_tabview_constructor

lv_btnmatrix_set_selected_btn (Thumb, 44 bytes, Stack size 16 bytes, lv_btnmatrix.o(.text.lv_btnmatrix_set_selected_btn))

[Stack]

- Max Depth = 216
- Call Chain = lv_btnmatrix_set_selected_btn ⇒ invalidate_button_area ⇒ lv_obj_invalidate_area ⇒ _lv_inv_area ⇒ _lv_area_is_in ⇒ _lv_area_is_point_on ⇒ _lv_area_is_point_on (Cycle)

[Calls]

- >> invalidate_button_area

[Called By]

- >> lv_calendar_set_showed_date

lv_calendar_get_showed_date (Thumb, 4 bytes, Stack size 0 bytes, lv_calendar.o(.text.lv_calendar_get_showed_date))

[Called By]

- >> value_changed_event_cb
- >> month_event_cb
- >> year_event_cb
- >> value_changed_event_cb
- >> month_event_cb

lv_calendar_set_showed_date (Thumb, 320 bytes, Stack size 40 bytes, lv_calendar.o(.text.lv_calendar_set_showed_date))

[Stack]

- Max Depth = 384
- Call Chain = lv_calendar_set_showed_date ⇒ highlight_update ⇒ lv_btnmatrix_set_btn_ctrl ⇒ lv_btnmatrix_clear_btn_ctrl_all ⇒ lv_btnmatrix_clear_btn_ctrl ⇒ lv_obj_clear_flag ⇒ lv_obj_get_scrollbar_area ⇒ lv_obj_get_scroll_left ⇒ lv_obj_get_self_width ⇒ lv_event_send ⇒ event_send_core ⇒ event_send_core (Cycle)

[Calls]

- >> lv_obj_invalidate
- >> lv_obj_get_child_cnt
- >> lv_event_send
- >> lv_obj_get_child
- >> lv_snprintf
- >> lv_btnmatrix_set_selected_btn
- >> lv_btnmatrix_set_btn_ctrl
- >> lv_btnmatrix_get_selected_btn
- >> lv_btnmatrix_clear_btn_ctrl_all
- >> highlight_update
- >> get_month_length
- >> get_day_of_week

[Called By]

- >> month_event_cb
- >> lv_calendar_constructor
- >> year_event_cb
- >> month_event_cb

lv_calendar_set_today_date (Thumb, 14 bytes, Stack size 0 bytes, lv_calendar.o(.text.lv_calendar_set_today_date))

[Stack]

- Max Depth = 344
- Call Chain = lv_calendar_set_today_date ⇒ highlight_update ⇒ lv_btnmatrix_set_btn_ctrl ⇒ lv_btnmatrix_clear_btn_ctrl_all ⇒ lv_btnmatrix_clear_btn_ctrl ⇒ lv_obj_clear_flag ⇒ lv_obj_get_scrollbar_area ⇒ lv_obj_get_scroll_left ⇒ lv_obj_get_self_width ⇒ lv_event_send ⇒ event_send_core ⇒ event_send_core (Cycle)

[Calls]

- >> highlight_update

[Called By]

- >> lv_calendar_constructor

lv_chart_get_point_pos_by_id (Thumb, 460 bytes, Stack size 72 bytes, lv_chart.o(.text.lv_chart_get_point_pos_by_id))

[Stack]

- Max Depth = 208
- Call Chain = lv_chart_get_point_pos_by_id ⇒ lv_obj_get_scroll_left ⇒ lv_obj_get_self_width ⇒ lv_event_send ⇒ event_send_core ⇒ event_send_core (Cycle)

[Calls]

- >> _lv_ll_get_tail
- >> _lv_ll_get_prev
- >> _lv_ll_get_len
- >> lv_obj_get_scroll_top
- >> lv_obj_get_scroll_left
- >> lv_obj_get_content_width
- >> lv_obj_get_content_height
- >> lv_chart_get_x_start_point
- >> lv_obj_get_style_pad_top
- >> lv_obj_get_style_pad_left
- >> lv_obj_get_style_pad_column
- >> lv_obj_get_style_border_width
- >> lv_map

[Called By]

- >> lv_chart_event

lv_chart_get_x_start_point (Thumb, 18 bytes, Stack size 0 bytes, lv_chart.o(.text.lv_chart_get_x_start_point))

[Called By]

- >> lv_chart_get_point_pos_by_id
- >> lv_chart_event

lv_clamp_height (Thumb, 102 bytes, Stack size 8 bytes, lv_obj_pos.o(.text.lv_clamp_height))

[Stack]

- Max Depth = 8
- Call Chain = lv_clamp_height

[Called By]

- >> lv_obj_refr_size

lv_clamp_width (Thumb, 102 bytes, Stack size 8 bytes, lv_obj_pos.o(.text.lv_clamp_width))

[Stack]

- Max Depth = 8
- Call Chain = lv_clamp_width

[Called By]

- >> lv_obj_refr_size

lv_color_darken (Thumb, 10 bytes, Stack size 0 bytes, lv_color.o(.text.lv_color_darken))

[Stack]

- Max Depth = 8
- Call Chain = lv_color_darken ⇒ lv_color_mix

[Calls]

- >> lv_color_mix

[Called By]

- >> dark_color_filter_cb

lv_color_fill (Thumb, 56 bytes, Stack size 0 bytes, lv_color.o(.text.lv_color_fill))

[Called By]

- >> lv_draw_sw_blend_basic

lv_color_hsv_to_rgb (Thumb, 178 bytes, Stack size 20 bytes, lv_color.o(.text.lv_color_hsv_to_rgb))

[Stack]

- Max Depth = 20
- Call Chain = lv_color_hsv_to_rgb

[Calls]

- >> lv_color_make

[Called By]

- >> lv_colorwheel_get_rgb

lv_colorwheel_get_rgb (Thumb, 14 bytes, Stack size 0 bytes, lv_colorwheel.o(.text.lv_colorwheel_get_rgb))

[Stack]

- Max Depth = 20
- Call Chain = lv_colorwheel_get_rgb ⇒ lv_color_hsv_to_rgb

[Calls]

- >> lv_color_hsv_to_rgb

[Called By]

- >> lv_colorwheel_event

lv_colorwheel_set_hsv (Thumb, 102 bytes, Stack size 16 bytes, lv_colorwheel.o(.text.lv_colorwheel_set_hsv))

[Stack]

- Max Depth = 208
- Call Chain = lv_colorwheel_set_hsv ⇒ refr_knob_pos ⇒ invalidate_knob ⇒ lv_obj_invalidate_area ⇒ _lv_inv_area ⇒ _lv_area_is_in ⇒ _lv_area_is_point_on ⇒ _lv_area_is_point_on (Cycle)

[Calls]

- >> lv_obj_invalidate
- >> refr_knob_pos

[Called By]

- >> lv_colorwheel_event

lv_disp_draw_buf_init (Thumb, 26 bytes, Stack size 24 bytes, lv_hal_disp.o(.text.lv_disp_draw_buf_init))

[Stack]

- Max Depth = 44
- Call Chain = lv_disp_draw_buf_init ⇒ lv_memset_00 ⇒ __aeabi_memclr4

[Calls]

- >> lv_memset_00

[Called By]

- >> lv_port_disp_init

lv_disp_drv_init (Thumb, 68 bytes, Stack size 8 bytes, lv_hal_disp.o(.text.lv_disp_drv_init))

[Stack]

- Max Depth = 28
- Call Chain = lv_disp_drv_init ⇒ lv_memset_00 ⇒ __aeabi_memclr4

[Calls]

- >> lv_memset_00

[Called By]

- >> lv_port_disp_init

lv_disp_drv_register (Thumb, 280 bytes, Stack size 24 bytes, lv_hal_disp.o(.text.lv_disp_drv_register))

[Stack]

- Max Depth = 320
- Call Chain = lv_disp_drv_register ⇒ lv_theme_default_init ⇒ lv_obj_report_style_change ⇒ report_style_change_core ⇒ report_style_change_core (Cycle)

[Calls]

- >> lv_obj_invalidate
- >> lv_obj_clear_flag
- >> _lv_ll_ins_head
- >> _lv_ll_init
- >> lv_memset_00
- >> lv_mem_alloc
- >> lv_obj_set_scrollbar_mode
- >> lv_palette_main
- >> lv_theme_default_is_inited
- >> lv_theme_default_init
- >> lv_theme_default_get
- >> lv_timer_ready
- >> lv_timer_create
- >> lv_obj_remove_style_all

[Called By]

- >> lv_port_disp_init

lv_disp_flush_ready (Thumb, 10 bytes, Stack size 0 bytes, lv_hal_disp.o(.text.lv_disp_flush_ready))

[Called By]

- >> disp_flush

lv_disp_get_default (Thumb, 8 bytes, Stack size 0 bytes, lv_hal_disp.o(.text.lv_disp_get_default))

[Called By]

- >> lv_disp_get_scr_act
- >> lv_scr_act
- >> lv_disp_is_invalidation_enabled
- >> lv_disp_get_theme
- >> lv_disp_get_scr_prev
- >> lv_disp_get_layer_top
- >> lv_disp_get_layer_sys
- >> _lv_inv_area
- >> lv_indev_drv_register
- >> lv_obj_class_create_obj
- >> lv_theme_get_from_obj
- >> _lv_disp_refr_timer
- >> lv_layer_sys
- >> lv_theme_default_init
- >> lv_dropdown_open

lv_disp_get_dpi (Thumb, 24 bytes, Stack size 0 bytes, lv_hal_disp.o(.text.lv_disp_get_dpi))

[Called By]

- >> lv_obj_get_scrollbar_area
- >> style_init
- >> lv_disp_dpx
- >> lv_arc_event
- >> invalidate_button_area
- >> lv_label_refr_text
- >> lv_slider_constructor

lv_disp_get_draw_buf (Thumb, 6 bytes, Stack size 0 bytes, lv_hal_disp.o(.text.lv_disp_get_draw_buf))

[Called By]

- >> refr_area_part

lv_disp_get_hor_res (Thumb, 40 bytes, Stack size 0 bytes, lv_hal_disp.o(.text.lv_disp_get_hor_res))

[Called By]

- >> _lv_inv_area
- >> lv_indev_read_timer_cb
- >> lv_obj_scroll_by
- >> lv_obj_class_create_obj
- >> _lv_disp_refr_timer
- >> refr_area_part
- >> lv_draw_sw_line
- >> lv_draw_sw_letter
- >> lv_draw_sw_img_decoded
- >> lv_theme_default_init

lv_disp_get_layer_sys (Thumb, 18 bytes, Stack size 8 bytes, lv_disp.o(.text.lv_disp_get_layer_sys))

[Stack]

- Max Depth = 8
- Call Chain = lv_disp_get_layer_sys

[Calls]

- >> lv_disp_get_default

[Called By]

- >> indev_proc_press
- >> lv_obj_area_is_visible
- >> refr_area_part
- >> lv_layer_sys

lv_disp_get_layer_top (Thumb, 18 bytes, Stack size 8 bytes, lv_disp.o(.text.lv_disp_get_layer_top))

[Stack]

- Max Depth = 8
- Call Chain = lv_disp_get_layer_top

[Calls]

- >> lv_disp_get_default

[Called By]

- >> indev_proc_press
- >> lv_obj_area_is_visible
- >> refr_area_part

lv_disp_get_next (Thumb, 20 bytes, Stack size 0 bytes, lv_hal_disp.o(.text.lv_disp_get_next))

[Calls]

- >> _lv_ll_get_next
- >> _lv_ll_get_head

[Called By]

- >> lv_obj_report_style_change

lv_disp_get_scr_act (Thumb, 18 bytes, Stack size 8 bytes, lv_disp.o(.text.lv_disp_get_scr_act))

[Stack]

- Max Depth = 8
- Call Chain = lv_disp_get_scr_act

[Calls]

- >> lv_disp_get_default

[Called By]

- >> lv_scr_act
- >> indev_proc_press
- >> lv_obj_area_is_visible
- >> refr_obj_and_children
- >> refr_area_part

lv_disp_get_scr_prev (Thumb, 18 bytes, Stack size 8 bytes, lv_disp.o(.text.lv_disp_get_scr_prev))

[Stack]

- Max Depth = 8
- Call Chain = lv_disp_get_scr_prev

[Calls]

- >> lv_disp_get_default

[Called By]

- >> lv_obj_area_is_visible

lv_disp_get_theme (Thumb, 12 bytes, Stack size 8 bytes, lv_disp.o(.text.lv_disp_get_theme))

[Stack]

- Max Depth = 8
- Call Chain = lv_disp_get_theme

[Calls]

- >> lv_disp_get_default

[Called By]

- >> lv_theme_get_from_obj
- >> lv_theme_default_init

lv_disp_get_ver_res (Thumb, 44 bytes, Stack size 0 bytes, lv_hal_disp.o(.text.lv_disp_get_ver_res))

[Called By]

- >> _lv_inv_area
- >> lv_indev_read_timer_cb
- >> lv_obj_scroll_by
- >> lv_obj_class_create_obj
- >> _lv_disp_refr_timer
- >> refr_area_part
- >> lv_dropdown_open

lv_disp_is_invalidation_enabled (Thumb, 28 bytes, Stack size 8 bytes, lv_disp.o(.text.lv_disp_is_invalidation_enabled))

[Stack]

- Max Depth = 8
- Call Chain = lv_disp_is_invalidation_enabled

[Calls]

- >> lv_disp_get_default

[Called By]

- >> _lv_inv_area
- >> lv_obj_invalidate_area

lv_draw_arc (Thumb, 30 bytes, Stack size 24 bytes, lv_draw_arc.o(.text.lv_draw_arc))

[Stack]

- Max Depth = 24
- Call Chain = lv_draw_arc

[Called By]

- >> lv_meter_event
- >> lv_arc_event

lv_draw_arc_dsc_init (Thumb, 22 bytes, Stack size 8 bytes, lv_draw_arc.o(.text.lv_draw_arc_dsc_init))

[Stack]

- Max Depth = 28
- Call Chain = lv_draw_arc_dsc_init ⇒ lv_memset_00 ⇒ __aeabi_memclr4

[Calls]

- >> lv_memset_00

[Called By]

- >> lv_meter_event
- >> lv_arc_event

lv_draw_arc_get_area (Thumb, 1008 bytes, Stack size 48 bytes, lv_draw_arc.o(.text.lv_draw_arc_get_area))

[Stack]

- Max Depth = 48
- Call Chain = lv_draw_arc_get_area

[Called By]

- >> inv_arc_area

lv_draw_img (Thumb, 608 bytes, Stack size 88 bytes, lv_draw_img.o(.text.lv_draw_img))

[Stack]

- Max Depth = 664
- Call Chain = lv_draw_img ⇒ show_error ⇒ lv_draw_label ⇒ lv_txt_get_size ⇒ _lv_txt_get_next_line ⇒ lv_font_get_glyph_width ⇒ lv_font_get_glyph_dsc

[Calls]

- >> lv_mem_buf_release
- >> lv_mem_buf_get
- >> _lv_area_intersect
- >> lv_img_decoder_read_line
- >> lv_img_decoder_close
- >> lv_area_set_height
- >> _lv_img_cache_open
- >> _lv_img_buf_get_transformed_area
- >> show_error

[Called By]

- >> refr_area_part
- >> lv_draw_sw_layer_blend
- >> draw_bg_img
- >> lv_meter_event
- >> lv_img_event
- >> lv_dropdown_event

lv_draw_img_dsc_init (Thumb, 34 bytes, Stack size 8 bytes, lv_draw_img.o(.text.lv_draw_img_dsc_init))

[Stack]

- Max Depth = 28
- Call Chain = lv_draw_img_dsc_init ⇒ lv_memset_00 ⇒ __aeabi_memclr4

[Calls]

- >> lv_memset_00

[Called By]

- >> refr_obj
- >> refr_area_part
- >> draw_bg_img
- >> lv_meter_event
- >> lv_img_event
- >> lv_dropdown_event

lv_draw_init (Thumb, 2 bytes, Stack size 0 bytes, lv_draw.o(.text.lv_draw_init))

[Called By]

- >> lv_init

lv_draw_label (Thumb, 1392 bytes, Stack size 248 bytes, lv_draw_label.o(.text.lv_draw_label))

[Stack]

- Max Depth = 464
- Call Chain = lv_draw_label ⇒ lv_txt_get_size ⇒ _lv_txt_get_next_line ⇒ lv_font_get_glyph_width ⇒ lv_font_get_glyph_dsc

[Calls]

- >> lv_draw_rect_dsc_init
- >> lv_draw_rect
- >> _lv_area_intersect
- >> lv_txt_get_size
- >> lv_txt_get_width
- >> lv_font_get_glyph_width
- >> lv_draw_line_dsc_init
- >> lv_draw_line
- >> _lv_txt_get_next_line
- >> _lv_txt_encoded_letter_next_2
- >> __aeabi_memcpy

[Called By]

- >> draw_bg_img
- >> show_error
- >> draw_y_ticks
- >> draw_x_ticks
- >> lv_meter_event
- >> lv_btnmatrix_event
- >> lv_checkbox_event
- >> lv_img_event
- >> lv_dropdown_event
- >> draw_box_label
- >> lv_label_event
- >> lv_roller_label_event
- >> lv_roller_event
- >> lv_textarea_event
- >> lv_table_event

lv_draw_label_dsc_init (Thumb, 48 bytes, Stack size 16 bytes, lv_draw_label.o(.text.lv_draw_label_dsc_init))

[Stack]

- Max Depth = 36
- Call Chain = lv_draw_label_dsc_init ⇒ lv_memset_00 ⇒ __aeabi_memclr4

[Calls]

- >> lv_memset_00
- >> lv_palette_main

[Called By]

- >> draw_bg_img
- >> show_error
- >> draw_y_ticks
- >> draw_x_ticks
- >> lv_meter_event
- >> lv_btnmatrix_event
- >> lv_checkbox_event
- >> lv_img_event
- >> lv_dropdown_event
- >> draw_box_label
- >> lv_label_event
- >> lv_roller_label_event
- >> lv_roller_event
- >> lv_textarea_event
- >> lv_table_event

lv_draw_layer_adjust (Thumb, 8 bytes, Stack size 0 bytes, lv_draw_layer.o(.text.lv_draw_layer_adjust))

[Called By]

- >> refr_obj

lv_draw_layer_blend (Thumb, 8 bytes, Stack size 0 bytes, lv_draw_layer.o(.text.lv_draw_layer_blend))

[Called By]

- >> refr_obj

lv_draw_layer_create (Thumb, 88 bytes, Stack size 24 bytes, lv_draw_layer.o(.text.lv_draw_layer_create))

[Stack]

- Max Depth = 96
- Call Chain = lv_draw_layer_create ⇒ lv_mem_free ⇒ lv_tlsf_free ⇒ block_merge_next ⇒ block_remove ⇒ remove_free_block

[Calls]

- >> lv_mem_free
- >> lv_memset_00
- >> lv_mem_alloc
- >> _lv_refr_get_disp_refreshing

[Called By]

- >> refr_obj

lv_draw_layer_destroy (Thumb, 68 bytes, Stack size 16 bytes, lv_draw_layer.o(.text.lv_draw_layer_destroy))

[Stack]

- Max Depth = 88
- Call Chain = lv_draw_layer_destroy ⇒ lv_mem_free ⇒ lv_tlsf_free ⇒ block_merge_next ⇒ block_remove ⇒ remove_free_block

[Calls]

- >> lv_mem_free
- >> _lv_refr_get_disp_refreshing
- >> lv_draw_wait_for_finish

[Called By]

- >> refr_obj

lv_draw_line (Thumb, 24 bytes, Stack size 8 bytes, lv_draw_line.o(.text.lv_draw_line))

[Stack]

- Max Depth = 8
- Call Chain = lv_draw_line

[Called By]

- >> lv_draw_label
- >> lv_chart_event
- >> draw_y_ticks
- >> draw_x_ticks
- >> lv_colorwheel_event
- >> lv_meter_event
- >> lv_line_event

lv_draw_line_dsc_init (Thumb, 22 bytes, Stack size 8 bytes, lv_draw_line.o(.text.lv_draw_line_dsc_init))

[Stack]

- Max Depth = 28
- Call Chain = lv_draw_line_dsc_init ⇒ lv_memset_00 ⇒ __aeabi_memclr4

[Calls]

- >> lv_memset_00

[Called By]

- >> lv_draw_label
- >> lv_chart_event
- >> draw_y_ticks
- >> draw_x_ticks
- >> lv_colorwheel_event
- >> lv_meter_event
- >> lv_line_event

lv_draw_mask_add (Thumb, 44 bytes, Stack size 8 bytes, lv_draw_mask.o(.text.lv_draw_mask_add))

[Stack]

- Max Depth = 8
- Call Chain = lv_draw_mask_add

[Called By]

- >> mask_event_cb
- >> lv_obj_event
- >> lv_draw_sw_rect
- >> lv_draw_sw_polygon
- >> lv_draw_sw_line
- >> lv_draw_sw_arc
- >> draw_border_generic
- >> draw_bg
- >> lv_colorwheel_event
- >> lv_meter_event
- >> lv_bar_event

lv_draw_mask_angle_init (Thumb, 140 bytes, Stack size 32 bytes, lv_draw_mask.o(.text.lv_draw_mask_angle_init))

[Stack]

- Max Depth = 116
- Call Chain = lv_draw_mask_angle_init ⇒ lv_draw_mask_line_angle_init ⇒ lv_draw_mask_line_points_init ⇒ lv_memset_00 ⇒ __aeabi_memclr4

[Calls]

- >> lv_draw_mask_line_angle_init

[Called By]

- >> lv_draw_sw_arc

lv_draw_mask_apply (Thumb, 72 bytes, Stack size 40 bytes, lv_draw_mask.o(.text.lv_draw_mask_apply))

[Stack]

- Max Depth = 40
- Call Chain = lv_draw_mask_apply

[Called By]

- >> lv_draw_sw_rect
- >> lv_draw_sw_line
- >> lv_draw_sw_letter
- >> lv_draw_sw_img_decoded
- >> draw_border_generic
- >> draw_bg

lv_draw_mask_fade_init (Thumb, 36 bytes, Stack size 8 bytes, lv_draw_mask.o(.text.lv_draw_mask_fade_init))

[Stack]

- Max Depth = 8
- Call Chain = lv_draw_mask_fade_init

[Called By]

- >> mask_event_cb

lv_draw_mask_free_param (Thumb, 54 bytes, Stack size 8 bytes, lv_draw_mask.o(.text.lv_draw_mask_free_param))

[Stack]

- Max Depth = 80
- Call Chain = lv_draw_mask_free_param ⇒ lv_mem_free ⇒ lv_tlsf_free ⇒ block_merge_next ⇒ block_remove ⇒ remove_free_block

[Calls]

- >> lv_mem_free

[Called By]

- >> mask_event_cb
- >> lv_obj_event
- >> lv_draw_sw_rect
- >> lv_draw_sw_line
- >> lv_draw_sw_arc
- >> draw_border_generic
- >> draw_bg
- >> lv_colorwheel_event
- >> lv_bar_event

[Address Reference Count : 1]

- lv_meter.o(.text.lv_meter_event)

lv_draw_mask_is_any (Thumb, 88 bytes, Stack size 16 bytes, lv_draw_mask.o(.text.lv_draw_mask_is_any))

[Stack]

- Max Depth = 96
- Call Chain = lv_draw_mask_is_any ⇒ _lv_area_is_in ⇒ _lv_area_is_point_on ⇒ _lv_area_is_point_on (Cycle)

[Calls]

- >> _lv_area_is_in
- >> _lv_area_is_out

[Called By]

- >> lv_draw_sw_rect
- >> lv_draw_sw_line
- >> lv_draw_sw_letter
- >> lv_draw_sw_img_decoded
- >> draw_border_generic
- >> draw_bg

lv_draw_mask_line_angle_init (Thumb, 68 bytes, Stack size 32 bytes, lv_draw_mask.o(.text.lv_draw_mask_line_angle_init))

[Stack]

- Max Depth = 84
- Call Chain = lv_draw_mask_line_angle_init ⇒ lv_draw_mask_line_points_init ⇒ lv_memset_00 ⇒ __aeabi_memclr4

[Calls]

- >> lv_trigo_sin
- >> lv_draw_mask_line_points_init

[Called By]

- >> lv_draw_mask_angle_init

lv_draw_mask_line_points_init (Thumb, 284 bytes, Stack size 32 bytes, lv_draw_mask.o(.text.lv_draw_mask_line_points_init))

[Stack]

- Max Depth = 52
- Call Chain = lv_draw_mask_line_points_init ⇒ lv_memset_00 ⇒ __aeabi_memclr4

[Calls]

- >> lv_memset_00

[Called By]

- >> lv_draw_sw_polygon
- >> lv_draw_sw_line
- >> lv_draw_mask_line_angle_init

lv_draw_mask_radius_init (Thumb, 964 bytes, Stack size 88 bytes, lv_draw_mask.o(.text.lv_draw_mask_radius_init))

[Stack]

- Max Depth = 216
- Call Chain = lv_draw_mask_radius_init ⇒ lv_mem_buf_get ⇒ lv_mem_realloc ⇒ lv_tlsf_realloc ⇒ lv_tlsf_free ⇒ block_merge_next ⇒ block_remove ⇒ remove_free_block

[Calls]

- >> lv_mem_buf_release
- >> lv_mem_buf_get
- >> lv_mem_free
- >> lv_memset_00
- >> lv_mem_alloc

[Called By]

- >> lv_obj_event
- >> lv_draw_sw_rect
- >> lv_draw_sw_arc
- >> draw_border_generic
- >> draw_bg
- >> lv_colorwheel_event
- >> lv_bar_event

[Address Reference Count : 1]

- lv_meter.o(.text.lv_meter_event)

lv_draw_mask_remove_custom (Thumb, 44 bytes, Stack size 24 bytes, lv_draw_mask.o(.text.lv_draw_mask_remove_custom))

[Stack]

- Max Depth = 24
- Call Chain = lv_draw_mask_remove_custom

[Calls]

- >> lv_draw_mask_remove_id

[Called By]

- >> lv_obj_event
- >> lv_draw_sw_polygon

lv_draw_mask_remove_id (Thumb, 36 bytes, Stack size 0 bytes, lv_draw_mask.o(.text.lv_draw_mask_remove_id))

[Called By]

- >> mask_event_cb
- >> lv_draw_mask_remove_custom
- >> lv_draw_sw_rect
- >> lv_draw_sw_arc
- >> draw_border_generic
- >> draw_bg
- >> lv_colorwheel_event
- >> lv_meter_event
- >> lv_bar_event

[Address Reference Count : 1]

- lv_draw_sw_line.o(.text.lv_draw_sw_line)

lv_draw_rect (Thumb, 40 bytes, Stack size 8 bytes, lv_draw_rect.o(.text.lv_draw_rect))

[Stack]

- Max Depth = 8
- Call Chain = lv_draw_rect

[Called By]

- >> lv_obj_event
- >> refr_area_part
- >> lv_draw_sw_polygon
- >> lv_draw_sw_line
- >> lv_draw_sw_arc
- >> lv_draw_label
- >> show_error
- >> lv_chart_event
- >> lv_colorwheel_event
- >> lv_led_event
- >> lv_meter_event
- >> lv_bar_event
- >> lv_arc_event
- >> lv_btnmatrix_event
- >> lv_checkbox_event
- >> draw_box
- >> lv_roller_event
- >> lv_slider_event
- >> lv_switch_event
- >> lv_textarea_event
- >> lv_table_event

lv_draw_rect_dsc_init (Thumb, 72 bytes, Stack size 8 bytes, lv_draw_rect.o(.text.lv_draw_rect_dsc_init))

[Stack]

- Max Depth = 28
- Call Chain = lv_draw_rect_dsc_init ⇒ lv_memset_00 ⇒ __aeabi_memclr4

[Calls]

- >> lv_memset_00

[Called By]

- >> lv_obj_event
- >> refr_area_part
- >> lv_draw_sw_line
- >> lv_draw_sw_letter
- >> lv_draw_sw_arc
- >> lv_draw_label
- >> show_error
- >> lv_chart_event
- >> lv_colorwheel_event
- >> lv_led_event
- >> lv_meter_event
- >> lv_bar_event
- >> lv_arc_event
- >> lv_btnmatrix_event
- >> lv_checkbox_event
- >> draw_box
- >> lv_roller_event
- >> lv_slider_event
- >> lv_switch_event
- >> lv_textarea_event
- >> lv_table_event

lv_draw_sw_arc (Thumb, 2708 bytes, Stack size 376 bytes, lv_draw_sw_arc.o(.text.lv_draw_sw_arc))

[Stack]

- Max Depth = 592
- Call Chain = lv_draw_sw_arc ⇒ lv_draw_mask_radius_init ⇒ lv_mem_buf_get ⇒ lv_mem_realloc ⇒ lv_tlsf_realloc ⇒ lv_tlsf_free ⇒ block_merge_next ⇒ block_remove ⇒ remove_free_block

[Calls]

- >> lv_draw_mask_remove_id
- >> lv_draw_mask_free_param
- >> lv_draw_mask_add
- >> lv_draw_rect_dsc_init
- >> lv_draw_rect
- >> lv_draw_mask_radius_init
- >> _lv_area_intersect
- >> lv_trigo_sin
- >> lv_draw_mask_angle_init
- >> get_rounded_area

[Address Reference Count : 1]

- lv_draw_sw.o(.text.lv_draw_sw_init_ctx)

lv_draw_sw_bg (Thumb, 26 bytes, Stack size 16 bytes, lv_draw_sw_rect.o(.text.lv_draw_sw_bg))

[Stack]

- Max Depth = 776
- Call Chain = lv_draw_sw_bg ⇒ draw_bg_img ⇒ lv_draw_img ⇒ show_error ⇒ lv_draw_label ⇒ lv_txt_get_size ⇒ _lv_txt_get_next_line ⇒ lv_font_get_glyph_width ⇒ lv_font_get_glyph_dsc

[Calls]

- >> draw_bg_img
- >> draw_bg

[Address Reference Count : 1]

- lv_draw_sw.o(.text.lv_draw_sw_init_ctx)

lv_draw_sw_blend (Thumb, 42 bytes, Stack size 24 bytes, lv_draw_sw_blend.o(.text.lv_draw_sw_blend))

[Stack]

- Max Depth = 44
- Call Chain = lv_draw_sw_blend ⇒ _lv_area_intersect

[Calls]

- >> _lv_area_intersect

[Called By]

- >> lv_draw_sw_rect
- >> lv_draw_sw_line
- >> lv_draw_sw_letter
- >> lv_draw_sw_img_decoded
- >> draw_border_generic
- >> draw_bg

lv_draw_sw_blend_basic (Thumb, 3492 bytes, Stack size 152 bytes, lv_draw_sw_blend.o(.text.lv_draw_sw_blend_basic))

[Stack]

- Max Depth = 172
- Call Chain = lv_draw_sw_blend_basic ⇒ lv_memcpy

[Calls]

- >> lv_memcpy
- >> lv_area_get_size
- >> _lv_area_intersect
- >> _lv_refr_get_disp_refreshing
- >> lv_color_fill
- >> lv_area_move
- >> lv_color_mix

[Address Reference Count : 1]

- lv_draw_sw.o(.text.lv_draw_sw_init_ctx)

lv_draw_sw_buffer_copy (Thumb, 104 bytes, Stack size 32 bytes, lv_draw_sw.o(.text.lv_draw_sw_buffer_copy))

[Stack]

- Max Depth = 52
- Call Chain = lv_draw_sw_buffer_copy ⇒ lv_memcpy

[Calls]

- >> lv_memcpy

[Address Reference Count : 1]

- lv_draw_sw.o(.text.lv_draw_sw_init_ctx)

lv_draw_sw_img_decoded (Thumb, 1200 bytes, Stack size 176 bytes, lv_draw_sw_img.o(.text.lv_draw_sw_img_decoded))

[Stack]

- Max Depth = 304 + Unknown Stack Size
- Call Chain = lv_draw_sw_img_decoded ⇒ lv_mem_buf_get ⇒ lv_mem_realloc ⇒ lv_tlsf_realloc ⇒ lv_tlsf_free ⇒ block_merge_next ⇒ block_remove ⇒ remove_free_block

[Calls]

- >> lv_mem_buf_release
- >> lv_mem_buf_get
- >> lv_disp_get_hor_res
- >> lv_memcpy
- >> lv_memset_00
- >> lv_area_get_size
- >> _lv_area_intersect
- >> _lv_refr_get_disp_refreshing
- >> lv_draw_sw_blend
- >> lv_area_move
- >> lv_memset_ff
- >> lv_draw_transform
- >> lv_draw_mask_is_any
- >> lv_draw_mask_apply

[Address Reference Count : 1]

- lv_draw_sw.o(.text.lv_draw_sw_init_ctx)

lv_draw_sw_init_ctx (Thumb, 140 bytes, Stack size 24 bytes, lv_draw_sw.o(.text.lv_draw_sw_init_ctx))

[Stack]

- Max Depth = 44
- Call Chain = lv_draw_sw_init_ctx ⇒ lv_memset_00 ⇒ __aeabi_memclr4

[Calls]

- >> lv_memset_00

[Address Reference Count : 1]

- lv_hal_disp.o(.text.lv_disp_drv_init)

lv_draw_sw_layer_adjust (Thumb, 78 bytes, Stack size 24 bytes, lv_draw_sw_layer.o(.text.lv_draw_sw_layer_adjust))

[Stack]

- Max Depth = 44
- Call Chain = lv_draw_sw_layer_adjust ⇒ lv_memset_00 ⇒ __aeabi_memclr4

[Calls]

- >> lv_memset_00
- >> _lv_refr_get_disp_refreshing

[Address Reference Count : 1]

- lv_draw_sw.o(.text.lv_draw_sw_init_ctx)

lv_draw_sw_layer_blend (Thumb, 146 bytes, Stack size 40 bytes, lv_draw_sw_layer.o(.text.lv_draw_sw_layer_blend))

[Stack]

- Max Depth = 704
- Call Chain = lv_draw_sw_layer_blend ⇒ lv_draw_img ⇒ show_error ⇒ lv_draw_label ⇒ lv_txt_get_size ⇒ _lv_txt_get_next_line ⇒ lv_font_get_glyph_width ⇒ lv_font_get_glyph_dsc

[Calls]

- >> lv_draw_img
- >> _lv_refr_get_disp_refreshing
- >> lv_img_cache_invalidate_src
- >> lv_draw_wait_for_finish

[Address Reference Count : 1]

- lv_draw_sw.o(.text.lv_draw_sw_init_ctx)

lv_draw_sw_layer_create (Thumb, 232 bytes, Stack size 16 bytes, lv_draw_sw_layer.o(.text.lv_draw_sw_layer_create))

[Stack]

- Max Depth = 88
- Call Chain = lv_draw_sw_layer_create ⇒ lv_mem_alloc ⇒ lv_tlsf_malloc ⇒ block_prepare_used ⇒ block_split ⇒ block_mark_as_free ⇒ block_link_next

[Calls]

- >> lv_memset_00
- >> lv_mem_alloc
- >> lv_area_get_size
- >> _lv_refr_get_disp_refreshing

[Address Reference Count : 1]

- lv_draw_sw.o(.text.lv_draw_sw_init_ctx)

lv_draw_sw_layer_destroy (Thumb, 6 bytes, Stack size 0 bytes, lv_draw_sw_layer.o(.text.lv_draw_sw_layer_destroy))

[Stack]

- Max Depth = 72
- Call Chain = lv_draw_sw_layer_destroy ⇒ lv_mem_free ⇒ lv_tlsf_free ⇒ block_merge_next ⇒ block_remove ⇒ remove_free_block

[Calls]

- >> lv_mem_free

[Address Reference Count : 1]

- lv_draw_sw.o(.text.lv_draw_sw_init_ctx)

lv_draw_sw_letter (Thumb, 980 bytes, Stack size 184 bytes, lv_draw_sw_letter.o(.text.lv_draw_sw_letter))

[Stack]

- Max Depth = 312
- Call Chain = lv_draw_sw_letter ⇒ lv_mem_buf_get ⇒ lv_mem_realloc ⇒ lv_tlsf_realloc ⇒ lv_tlsf_free ⇒ block_merge_next ⇒ block_remove ⇒ remove_free_block

[Calls]

- >> lv_mem_buf_release
- >> lv_mem_buf_get
- >> lv_disp_get_hor_res
- >> lv_area_set
- >> lv_memset_00
- >> lv_draw_rect_dsc_init
- >> _lv_refr_get_disp_refreshing
- >> lv_draw_sw_blend
- >> lv_draw_mask_is_any
- >> lv_draw_mask_apply
- >> lv_font_get_glyph_dsc
- >> lv_font_get_glyph_bitmap

[Address Reference Count : 1]

- lv_draw_sw.o(.text.lv_draw_sw_init_ctx)

lv_draw_sw_line (Thumb, 1960 bytes, Stack size 312 bytes, lv_draw_sw_line.o(.text.lv_draw_sw_line))

[Stack]

- Max Depth = 440 + Unknown Stack Size
- Call Chain = lv_draw_sw_line ⇒ lv_mem_buf_get ⇒ lv_mem_realloc ⇒ lv_tlsf_realloc ⇒ lv_tlsf_free ⇒ block_merge_next ⇒ block_remove ⇒ remove_free_block

[Calls]

- >> lv_mem_buf_release
- >> lv_mem_buf_get
- >> lv_draw_mask_free_param
- >> lv_draw_mask_add
- >> lv_disp_get_hor_res
- >> lv_memset_00
- >> lv_draw_rect_dsc_init
- >> lv_draw_rect
- >> lv_area_get_size
- >> _lv_area_intersect
- >> _lv_refr_get_disp_refreshing
- >> lv_draw_sw_blend
- >> lv_memset_ff
- >> lv_draw_mask_is_any
- >> lv_draw_mask_apply
- >> lv_draw_mask_line_points_init

[Address Reference Count : 1]

- lv_draw_sw.o(.text.lv_draw_sw_init_ctx)

lv_draw_sw_polygon (Thumb, 708 bytes, Stack size 96 bytes, lv_draw_sw_polygon.o(.text.lv_draw_sw_polygon))

[Stack]

- Max Depth = 224
- Call Chain = lv_draw_sw_polygon ⇒ lv_mem_buf_get ⇒ lv_mem_realloc ⇒ lv_tlsf_realloc ⇒ lv_tlsf_free ⇒ block_merge_next ⇒ block_remove ⇒ remove_free_block

[Calls]

- >> lv_mem_buf_release
- >> lv_mem_buf_get
- >> lv_draw_mask_add
- >> lv_draw_rect
- >> lv_draw_mask_remove_custom
- >> _lv_area_intersect
- >> lv_draw_mask_line_points_init

[Address Reference Count : 1]

- lv_draw_sw.o(.text.lv_draw_sw_init_ctx)

lv_draw_sw_rect (Thumb, 3632 bytes, Stack size 216 bytes, lv_draw_sw_rect.o(.text.lv_draw_sw_rect))

[Stack]

- Max Depth = 976 + Unknown Stack Size
- Call Chain = lv_draw_sw_rect ⇒ draw_bg_img ⇒ lv_draw_img ⇒ show_error ⇒ lv_draw_label ⇒ lv_txt_get_size ⇒ _lv_txt_get_next_line ⇒ lv_font_get_glyph_width ⇒ lv_font_get_glyph_dsc

[Calls]

- >> lv_mem_buf_release
- >> lv_mem_buf_get
- >> lv_draw_mask_remove_id
- >> lv_draw_mask_free_param
- >> lv_draw_mask_add
- >> lv_memcpy
- >> lv_memset_00
- >> lv_draw_mask_radius_init
- >> _lv_area_is_in
- >> lv_area_increase
- >> _lv_area_intersect
- >> lv_draw_sw_blend
- >> lv_memset_ff
- >> lv_draw_mask_is_any
- >> lv_draw_mask_apply
- >> lv_memset
- >> draw_border_generic
- >> _lv_area_is_out
- >> shadow_blur_corner
- >> draw_bg_img
- >> draw_bg

[Address Reference Count : 1]

- lv_draw_sw.o(.text.lv_draw_sw_init_ctx)

lv_draw_sw_transform (Thumb, 1476 bytes, Stack size 216 bytes, lv_draw_sw_transform.o(.text.lv_draw_sw_transform))

[Stack]

- Max Depth = 236 + Unknown Stack Size
- Call Chain = lv_draw_sw_transform ⇒ transform_point_upscaled

[Calls]

- >> _lv_refr_get_disp_refreshing
- >> lv_memset_ff
- >> transform_point_upscaled

[Address Reference Count : 1]

- lv_draw_sw.o(.text.lv_draw_sw_init_ctx)

lv_draw_sw_wait_for_finish (Thumb, 2 bytes, Stack size 0 bytes, lv_draw_sw.o(.text.lv_draw_sw_wait_for_finish))
[Address Reference Count : 1]

- lv_draw_sw.o(.text.lv_draw_sw_init_ctx)

lv_draw_transform (Thumb, 52 bytes, Stack size 48 bytes, lv_draw_transform.o(.text.lv_draw_transform))

[Stack]

- Max Depth = 48
- Call Chain = lv_draw_transform

[Called By]

- >> lv_draw_sw_img_decoded

lv_draw_wait_for_finish (Thumb, 8 bytes, Stack size 0 bytes, lv_draw.o(.text.lv_draw_wait_for_finish))

[Called By]

- >> lv_draw_layer_destroy
- >> lv_draw_sw_layer_blend

lv_dropdown_close (Thumb, 38 bytes, Stack size 8 bytes, lv_dropdown.o(.text.lv_dropdown_close))

[Stack]

- Max Depth = 336
- Call Chain = lv_dropdown_close ⇒ lv_obj_clear_state ⇒ lv_obj_set_state ⇒ _lv_obj_style_create_transition ⇒ lv_style_set_prop ⇒ lv_style_set_prop_internal ⇒ lv_mem_realloc ⇒ lv_tlsf_realloc ⇒ lv_tlsf_free ⇒ block_merge_next ⇒ block_remove ⇒ remove_free_block

[Calls]

- >> lv_event_send
- >> lv_obj_clear_state
- >> lv_obj_add_flag

[Called By]

- >> lv_dropdown_list_event
- >> lv_dropdown_event
- >> btn_release_handler

lv_dropdown_create (Thumb, 20 bytes, Stack size 8 bytes, lv_dropdown.o(.text.lv_dropdown_create))

[Stack]

- Max Depth = 304
- Call Chain = lv_dropdown_create ⇒ lv_obj_class_init_obj ⇒ lv_theme_apply ⇒ lv_obj_remove_style ⇒ lv_obj_refresh_style ⇒ lv_obj_refresh_ext_draw_size ⇒ lv_obj_invalidate ⇒ lv_obj_invalidate_area ⇒ _lv_inv_area ⇒ _lv_area_is_in ⇒ _lv_area_is_point_on ⇒ _lv_area_is_point_on (Cycle)

[Calls]

- >> lv_obj_class_init_obj
- >> lv_obj_class_create_obj

[Called By]

- >> my_constructor

lv_dropdown_get_options (Thumb, 16 bytes, Stack size 0 bytes, lv_dropdown.o(.text.lv_dropdown_get_options))

[Called By]

- >> year_event_cb
- >> value_changed_event_cb

lv_dropdown_get_selected (Thumb, 4 bytes, Stack size 0 bytes, lv_dropdown.o(.text.lv_dropdown_get_selected))

[Called By]

- >> year_event_cb
- >> month_event_cb

lv_dropdown_get_selected_str (Thumb, 108 bytes, Stack size 24 bytes, lv_dropdown.o(.text.lv_dropdown_get_selected_str))

[Stack]

- Max Depth = 32
- Call Chain = lv_dropdown_get_selected_str ⇒ strlen

[Calls]

- >> strlen

[Called By]

- >> lv_dropdown_event

lv_dropdown_is_open (Thumb, 16 bytes, Stack size 8 bytes, lv_dropdown.o(.text.lv_dropdown_is_open))

[Stack]

- Max Depth = 8
- Call Chain = lv_dropdown_is_open

[Calls]

- >> lv_obj_has_flag

[Called By]

- >> lv_dropdown_event
- >> btn_release_handler

lv_dropdown_open (Thumb, 512 bytes, Stack size 32 bytes, lv_dropdown.o(.text.lv_dropdown_open))

[Stack]

- Max Depth = 568
- Call Chain = lv_dropdown_open ⇒ lv_obj_align_to ⇒ lv_obj_update_layout ⇒ layout_update_core ⇒ layout_update_core (Cycle)

[Calls]

- >> lv_obj_get_style_prop
- >> lv_obj_get_height
- >> lv_obj_align
- >> lv_disp_get_default
- >> lv_obj_set_y
- >> lv_event_send
- >> lv_disp_get_ver_res
- >> lv_obj_set_parent
- >> lv_obj_clear_flag
- >> lv_obj_get_width
- >> lv_obj_add_state
- >> lv_obj_update_layout
- >> lv_obj_set_width
- >> lv_obj_set_height
- >> lv_obj_get_y2
- >> lv_obj_get_y
- >> lv_obj_get_screen
- >> lv_obj_align_to
- >> lv_obj_calculate_style_text_align
- >> lv_obj_move_to_index
- >> lv_label_set_text_static
- >> position_to_selected
- >> lv_obj_get_style_pad_top
- >> lv_obj_get_style_border_width
- >> get_label

[Called By]

- >> lv_dropdown_event
- >> btn_release_handler

lv_dropdown_set_options (Thumb, 122 bytes, Stack size 16 bytes, lv_dropdown.o(.text.lv_dropdown_set_options))

[Stack]

- Max Depth = 176
- Call Chain = lv_dropdown_set_options ⇒ lv_obj_invalidate ⇒ lv_obj_invalidate_area ⇒ _lv_inv_area ⇒ _lv_area_is_in ⇒ _lv_area_is_point_on ⇒ _lv_area_is_point_on (Cycle)

[Calls]

- >> lv_obj_invalidate
- >> lv_mem_free
- >> lv_mem_alloc
- >> strlen
- >> strcpy

[Called By]

- >> my_constructor

lv_dropdown_set_options_static (Thumb, 96 bytes, Stack size 16 bytes, lv_dropdown.o(.text.lv_dropdown_set_options_static))

[Stack]

- Max Depth = 176
- Call Chain = lv_dropdown_set_options_static ⇒ lv_obj_invalidate ⇒ lv_obj_invalidate_area ⇒ _lv_inv_area ⇒ _lv_area_is_in ⇒ _lv_area_is_point_on ⇒ _lv_area_is_point_on (Cycle)

[Calls]

- >> lv_obj_invalidate
- >> lv_mem_free

[Called By]

- >> lv_dropdown_constructor

lv_dropdown_set_selected (Thumb, 44 bytes, Stack size 8 bytes, lv_dropdown.o(.text.lv_dropdown_set_selected))

[Stack]

- Max Depth = 352
- Call Chain = lv_dropdown_set_selected ⇒ position_to_selected ⇒ lv_obj_scroll_to_y ⇒ lv_obj_scroll_by_bounded ⇒ lv_obj_update_layout (Cycle)

[Calls]

- >> lv_obj_invalidate
- >> position_to_selected

[Called By]

- >> value_changed_event_cb

lv_event_get_code (Thumb, 8 bytes, Stack size 0 bytes, lv_event.o(.text.lv_event_get_code))

[Called By]

- >> mask_event_cb
- >> lv_obj_event
- >> lv_chart_event
- >> lv_colorwheel_event
- >> lv_led_event
- >> lv_meter_event
- >> lv_menu_back_event_cb
- >> lv_spinbox_event
- >> lv_tabview_event
- >> cont_scroll_end_event_cb
- >> tileview_event_cb
- >> lv_bar_event
- >> lv_arc_event
- >> lv_btnmatrix_event
- >> lv_checkbox_event
- >> lv_img_event
- >> lv_dropdown_list_event
- >> lv_dropdown_event
- >> lv_label_event
- >> lv_roller_label_event
- >> lv_roller_event
- >> lv_line_event
- >> lv_slider_event
- >> lv_switch_event
- >> lv_textarea_event
- >> label_event_cb
- >> lv_table_event

lv_event_get_current_target (Thumb, 4 bytes, Stack size 0 bytes, lv_event.o(.text.lv_event_get_current_target))

[Called By]

- >> lv_obj_event

lv_event_get_draw_ctx (Thumb, 14 bytes, Stack size 0 bytes, lv_event.o(.text.lv_event_get_draw_ctx))

[Called By]

- >> lv_obj_event
- >> lv_chart_event
- >> lv_colorwheel_event
- >> lv_led_event
- >> lv_meter_event
- >> lv_bar_event
- >> lv_arc_event
- >> lv_btnmatrix_event
- >> lv_checkbox_event
- >> lv_img_event
- >> lv_dropdown_list_event
- >> lv_dropdown_event
- >> lv_label_event
- >> lv_roller_label_event
- >> lv_roller_event
- >> lv_line_event
- >> lv_slider_event
- >> lv_switch_event
- >> lv_textarea_event
- >> lv_table_event

lv_event_get_indev (Thumb, 14 bytes, Stack size 0 bytes, lv_event.o(.text.lv_event_get_indev))

[Called By]

- >> lv_obj_event

lv_event_get_param (Thumb, 4 bytes, Stack size 0 bytes, lv_event.o(.text.lv_event_get_param))

[Called By]

- >> lv_obj_event
- >> draw_part_begin_event_cb
- >> lv_chart_event
- >> lv_colorwheel_event
- >> lv_spinbox_event
- >> lv_bar_event
- >> lv_arc_event
- >> lv_btnmatrix_event
- >> lv_checkbox_event
- >> lv_img_event
- >> lv_dropdown_event
- >> lv_label_event
- >> lv_roller_label_event
- >> lv_roller_event
- >> lv_line_event
- >> lv_slider_event
- >> lv_switch_event
- >> lv_textarea_event
- >> lv_table_event

lv_event_get_target (Thumb, 4 bytes, Stack size 0 bytes, lv_event.o(.text.lv_event_get_target))

[Called By]

- >> mask_event_cb
- >> lv_obj_event
- >> value_changed_event_cb
- >> month_event_cb
- >> draw_part_begin_event_cb
- >> lv_chart_event
- >> year_event_cb
- >> value_changed_event_cb
- >> month_event_cb
- >> lv_colorwheel_event
- >> lv_keyboard_def_event_cb
- >> lv_led_event
- >> lv_meter_event
- >> lv_menu_back_event_cb
- >> lv_spinbox_event
- >> lv_tabview_event
- >> cont_scroll_end_event_cb
- >> btns_value_changed_event_cb
- >> tileview_event_cb
- >> lv_bar_event
- >> lv_arc_event
- >> lv_btnmatrix_event
- >> lv_checkbox_event
- >> lv_img_event
- >> lv_dropdown_list_event
- >> lv_dropdown_event
- >> lv_label_event
- >> lv_roller_label_event
- >> lv_roller_event
- >> lv_line_event
- >> lv_slider_event
- >> lv_switch_event
- >> lv_textarea_event
- >> label_event_cb
- >> lv_table_event

lv_event_get_user_data (Thumb, 4 bytes, Stack size 0 bytes, lv_event.o(.text.lv_event_get_user_data))

[Called By]

- >> year_event_cb
- >> month_event_cb
- >> lv_menu_value_changed_event_cb
- >> lv_menu_back_event_cb

lv_event_send (Thumb, 56 bytes, Stack size 48 bytes, lv_event.o(.text.lv_event_send))

[Stack]

- Max Depth = 80
- Call Chain = lv_event_send ⇒ event_send_core ⇒ event_send_core (Cycle)

[Calls]

- >> event_send_core

[Called By]

- >> lv_obj_del
- >> lv_obj_hit_test
- >> lv_indev_read_timer_cb
- >> _lv_indev_scroll_throw_handler
- >> _lv_indev_scroll_handler
- >> indev_proc_release
- >> indev_proc_press
- >> lv_group_set_editing
- >> lv_group_send_data
- >> lv_group_remove_obj
- >> lv_group_focus_obj
- >> focus_next_core
- >> lv_obj_scroll_by
- >> _lv_obj_scroll_by_raw
- >> lv_obj_refresh_style
- >> lv_obj_refresh_ext_draw_size
- >> lv_obj_class_init_obj
- >> lv_obj_event
- >> lv_obj_refr_size
- >> lv_obj_move_to
- >> lv_obj_get_self_width
- >> lv_obj_get_self_height
- >> scroll_area_into_view
- >> scroll_anim_ready_cb
- >> refresh_children_style
- >> lv_obj_move_to_index
- >> obj_del_core
- >> refr_obj
- >> lv_refr_get_top_obj
- >> grid_update
- >> flex_update
- >> children_repos
- >> my_constructor
- >> lv_calendar_set_showed_date
- >> lv_chart_event
- >> draw_y_ticks
- >> draw_x_ticks
- >> my_constructor
- >> lv_colorwheel_event
- >> lv_textarea_del_char
- >> lv_textarea_add_text
- >> lv_textarea_add_char
- >> lv_keyboard_def_event_cb
- >> lv_led_event
- >> lv_meter_event
- >> lv_menu_set_page
- >> lv_textarea_set_text
- >> cont_scroll_end_event_cb
- >> tileview_event_cb
- >> lv_bar_event
- >> lv_arc_event
- >> lv_btnmatrix_event
- >> lv_checkbox_event
- >> lv_dropdown_open
- >> lv_dropdown_close
- >> lv_dropdown_list_event
- >> btn_release_handler
- >> lv_roller_event
- >> lv_slider_event
- >> lv_textarea_event
- >> insert_handler
- >> lv_table_event

[Address Reference Count : 3]

- lv_refr.o(.text.lv_obj_redraw)
- lv_obj_tree.o(.text.lv_obj_set_parent)
- lv_refr.o(.text.refr_obj_and_children)

lv_event_set_cover_res (Thumb, 18 bytes, Stack size 0 bytes, lv_event.o(.text.lv_event_set_cover_res))

[Called By]

- >> mask_event_cb

lv_event_set_ext_draw_size (Thumb, 22 bytes, Stack size 0 bytes, lv_event.o(.text.lv_event_set_ext_draw_size))

[Called By]

- >> lv_obj_event
- >> lv_chart_event
- >> lv_btnmatrix_event
- >> lv_label_event

lv_example_roller_3 (Thumb, 168 bytes, Stack size 16 bytes, gui.o(.text.lv_example_roller_3))

[Stack]

- Max Depth = 472
- Call Chain = lv_example_roller_3 ⇒ lv_roller_set_options ⇒ lv_label_set_text ⇒ lv_label_refr_text ⇒ lv_label_get_letter_on ⇒ _lv_txt_get_next_line ⇒ lv_font_get_glyph_width ⇒ lv_font_get_glyph_dsc

[Calls]

- >> lv_style_set_text_color
- >> lv_style_set_pad_top
- >> lv_style_set_pad_right
- >> lv_style_set_pad_left
- >> lv_style_set_pad_bottom
- >> lv_style_set_border_width
- >> lv_style_set_bg_color
- >> lv_style_init
- >> lv_roller_set_visible_row_count
- >> lv_roller_set_options
- >> lv_roller_create
- >> lv_obj_set_style_bg_opa
- >> lv_obj_align
- >> lv_obj_add_style
- >> lv_obj_add_event_cb
- >> lv_scr_act

[Called By]

- >> GUI_Application

lv_extra_init (Thumb, 14 bytes, Stack size 8 bytes, lv_extra.o(.text.lv_extra_init))

[Stack]

- Max Depth = 160
- Call Chain = lv_extra_init ⇒ lv_grid_init ⇒ lv_layout_register ⇒ lv_mem_realloc ⇒ lv_tlsf_realloc ⇒ lv_tlsf_free ⇒ block_merge_next ⇒ block_remove ⇒ remove_free_block

[Calls]

- >> lv_grid_init
- >> lv_flex_init

[Called By]

- >> lv_init

lv_flex_init (Thumb, 60 bytes, Stack size 16 bytes, lv_flex.o(.text.lv_flex_init))

[Stack]

- Max Depth = 152
- Call Chain = lv_flex_init ⇒ lv_layout_register ⇒ lv_mem_realloc ⇒ lv_tlsf_realloc ⇒ lv_tlsf_free ⇒ block_merge_next ⇒ block_remove ⇒ remove_free_block

[Calls]

- >> lv_layout_register

[Called By]

- >> lv_extra_init

lv_font_get_bitmap_fmt_txt (Thumb, 44 bytes, Stack size 8 bytes, lv_font_fmt_txt.o(.text.lv_font_get_bitmap_fmt_txt))

[Stack]

- Max Depth = 80
- Call Chain = lv_font_get_bitmap_fmt_txt ⇒ get_glyph_dsc_id ⇒ _lv_utils_bsearch

[Calls]

- >> get_glyph_dsc_id

[Address Reference Count : 1]

- lv_font_montserrat_14.o(.rodata.lv_font_montserrat_14)

lv_font_get_glyph_bitmap (Thumb, 8 bytes, Stack size 0 bytes, lv_font.o(.text.lv_font_get_glyph_bitmap))

[Called By]

- >> lv_draw_sw_letter

lv_font_get_glyph_dsc (Thumb, 162 bytes, Stack size 32 bytes, lv_font.o(.text.lv_font_get_glyph_dsc))

[Stack]

- Max Depth = 32
- Call Chain = lv_font_get_glyph_dsc

[Called By]

- >> lv_draw_sw_letter
- >> lv_font_get_glyph_width
- >> lv_textarea_get_password_bullet

lv_font_get_glyph_dsc_fmt_txt (Thumb, 304 bytes, Stack size 40 bytes, lv_font_fmt_txt.o(.text.lv_font_get_glyph_dsc_fmt_txt))

[Stack]

- Max Depth = 112
- Call Chain = lv_font_get_glyph_dsc_fmt_txt ⇒ get_glyph_dsc_id ⇒ _lv_utils_bsearch

[Calls]

- >> get_glyph_dsc_id
- >> _lv_utils_bsearch

[Address Reference Count : 1]

- lv_font_montserrat_14.o(.rodata.lv_font_montserrat_14)

lv_font_get_glyph_width (Thumb, 24 bytes, Stack size 24 bytes, lv_font.o(.text.lv_font_get_glyph_width))

[Stack]

- Max Depth = 56
- Call Chain = lv_font_get_glyph_width ⇒ lv_font_get_glyph_dsc

[Calls]

- >> lv_font_get_glyph_dsc

[Called By]

- >> lv_draw_label
- >> lv_txt_get_width
- >> _lv_txt_get_next_line
- >> lv_label_is_char_under_pos
- >> lv_label_get_letter_on
- >> lv_label_refr_text
- >> lv_label_event
- >> refr_cursor_area

lv_fs_close (Thumb, 64 bytes, Stack size 16 bytes, lv_fs.o(.text.lv_fs_close))

[Stack]

- Max Depth = 88
- Call Chain = lv_fs_close ⇒ lv_mem_free ⇒ lv_tlsf_free ⇒ block_merge_next ⇒ block_remove ⇒ remove_free_block

[Calls]

- >> lv_mem_free

[Called By]

- >> lv_img_decoder_built_in_info
- >> lv_img_decoder_built_in_close

lv_fs_get_drv (Thumb, 40 bytes, Stack size 16 bytes, lv_fs.o(.text.lv_fs_get_drv))

[Stack]

- Max Depth = 16
- Call Chain = lv_fs_get_drv

[Calls]

- >> _lv_ll_get_next
- >> _lv_ll_get_head

[Called By]

- >> lv_fs_open

lv_fs_get_ext (Thumb, 44 bytes, Stack size 8 bytes, lv_fs.o(.text.lv_fs_get_ext))

[Stack]

- Max Depth = 16
- Call Chain = lv_fs_get_ext ⇒ strlen

[Calls]

- >> strlen

[Called By]

- >> lv_img_decoder_built_in_open
- >> lv_img_decoder_built_in_info

lv_fs_open (Thumb, 122 bytes, Stack size 24 bytes, lv_fs.o(.text.lv_fs_open))

[Stack]

- Max Depth = 96
- Call Chain = lv_fs_open ⇒ lv_mem_alloc ⇒ lv_tlsf_malloc ⇒ block_prepare_used ⇒ block_split ⇒ block_mark_as_free ⇒ block_link_next

[Calls]

- >> lv_memset_00
- >> lv_mem_alloc
- >> lv_fs_get_drv

[Called By]

- >> lv_img_decoder_built_in_open
- >> lv_img_decoder_built_in_info

lv_fs_read (Thumb, 340 bytes, Stack size 56 bytes, lv_fs.o(.text.lv_fs_read))

[Stack]

- Max Depth = 128
- Call Chain = lv_fs_read ⇒ lv_mem_alloc ⇒ lv_tlsf_malloc ⇒ block_prepare_used ⇒ block_split ⇒ block_mark_as_free ⇒ block_link_next

[Calls]

- >> lv_memcpy
- >> lv_mem_alloc

[Called By]

- >> lv_img_decoder_built_in_read_line
- >> lv_img_decoder_built_in_open
- >> lv_img_decoder_built_in_info

lv_fs_seek (Thumb, 134 bytes, Stack size 24 bytes, lv_fs.o(.text.lv_fs_seek))

[Stack]

- Max Depth = 24
- Call Chain = lv_fs_seek

[Called By]

- >> lv_img_decoder_built_in_read_line
- >> lv_img_decoder_built_in_open

lv_gradient_calculate (Thumb, 206 bytes, Stack size 24 bytes, lv_draw_sw_gradient.o(.text.lv_gradient_calculate))

[Stack]

- Max Depth = 40
- Call Chain = lv_gradient_calculate ⇒ lv_color_to32

[Calls]

- >> lv_color_to32

[Called By]

- >> lv_gradient_get

lv_gradient_cleanup (Thumb, 14 bytes, Stack size 0 bytes, lv_draw_sw_gradient.o(.text.lv_gradient_cleanup))

[Stack]

- Max Depth = 72
- Call Chain = lv_gradient_cleanup ⇒ lv_mem_free ⇒ lv_tlsf_free ⇒ block_merge_next ⇒ block_remove ⇒ remove_free_block

[Calls]

- >> lv_mem_free

[Called By]

- >> draw_bg

lv_gradient_get (Thumb, 348 bytes, Stack size 56 bytes, lv_draw_sw_gradient.o(.text.lv_gradient_get))

[Stack]

- Max Depth = 144
- Call Chain = lv_gradient_get ⇒ lv_gradient_set_cache_size ⇒ lv_mem_free ⇒ lv_tlsf_free ⇒ block_merge_next ⇒ block_remove ⇒ remove_free_block

[Calls]

- >> lv_mem_alloc
- >> lv_gradient_set_cache_size
- >> lv_gradient_calculate
- >> iterate_cache

[Called By]

- >> draw_bg

lv_gradient_set_cache_size (Thumb, 48 bytes, Stack size 16 bytes, lv_draw_sw_gradient.o(.text.lv_gradient_set_cache_size))

[Stack]

- Max Depth = 88
- Call Chain = lv_gradient_set_cache_size ⇒ lv_mem_free ⇒ lv_tlsf_free ⇒ block_merge_next ⇒ block_remove ⇒ remove_free_block

[Calls]

- >> lv_mem_free
- >> lv_memset_00
- >> lv_mem_alloc

[Called By]

- >> lv_gradient_get

lv_grid_init (Thumb, 92 bytes, Stack size 16 bytes, lv_grid.o(.text.lv_grid_init))

[Stack]

- Max Depth = 152
- Call Chain = lv_grid_init ⇒ lv_layout_register ⇒ lv_mem_realloc ⇒ lv_tlsf_realloc ⇒ lv_tlsf_free ⇒ block_merge_next ⇒ block_remove ⇒ remove_free_block

[Calls]

- >> lv_layout_register

[Called By]

- >> lv_extra_init

lv_group_add_obj (Thumb, 114 bytes, Stack size 16 bytes, lv_group.o(.text.lv_group_add_obj))

[Stack]

- Max Depth = 256
- Call Chain = lv_group_add_obj ⇒ lv_group_remove_obj ⇒ lv_group_refocus ⇒ lv_group_focus_prev ⇒ focus_next_core ⇒ lv_obj_invalidate ⇒ lv_obj_invalidate_area ⇒ _lv_inv_area ⇒ _lv_area_is_in ⇒ _lv_area_is_point_on ⇒ _lv_area_is_point_on (Cycle)

[Calls]

- >> lv_obj_allocate_spec_attr
- >> lv_obj_get_group
- >> lv_group_remove_obj
- >> _lv_ll_ins_tail
- >> _lv_ll_get_next
- >> _lv_ll_get_head
- >> lv_group_refocus

[Called By]

- >> lv_obj_class_init_obj
- >> lv_tabview_constructor

lv_group_focus_next (Thumb, 40 bytes, Stack size 8 bytes, lv_group.o(.text.lv_group_focus_next))

[Stack]

- Max Depth = 208
- Call Chain = lv_group_focus_next ⇒ focus_next_core ⇒ lv_obj_invalidate ⇒ lv_obj_invalidate_area ⇒ _lv_inv_area ⇒ _lv_area_is_in ⇒ _lv_area_is_point_on ⇒ _lv_area_is_point_on (Cycle)

[Calls]

- >> focus_next_core

[Called By]

- >> lv_obj_add_flag
- >> lv_indev_read_timer_cb
- >> lv_group_refocus

lv_group_focus_obj (Thumb, 144 bytes, Stack size 24 bytes, lv_group.o(.text.lv_group_focus_obj))

[Stack]

- Max Depth = 192
- Call Chain = lv_group_focus_obj ⇒ lv_group_set_editing ⇒ lv_obj_invalidate ⇒ lv_obj_invalidate_area ⇒ _lv_inv_area ⇒ _lv_area_is_in ⇒ _lv_area_is_point_on ⇒ _lv_area_is_point_on (Cycle)

[Calls]

- >> lv_obj_invalidate
- >> lv_event_send
- >> lv_obj_get_group
- >> lv_group_set_editing
- >> _lv_ll_get_next
- >> _lv_ll_get_head
- >> get_indev

[Called By]

- >> indev_proc_press

lv_group_focus_prev (Thumb, 40 bytes, Stack size 8 bytes, lv_group.o(.text.lv_group_focus_prev))

[Stack]

- Max Depth = 208
- Call Chain = lv_group_focus_prev ⇒ focus_next_core ⇒ lv_obj_invalidate ⇒ lv_obj_invalidate_area ⇒ _lv_inv_area ⇒ _lv_area_is_in ⇒ _lv_area_is_point_on ⇒ _lv_area_is_point_on (Cycle)

[Calls]

- >> focus_next_core

[Called By]

- >> lv_indev_read_timer_cb
- >> lv_group_refocus

lv_group_get_default (Thumb, 12 bytes, Stack size 0 bytes, lv_group.o(.text.lv_group_get_default))

[Called By]

- >> lv_obj_class_init_obj
- >> lv_tabview_constructor

lv_group_get_editing (Thumb, 14 bytes, Stack size 0 bytes, lv_group.o(.text.lv_group_get_editing))

[Called By]

- >> lv_indev_read_timer_cb
- >> lv_obj_event
- >> lv_spinbox_event
- >> lv_arc_event
- >> lv_btnmatrix_event
- >> lv_dropdown_list_event
- >> lv_dropdown_event
- >> lv_roller_event
- >> lv_slider_event

lv_group_get_focused (Thumb, 14 bytes, Stack size 0 bytes, lv_group.o(.text.lv_group_get_focused))

[Called By]

- >> lv_obj_add_flag
- >> lv_indev_read_timer_cb

lv_group_get_obj_count (Thumb, 4 bytes, Stack size 0 bytes, lv_group.o(.text.lv_group_get_obj_count))

[Calls]

- >> _lv_ll_get_len

[Called By]

- >> lv_indev_read_timer_cb

lv_group_remove_obj (Thumb, 148 bytes, Stack size 16 bytes, lv_group.o(.text.lv_group_remove_obj))

[Stack]

- Max Depth = 240
- Call Chain = lv_group_remove_obj ⇒ lv_group_refocus ⇒ lv_group_focus_prev ⇒ focus_next_core ⇒ lv_obj_invalidate ⇒ lv_obj_invalidate_area ⇒ _lv_inv_area ⇒ _lv_area_is_in ⇒ _lv_area_is_point_on ⇒ _lv_area_is_point_on (Cycle)

[Calls]

- >> lv_event_send
- >> lv_obj_get_group
- >> lv_mem_free
- >> _lv_ll_remove
- >> _lv_ll_get_tail
- >> _lv_ll_get_next
- >> _lv_ll_get_head
- >> lv_group_refocus
- >> get_indev

[Called By]

- >> lv_group_add_obj
- >> lv_obj_destructor

lv_group_send_data (Thumb, 40 bytes, Stack size 16 bytes, lv_group.o(.text.lv_group_send_data))

[Stack]

- Max Depth = 96
- Call Chain = lv_group_send_data ⇒ lv_event_send ⇒ event_send_core ⇒ event_send_core (Cycle)

[Calls]

- >> lv_event_send
- >> lv_obj_has_state

[Called By]

- >> lv_indev_read_timer_cb

lv_group_set_editing (Thumb, 68 bytes, Stack size 8 bytes, lv_group.o(.text.lv_group_set_editing))

[Stack]

- Max Depth = 168
- Call Chain = lv_group_set_editing ⇒ lv_obj_invalidate ⇒ lv_obj_invalidate_area ⇒ _lv_inv_area ⇒ _lv_area_is_in ⇒ _lv_area_is_point_on ⇒ _lv_area_is_point_on (Cycle)

[Calls]

- >> lv_obj_invalidate
- >> lv_event_send
- >> get_indev

[Called By]

- >> lv_indev_read_timer_cb
- >> lv_group_focus_obj
- >> lv_arc_event
- >> lv_dropdown_list_event
- >> btn_release_handler
- >> lv_roller_event
- >> lv_slider_event

lv_img_cache_invalidate_src (Thumb, 2 bytes, Stack size 0 bytes, lv_img_cache.o(.text.lv_img_cache_invalidate_src))

[Called By]

- >> lv_draw_sw_layer_blend

lv_img_cf_get_px_size (Thumb, 50 bytes, Stack size 0 bytes, lv_draw_img.o(.text.lv_img_cf_get_px_size))

[Called By]

- >> lv_img_decoder_built_in_read_line
- >> lv_img_decoder_built_in_open

lv_img_create (Thumb, 24 bytes, Stack size 8 bytes, lv_img.o(.text.lv_img_create))

[Stack]

- Max Depth = 304
- Call Chain = lv_img_create ⇒ lv_obj_class_init_obj ⇒ lv_theme_apply ⇒ lv_obj_remove_style ⇒ lv_obj_refresh_style ⇒ lv_obj_refresh_ext_draw_size ⇒ lv_obj_invalidate ⇒ lv_obj_invalidate_area ⇒ _lv_inv_area ⇒ _lv_area_is_in ⇒ _lv_area_is_point_on ⇒ _lv_area_is_point_on (Cycle)

[Calls]

- >> lv_obj_class_init_obj
- >> lv_obj_class_create_obj

[Called By]

- >> lv_menu_constructor

lv_img_decoder_built_in_close (Thumb, 48 bytes, Stack size 16 bytes, lv_img_decoder.o(.text.lv_img_decoder_built_in_close))

[Stack]

- Max Depth = 104
- Call Chain = lv_img_decoder_built_in_close ⇒ lv_fs_close ⇒ lv_mem_free ⇒ lv_tlsf_free ⇒ block_merge_next ⇒ block_remove ⇒ remove_free_block

[Calls]

- >> lv_mem_free
- >> lv_fs_close

[Called By]

- >> lv_img_decoder_built_in_open

[Address Reference Count : 1]

- lv_img_decoder.o(.text._lv_img_decoder_init)

lv_img_decoder_built_in_info (Thumb, 164 bytes, Stack size 32 bytes, lv_img_decoder.o(.text.lv_img_decoder_built_in_info))

[Stack]

- Max Depth = 160
- Call Chain = lv_img_decoder_built_in_info ⇒ lv_fs_read ⇒ lv_mem_alloc ⇒ lv_tlsf_malloc ⇒ block_prepare_used ⇒ block_split ⇒ block_mark_as_free ⇒ block_link_next

[Calls]

- >> lv_img_src_get_type
- >> lv_fs_read
- >> lv_fs_open
- >> lv_fs_get_ext
- >> lv_fs_close
- >> strcmp

[Address Reference Count : 1]

- lv_img_decoder.o(.text._lv_img_decoder_init)

lv_img_decoder_built_in_open (Thumb, 428 bytes, Stack size 40 bytes, lv_img_decoder.o(.text.lv_img_decoder_built_in_open))

[Stack]

- Max Depth = 168
- Call Chain = lv_img_decoder_built_in_open ⇒ lv_fs_read ⇒ lv_mem_alloc ⇒ lv_tlsf_malloc ⇒ block_prepare_used ⇒ block_split ⇒ block_mark_as_free ⇒ block_link_next

[Calls]

- >> lv_mem_free
- >> lv_memset_00
- >> lv_mem_alloc
- >> lv_img_cf_get_px_size
- >> lv_img_decoder_built_in_close
- >> lv_fs_seek
- >> lv_fs_read
- >> lv_fs_open
- >> lv_fs_get_ext
- >> lv_color_make
- >> strcmp

[Address Reference Count : 1]

- lv_img_decoder.o(.text._lv_img_decoder_init)

lv_img_decoder_built_in_read_line (Thumb, 824 bytes, Stack size 72 bytes, lv_img_decoder.o(.text.lv_img_decoder_built_in_read_line))

[Stack]

- Max Depth = 200
- Call Chain = lv_img_decoder_built_in_read_line ⇒ lv_mem_buf_get ⇒ lv_mem_realloc ⇒ lv_tlsf_realloc ⇒ lv_tlsf_free ⇒ block_merge_next ⇒ block_remove ⇒ remove_free_block

[Calls]

- >> lv_mem_buf_release
- >> lv_mem_buf_get
- >> lv_img_cf_get_px_size
- >> lv_fs_seek
- >> lv_fs_read

[Address Reference Count : 1]

- lv_img_decoder.o(.text._lv_img_decoder_init)

lv_img_decoder_close (Thumb, 34 bytes, Stack size 8 bytes, lv_img_decoder.o(.text.lv_img_decoder_close))

[Stack]

- Max Depth = 80
- Call Chain = lv_img_decoder_close ⇒ lv_mem_free ⇒ lv_tlsf_free ⇒ block_merge_next ⇒ block_remove ⇒ remove_free_block

[Calls]

- >> lv_mem_free

[Called By]

- >> lv_draw_img

lv_img_decoder_create (Thumb, 24 bytes, Stack size 8 bytes, lv_img_decoder.o(.text.lv_img_decoder_create))

[Stack]

- Max Depth = 88
- Call Chain = lv_img_decoder_create ⇒ _lv_ll_ins_head ⇒ lv_mem_alloc ⇒ lv_tlsf_malloc ⇒ block_prepare_used ⇒ block_split ⇒ block_mark_as_free ⇒ block_link_next

[Calls]

- >> _lv_ll_ins_head
- >> lv_memset_00

[Called By]

- >> _lv_img_decoder_init

lv_img_decoder_get_info (Thumb, 88 bytes, Stack size 24 bytes, lv_img_decoder.o(.text.lv_img_decoder_get_info))

[Stack]

- Max Depth = 44
- Call Chain = lv_img_decoder_get_info ⇒ lv_memset_00 ⇒ __aeabi_memclr4

[Calls]

- >> _lv_ll_get_next
- >> _lv_ll_get_head
- >> lv_img_src_get_type
- >> lv_memset_00

[Called By]

- >> refr_area_part
- >> draw_bg_img
- >> lv_img_set_src
- >> lv_meter_event
- >> lv_dropdown_event

lv_img_decoder_open (Thumb, 216 bytes, Stack size 40 bytes, lv_img_decoder.o(.text.lv_img_decoder_open))

[Stack]

- Max Depth = 112
- Call Chain = lv_img_decoder_open ⇒ lv_mem_free ⇒ lv_tlsf_free ⇒ block_merge_next ⇒ block_remove ⇒ remove_free_block

[Calls]

- >> lv_mem_free
- >> _lv_ll_get_next
- >> _lv_ll_get_head
- >> lv_img_src_get_type
- >> lv_memset_00
- >> lv_mem_alloc
- >> strlen
- >> strcpy

[Called By]

- >> _lv_img_cache_open

lv_img_decoder_read_line (Thumb, 30 bytes, Stack size 24 bytes, lv_img_decoder.o(.text.lv_img_decoder_read_line))

[Stack]

- Max Depth = 24
- Call Chain = lv_img_decoder_read_line

[Called By]

- >> lv_draw_img

lv_img_set_src (Thumb, 320 bytes, Stack size 56 bytes, lv_img.o(.text.lv_img_set_src))

[Stack]

- Max Depth = 272
- Call Chain = lv_img_set_src ⇒ lv_txt_get_size ⇒ _lv_txt_get_next_line ⇒ lv_font_get_glyph_width ⇒ lv_font_get_glyph_dsc

[Calls]

- >> lv_obj_invalidate
- >> lv_mem_free
- >> lv_img_src_get_type
- >> lv_obj_refresh_self_size
- >> lv_obj_refresh_ext_draw_size
- >> lv_mem_alloc
- >> lv_img_decoder_get_info
- >> lv_txt_get_size
- >> strlen
- >> strcpy

[Called By]

- >> lv_menu_constructor
- >> lv_img_event

lv_img_src_get_type (Thumb, 34 bytes, Stack size 0 bytes, lv_draw_img.o(.text.lv_img_src_get_type))

[Called By]

- >> lv_obj_init_draw_rect_dsc
- >> lv_img_decoder_get_info
- >> draw_bg_img
- >> lv_img_decoder_built_in_info
- >> lv_img_decoder_open
- >> lv_img_set_src
- >> lv_dropdown_event

lv_indev_drv_init (Thumb, 36 bytes, Stack size 8 bytes, lv_hal_indev.o(.text.lv_indev_drv_init))

[Stack]

- Max Depth = 28
- Call Chain = lv_indev_drv_init ⇒ lv_memset_00 ⇒ __aeabi_memclr4

[Calls]

- >> lv_memset_00

[Called By]

- >> lv_port_indev_init

lv_indev_drv_register (Thumb, 72 bytes, Stack size 16 bytes, lv_hal_indev.o(.text.lv_indev_drv_register))

[Stack]

- Max Depth = 120
- Call Chain = lv_indev_drv_register ⇒ lv_timer_create ⇒ _lv_ll_ins_head ⇒ lv_mem_alloc ⇒ lv_tlsf_malloc ⇒ block_prepare_used ⇒ block_split ⇒ block_mark_as_free ⇒ block_link_next

[Calls]

- >> lv_disp_get_default
- >> _lv_ll_ins_head
- >> lv_memset_00
- >> lv_timer_create

[Called By]

- >> lv_port_indev_init

lv_indev_get_act (Thumb, 8 bytes, Stack size 0 bytes, lv_indev.o(.text.lv_indev_get_act))

[Called By]

- >> event_send_core
- >> _lv_indev_scroll_throw_handler
- >> _lv_indev_scroll_handler
- >> lv_obj_event
- >> lv_chart_event
- >> lv_colorwheel_event
- >> lv_spinbox_event
- >> cont_scroll_end_event_cb
- >> tileview_event_cb
- >> lv_arc_event
- >> lv_btnmatrix_event
- >> lv_dropdown_list_event
- >> lv_dropdown_event
- >> btn_release_handler
- >> lv_roller_event
- >> lv_slider_event
- >> lv_textarea_event
- >> lv_table_event

lv_indev_get_next (Thumb, 20 bytes, Stack size 0 bytes, lv_hal_indev.o(.text.lv_indev_get_next))

[Calls]

- >> _lv_ll_get_next
- >> _lv_ll_get_head

[Called By]

- >> lv_indev_reset
- >> get_indev
- >> lv_obj_get_scrollbar_area
- >> obj_del_core
- >> lv_btnmatrix_event

lv_indev_get_obj_act (Thumb, 12 bytes, Stack size 0 bytes, lv_indev.o(.text.lv_indev_get_obj_act))

[Called By]

- >> elastic_diff
- >> obj_del_core
- >> lv_dropdown_event

lv_indev_get_point (Thumb, 42 bytes, Stack size 0 bytes, lv_indev.o(.text.lv_indev_get_point))

[Called By]

- >> lv_chart_event
- >> lv_colorwheel_event
- >> lv_arc_event
- >> lv_btnmatrix_event
- >> lv_dropdown_list_event
- >> lv_roller_event
- >> lv_slider_event
- >> lv_textarea_event
- >> lv_table_event

lv_indev_get_scroll_dir (Thumb, 28 bytes, Stack size 0 bytes, lv_indev.o(.text.lv_indev_get_scroll_dir))

[Called By]

- >> lv_obj_get_scrollbar_area

lv_indev_get_scroll_obj (Thumb, 22 bytes, Stack size 0 bytes, lv_indev.o(.text.lv_indev_get_scroll_obj))

[Called By]

- >> lv_obj_get_scrollbar_area
- >> lv_obj_event
- >> lv_dropdown_list_event
- >> btn_release_handler
- >> lv_table_event

lv_indev_get_type (Thumb, 12 bytes, Stack size 0 bytes, lv_indev.o(.text.lv_indev_get_type))

[Called By]

- >> get_indev
- >> lv_obj_event
- >> lv_colorwheel_event
- >> lv_spinbox_event
- >> lv_arc_event
- >> lv_btnmatrix_event
- >> lv_dropdown_list_event
- >> lv_dropdown_event
- >> btn_release_handler
- >> lv_roller_event
- >> lv_slider_event
- >> lv_textarea_event
- >> lv_table_event

lv_indev_get_vect (Thumb, 28 bytes, Stack size 0 bytes, lv_indev.o(.text.lv_indev_get_vect))

[Called By]

- >> lv_roller_event
- >> lv_textarea_event

lv_indev_read_timer_cb (Thumb, 1852 bytes, Stack size 56 bytes, lv_indev.o(.text.lv_indev_read_timer_cb))

[Stack]

- Max Depth = 408
- Call Chain = lv_indev_read_timer_cb ⇒ indev_proc_release ⇒ _lv_indev_scroll_throw_handler ⇒ lv_obj_scroll_by ⇒ _lv_obj_scroll_by_raw ⇒ lv_obj_invalidate ⇒ lv_obj_invalidate_area ⇒ _lv_inv_area ⇒ _lv_area_is_in ⇒ _lv_area_is_point_on ⇒ _lv_area_is_point_on (Cycle)

[Calls]

- >> lv_tick_get
- >> lv_tick_elaps
- >> lv_obj_set_pos
- >> lv_event_send
- >> lv_disp_get_ver_res
- >> lv_disp_get_hor_res
- >> lv_obj_has_flag
- >> lv_obj_is_editable
- >> lv_obj_clear_state
- >> _lv_indev_read
- >> indev_reset_check
- >> indev_proc_reset_query_handler
- >> indev_proc_release
- >> indev_proc_press
- >> lv_obj_has_state
- >> lv_group_set_editing
- >> lv_group_send_data
- >> lv_group_get_obj_count
- >> lv_group_get_focused
- >> lv_group_get_editing
- >> lv_group_focus_prev
- >> lv_group_focus_next

[Address Reference Count : 1]

- lv_hal_indev.o(.text.lv_indev_drv_register)

lv_indev_reset (Thumb, 152 bytes, Stack size 16 bytes, lv_indev.o(.text.lv_indev_reset))

[Stack]

- Max Depth = 16
- Call Chain = lv_indev_reset

[Calls]

- >> lv_indev_get_next

[Called By]

- >> obj_del_core

lv_indev_reset_long_press (Thumb, 26 bytes, Stack size 8 bytes, lv_indev.o(.text.lv_indev_reset_long_press))

[Stack]

- Max Depth = 8
- Call Chain = lv_indev_reset_long_press

[Calls]

- >> lv_tick_get

[Called By]

- >> lv_btnmatrix_event

lv_indev_scroll_throw_predict (Thumb, 64 bytes, Stack size 8 bytes, lv_indev_scroll.o(.text.lv_indev_scroll_throw_predict))

[Stack]

- Max Depth = 8
- Call Chain = lv_indev_scroll_throw_predict

[Called By]

- >> lv_roller_event

lv_indev_search_obj (Thumb, 120 bytes, Stack size 24 bytes, lv_indev.o(.text.lv_indev_search_obj))

[Stack]

- Max Depth = 168 + In Cycle
- Call Chain = lv_indev_search_obj ⇒ lv_indev_search_obj (Cycle)

[Calls]

- >> lv_obj_get_child_cnt
- >> lv_obj_has_flag
- >> lv_obj_transform_point
- >> lv_obj_hit_test
- >> lv_indev_search_obj
- >> _lv_area_is_point_on

[Called By]

- >> lv_indev_search_obj
- >> indev_proc_press

lv_indev_wait_release (Thumb, 12 bytes, Stack size 0 bytes, lv_indev.o(.text.lv_indev_wait_release))

[Called By]

- >> lv_colorwheel_event

lv_init (Thumb, 84 bytes, Stack size 8 bytes, lv_obj.o(.text.lv_init))

[Stack]

- Max Depth = 168
- Call Chain = lv_init ⇒ lv_extra_init ⇒ lv_grid_init ⇒ lv_layout_register ⇒ lv_mem_realloc ⇒ lv_tlsf_realloc ⇒ lv_tlsf_free ⇒ block_merge_next ⇒ block_remove ⇒ remove_free_block

[Calls]

- >> _lv_ll_init
- >> _lv_group_init
- >> lv_mem_init
- >> lv_extra_init
- >> lv_draw_init
- >> _lv_timer_core_init
- >> _lv_refr_init
- >> _lv_obj_style_init
- >> _lv_img_decoder_init
- >> _lv_fs_init
- >> _lv_anim_core_init

[Called By]

- >> main

lv_keyboard_def_event_cb (Thumb, 512 bytes, Stack size 16 bytes, lv_keyboard.o(.text.lv_keyboard_def_event_cb))

[Stack]

- Max Depth = 664
- Call Chain = lv_keyboard_def_event_cb ⇒ lv_textarea_del_char ⇒ insert_handler ⇒ lv_textarea_add_text ⇒ insert_handler (Cycle)

[Calls]

- >> lv_event_get_target
- >> lv_event_send
- >> lv_btnmatrix_set_map
- >> lv_btnmatrix_get_selected_btn
- >> lv_btnmatrix_get_btn_text
- >> lv_textarea_set_cursor_pos
- >> lv_textarea_get_text
- >> lv_textarea_get_one_line
- >> lv_textarea_get_cursor_pos
- >> lv_textarea_del_char
- >> lv_textarea_cursor_right
- >> lv_textarea_cursor_left
- >> lv_textarea_add_text
- >> lv_textarea_add_char
- >> lv_keyboard_update_ctrl_map
- >> strcmp

[Address Reference Count : 1]

- lv_keyboard.o(.text.lv_keyboard_constructor)

lv_label_create (Thumb, 20 bytes, Stack size 8 bytes, lv_label.o(.text.lv_label_create))

[Stack]

- Max Depth = 304
- Call Chain = lv_label_create ⇒ lv_obj_class_init_obj ⇒ lv_theme_apply ⇒ lv_obj_remove_style ⇒ lv_obj_refresh_style ⇒ lv_obj_refresh_ext_draw_size ⇒ lv_obj_invalidate ⇒ lv_obj_invalidate_area ⇒ _lv_inv_area ⇒ _lv_area_is_in ⇒ _lv_area_is_point_on ⇒ _lv_area_is_point_on (Cycle)

[Calls]

- >> lv_obj_class_init_obj
- >> lv_obj_class_create_obj

[Called By]

- >> _lv_disp_refr_timer
- >> my_constructor
- >> lv_menu_constructor
- >> lv_dropdownlist_constructor
- >> lv_textarea_constructor

lv_label_get_letter_on (Thumb, 512 bytes, Stack size 96 bytes, lv_label.o(.text.lv_label_get_letter_on))

[Stack]

- Max Depth = 256
- Call Chain = lv_label_get_letter_on ⇒ _lv_txt_get_next_line ⇒ lv_font_get_glyph_width ⇒ lv_font_get_glyph_dsc

[Calls]

- >> lv_obj_get_style_prop
- >> lv_obj_get_content_coords
- >> lv_obj_calculate_style_text_align
- >> lv_txt_get_width
- >> lv_font_get_glyph_width
- >> _lv_txt_get_next_line
- >> _lv_txt_encoded_letter_next_2
- >> _lv_txt_is_cmd
- >> lv_obj_get_style_width
- >> lv_obj_get_style_text_line_space
- >> lv_obj_get_style_text_letter_space
- >> lv_obj_get_style_text_font

[Called By]

- >> lv_label_refr_text
- >> lv_roller_event
- >> lv_textarea_event
- >> lv_textarea_cursor_up
- >> lv_textarea_cursor_down

lv_label_get_letter_pos (Thumb, 440 bytes, Stack size 80 bytes, lv_label.o(.text.lv_label_get_letter_pos))

[Stack]

- Max Depth = 240
- Call Chain = lv_label_get_letter_pos ⇒ _lv_txt_get_next_line ⇒ lv_font_get_glyph_width ⇒ lv_font_get_glyph_dsc

[Calls]

- >> lv_obj_get_content_width
- >> lv_obj_get_content_coords
- >> lv_obj_calculate_style_text_align
- >> lv_txt_get_width
- >> _lv_txt_get_next_line
- >> lv_obj_get_style_width
- >> lv_obj_get_style_text_line_space
- >> lv_obj_get_style_text_letter_space
- >> lv_obj_get_style_text_font

[Called By]

- >> lv_textarea_set_cursor_pos
- >> refr_cursor_area
- >> lv_textarea_cursor_up
- >> lv_textarea_cursor_down

lv_label_get_recolor (Thumb, 10 bytes, Stack size 0 bytes, lv_label.o(.text.lv_label_get_recolor))

[Called By]

- >> lv_roller_label_event
- >> lv_roller_event

lv_label_get_text (Thumb, 4 bytes, Stack size 0 bytes, lv_label.o(.text.lv_label_get_text))

[Called By]

- >> lv_textarea_set_cursor_pos
- >> lv_textarea_get_text
- >> lv_textarea_del_char
- >> lv_textarea_add_text
- >> lv_textarea_add_char
- >> lv_textarea_set_text
- >> draw_box_label
- >> refr_position
- >> lv_roller_label_event
- >> lv_roller_event
- >> get_selected_label_width
- >> refr_cursor_area
- >> pwd_char_hider
- >> lv_textarea_event

lv_label_get_text_selection_end (Thumb, 4 bytes, Stack size 0 bytes, lv_label.o(.text.lv_label_get_text_selection_end))

[Called By]

- >> lv_textarea_clear_selection

lv_label_get_text_selection_start (Thumb, 4 bytes, Stack size 0 bytes, lv_label.o(.text.lv_label_get_text_selection_start))

[Called By]

- >> lv_textarea_clear_selection

lv_label_ins_text (Thumb, 108 bytes, Stack size 24 bytes, lv_label.o(.text.lv_label_ins_text))

[Stack]

- Max Depth = 440
- Call Chain = lv_label_ins_text ⇒ lv_label_set_text ⇒ lv_label_refr_text ⇒ lv_label_get_letter_on ⇒ _lv_txt_get_next_line ⇒ lv_font_get_glyph_width ⇒ lv_font_get_glyph_dsc

[Calls]

- >> lv_obj_invalidate
- >> lv_mem_realloc
- >> lv_label_set_text
- >> _lv_txt_ins
- >> strlen

[Called By]

- >> lv_textarea_add_text
- >> lv_textarea_add_char

lv_label_is_char_under_pos (Thumb, 468 bytes, Stack size 88 bytes, lv_label.o(.text.lv_label_is_char_under_pos))

[Stack]

- Max Depth = 248
- Call Chain = lv_label_is_char_under_pos ⇒ _lv_txt_get_next_line ⇒ lv_font_get_glyph_width ⇒ lv_font_get_glyph_dsc

[Calls]

- >> lv_obj_get_content_coords
- >> lv_obj_calculate_style_text_align
- >> lv_txt_get_width
- >> lv_font_get_glyph_width
- >> _lv_txt_get_next_line
- >> _lv_txt_encoded_letter_next_2
- >> _lv_txt_is_cmd
- >> lv_obj_get_style_width
- >> lv_obj_get_style_text_line_space
- >> lv_obj_get_style_text_letter_space
- >> lv_obj_get_style_text_font

[Called By]

- >> lv_textarea_event

lv_label_set_long_mode (Thumb, 104 bytes, Stack size 16 bytes, lv_label.o(.text.lv_label_set_long_mode))

[Stack]

- Max Depth = 408
- Call Chain = lv_label_set_long_mode ⇒ lv_label_refr_text ⇒ lv_label_get_letter_on ⇒ _lv_txt_get_next_line ⇒ lv_font_get_glyph_width ⇒ lv_font_get_glyph_dsc

[Calls]

- >> lv_anim_del
- >> lv_label_revert_dots
- >> lv_label_refr_text

[Called By]

- >> my_constructor
- >> lv_label_constructor

lv_label_set_text (Thumb, 116 bytes, Stack size 24 bytes, lv_label.o(.text.lv_label_set_text))

[Stack]

- Max Depth = 416
- Call Chain = lv_label_set_text ⇒ lv_label_refr_text ⇒ lv_label_get_letter_on ⇒ _lv_txt_get_next_line ⇒ lv_font_get_glyph_width ⇒ lv_font_get_glyph_dsc

[Calls]

- >> lv_obj_invalidate
- >> lv_mem_realloc
- >> lv_mem_free
- >> lv_mem_alloc
- >> lv_label_refr_text
- >> strlen
- >> strcpy

[Called By]

- >> lv_roller_set_options
- >> _lv_disp_refr_timer
- >> lv_textarea_del_char
- >> lv_menu_value_changed_event_cb
- >> lv_textarea_set_text
- >> lv_label_ins_text
- >> lv_label_constructor
- >> pwd_char_hider
- >> lv_textarea_constructor
- >> label_event_cb

lv_label_set_text_fmt (Thumb, 78 bytes, Stack size 32 bytes, lv_label.o(.text.lv_label_set_text_fmt))

[Stack]

- Max Depth = 424
- Call Chain = lv_label_set_text_fmt ⇒ lv_label_refr_text ⇒ lv_label_get_letter_on ⇒ _lv_txt_get_next_line ⇒ lv_font_get_glyph_width ⇒ lv_font_get_glyph_dsc

[Calls]

- >> lv_obj_invalidate
- >> lv_mem_free
- >> _lv_txt_set_text_vfmt
- >> lv_label_refr_text

[Called By]

- >> _lv_disp_refr_timer
- >> value_changed_event_cb
- >> month_event_cb

lv_label_set_text_sel_end (Thumb, 6 bytes, Stack size 0 bytes, lv_label.o(.text.lv_label_set_text_sel_end))

[Stack]

- Max Depth = 160
- Call Chain = lv_label_set_text_sel_end ⇒ lv_obj_invalidate ⇒ lv_obj_invalidate_area ⇒ _lv_inv_area ⇒ _lv_area_is_in ⇒ _lv_area_is_point_on ⇒ _lv_area_is_point_on (Cycle)

[Calls]

- >> lv_obj_invalidate

[Called By]

- >> lv_textarea_clear_selection

lv_label_set_text_sel_start (Thumb, 6 bytes, Stack size 0 bytes, lv_label.o(.text.lv_label_set_text_sel_start))

[Stack]

- Max Depth = 160
- Call Chain = lv_label_set_text_sel_start ⇒ lv_obj_invalidate ⇒ lv_obj_invalidate_area ⇒ _lv_inv_area ⇒ _lv_area_is_in ⇒ _lv_area_is_point_on ⇒ _lv_area_is_point_on (Cycle)

[Calls]

- >> lv_obj_invalidate

[Called By]

- >> lv_textarea_clear_selection

lv_label_set_text_static (Thumb, 52 bytes, Stack size 16 bytes, lv_label.o(.text.lv_label_set_text_static))

[Stack]

- Max Depth = 408
- Call Chain = lv_label_set_text_static ⇒ lv_label_refr_text ⇒ lv_label_get_letter_on ⇒ _lv_txt_get_next_line ⇒ lv_font_get_glyph_width ⇒ lv_font_get_glyph_dsc

[Calls]

- >> lv_mem_free
- >> lv_label_refr_text

[Called By]

- >> lv_dropdown_open

lv_layout_register (Thumb, 60 bytes, Stack size 24 bytes, lv_obj_pos.o(.text.lv_layout_register))

[Stack]

- Max Depth = 136
- Call Chain = lv_layout_register ⇒ lv_mem_realloc ⇒ lv_tlsf_realloc ⇒ lv_tlsf_free ⇒ block_merge_next ⇒ block_remove ⇒ remove_free_block

[Calls]

- >> lv_mem_realloc

[Called By]

- >> lv_grid_init
- >> lv_flex_init

lv_map (Thumb, 58 bytes, Stack size 8 bytes, lv_math.o(.text.lv_map))

[Stack]

- Max Depth = 8
- Call Chain = lv_map

[Called By]

- >> lv_anim_path_ease_out
- >> lv_anim_path_linear
- >> lv_chart_get_point_pos_by_id
- >> lv_chart_event
- >> draw_y_ticks
- >> draw_x_ticks
- >> lv_meter_event
- >> lv_anim_path_ease_in_out
- >> value_update
- >> lv_arc_event

lv_mem_alloc (Thumb, 44 bytes, Stack size 16 bytes, lv_mem.o(.text.lv_mem_alloc))

[Stack]

- Max Depth = 72
- Call Chain = lv_mem_alloc ⇒ lv_tlsf_malloc ⇒ block_prepare_used ⇒ block_split ⇒ block_mark_as_free ⇒ block_link_next

[Calls]

- >> lv_tlsf_malloc

[Called By]

- >> lv_disp_drv_register
- >> lv_obj_allocate_spec_attr
- >> lv_mem_realloc
- >> _lv_ll_ins_tail
- >> _lv_ll_ins_head
- >> lv_obj_class_create_obj
- >> lv_draw_mask_radius_init
- >> lv_style_remove_prop
- >> get_trans_style
- >> get_local_style
- >> lv_label_set_text
- >> lv_draw_layer_create
- >> _lv_ll_ins_prev
- >> lv_draw_sw_layer_create
- >> lv_gradient_set_cache_size
- >> lv_gradient_get
- >> lv_img_decoder_built_in_open
- >> lv_fs_read
- >> lv_fs_open
- >> lv_img_decoder_open
- >> lv_theme_default_init
- >> lv_img_set_src
- >> lv_btnmatrix_set_map
- >> lv_dropdown_set_options
- >> lv_keyboard_update_ctrl_map
- >> lv_tabview_constructor
- >> lv_style_set_prop_internal
- >> _lv_txt_set_text_vfmt
- >> lv_label_refr_text
- >> lv_table_constructor

lv_mem_buf_free_all (Thumb, 48 bytes, Stack size 16 bytes, lv_mem.o(.text.lv_mem_buf_free_all))

[Stack]

- Max Depth = 88
- Call Chain = lv_mem_buf_free_all ⇒ lv_mem_free ⇒ lv_tlsf_free ⇒ block_merge_next ⇒ block_remove ⇒ remove_free_block

[Calls]

- >> lv_mem_free

[Called By]

- >> _lv_disp_refr_timer

lv_mem_buf_get (Thumb, 164 bytes, Stack size 16 bytes, lv_mem.o(.text.lv_mem_buf_get))

[Stack]

- Max Depth = 128
- Call Chain = lv_mem_buf_get ⇒ lv_mem_realloc ⇒ lv_tlsf_realloc ⇒ lv_tlsf_free ⇒ block_merge_next ⇒ block_remove ⇒ remove_free_block

[Calls]

- >> lv_mem_realloc

[Called By]

- >> lv_roller_set_options
- >> mask_event_cb
- >> lv_draw_mask_radius_init
- >> lv_obj_set_state
- >> lv_obj_event
- >> lv_draw_img
- >> refr_area_part
- >> lv_draw_sw_rect
- >> lv_draw_sw_polygon
- >> lv_draw_sw_line
- >> lv_draw_sw_letter
- >> lv_draw_sw_img_decoded
- >> draw_border_generic
- >> shadow_blur_corner
- >> draw_bg
- >> lv_img_decoder_built_in_read_line
- >> grid_update
- >> find_track_end
- >> lv_dropdown_event
- >> pwd_char_hider

lv_mem_buf_release (Thumb, 36 bytes, Stack size 0 bytes, lv_mem.o(.text.lv_mem_buf_release))

[Called By]

- >> lv_roller_set_options
- >> mask_event_cb
- >> lv_draw_mask_radius_init
- >> lv_obj_set_state
- >> lv_obj_event
- >> lv_draw_img
- >> refr_area_part
- >> lv_draw_sw_rect
- >> lv_draw_sw_polygon
- >> lv_draw_sw_line
- >> lv_draw_sw_letter
- >> lv_draw_sw_img_decoded
- >> draw_border_generic
- >> shadow_blur_corner
- >> draw_bg
- >> lv_img_decoder_built_in_read_line
- >> flex_update
- >> find_track_end
- >> lv_dropdown_event
- >> pwd_char_hider

[Address Reference Count : 1]

- lv_grid.o(.text.grid_update)

lv_mem_free (Thumb, 36 bytes, Stack size 8 bytes, lv_mem.o(.text.lv_mem_free))

[Stack]

- Max Depth = 72
- Call Chain = lv_mem_free ⇒ lv_tlsf_free ⇒ block_merge_next ⇒ block_remove ⇒ remove_free_block

[Calls]

- >> lv_tlsf_free

[Called By]

- >> lv_draw_mask_free_param
- >> lv_anim_del
- >> lv_mem_realloc
- >> lv_obj_set_parent
- >> lv_group_remove_obj
- >> _lv_ll_clear
- >> lv_obj_remove_style
- >> lv_obj_class_create_obj
- >> lv_draw_mask_radius_init
- >> lv_obj_destructor
- >> lv_style_reset
- >> lv_style_remove_prop
- >> trans_del
- >> trans_anim_ready_cb
- >> obj_del_core
- >> lv_mem_buf_free_all
- >> lv_label_set_text_fmt
- >> lv_label_set_text
- >> lv_draw_layer_destroy
- >> lv_draw_layer_create
- >> _lv_draw_mask_cleanup
- >> _lv_disp_refr_timer
- >> lv_draw_sw_layer_destroy
- >> lv_gradient_set_cache_size
- >> lv_gradient_cleanup
- >> lv_img_decoder_close
- >> lv_img_decoder_built_in_open
- >> lv_img_decoder_built_in_close
- >> lv_fs_close
- >> lv_img_decoder_open
- >> lv_img_set_src
- >> lv_btnmatrix_set_map
- >> lv_chart_destructor
- >> lv_dropdown_set_options
- >> lv_keyboard_update_ctrl_map
- >> lv_menu_page_destructor
- >> lv_menu_back_event_cb
- >> lv_tabview_destructor
- >> anim_timer
- >> lv_timer_del
- >> lv_btnmatrix_destructor
- >> lv_checkbox_destructor
- >> lv_img_destructor
- >> lv_label_set_text_static
- >> lv_dropdown_set_options_static
- >> lv_dropdown_destructor
- >> lv_label_dot_tmp_free
- >> lv_label_destructor
- >> lv_textarea_destructor
- >> lv_table_destructor

lv_mem_init (Thumb, 24 bytes, Stack size 8 bytes, lv_mem.o(.text.lv_mem_init))

[Stack]

- Max Depth = 60
- Call Chain = lv_mem_init ⇒ lv_tlsf_create_with_pool ⇒ lv_tlsf_add_pool ⇒ block_insert

[Calls]

- >> lv_tlsf_create_with_pool

[Called By]

- >> lv_init

lv_mem_monitor (Thumb, 80 bytes, Stack size 16 bytes, lv_mem.o(.text.lv_mem_monitor))

[Stack]

- Max Depth = 40
- Call Chain = lv_mem_monitor ⇒ lv_tlsf_walk_pool

[Calls]

- >> lv_memset
- >> lv_tlsf_walk_pool
- >> lv_tlsf_get_pool

[Called By]

- >> _lv_disp_refr_timer

lv_mem_realloc (Thumb, 56 bytes, Stack size 8 bytes, lv_mem.o(.text.lv_mem_realloc))

[Stack]

- Max Depth = 112
- Call Chain = lv_mem_realloc ⇒ lv_tlsf_realloc ⇒ lv_tlsf_free ⇒ block_merge_next ⇒ block_remove ⇒ remove_free_block

[Calls]

- >> lv_mem_free
- >> lv_mem_alloc
- >> lv_tlsf_realloc

[Called By]

- >> lv_obj_add_style
- >> lv_obj_add_event_cb
- >> lv_mem_buf_get
- >> lv_obj_set_parent
- >> lv_obj_remove_style
- >> lv_obj_class_create_obj
- >> lv_layout_register
- >> get_trans_style
- >> get_local_style
- >> obj_del_core
- >> lv_label_set_text
- >> lv_style_register_prop
- >> lv_textarea_del_char
- >> lv_textarea_add_text
- >> lv_textarea_add_char
- >> lv_textarea_set_text
- >> lv_style_set_prop_internal
- >> lv_label_ins_text
- >> lv_table_constructor

lv_memcpy (Thumb, 292 bytes, Stack size 20 bytes, lv_mem.o(.text.lv_memcpy))

[Stack]

- Max Depth = 20
- Call Chain = lv_memcpy

[Called By]

- >> lv_anim_start
- >> lv_obj_init_draw_rect_dsc
- >> lv_draw_sw_rect
- >> lv_draw_sw_img_decoded
- >> lv_draw_sw_buffer_copy
- >> lv_draw_sw_blend_basic
- >> kill_oldest_item
- >> shadow_blur_corner
- >> lv_fs_read
- >> find_track_end
- >> lv_chart_event
- >> lv_btnmatrix_set_ctrl_map
- >> lv_keyboard_update_ctrl_map
- >> lv_meter_event
- >> lv_tlsf_realloc
- >> lv_btnmatrix_event
- >> lv_label_refr_text
- >> lv_slider_event
- >> pwd_char_hider
- >> lv_textarea_event
- >> lv_table_event

lv_memset (Thumb, 78 bytes, Stack size 0 bytes, lv_mem.o(.text.lv_memset))

[Called By]

- >> lv_mem_monitor
- >> lv_draw_sw_rect
- >> draw_bg

lv_memset_00 (Thumb, 76 bytes, Stack size 16 bytes, lv_mem.o(.text.lv_memset_00))

[Stack]

- Max Depth = 20
- Call Chain = lv_memset_00 ⇒ __aeabi_memclr4

[Calls]

- >> __aeabi_memclr4

[Called By]

- >> lv_disp_drv_register
- >> lv_disp_drv_init
- >> lv_disp_draw_buf_init
- >> lv_style_init
- >> lv_obj_add_style
- >> lv_anim_init
- >> lv_indev_drv_register
- >> lv_indev_drv_init
- >> lv_obj_allocate_spec_attr
- >> _lv_indev_read
- >> lv_obj_draw_dsc_init
- >> lv_obj_class_create_obj
- >> lv_draw_rect_dsc_init
- >> lv_draw_mask_radius_init
- >> lv_obj_set_state
- >> lv_style_reset
- >> get_trans_style
- >> get_local_style
- >> lv_img_decoder_get_info
- >> lv_draw_layer_create
- >> lv_draw_img_dsc_init
- >> _lv_draw_mask_cleanup
- >> _lv_disp_refr_timer
- >> lv_draw_sw_rect
- >> lv_draw_sw_line
- >> lv_draw_sw_letter
- >> lv_draw_sw_layer_create
- >> lv_draw_sw_layer_adjust
- >> lv_draw_sw_init_ctx
- >> lv_draw_sw_img_decoded
- >> lv_gradient_set_cache_size
- >> kill_oldest_item
- >> lv_draw_mask_line_points_init
- >> lv_draw_label_dsc_init
- >> draw_border_generic
- >> lv_draw_line_dsc_init
- >> _lv_img_cache_open
- >> lv_draw_arc_dsc_init
- >> lv_draw_mask_radius
- >> lv_draw_mask_line
- >> lv_draw_mask_angle
- >> lv_img_decoder_create
- >> lv_img_decoder_built_in_open
- >> lv_fs_open
- >> lv_img_decoder_open
- >> grid_update
- >> lv_style_transition_dsc_init
- >> lv_btnmatrix_set_map
- >> lv_calendar_constructor
- >> lv_spinbox_updatevalue

lv_memset_ff (Thumb, 80 bytes, Stack size 16 bytes, lv_mem.o(.text.lv_memset_ff))

[Stack]

- Max Depth = 16 + Unknown Stack Size
- Call Chain = lv_memset_ff

[Calls]

- >> __aeabi_memset4

[Called By]

- >> lv_draw_sw_transform
- >> lv_draw_sw_rect
- >> lv_draw_sw_line
- >> lv_draw_sw_img_decoded
- >> draw_border_generic

lv_menu_back_btn_is_root (Thumb, 28 bytes, Stack size 0 bytes, lv_menu.o(.text.lv_menu_back_btn_is_root))

[Called By]

- >> lv_menu_back_event_cb

lv_menu_clear_history (Thumb, 18 bytes, Stack size 8 bytes, lv_menu.o(.text.lv_menu_clear_history))

[Stack]

- Max Depth = 96
- Call Chain = lv_menu_clear_history ⇒ _lv_ll_clear ⇒ lv_mem_free ⇒ lv_tlsf_free ⇒ block_merge_next ⇒ block_remove ⇒ remove_free_block

[Calls]

- >> _lv_ll_clear

[Called By]

- >> lv_menu_set_page

lv_menu_set_page (Thumb, 220 bytes, Stack size 16 bytes, lv_menu.o(.text.lv_menu_set_page))

[Stack]

- Max Depth = 504
- Call Chain = lv_menu_set_page ⇒ lv_menu_refr_main_header_mode ⇒ lv_obj_update_layout ⇒ layout_update_core ⇒ layout_update_core (Cycle)

[Calls]

- >> lv_event_send
- >> lv_obj_set_parent
- >> lv_obj_clear_state
- >> lv_obj_clear_flag
- >> lv_obj_add_flag
- >> _lv_ll_ins_head
- >> lv_obj_add_state
- >> lv_menu_clear_history
- >> lv_menu_refr_main_header_mode

[Called By]

- >> lv_menu_back_event_cb

lv_obj_add_event_cb (Thumb, 136 bytes, Stack size 24 bytes, lv_event.o(.text.lv_obj_add_event_cb))

[Stack]

- Max Depth = 136
- Call Chain = lv_obj_add_event_cb ⇒ lv_mem_realloc ⇒ lv_tlsf_realloc ⇒ lv_tlsf_free ⇒ block_merge_next ⇒ block_remove ⇒ remove_free_block

[Calls]

- >> lv_obj_allocate_spec_attr
- >> lv_mem_realloc

[Called By]

- >> lv_example_roller_3
- >> lv_calendar_constructor
- >> lv_keyboard_constructor
- >> lv_menu_constructor
- >> lv_tabview_constructor
- >> lv_tileview_constructor
- >> lv_textarea_constructor

[Address Reference Count : 2]

- lv_calendar_header_dropdown.o(.text.my_constructor)
- lv_calendar_header_arrow.o(.text.my_constructor)

lv_obj_add_flag (Thumb, 142 bytes, Stack size 40 bytes, lv_obj.o(.text.lv_obj_add_flag))

[Stack]

- Max Depth = 272
- Call Chain = lv_obj_add_flag ⇒ lv_obj_get_scrollbar_area ⇒ lv_obj_get_scroll_left ⇒ lv_obj_get_self_width ⇒ lv_event_send ⇒ event_send_core ⇒ event_send_core (Cycle)

[Calls]

- >> lv_obj_invalidate
- >> lv_obj_get_parent
- >> lv_group_get_focused
- >> lv_group_focus_next
- >> lv_obj_mark_layout_as_dirty
- >> lv_obj_is_layout_positioned
- >> lv_obj_invalidate_area
- >> lv_obj_get_scrollbar_area

[Called By]

- >> lv_btnmatrix_set_btn_ctrl
- >> lv_calendar_constructor
- >> lv_colorwheel_constructor
- >> lv_menu_set_page
- >> lv_menu_value_changed_event_cb
- >> lv_menu_refr_main_header_mode
- >> lv_menu_page_constructor
- >> lv_tabview_constructor
- >> lv_tileview_constructor
- >> lv_btn_constructor
- >> lv_arc_constructor
- >> lv_img_constructor
- >> lv_dropdown_close
- >> lv_dropdownlist_constructor
- >> lv_dropdown_constructor
- >> lv_switch_constructor
- >> lv_textarea_event
- >> lv_textarea_constructor

[Address Reference Count : 2]

- lv_menu.o(.text.lv_menu_constructor)
- lv_checkbox.o(.text.lv_checkbox_constructor)

lv_obj_add_state (Thumb, 14 bytes, Stack size 0 bytes, lv_obj.o(.text.lv_obj_add_state))

[Stack]

- Max Depth = 328
- Call Chain = lv_obj_add_state ⇒ lv_obj_set_state ⇒ _lv_obj_style_create_transition ⇒ lv_style_set_prop ⇒ lv_style_set_prop_internal ⇒ lv_mem_realloc ⇒ lv_tlsf_realloc ⇒ lv_tlsf_free ⇒ block_merge_next ⇒ block_remove ⇒ remove_free_block

[Calls]

- >> lv_obj_set_state

[Called By]

- >> lv_obj_event
- >> lv_menu_set_page
- >> lv_dropdown_open

lv_obj_add_style (Thumb, 166 bytes, Stack size 32 bytes, lv_obj_style.o(.text.lv_obj_add_style))

[Stack]

- Max Depth = 256
- Call Chain = lv_obj_add_style ⇒ lv_obj_refresh_style ⇒ lv_obj_refresh_ext_draw_size ⇒ lv_obj_invalidate ⇒ lv_obj_invalidate_area ⇒ _lv_inv_area ⇒ _lv_area_is_in ⇒ _lv_area_is_point_on ⇒ _lv_area_is_point_on (Cycle)

[Calls]

- >> lv_mem_realloc
- >> lv_obj_refresh_style
- >> lv_memset_00
- >> trans_del

[Called By]

- >> lv_example_roller_3
- >> theme_apply

[Address Reference Count : 1]

- lv_theme_default.o(.text.theme_apply)

lv_obj_align (Thumb, 28 bytes, Stack size 16 bytes, lv_obj_pos.o(.text.lv_obj_align))

[Stack]

- Max Depth = 304
- Call Chain = lv_obj_align ⇒ lv_obj_set_pos ⇒ lv_obj_set_y ⇒ lv_obj_set_style_y ⇒ lv_obj_set_local_style_prop ⇒ lv_obj_refresh_style ⇒ lv_obj_refresh_ext_draw_size ⇒ lv_obj_invalidate ⇒ lv_obj_invalidate_area ⇒ _lv_inv_area ⇒ _lv_area_is_in ⇒ _lv_area_is_point_on ⇒ _lv_area_is_point_on (Cycle)

[Calls]

- >> lv_obj_set_pos
- >> lv_obj_set_style_align

[Called By]

- >> lv_example_roller_3
- >> _lv_disp_refr_timer
- >> lv_keyboard_constructor
- >> lv_dropdown_open

lv_obj_align_to (Thumb, 870 bytes, Stack size 64 bytes, lv_obj_pos.o(.text.lv_obj_align_to))

[Stack]

- Max Depth = 536
- Call Chain = lv_obj_align_to ⇒ lv_obj_update_layout ⇒ layout_update_core ⇒ layout_update_core (Cycle)

[Calls]

- >> lv_obj_set_pos
- >> lv_obj_get_parent
- >> lv_obj_get_scroll_top
- >> lv_obj_get_scroll_right
- >> lv_obj_get_scroll_left
- >> lv_obj_update_layout
- >> lv_obj_set_style_align
- >> lv_obj_get_content_width
- >> lv_obj_get_content_height
- >> lv_obj_get_style_pad_top
- >> lv_obj_get_style_pad_left
- >> lv_obj_get_style_border_width
- >> lv_obj_get_style_base_dir

[Called By]

- >> lv_dropdown_open

lv_obj_allocate_spec_attr (Thumb, 64 bytes, Stack size 8 bytes, lv_obj.o(.text.lv_obj_allocate_spec_attr))

[Stack]

- Max Depth = 80
- Call Chain = lv_obj_allocate_spec_attr ⇒ lv_mem_alloc ⇒ lv_tlsf_malloc ⇒ block_prepare_used ⇒ block_split ⇒ block_mark_as_free ⇒ block_link_next

[Calls]

- >> lv_memset_00
- >> lv_mem_alloc

[Called By]
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
