Aiano/DigitalPowerSupply/(list of files, drawings)

Other design files:
Hardware/DigitalBuckBoost/AuxiliaryPowerSupply.SchDoc
Hardware/DigitalBuckBoost/DigitalBuckBoost.PcbLib
Hardware/DigitalBuckBoost/DigitalBuckBoost.PrjPcb
Hardware/DigitalBuckBoost/DigitalBuckBoost.SchLib
Hardware/DigitalBuckBoost/MainPowerCircuit.SchDoc
Hardware/DigitalBuckBoost/MCU.SchDoc
Hardware/DigitalBuckBoost/SignalConditioning.SchDoc
Hardware/DigitalBuckBoost/STLink-V2-1.SchDoc
Hardware/Display/Display.PcbLib
Hardware/Display/Display.PrjPcb
Hardware/Display/Display.SchDoc
Hardware/Display/Display.SchLib
