Aiano/DigitalPowerSupply/Firmware/Display/Core/Src/main.c

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
/* Includes ------------------------------------------------------------------*/
#include "main.h"
#include "adc.h"
#include "dma.h"
#include "i2c.h"
#include "usart.h"
#include "spi.h"
#include "tim.h"
#include "gpio.h"

/* USER CODE BEGIN Includes */
#include "st7789.h"
#include "gt911.h"
//#include "usbd_cdc_if.h"
#include <stdio.h>
#include <string.h>
#include "lvgl.h"
#include "lv_port_disp.h"
#include "lv_port_indev.h"
#include "gui.h"
/* USER CODE END Includes */


/* USER CODE BEGIN PV */
static uint8_t txBuffer[100];
// uint8_t flagTouch = 0;
// uint16_t touchPoint[2]; // {x,y}
// uint8_t touchPointNum;
uint8_t flagLVGLTimerHandler;
uint16_t LVGLTimerHandlerCount;
/* USER CODE END PV */

void SystemClock_Config(void);
/* USER CODE BEGIN PFP */
void disp_clear();
/* USER CODE END PFP */

/**
  * @brief  The application entry point.
  * @retval int
  */
int main(void)
{
  /* MCU Configuration--------------------------------------------------------*/

  /* Reset of all peripherals, Initializes the Flash interface and the Systick. */
  HAL_Init();

  /* Configure the system clock */
  SystemClock_Config();

  /* Initialize all configured peripherals */
  MX_GPIO_Init();
  MX_DMA_Init();
  MX_SPI1_Init();
  MX_ADC1_Init();
  MX_I2C3_Init();
  MX_LPUART1_UART_Init();
  MX_TIM6_Init();
  /* USER CODE BEGIN 2 */
	//sprintf((char *)txBuffer, "Init: ST7789\n");
	//CDC_Transmit_FS(txBuffer, strlen((char *)txBuffer));
	ST7789_Init();
	//HAL_GPIO_TogglePin(LED_GPIO_Port, LED_Pin);
	
	//sprintf((char *)txBuffer, "Init: GT911\n");
	//CDC_Transmit_FS(txBuffer, strlen((char *)txBuffer));
	GTP_Init();
	//HAL_GPIO_TogglePin(LED_GPIO_Port, LED_Pin);
	
	//disp_clear();
  lv_init();
  lv_port_disp_init();
  lv_port_indev_init();
  HAL_TIM_Base_Start_IT(&htim6);

  gui_init();
  
  /* USER CODE END 2 */

  /* Infinite loop */
  /* USER CODE BEGIN WHILE */
  while (1)
  {
		if(flagLVGLTimerHandler){
      flagLVGLTimerHandler = 0;
      lv_timer_handler();
    }
    /* USER CODE END WHILE */

    /* USER CODE BEGIN 3 */
  }
  /* USER CODE END 3 */
}

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
/* USER CODE BEGIN 4 */
void disp_clear()
{
	ST7789_Fill_Color(BLACK);
	ST7789_WriteString(130, 0, "Canvas",Font_11x18, WHITE, BLACK);
	ST7789_WriteString(110, 18, "1 Finger: Draw",Font_7x10, WHITE, BLACK);
	ST7789_WriteString(110, 28, "2 Finger: Clear",Font_7x10, WHITE, BLACK);
}

void HAL_TIM_PeriodElapsedCallback(TIM_HandleTypeDef *htim){
	static uint16_t cnt = 0;
	
  if(htim->Instance == TIM6){
    lv_tick_inc(1);
		
		if(cnt++ > 500){
			cnt = 0;
			HAL_GPIO_TogglePin(LED_GPIO_Port, LED_Pin);
		}
  }
}
/* USER CODE END 4 */
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
