Aiano/DigitalPowerSupply/Firmware/DigitalBuckBoost/DigitalBuckBoost.ioc

Mcu.UserName=STM32G474RETx
PA0.Signal=ADC1_IN1
PA1.Signal=ADC1_IN2
PA10.Signal=HRTIM1_CHB1
PA11.Signal=HRTIM1_CHB2
PA13.Signal=SYS_JTMS-SWDIO
PA14.Signal=SYS_JTCK-SWCLK
PA2.Signal=ADC1_IN3
PA3.Signal=ADC1_IN4
PA8.Signal=HRTIM1_CHA1
PA9.Signal=HRTIM1_CHA2
PC10.Signal=UART4_TX
PC11.Signal=UART4_RX
PC12.GPIO_Label=LED_PROTECTION
PC12.Signal=GPIO_Output
PC13.GPIO_Label=LED_OUTPUT
PC13.Signal=GPIO_Output
PC4.Signal=USART1_TX
PC5.Signal=USART1_RX
PF0-OSC_IN.Signal=RCC_OSC_IN
PF1-OSC_OUT.Signal=RCC_OSC_OUT
