Aiano/DigitalPowerSupply/Firmware/Display/Core/Inc/main.h

#define LED_Pin GPIO_PIN_13
#define LED_GPIO_Port GPIOC
#define ST7789_RST_Pin GPIO_PIN_4
#define ST7789_RST_GPIO_Port GPIOA
#define ST7789_DC_Pin GPIO_PIN_6
#define ST7789_DC_GPIO_Port GPIOA
#define ST7789_BL_Pin GPIO_PIN_4
#define ST7789_BL_GPIO_Port GPIOC
#define GT911_INT_Pin GPIO_PIN_6
#define GT911_INT_GPIO_Port GPIOC
#define GT911_RES_Pin GPIO_PIN_7
#define GT911_RES_GPIO_Port GPIOC
