Aiano/DigitalPowerSupply/(commit log)

2024-09-10 Version 1.0
    [AuxiliaryPowerSupply.SchDoc, BOM_V1.0.xlsx, Coilcraft-SER2918H.step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]
2024-09-12 add PID
