Aiano/DigitalPowerSupply/(notices)

Notices in the files:
Firmware/Display/Core/Src/main.c:
Copyright (c) 2024 STMicroelectronics.
All rights reserved.
This software is licensed under terms that can be found in the LICENSE file
Hardware/Display/Model/PPTC1206.stp:
author */ ('License CC BY-ND 4.0'),
